Louis-VL/PCB-ADVANCED/Presentatie/Fotos Presentatie/Assemblage/IMG20240105115307.jpg

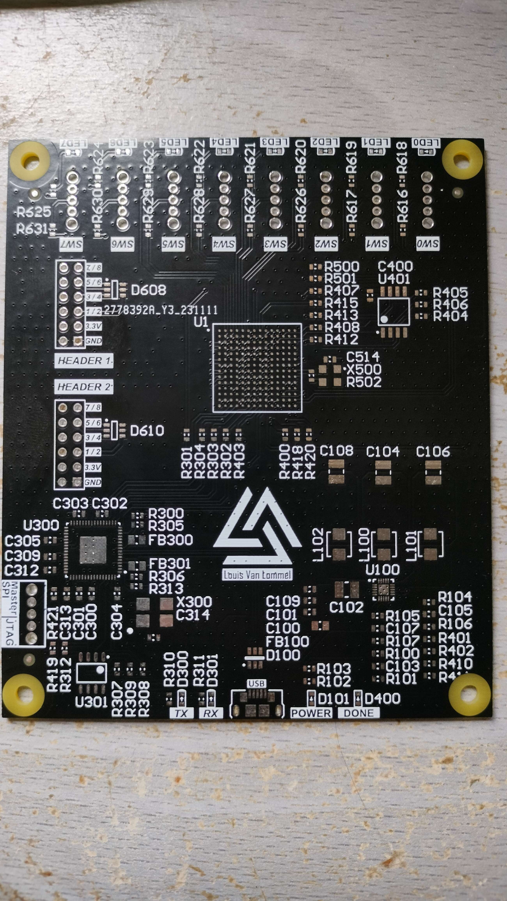
Presentatie/Fotos Presentatie/Assemblage/IMG20240105115307.jpg
