Louis-VL/PCB-ADVANCED/Presentatie/Fotos Presentatie/Assemblage/IMG20231213092017.jpg

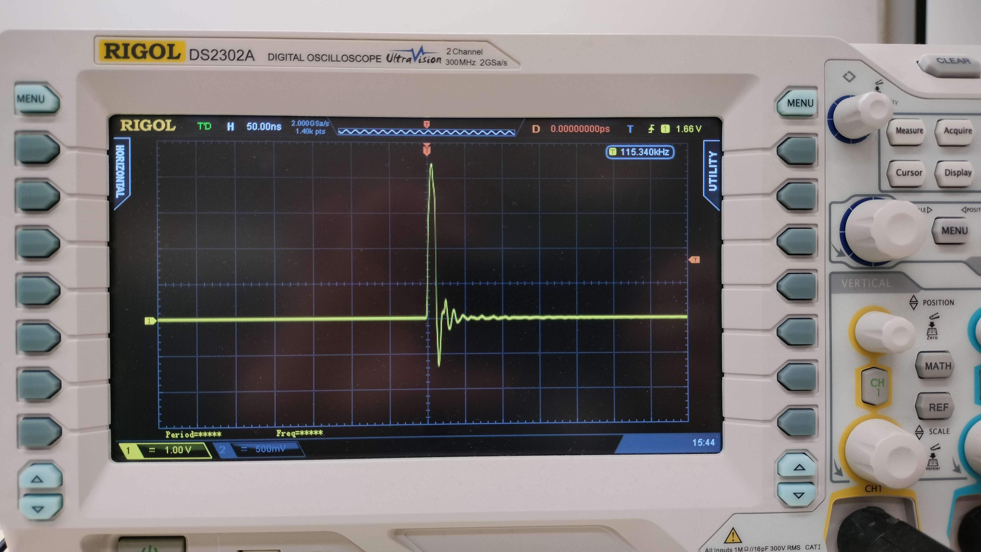
Presentatie/Fotos Presentatie/Assemblage/IMG20231213092017.jpg
