Louis-VL/PCB-ADVANCED/VIVADO/SpartanMicroBlaze/SpartanMicroBlaze.ip_user_files/README.txt

The files in this directory structure are automatically generated and managed by Vivado. Editing these files is not recommended.
