Louis-VL/PCB-ADVANCED/VIVADO/SpartanMicroBlaze/SpartanMicroBlaze.runs/impl_1/.init_design.begin.rst

<?xml version="1.0"?>
<ProcessHandle Version="1" Minor="0">
    <Process Command=".planAhead." Owner="louis" Host="LAPTOP-K67JHBA7" Pid="12540">
    </Process>
</ProcessHandle>
