Louis-VL/PCB-ADVANCED/VIVADO/SpartanTest/SpartanTest.runs/impl_1/.init_design.begin.rst

<?xml version="1.0"?>
<ProcessHandle Version="1" Minor="0">
    <Process Command=".planAhead." Owner="louis" Host="DESKTOP" Pid="4484">
    </Process>
</ProcessHandle>
