Louis-VL/PCB-ADVANCED/VIVADO/SpartanMicroBlaze/SpartanMicroBlaze.runs/MicroBlazeV2_axi_gpio_0_1_synth_1/.vivado.begin.rst

<?xml version="1.0"?>
<ProcessHandle Version="1" Minor="0">
    <Process Command="vivado.bat" Owner="louis" Host="LAPTOP-K67JHBA7" Pid="3984" HostCore="16" HostMemory="016556687360">
    </Process>
</ProcessHandle>
