Louis-VL/PCB-ADVANCED/VIVADO/SpartanMicroBlaze/SpartanMicroBlaze.runs/MicroBlazeV2_axi_gpio_1_0_synth_1/.vivado.begin.rst

<?xml version="1.0"?>
<ProcessHandle Version="1" Minor="0">
    <Process Command="vivado.bat" Owner="louis" Host="LAPTOP-K67JHBA7" Pid="7600" HostCore="16" HostMemory="016556687360">
    </Process>
</ProcessHandle>
