Louis-VL/PCB-ADVANCED/Presentatie/Presentatie1.pptx

## FPGA-development board

- Louis Van Lommel

PCB-Advanced 2023

## Slide 2

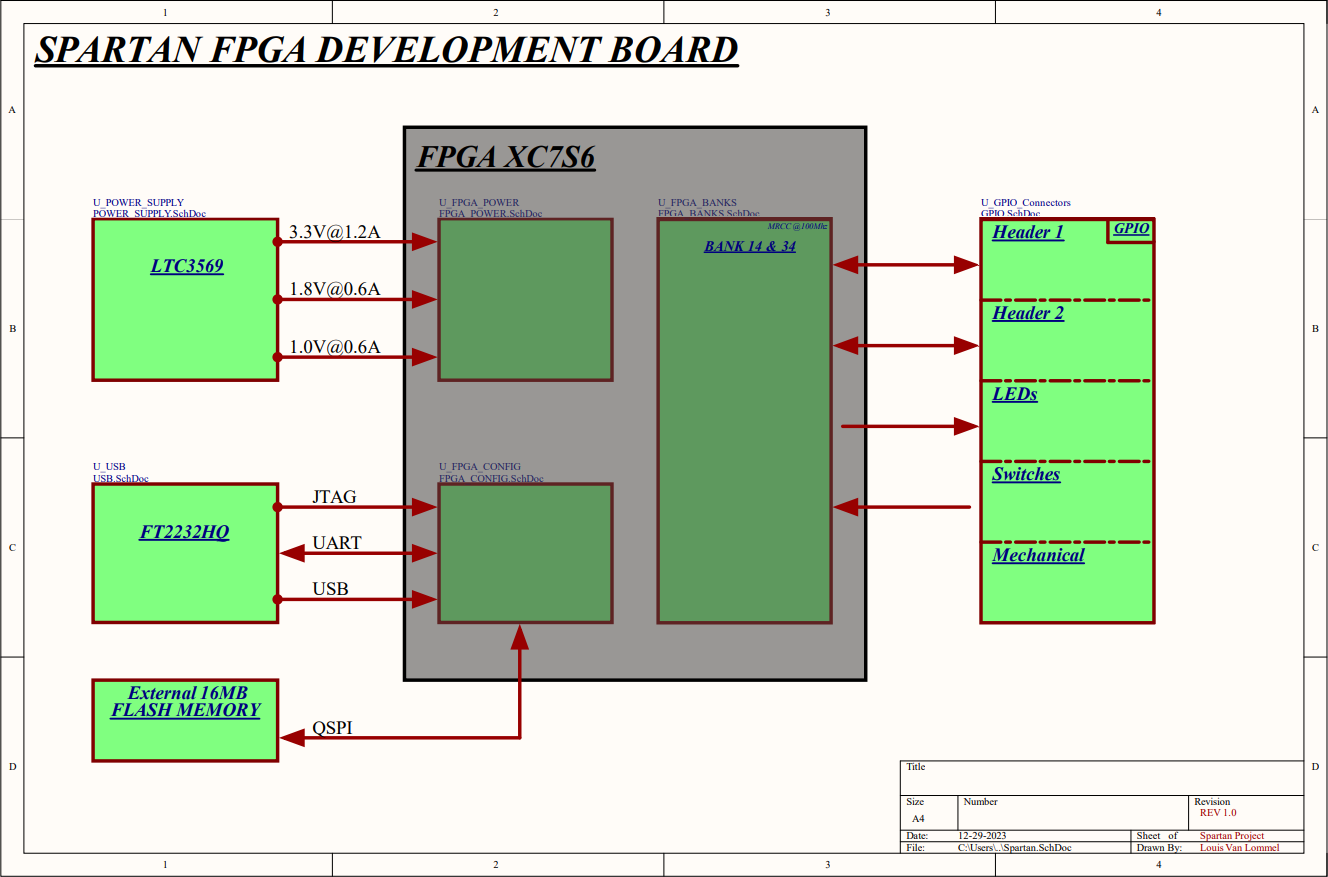
[picture p3: figure]

## Slide 3

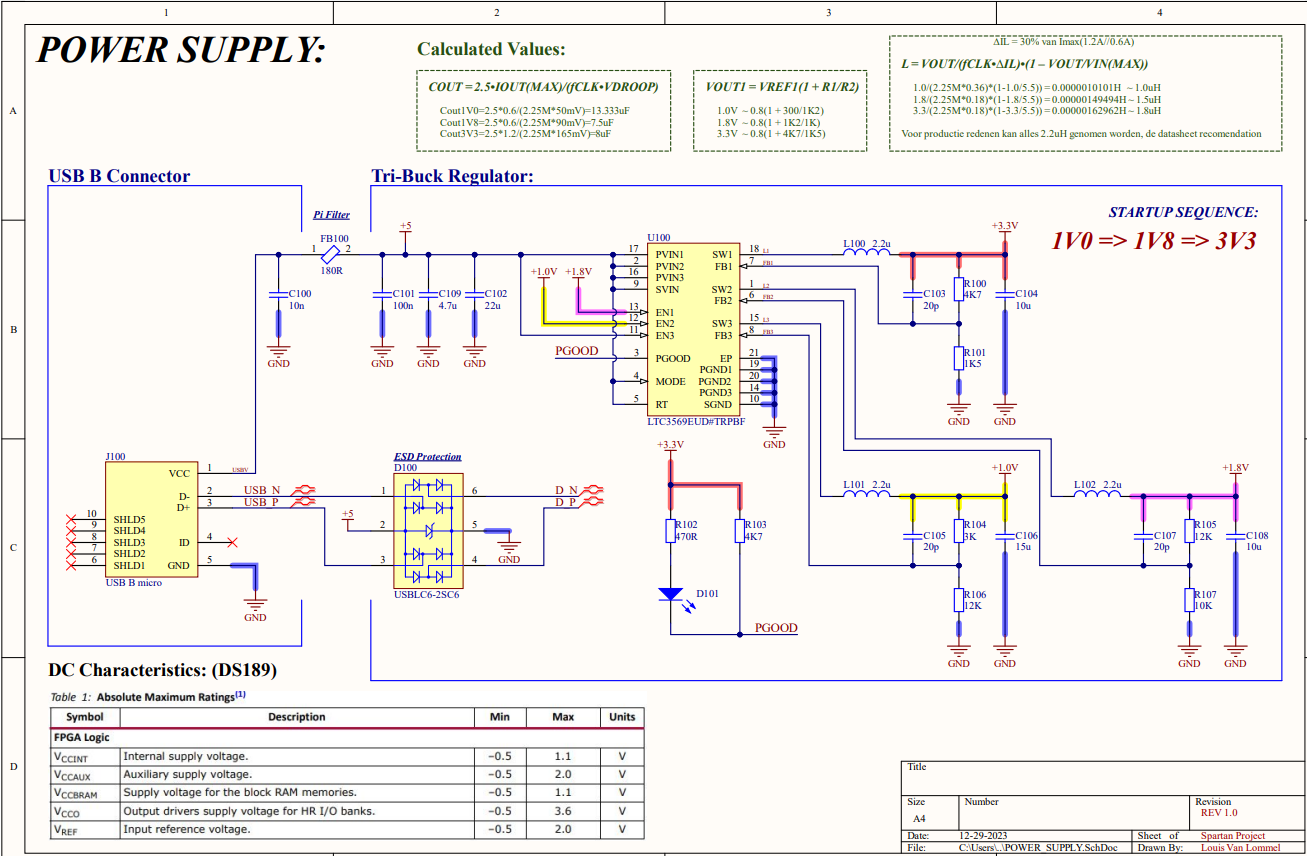
[picture p4: figure]

## Slide 4

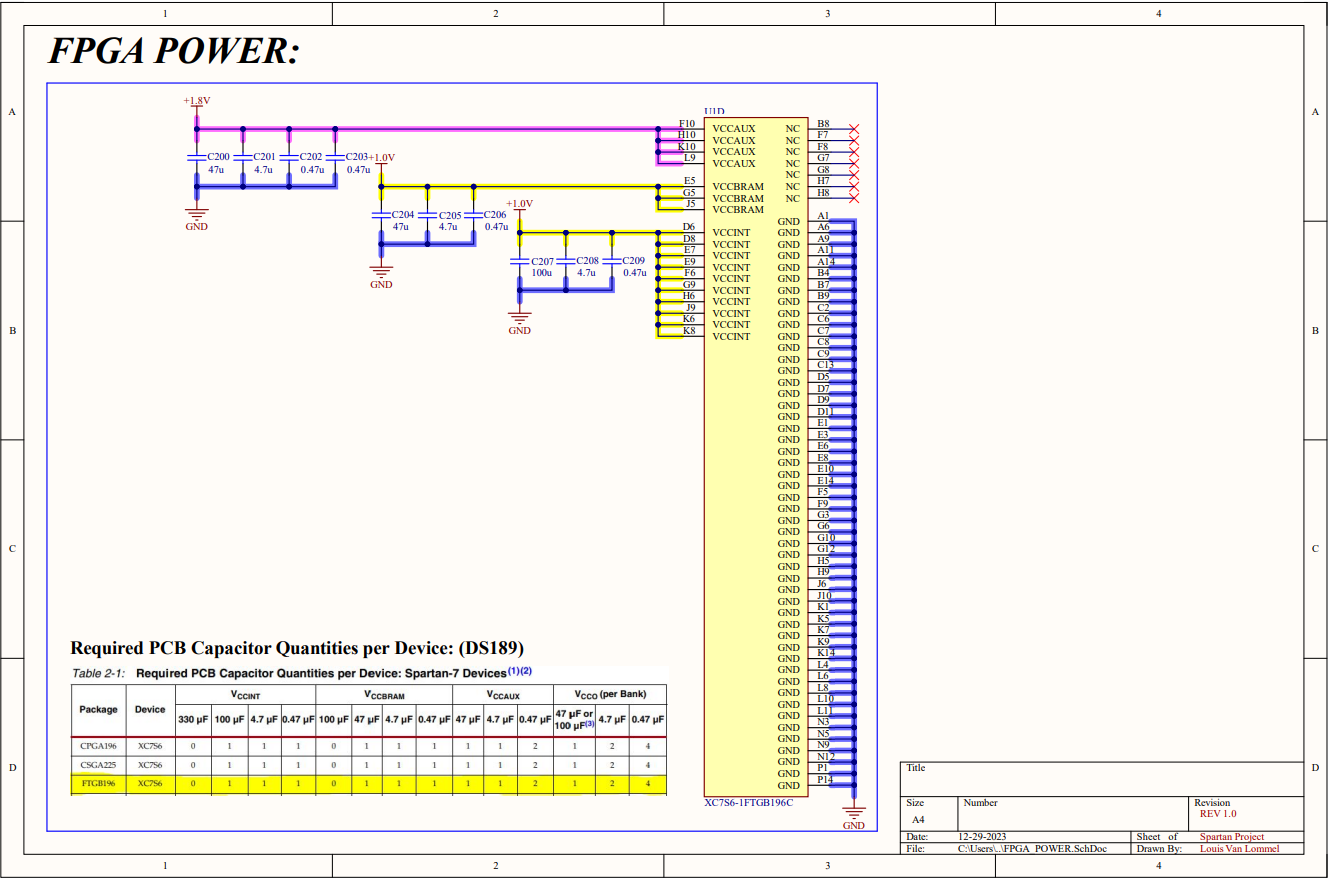
[picture p5: figure]

## Slide 5

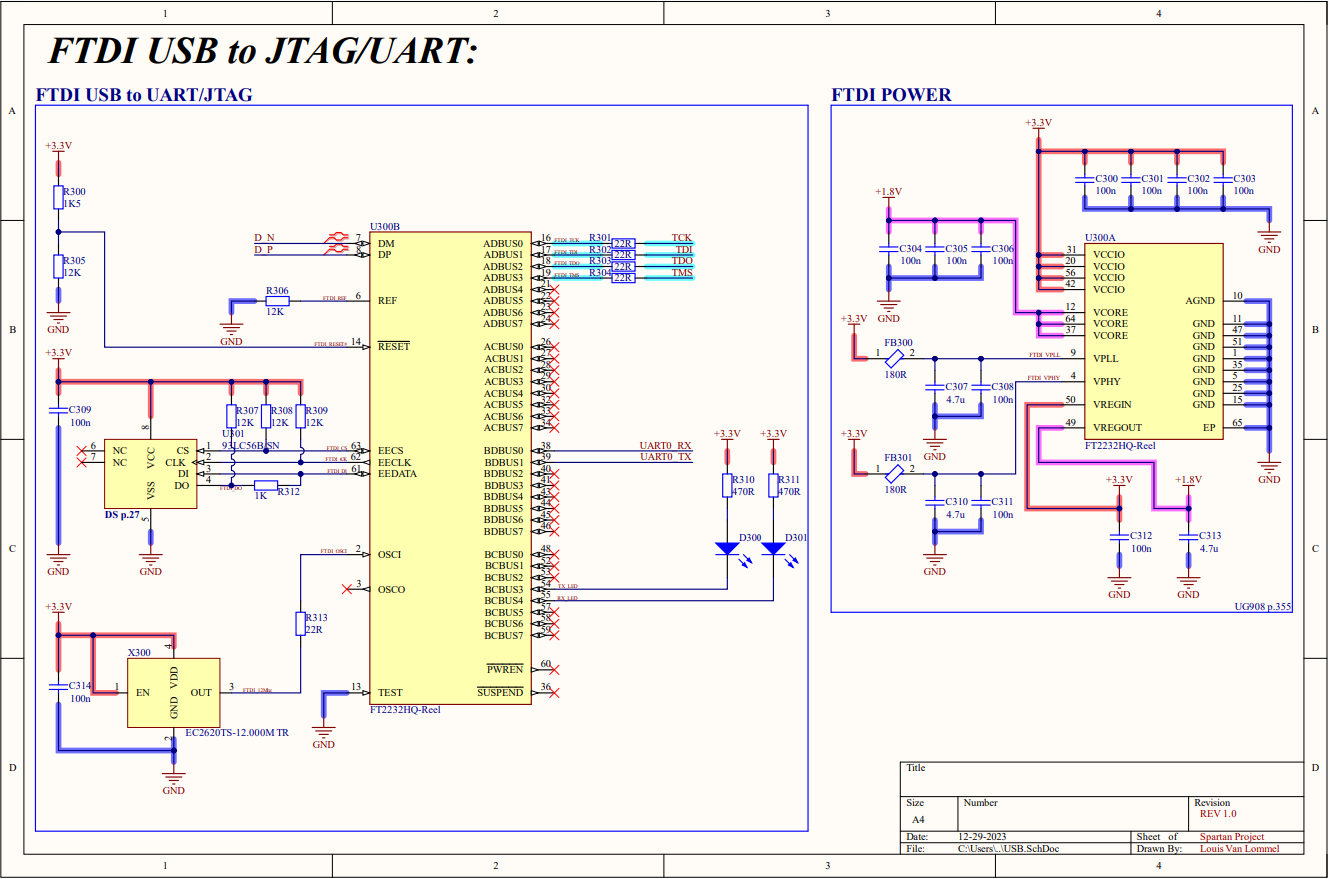
[picture p6: figure]

## Slide 6

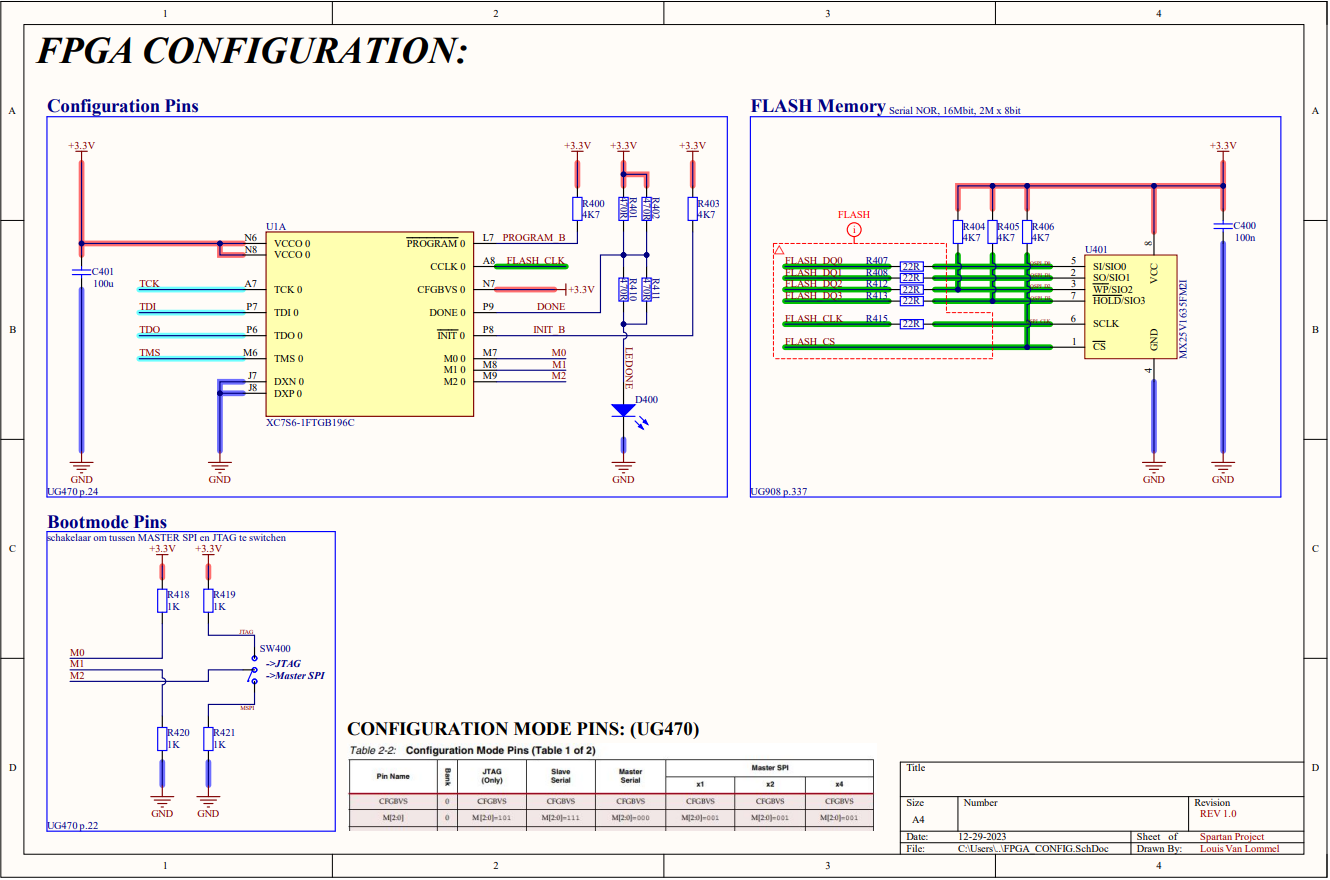
[picture p7: figure]

## Slide 7

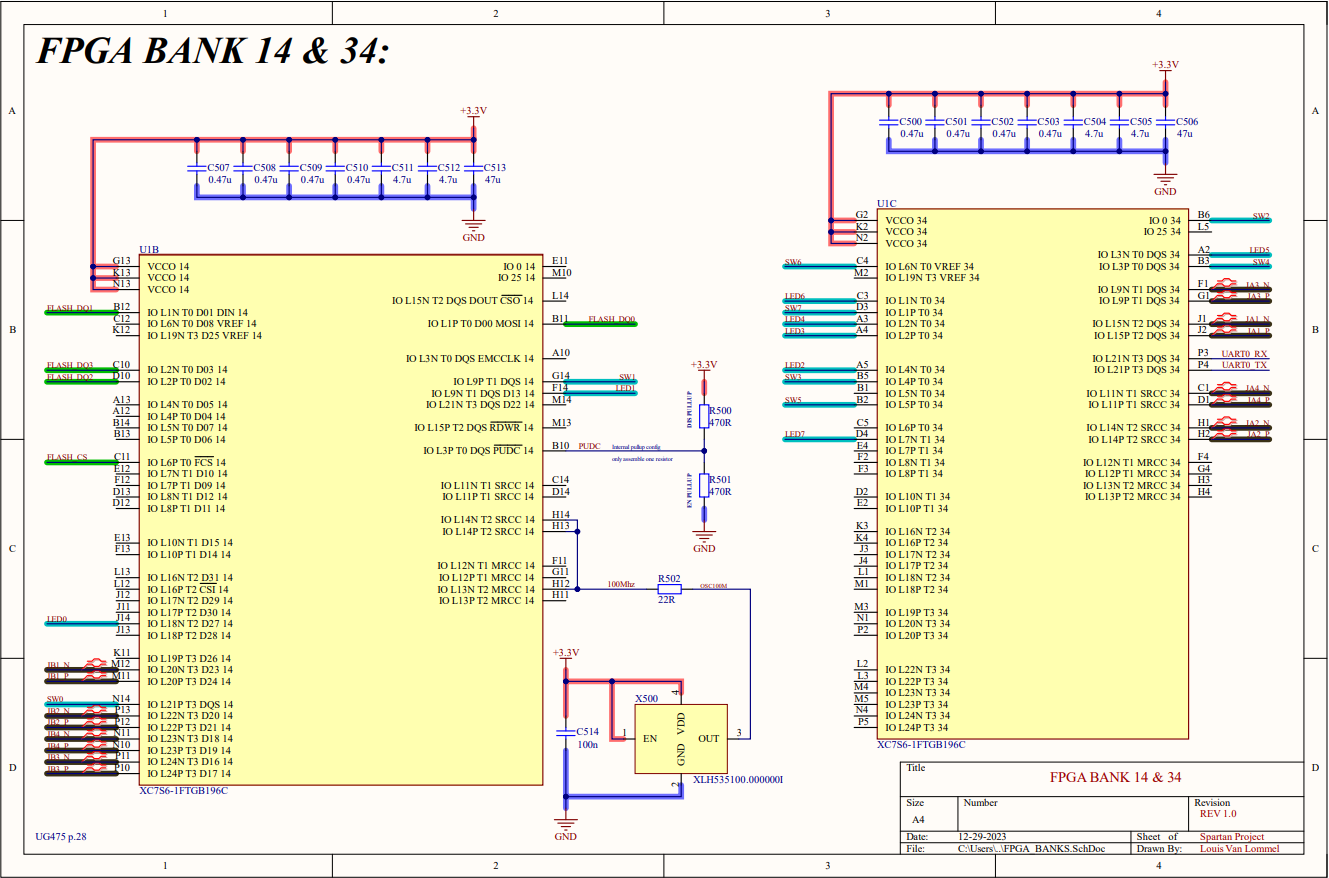
[picture p8: figure]

## Slide 8

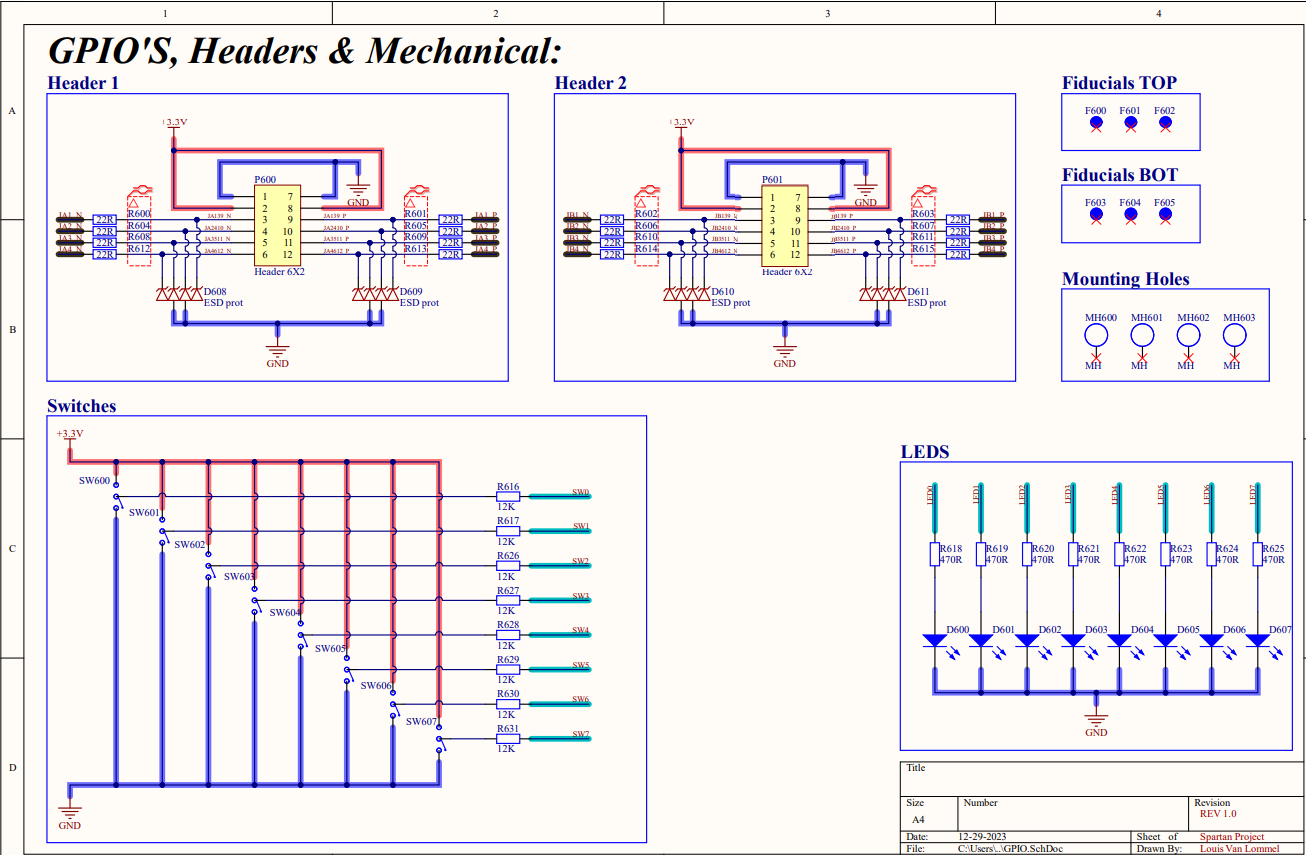
[picture p9: figure]

## PCB in Altium Designer

- 4 Layer PCB
  - L1 Signal + GND
  - L2 GND
  - L3 PWR
  - L4 Signal + GND
- BGA (1mm-pitch)
- Differential pairs
- Impedance routing
- Via Stitching

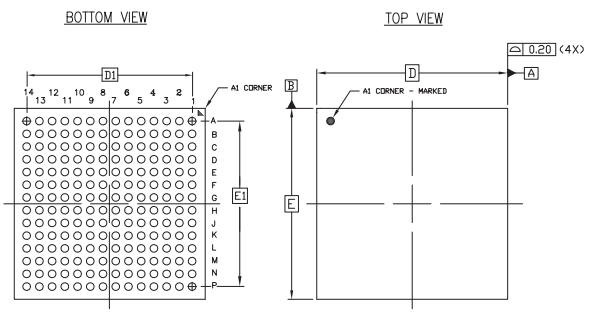
[picture p10: figure]

## Slide 10

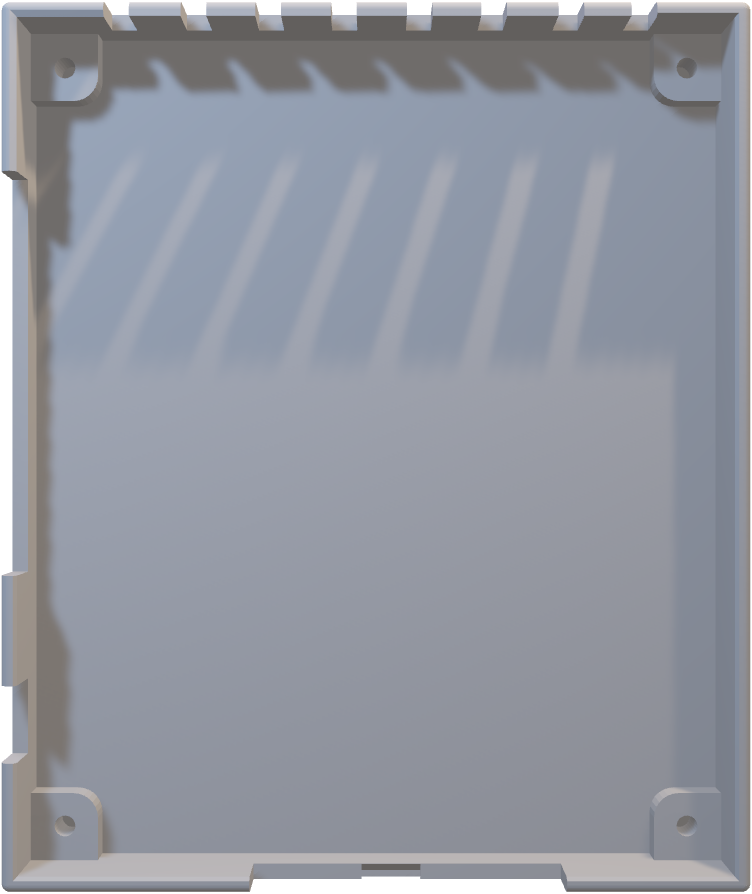
[picture p11: figure]
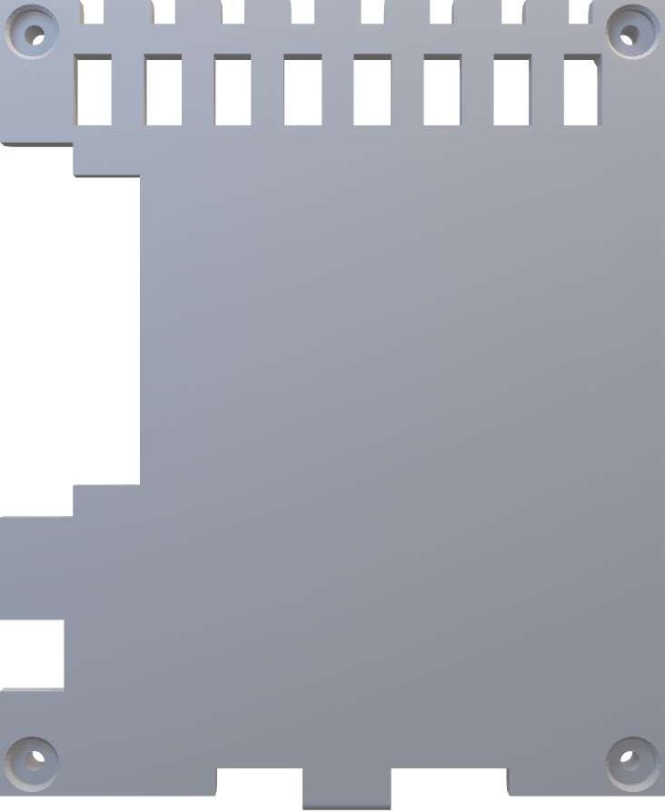
[picture p12: figure]

## Hardware fouten en oplossingen

- USB ESD-Protection:
- Probleem:
    - +5V en GND omgedraait.
- Huidige oplossing:
    - Component ondersteboven geplaatst.
- Permanente oplossing:
    - Schema en PCB verbeteren (V2.0).

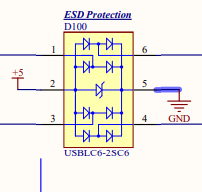
[picture p13: figure]

## Hardware fouten en oplossingen

- ESD-Protection:
- Probleem:
    - Pin 2 en 6 omgedraait
- Huidige oplossing:
    - Niet geplaatst
- Permanente oplossing:
    - Schema en PCB verbeteren (V2.0).

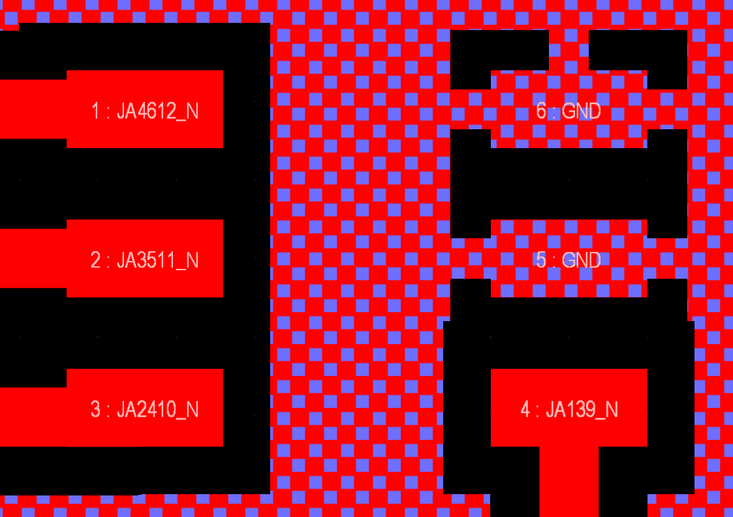
[picture p14: figure]

## Hardware fouten en oplossingen

- Enable 2 Tri-Buck:
- Probleem:
    - +1V te laag, minimaal +1,2V.
- Huidige oplossing:
    - EN2 aan +5V verbonden.
- Permanente oplossing:
    - Schema en PCB verbeteren (V2.0).

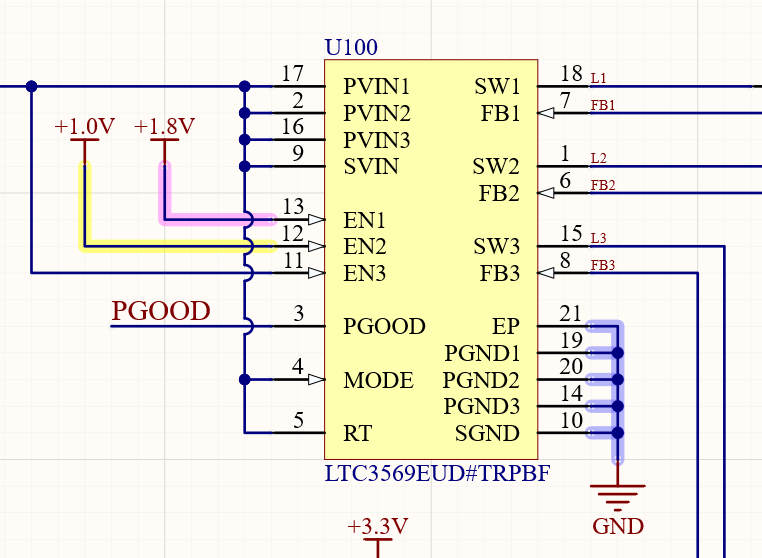
[picture p15: figure]
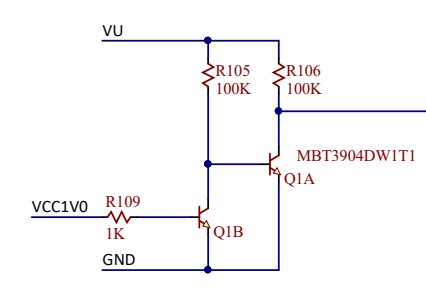
[picture p16: figure]

## Hardware fouten en oplossingen

- PGOOD Tri-Buck:
- Probleem:
    - Gaat enkel branden bij een fout.
- Huidige oplossing:
    - Niets, bij een fout gaat de led branden (nuttig).
- Permanente oplossing:
    - Schema en PCB verbeteren (V2.0).

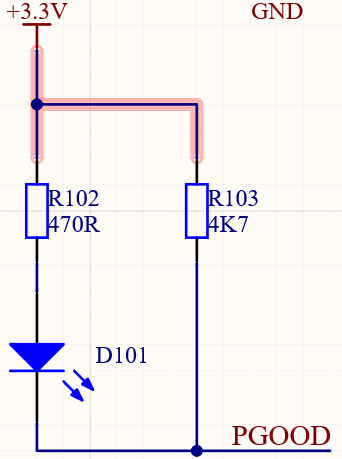
[picture p17: figure]
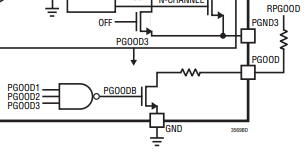
[picture p18: figure]
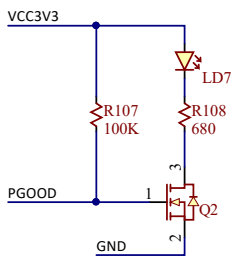
[picture p19: figure]

## Hardware fouten en oplossingen

- MRCC-Pin:
- Probleem:
    - L13_P niet verbonden.
- Huidige oplossing:
    - L14_P gebruikt (SRCC).
- Permanente oplossing:
    - Schema en PCB verbeteren (V2.0).

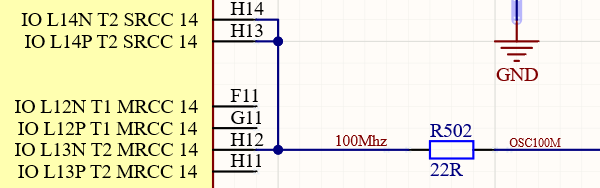
[picture p20: figure]
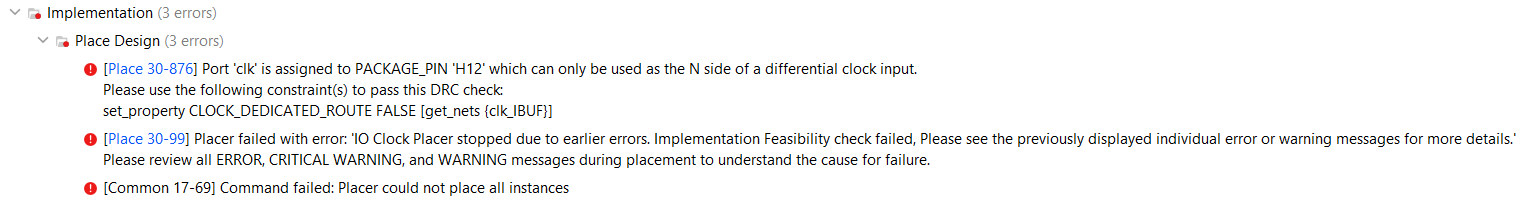
[picture p21: figure]

## Hardware fouten en oplossingen

- Switches:
- Probleem:
    - Switches sluiten kort tijdens het schakelen.
- Huidige oplossing:
    - Interne Pull-up, 3V3 aan de switches verwijdert.
- Permanente oplossing:
    - Betere switches.
    - Schema en PCB verbeteren (V2.0).

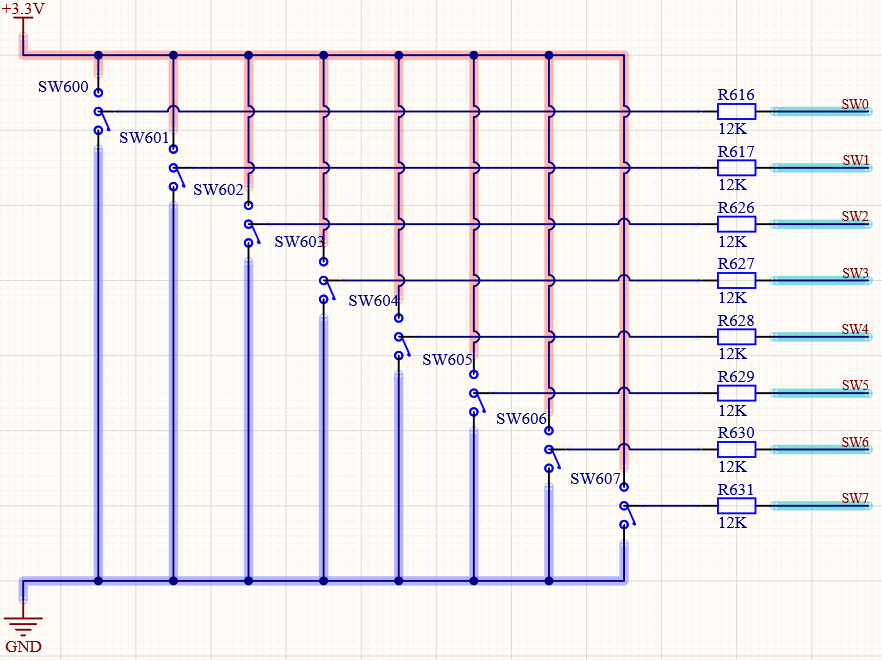
[picture p22: figure]
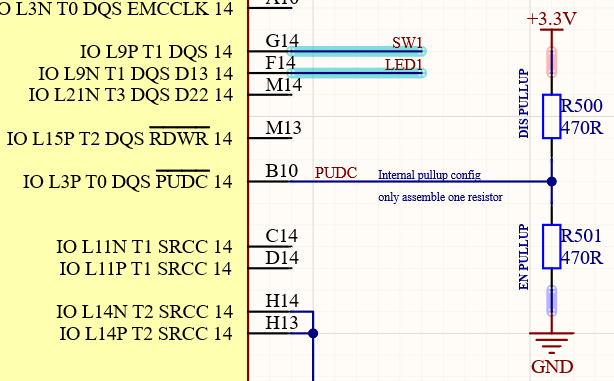
[picture p23: figure]

## Slide 17

## Slide 18

## Bedankt!

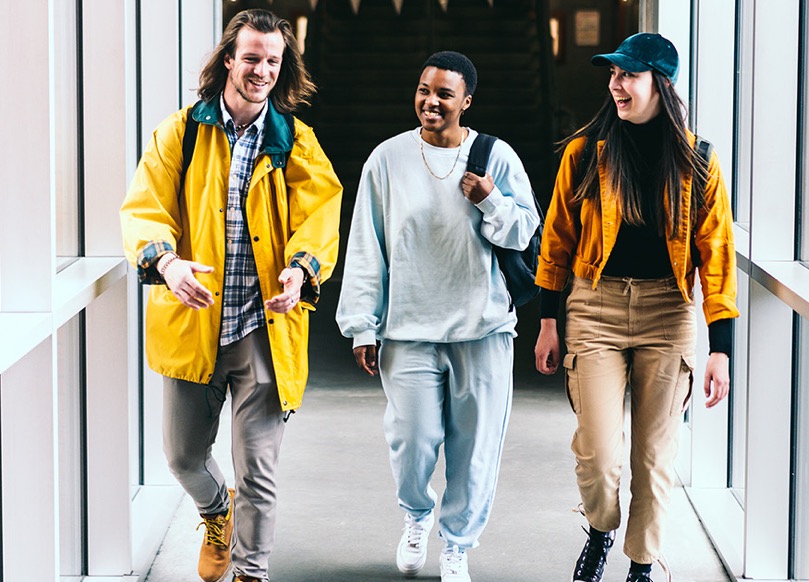
[picture p24: figure]

- Louis Van Lommel R0844517@student.thomasmore.be

Notes: Icoon wereldbol toevoegen
