Louis-VL/PCB-ADVANCED/KNIPS/BANK34_14.PNG

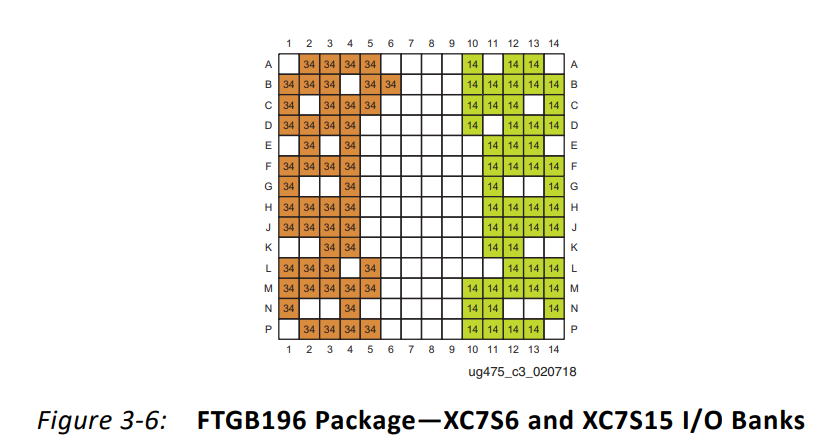
KNIPS/BANK34_14.PNG
