Louis-VL/PCB-ADVANCED/KNIPS/BOMcomponents.PNG

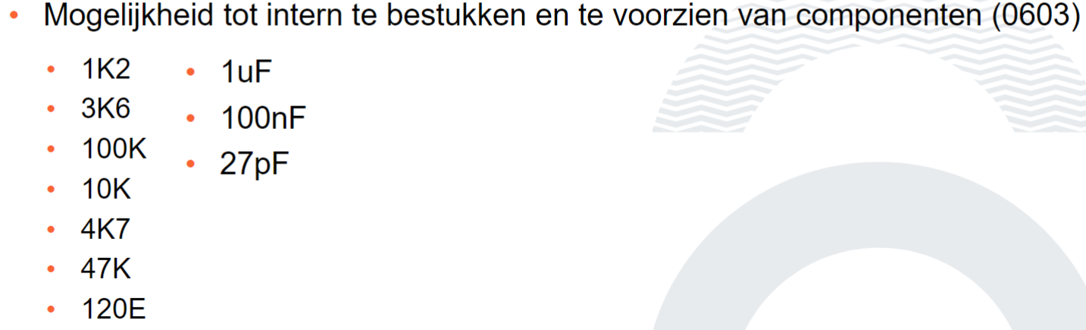
KNIPS/BOMcomponents.PNG
