Louis-VL/PCB-ADVANCED/KNIPS/Capture2.PNG

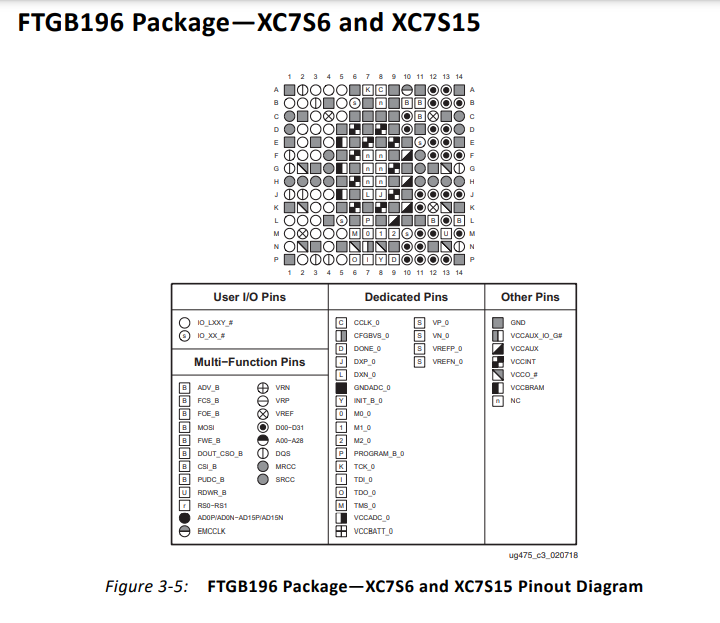
KNIPS/Capture2.PNG
