Louis-VL/PCB-ADVANCED/KNIPS/DC CHARS.PNG

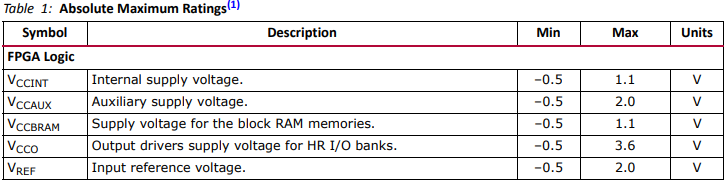
KNIPS/DC CHARS.PNG
