Louis-VL/PCB-ADVANCED/KNIPS/FLASH.PNG

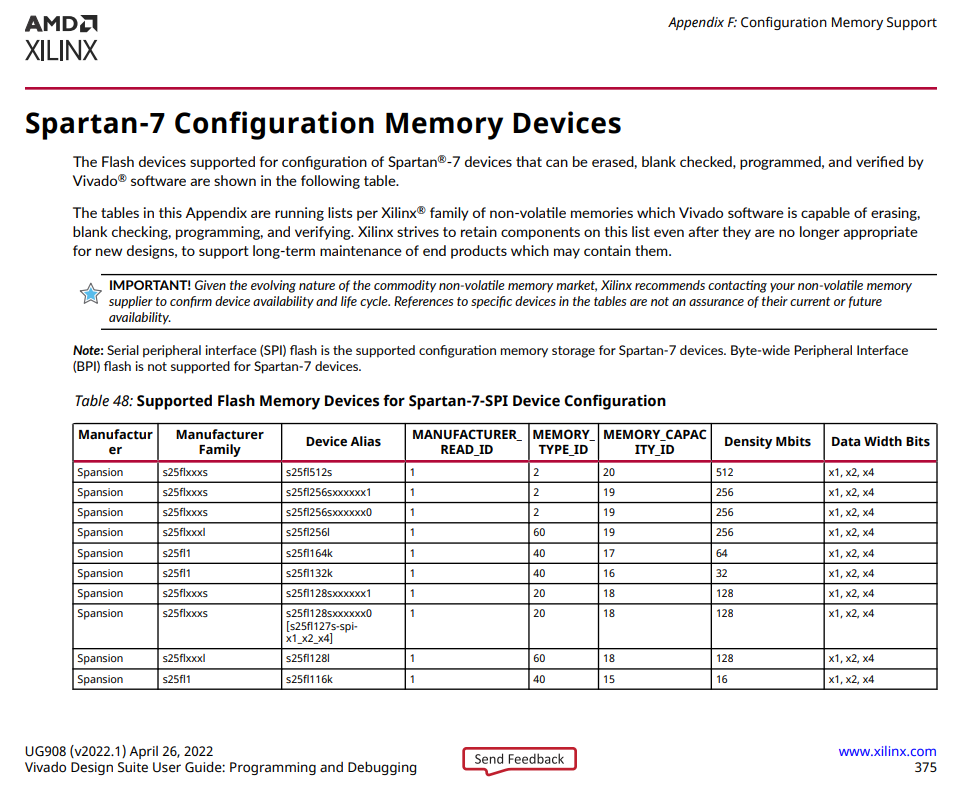
KNIPS/FLASH.PNG
