Louis-VL/PCB-ADVANCED/KNIPS/FOOTPRINT2.PNG

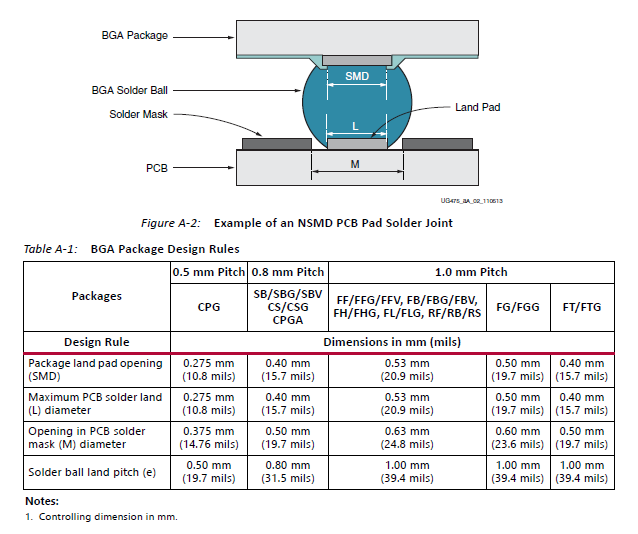
KNIPS/FOOTPRINT2.PNG
