Louis-VL/PCB-ADVANCED/KNIPS/Footprint.PNG

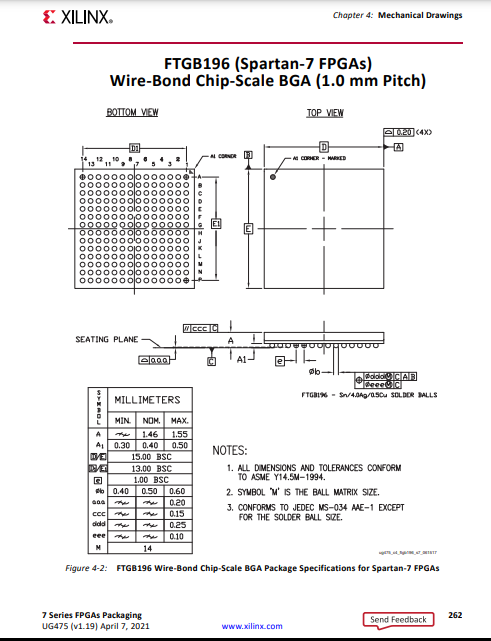
KNIPS/Footprint.PNG
