Louis-VL/PCB-ADVANCED/KNIPS/FT2232.PNG

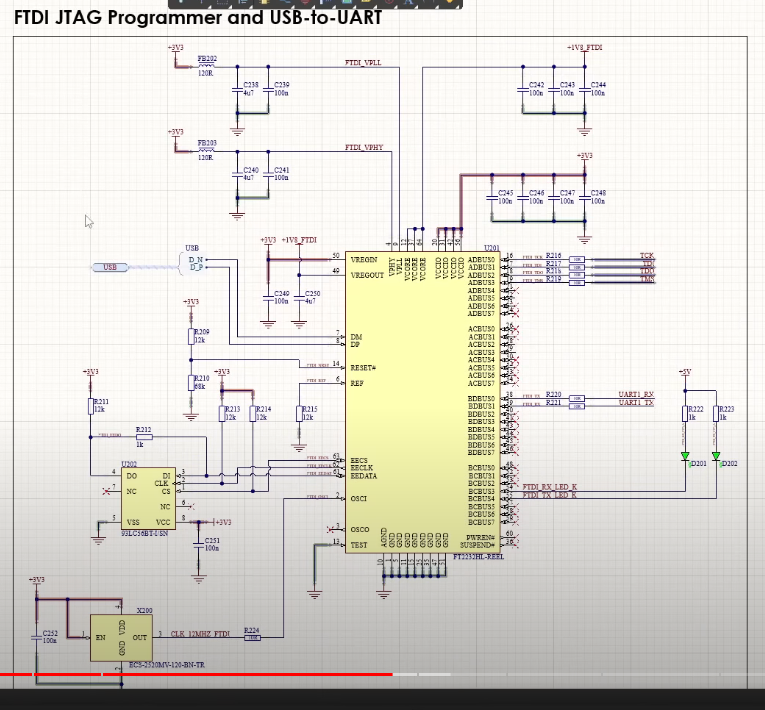
KNIPS/FT2232.PNG
