Louis-VL/PCB-ADVANCED/KNIPS/FTDIPROGRAMTERMINAL.png

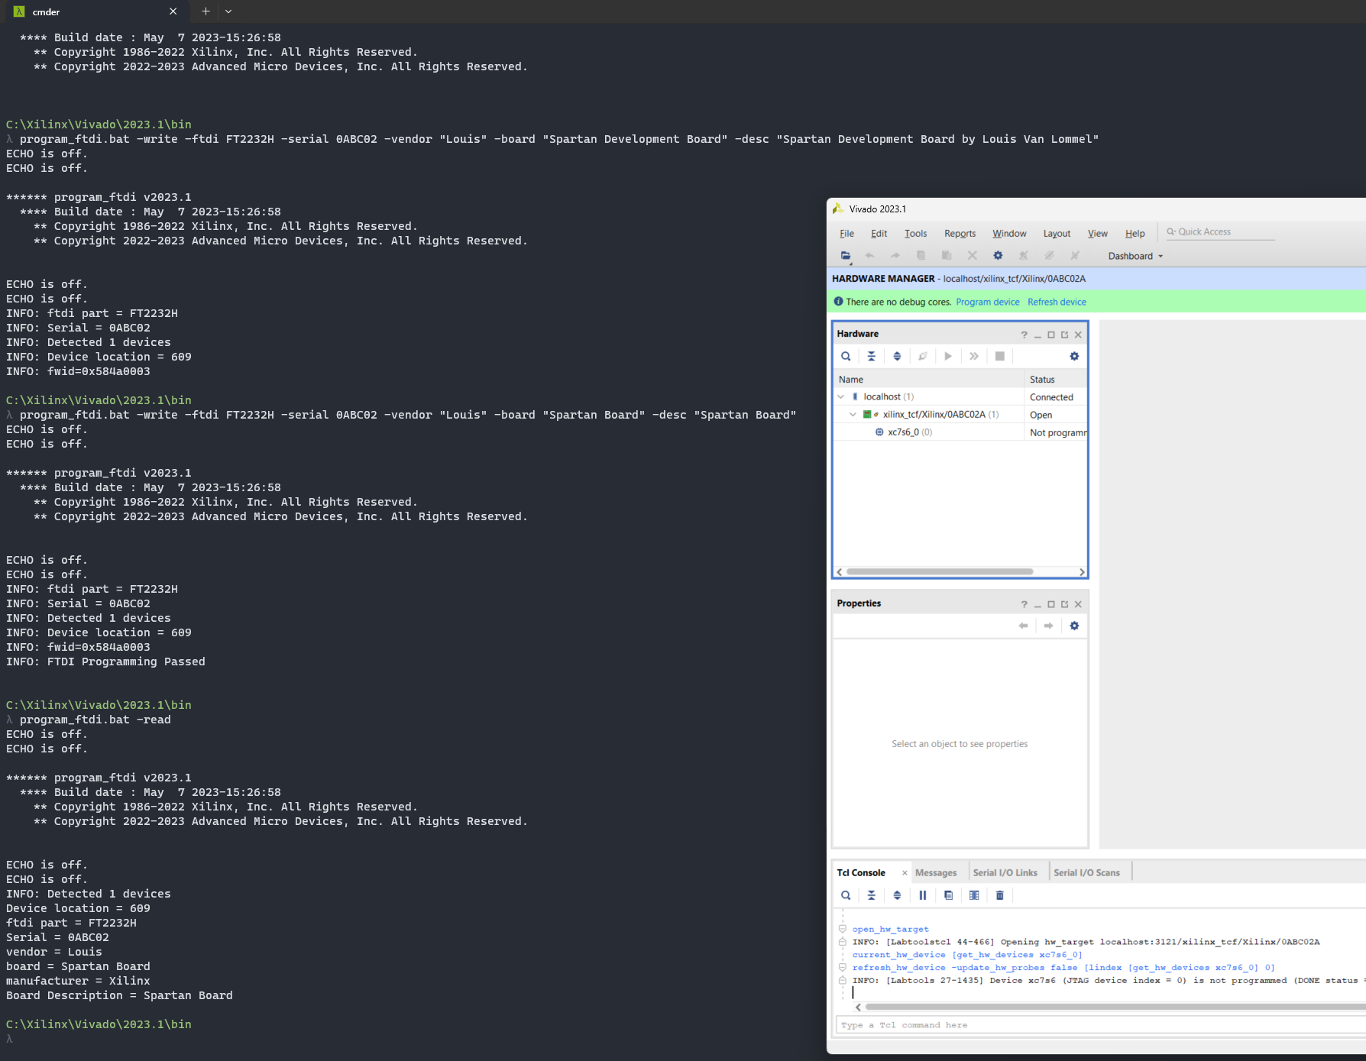
KNIPS/FTDIPROGRAMTERMINAL.png
