Louis-VL/PCB-ADVANCED/KNIPS/PINDESCR2.PNG

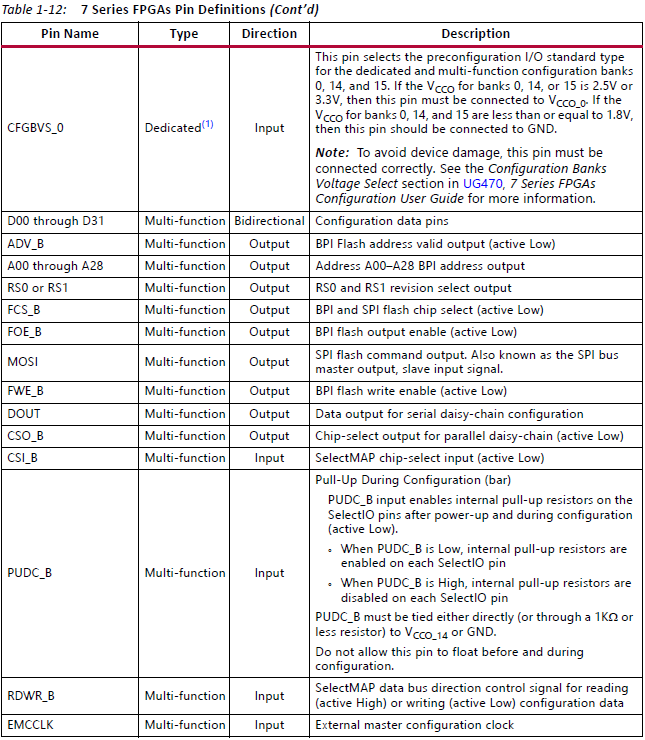
KNIPS/PINDESCR2.PNG
