Louis-VL/PCB-ADVANCED/KNIPS/PINDESCR3.PNG

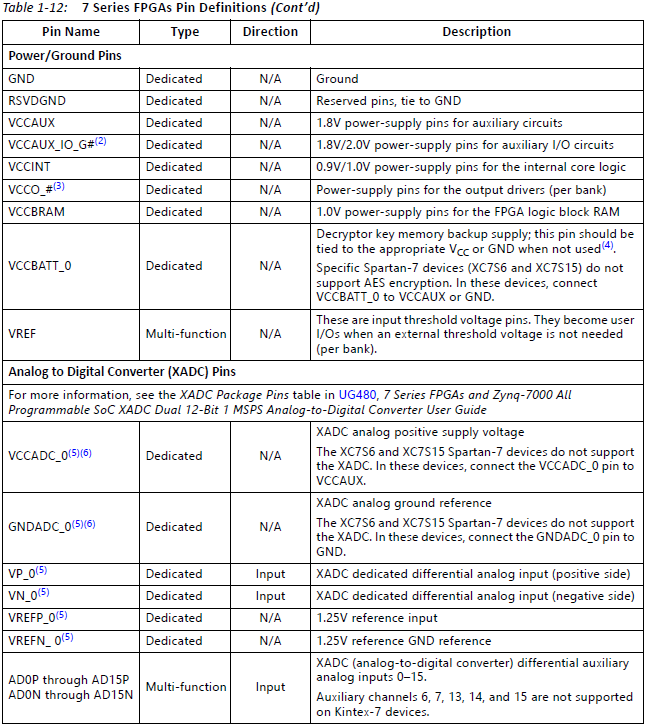
KNIPS/PINDESCR3.PNG
