Louis-VL/PCB-ADVANCED/KNIPS/PINDESCR.PNG

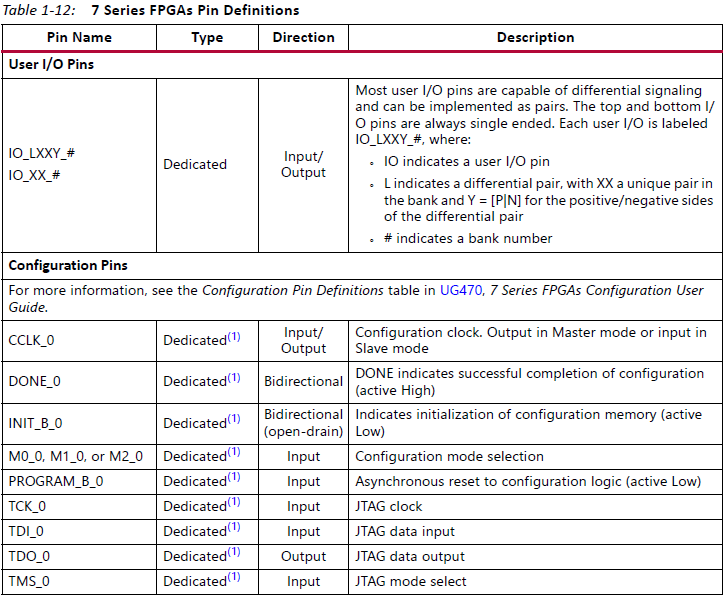
KNIPS/PINDESCR.PNG
