Louis-VL/PCB-ADVANCED/KNIPS/QSPIVIVADO.jpg

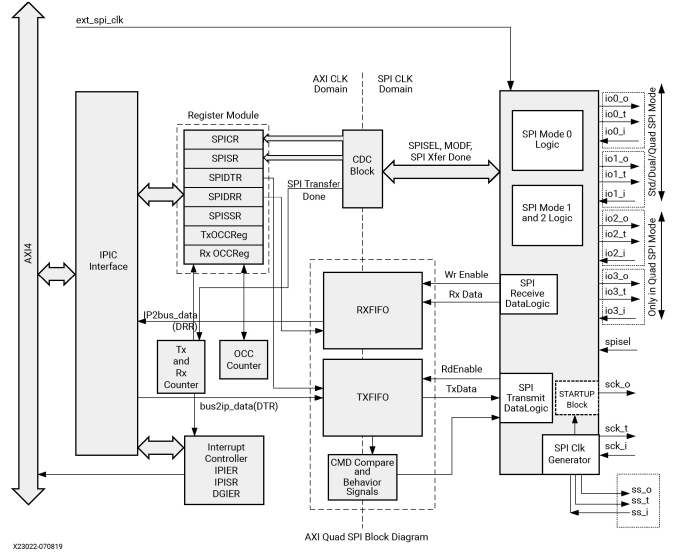
KNIPS/QSPIVIVADO.jpg
