Louis-VL/PCB-ADVANCED/KNIPS/VIVADO.png

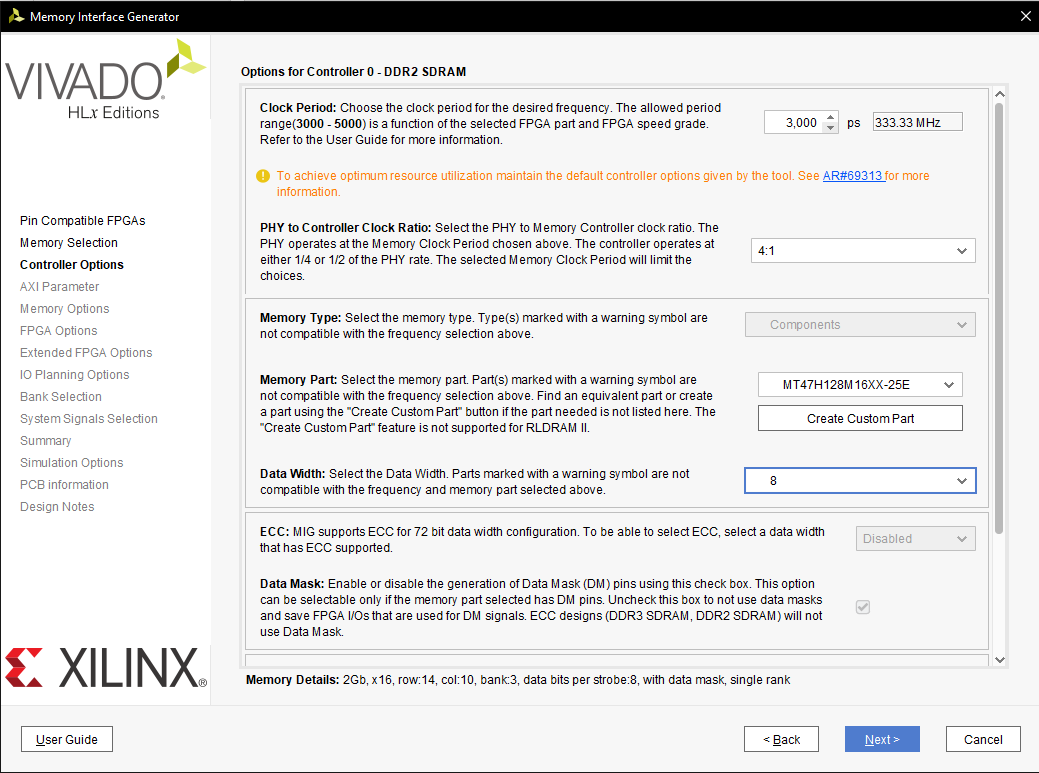
KNIPS/VIVADO.png
