Louis-VL/PCB-ADVANCED/Presentatie/Fotos Presentatie/Hardware fouten/IMG20231231153047.jpg

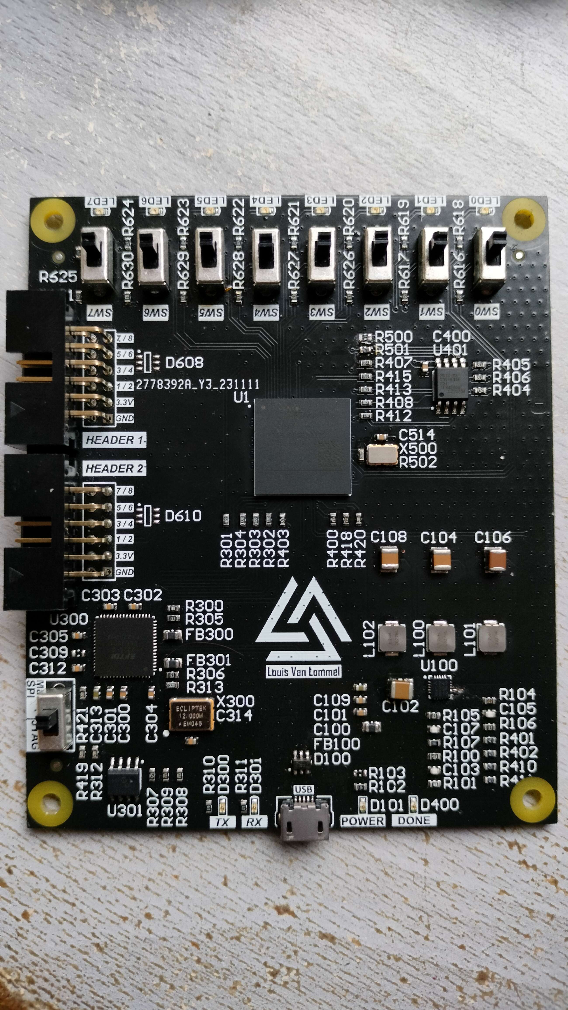
Presentatie/Fotos Presentatie/Hardware fouten/IMG20231231153047.jpg
