Louis-VL/PCB-ADVANCED/Presentatie/Fotos Presentatie/LayerStack.PNG

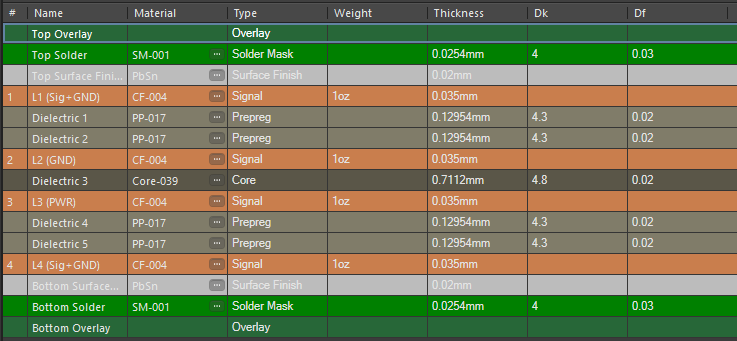
Presentatie/Fotos Presentatie/LayerStack.PNG
