Louis-VL/PCB-ADVANCED/Presentatie/Fotos Presentatie/PCB1.PNG

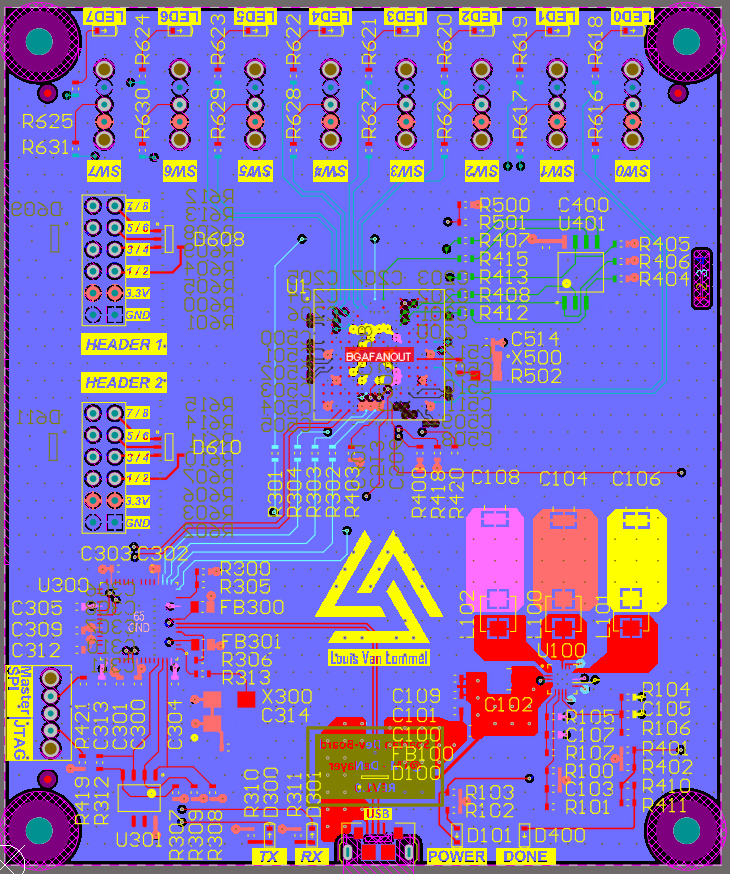
Presentatie/Fotos Presentatie/PCB1.PNG
