Louis-VL/PCB-ADVANCED/Presentatie/Fotos Presentatie/Software/FTDI.PNG

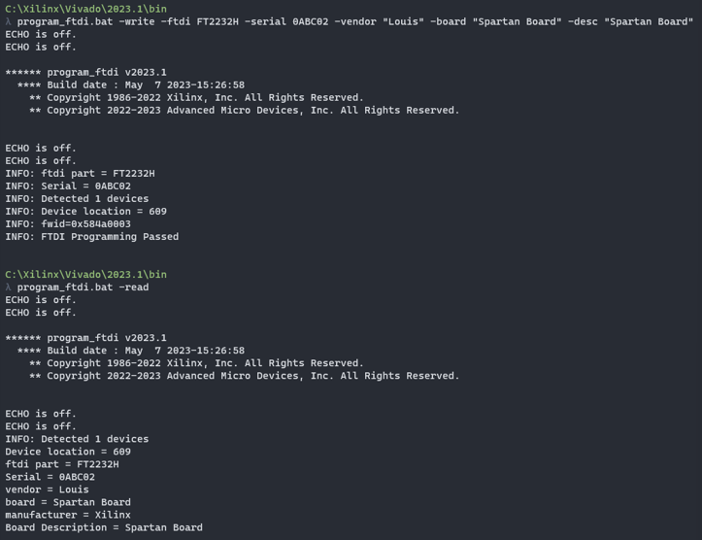
Presentatie/Fotos Presentatie/Software/FTDI.PNG
