Louis-VL/PCB-ADVANCED/Presentatie/Fotos Presentatie/Software/SOFTCORE.png

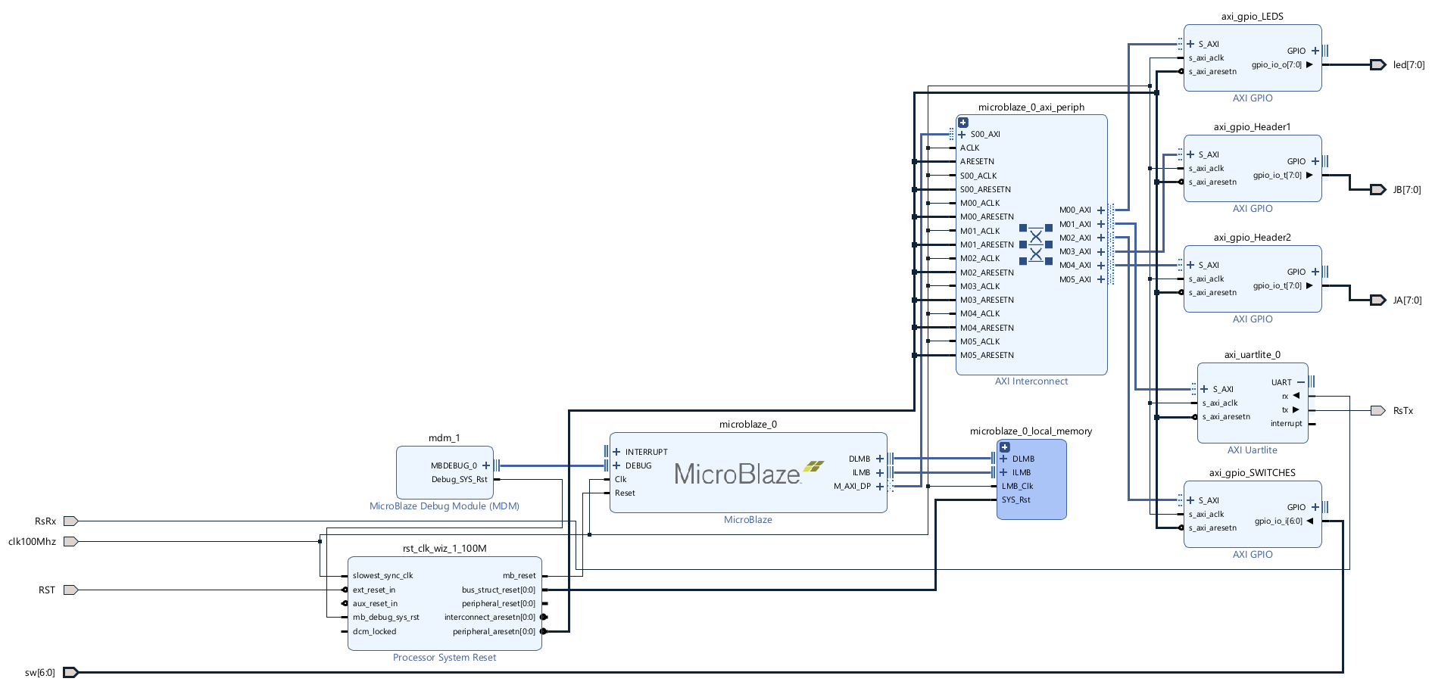
Presentatie/Fotos Presentatie/Software/SOFTCORE.png
