Louis-VL/PCB-ADVANCED/Presentatie/Fotos Presentatie/Software/Vitis.png

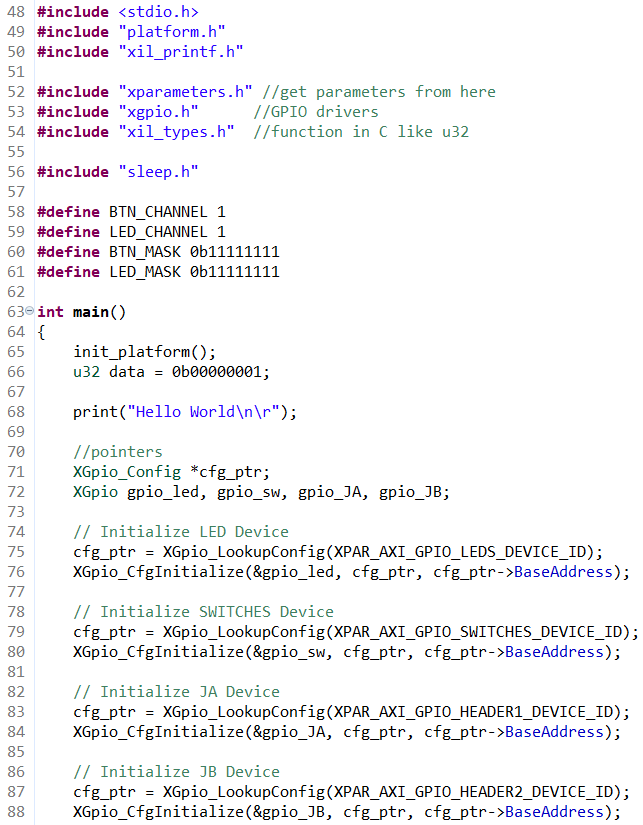
Presentatie/Fotos Presentatie/Software/Vitis.png
