Louis-VL/PCB-ADVANCED/3Dbody/TOP_CASE.stl

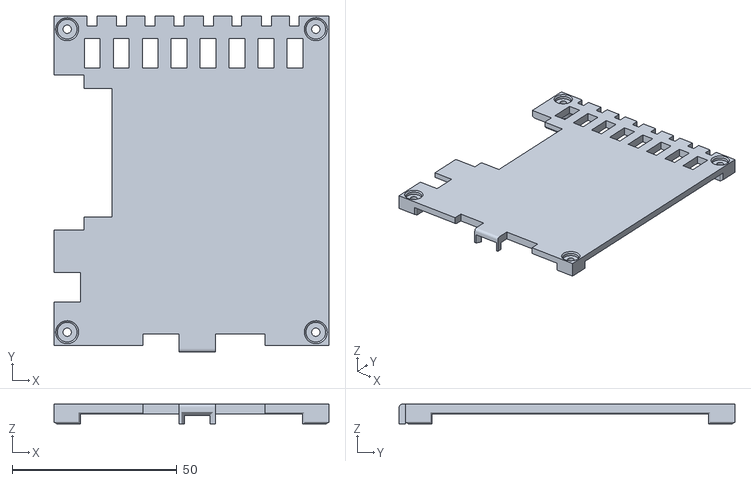
[picture p45: CAD file, 2023-12-08]
3Dbody/TOP_CASE.stl
83.5 x 102.0 x 6.00
