Louis-VL/PCB-ADVANCED/3Dbody/BOT_CASE.stl

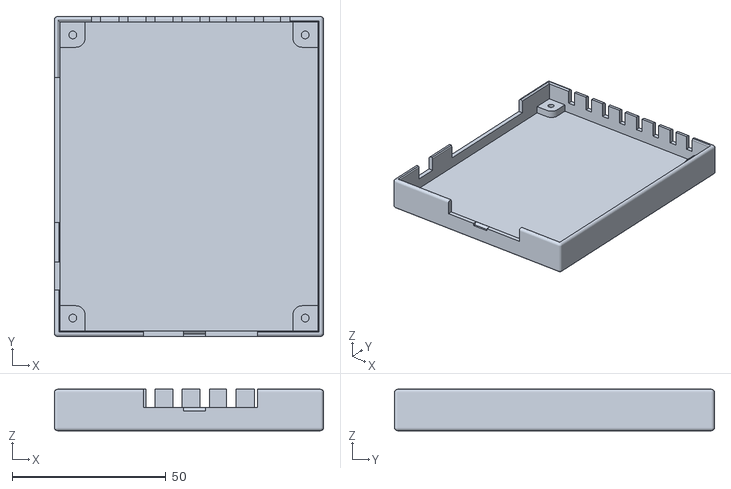
[picture p46: CAD file, 2023-12-08]
3Dbody/BOT_CASE.stl
87.5 x 104.0 x 13.5
