Louis-VL/PCB-ADVANCED/3Dbody/2x6 shrouded header v2.step

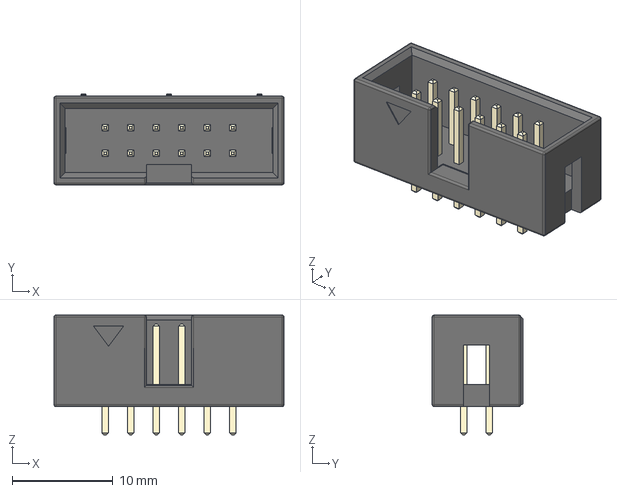
[picture p47: CAD file, 2023-10-19]
3Dbody/2x6 shrouded header v2.step
22.8 x 9.00 x 11.9 mm
Pins
