Louis-VL/PCB-ADVANCED/3Dbody/User Library-Oscillator_ECS-3225S.STEP

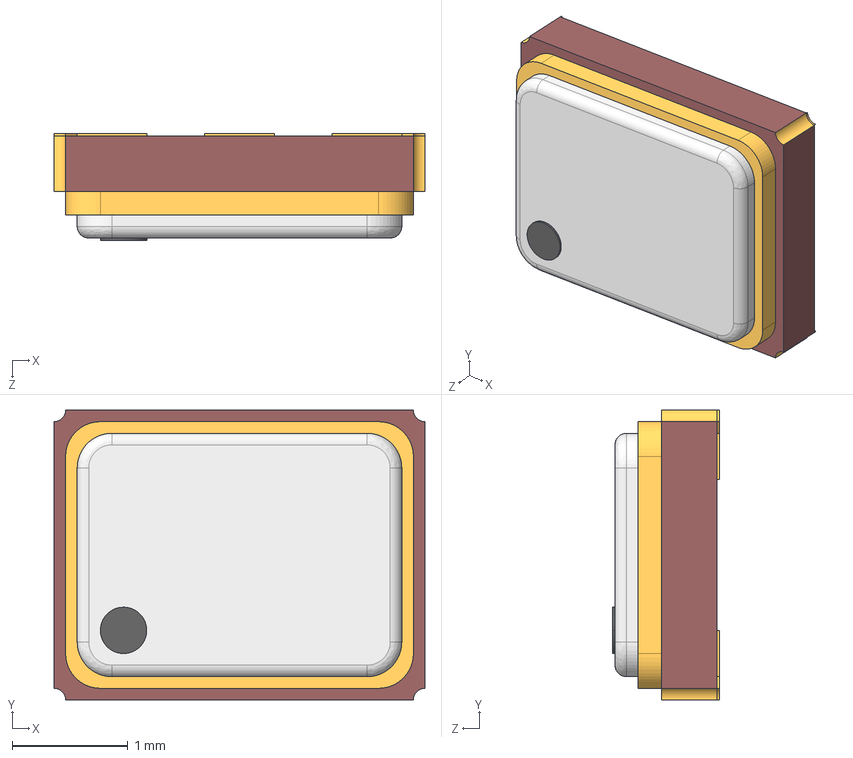
[picture p48: CAD file, 2023-10-19]
3Dbody/User Library-Oscillator_ECS-3225S.STEP
3.20 x 2.50 x 0.92 mm
MetalFrame
Pin1Marker
Pin5
Pin2
Pin1
Pin4
Lid
Pin6
Pin3
Ceramic
