Louis-VL/PCB-ADVANCED/3Dbody/User Library-ECS-3951.STEP

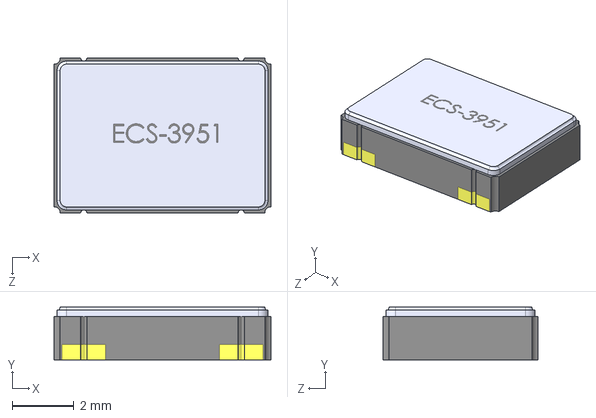
[picture p49: CAD file, 2023-10-11]
3Dbody/User Library-ECS-3951.STEP
7.00 x 1.70 x 5.00 mm
