Louis-VL/PCB-ADVANCED/3Dbody/2468746_1825159-1.stp

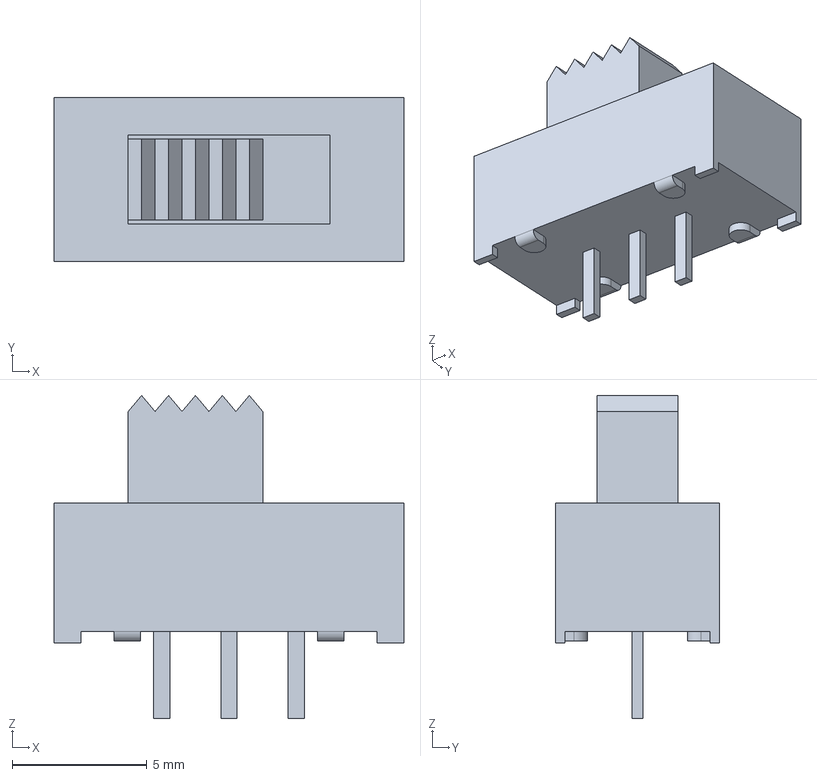
[picture p50: CAD file, 2023-10-19]
3Dbody/2468746_1825159-1.stp
13.0 x 6.10 x 12.0 mm
