Louis-VL/PCB-ADVANCED/(list of files, cad)

Other CAD files:
3Dbody/PCB1_CASE (2).f3d
3Dbody/PCB1_CASE.f3d
