Louis-VL/PCB-ADVANCED/Presentatie/Fotos Presentatie/Assemblage/IMG20231122095532.jpg

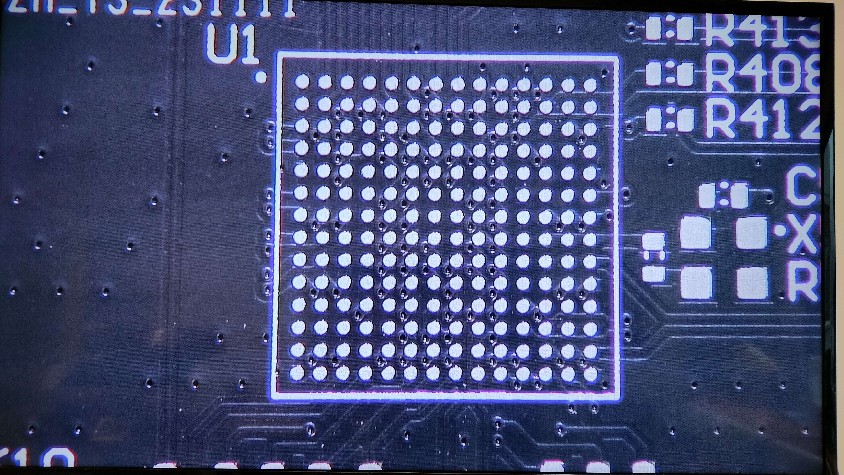
Presentatie/Fotos Presentatie/Assemblage/IMG20231122095532.jpg
