Louis-VL/PCB-ADVANCED/Presentatie/Fotos Presentatie/Assemblage/IMG20231206093928.jpg

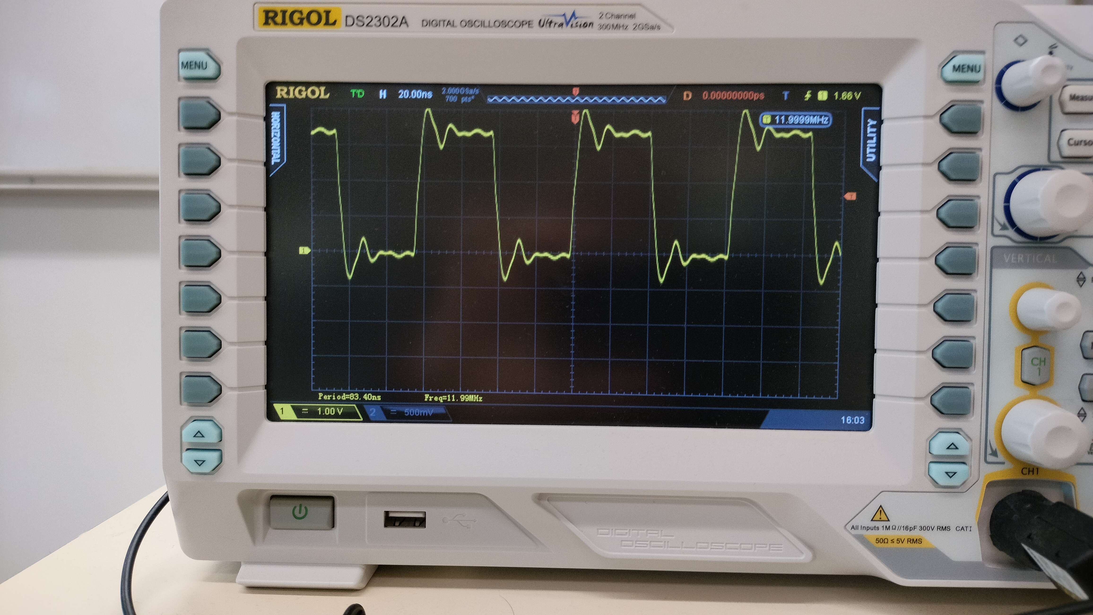
Presentatie/Fotos Presentatie/Assemblage/IMG20231206093928.jpg
