Louis-VL/PCB-ADVANCED/Presentatie/Fotos Presentatie/Assemblage/IMG20231206094057.jpg

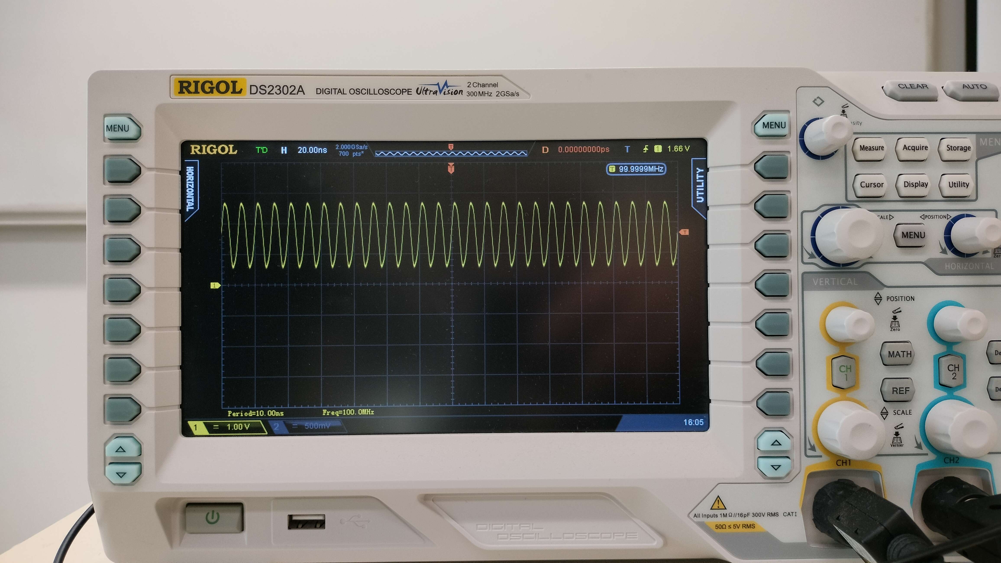
Presentatie/Fotos Presentatie/Assemblage/IMG20231206094057.jpg
