Louis-VL/PCB-ADVANCED/VIVADO/SpartanTest/SpartanTest.runs/impl_1/.vivado.begin.rst

<?xml version="1.0"?>
<ProcessHandle Version="1" Minor="0">
    <Process Command="vivado.bat" Owner="louis" Host="DESKTOP" Pid="15480" HostCore="4" HostMemory="017107566592">
    </Process>
</ProcessHandle>
