Louis-VL/PCB-ADVANCED/Presentatie/Fotos Presentatie/Software/TESTER.png

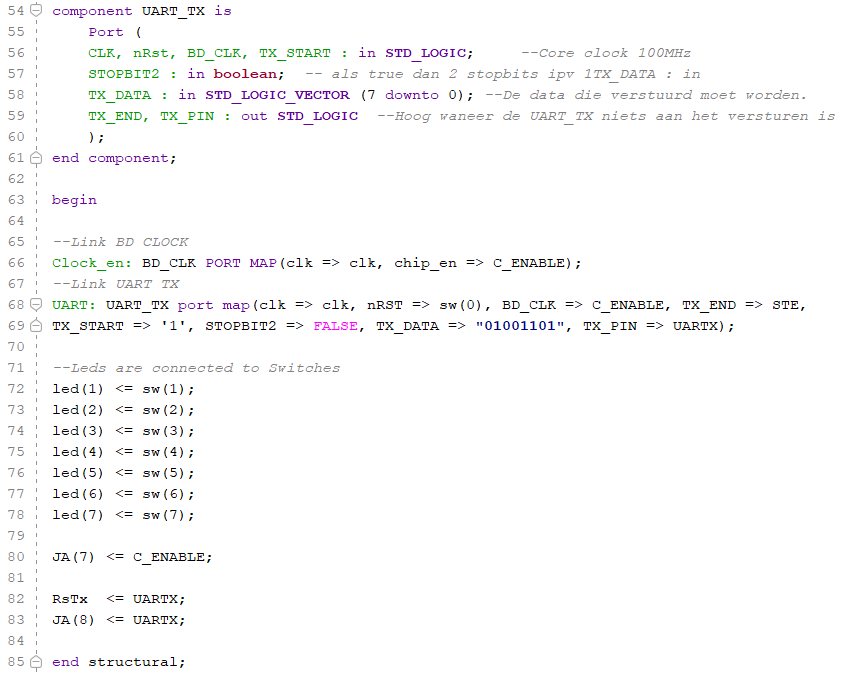
Presentatie/Fotos Presentatie/Software/TESTER.png
