Louis-VL/PCB-ADVANCED/Presentatie/Fotos Presentatie/PCB_ADVANCED.pdf

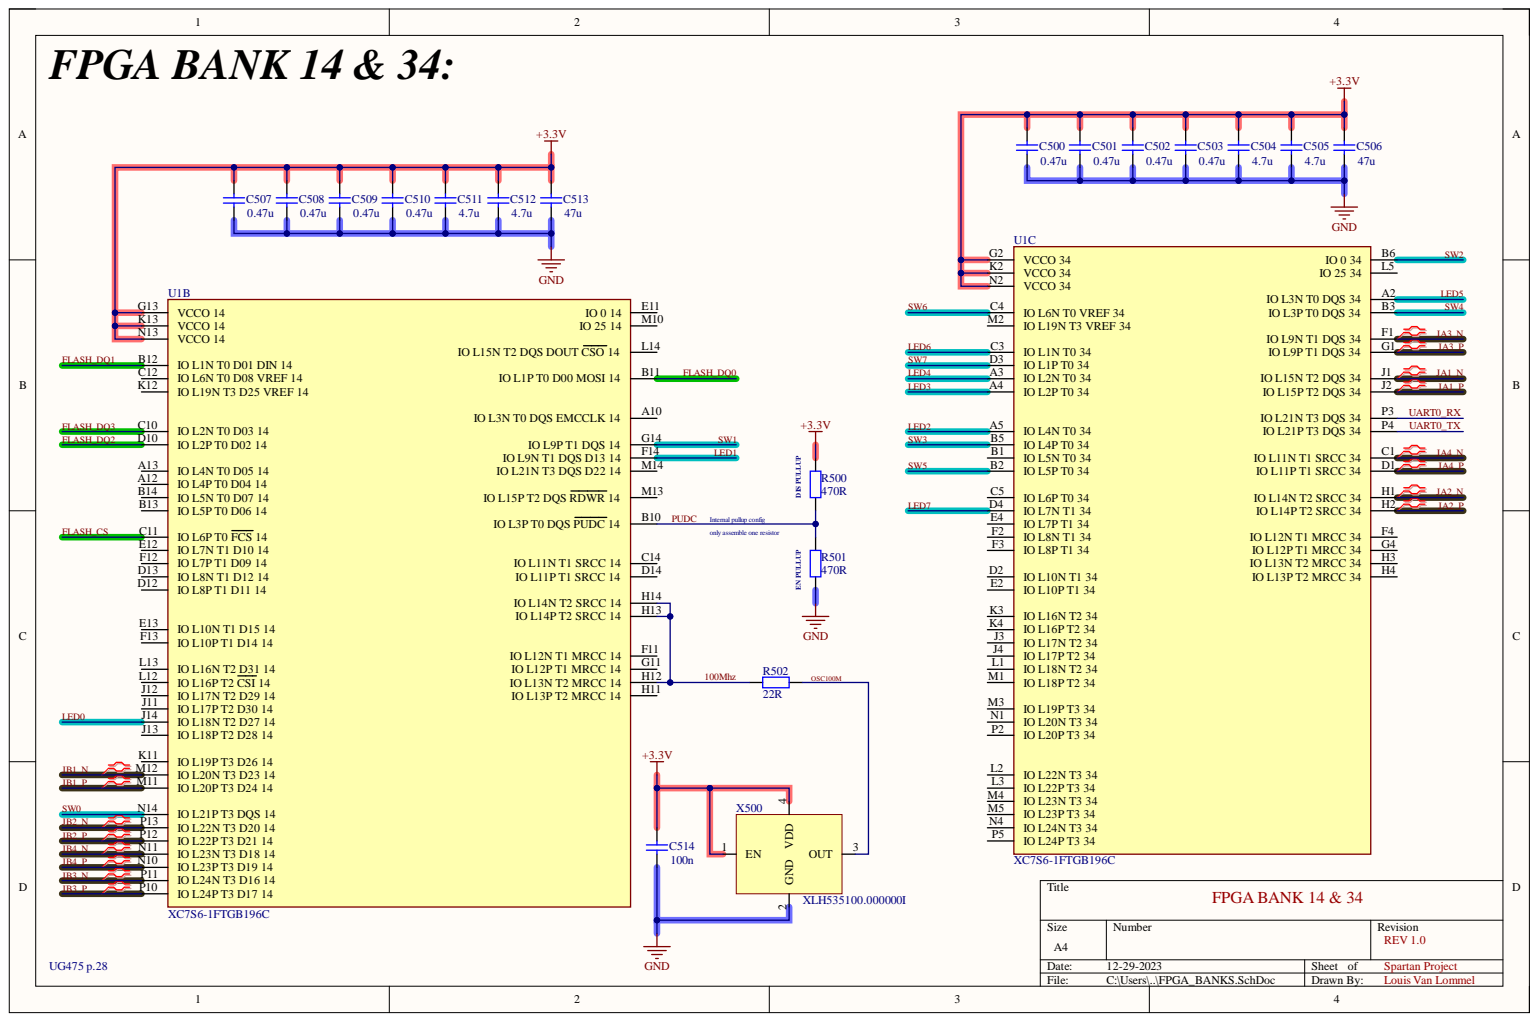
[picture p55: page 1]

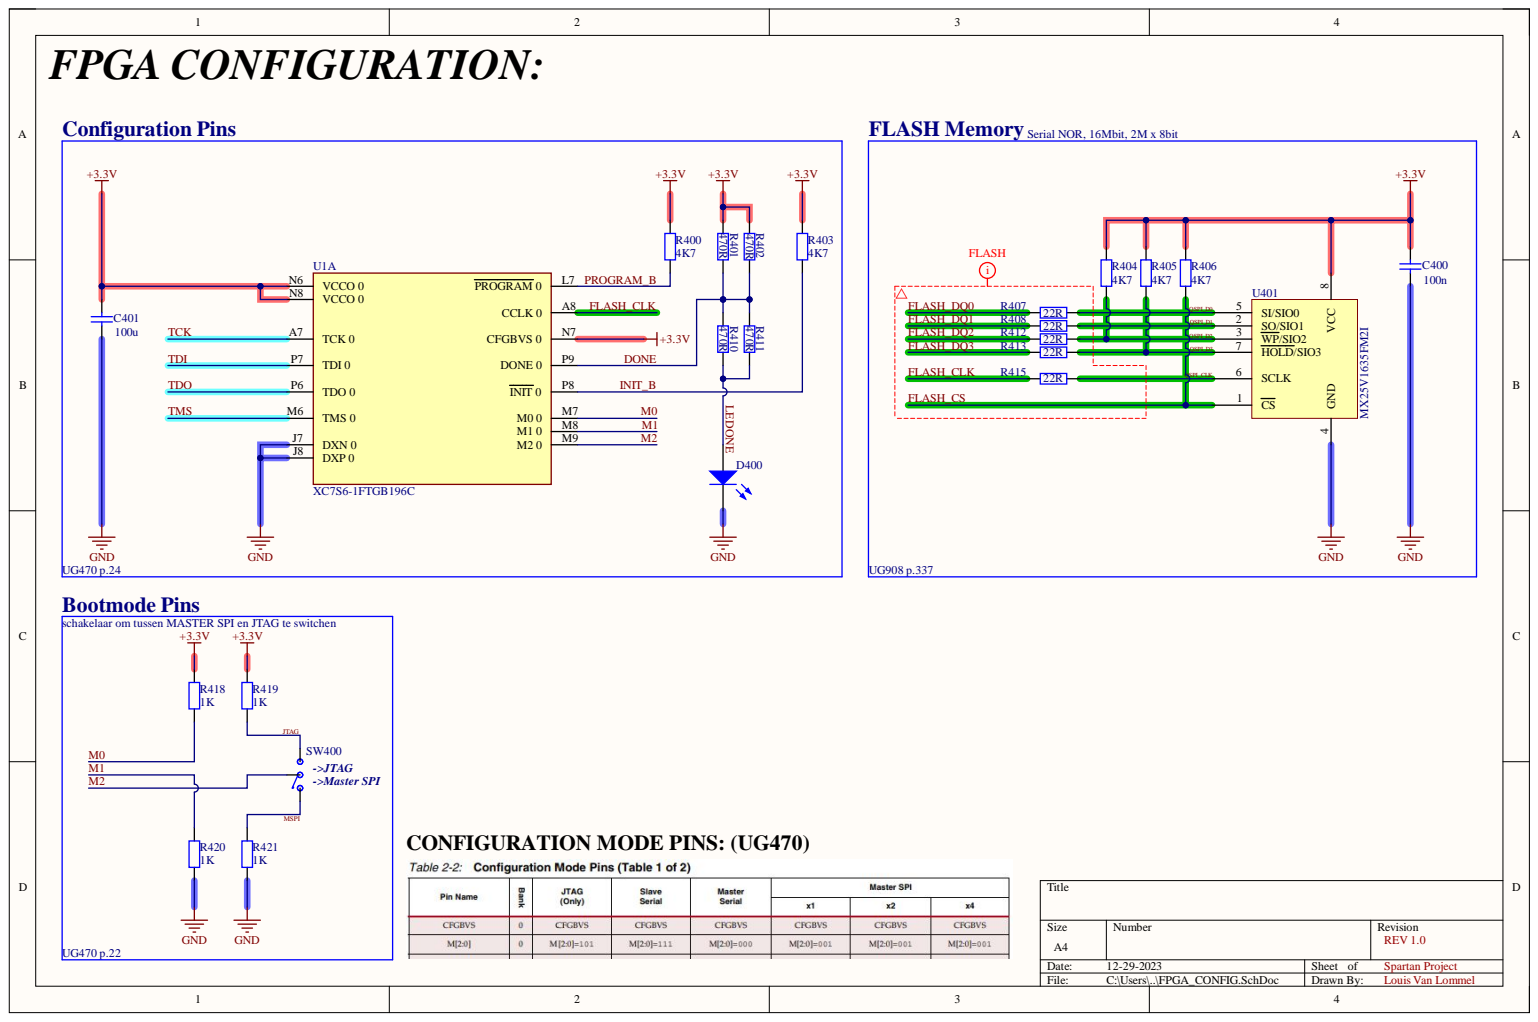
[picture p56: page 2]

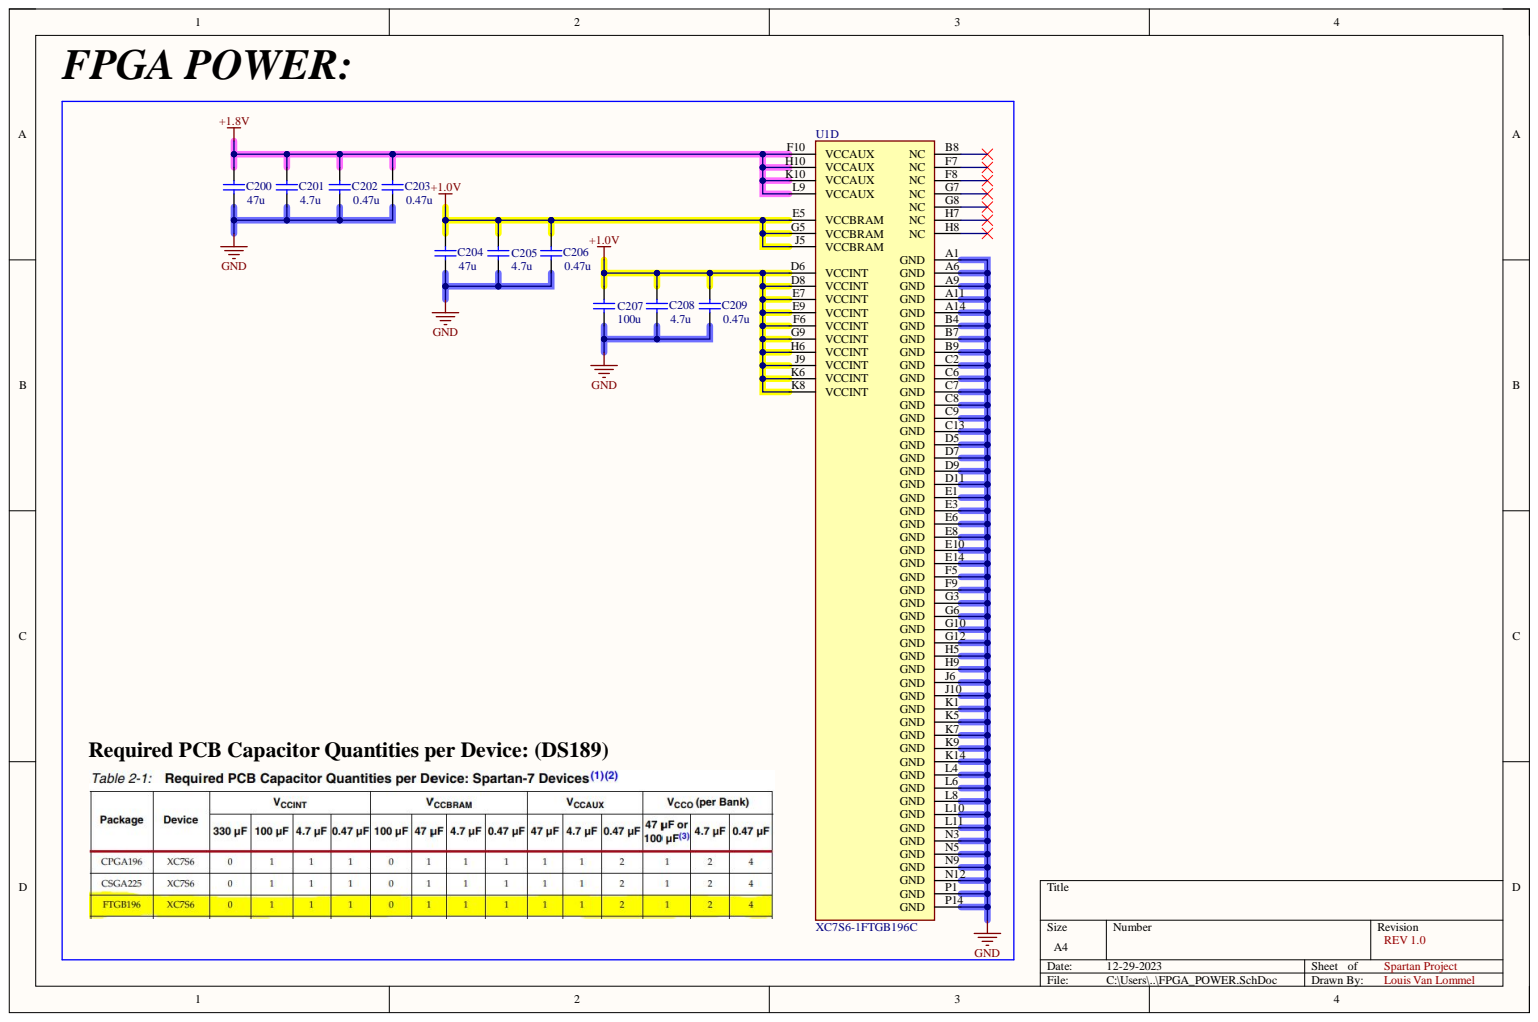
[picture p57: page 3]

Required PCB Capacitor Quantities per Device: (DS189)

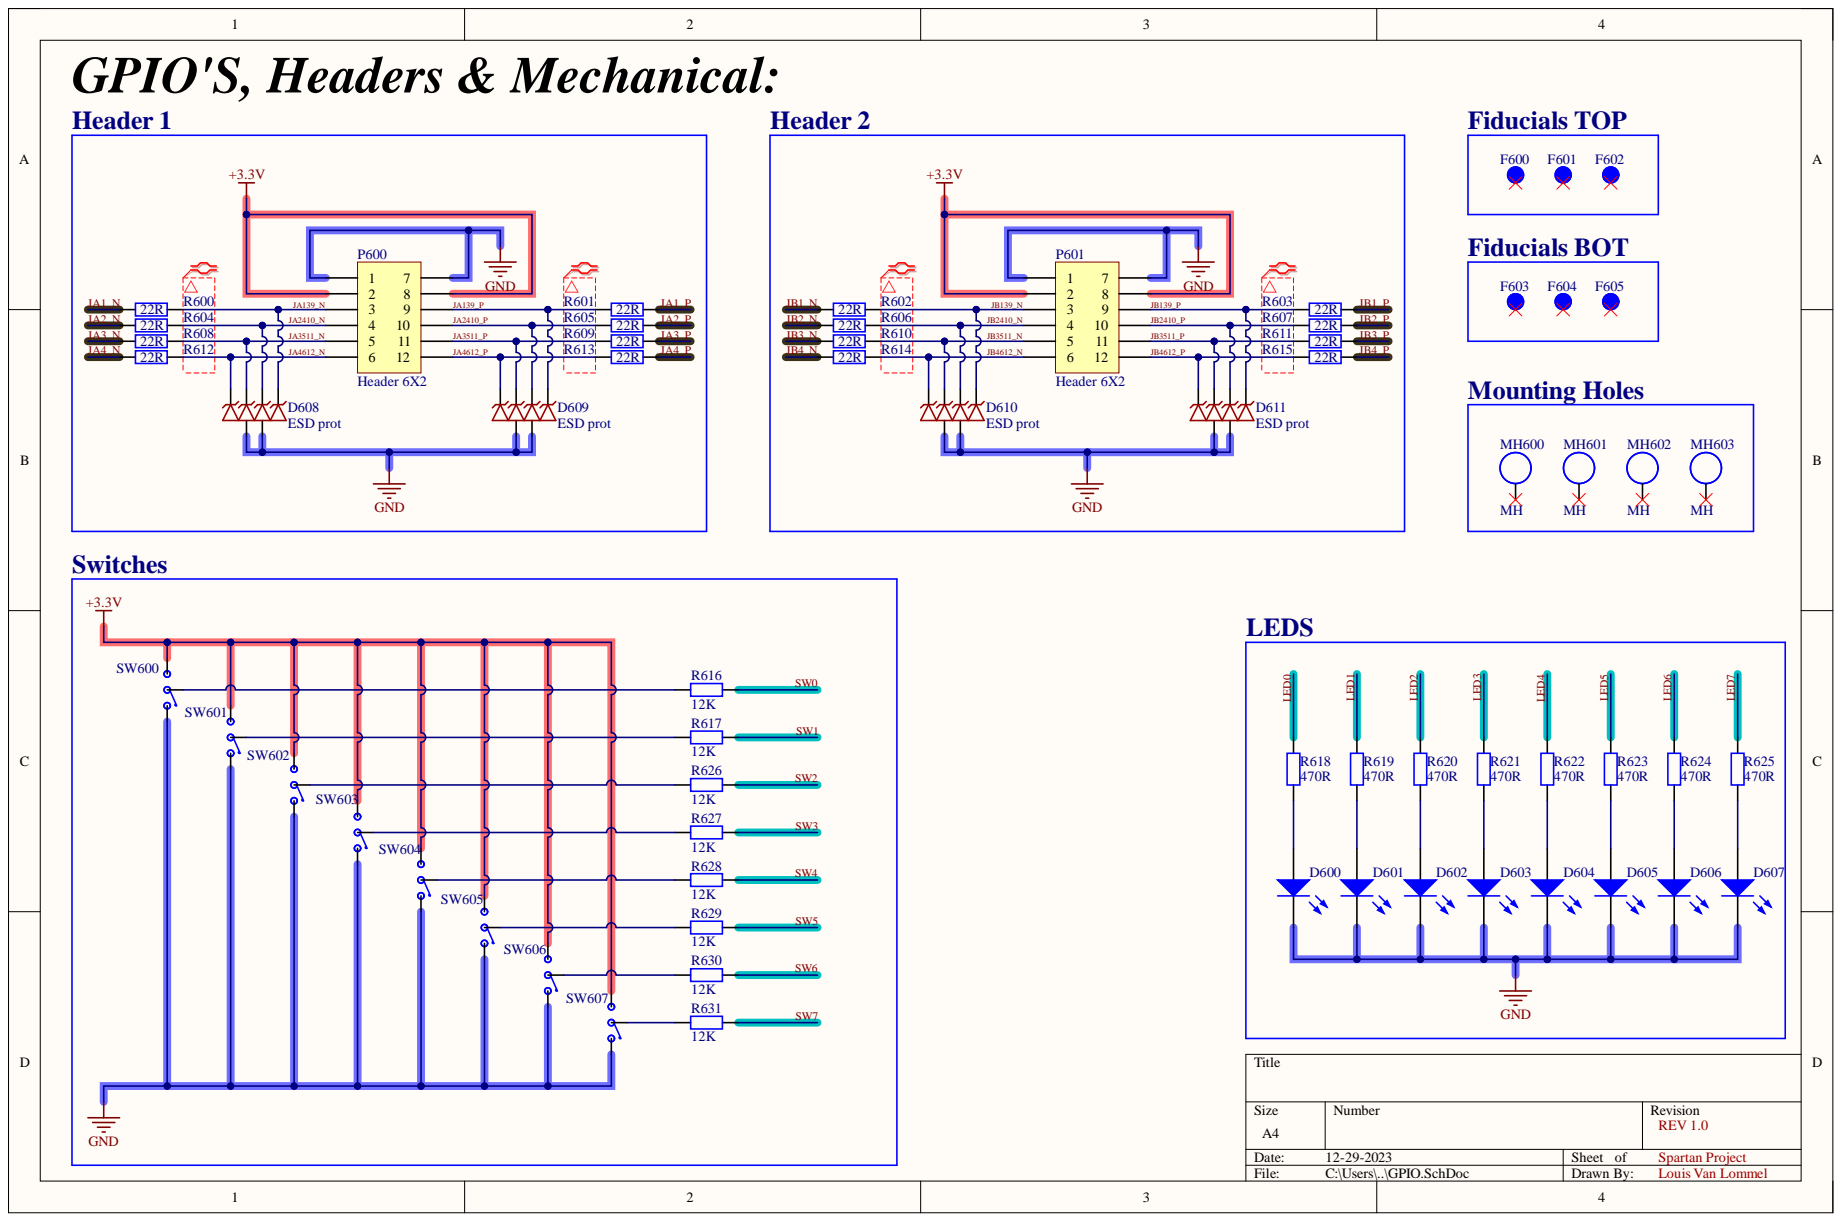
[picture p58: page 4]

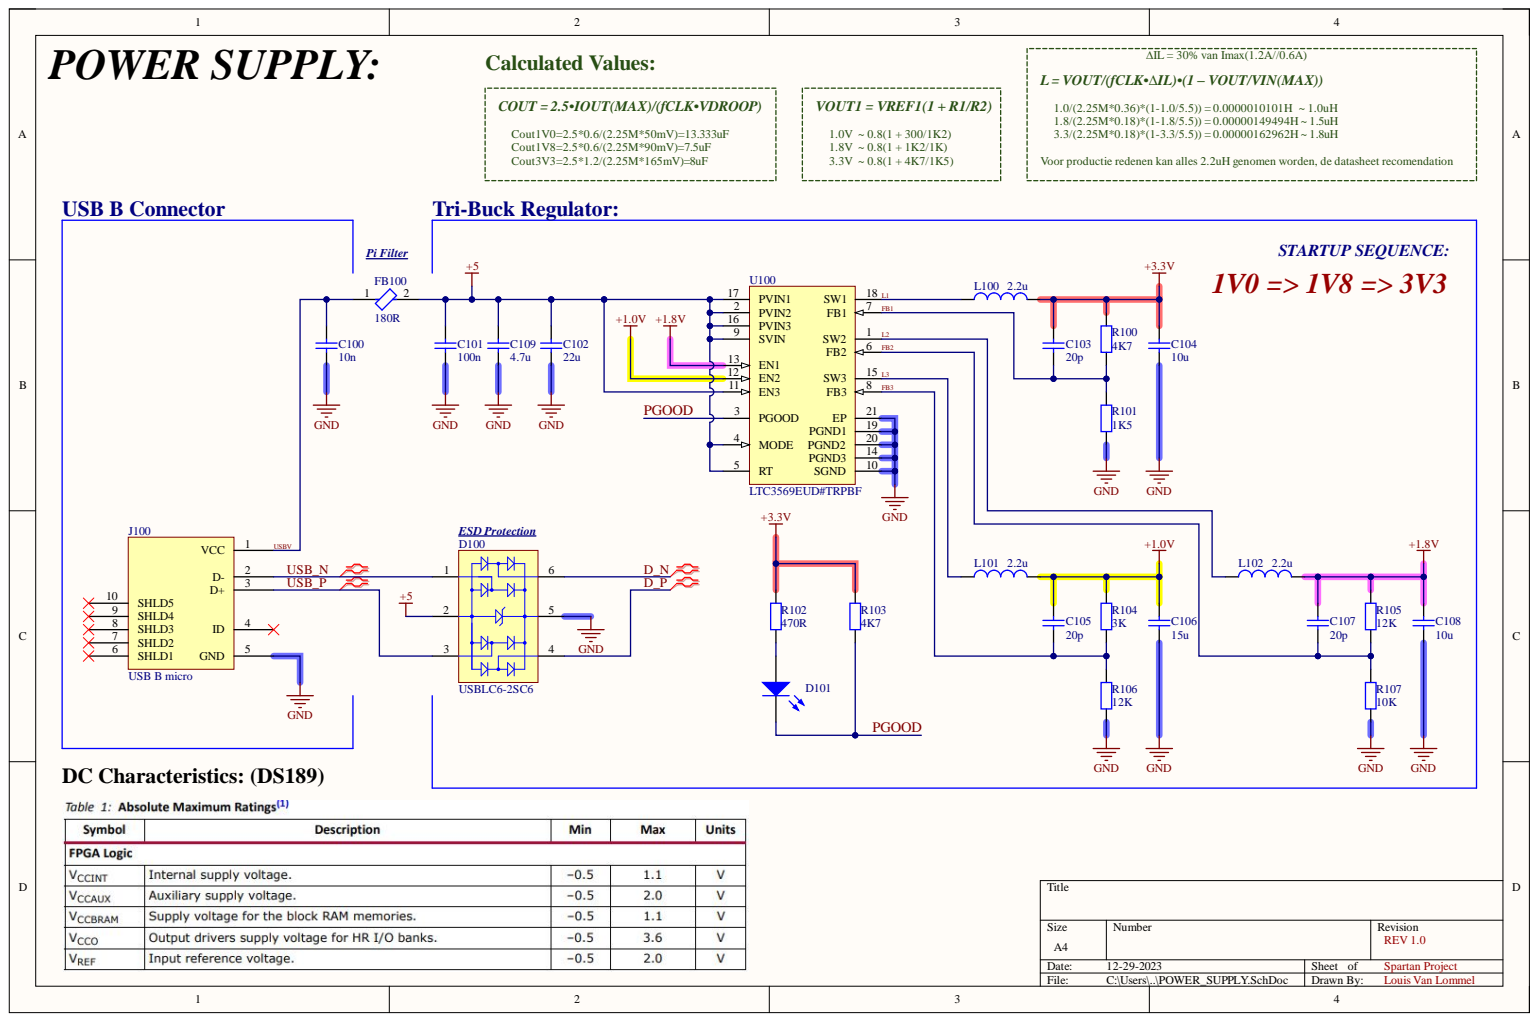
[picture p59: page 5]

1 6 | 1
1 3 | 6 FB 2

2 1 | D
1 9
2 0

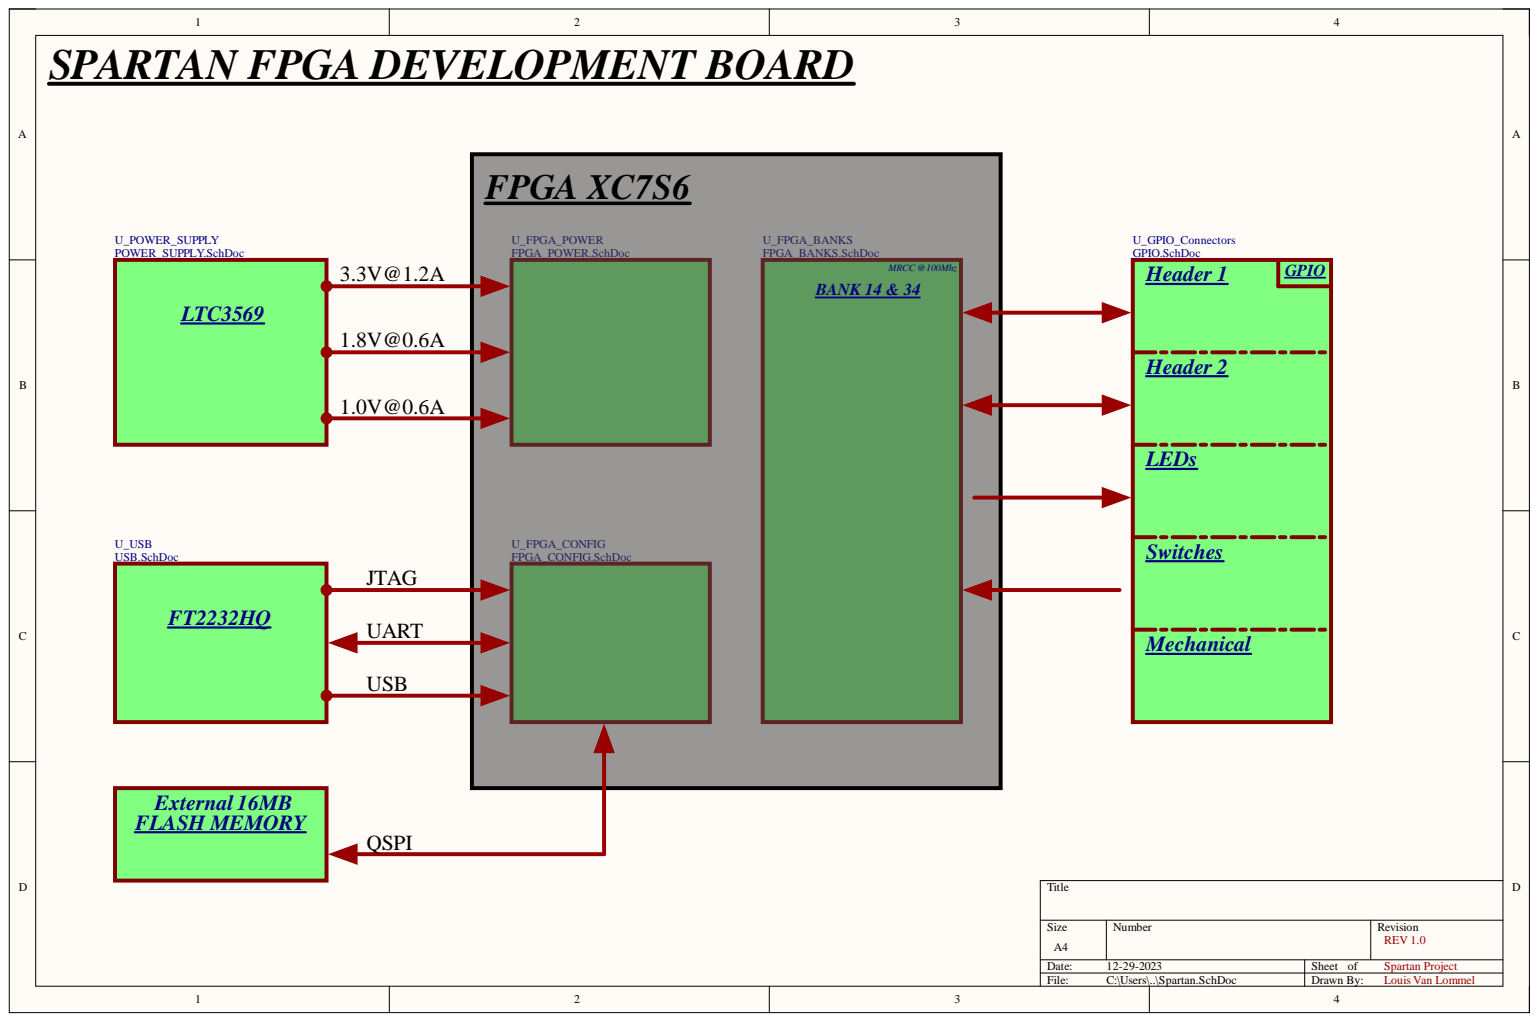
[picture p60: page 6]

SPARTAN FPGA DEVELOPMENT BOARD

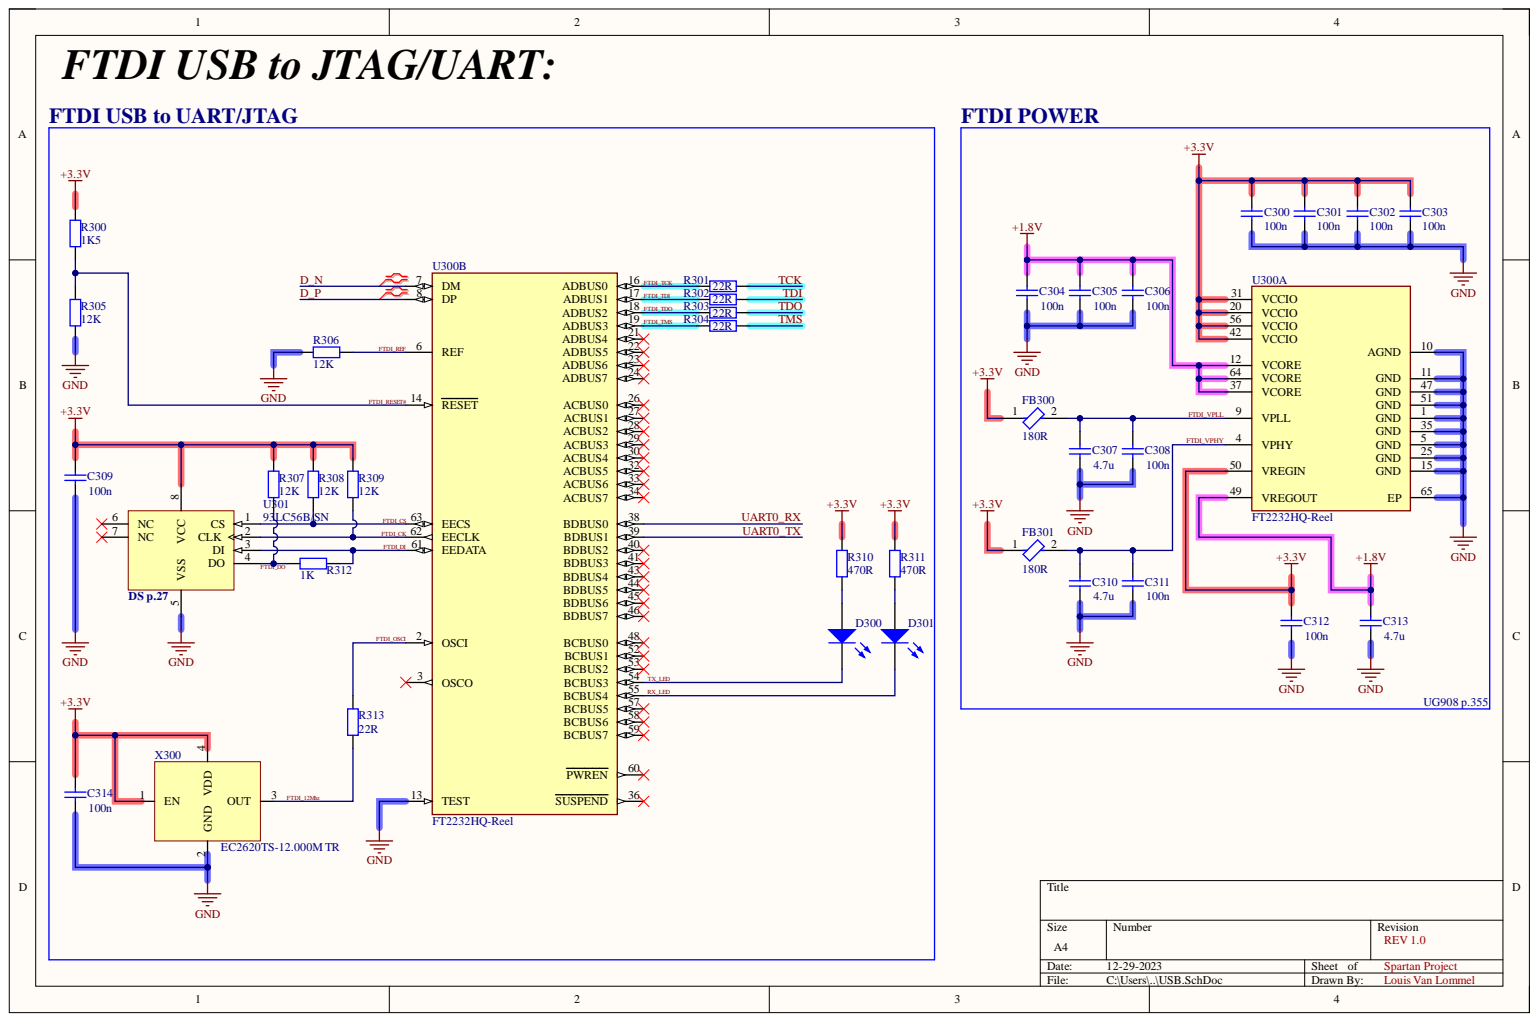
[picture p61: page 7]

FTDI USB to JTAG/UART:

FTDI USB to UART/J

TCK TDI TDO TMS

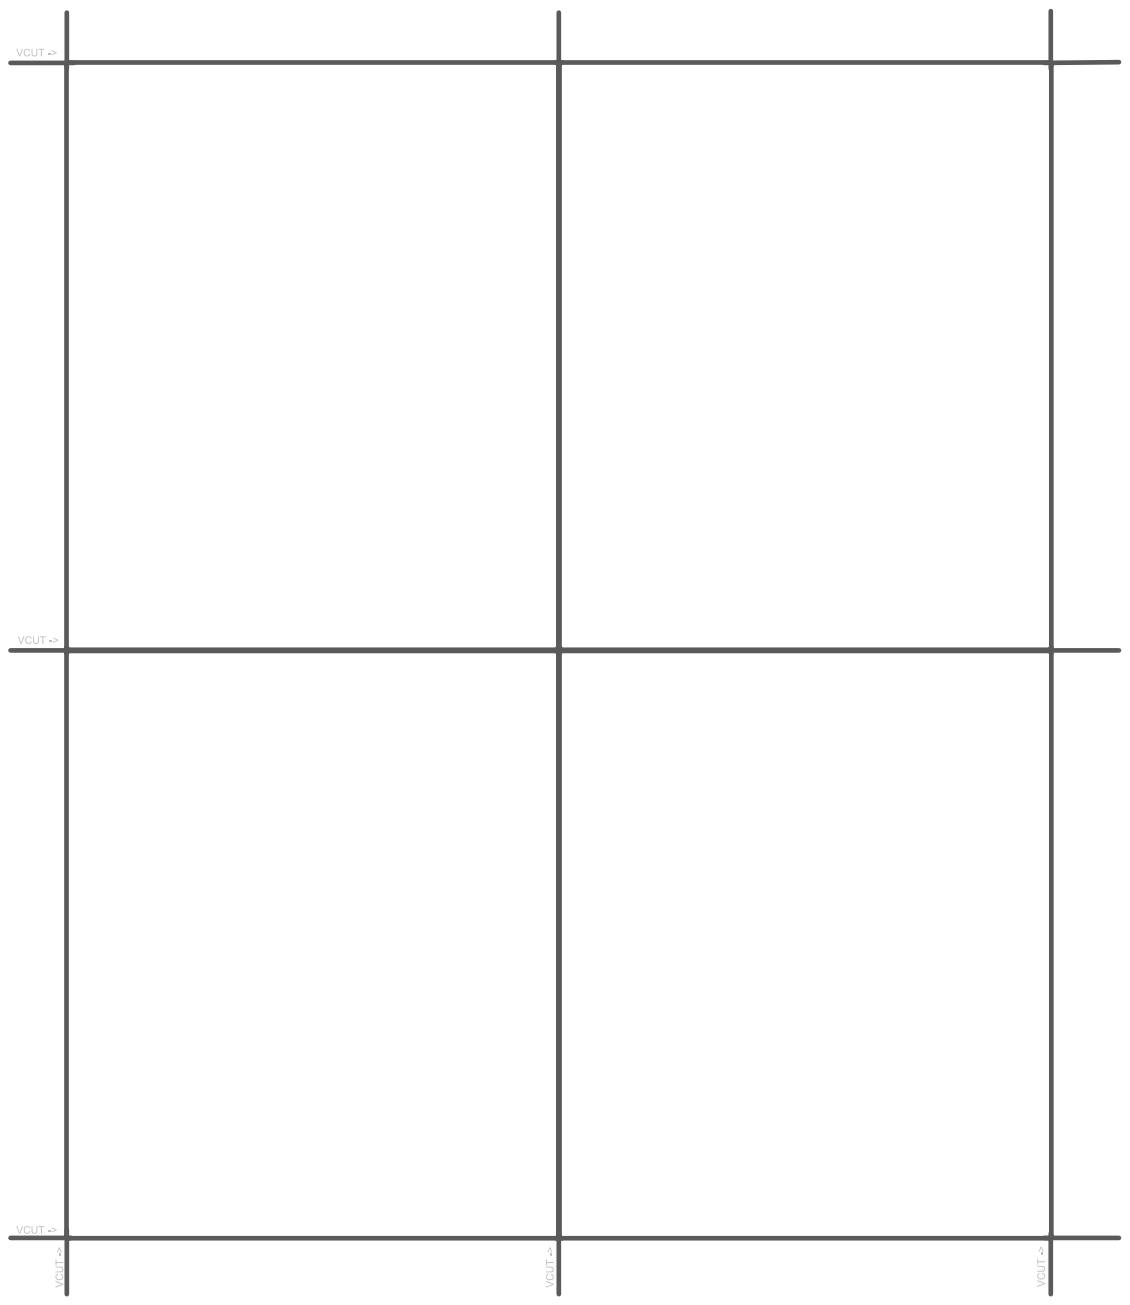
[picture p62: page 8]

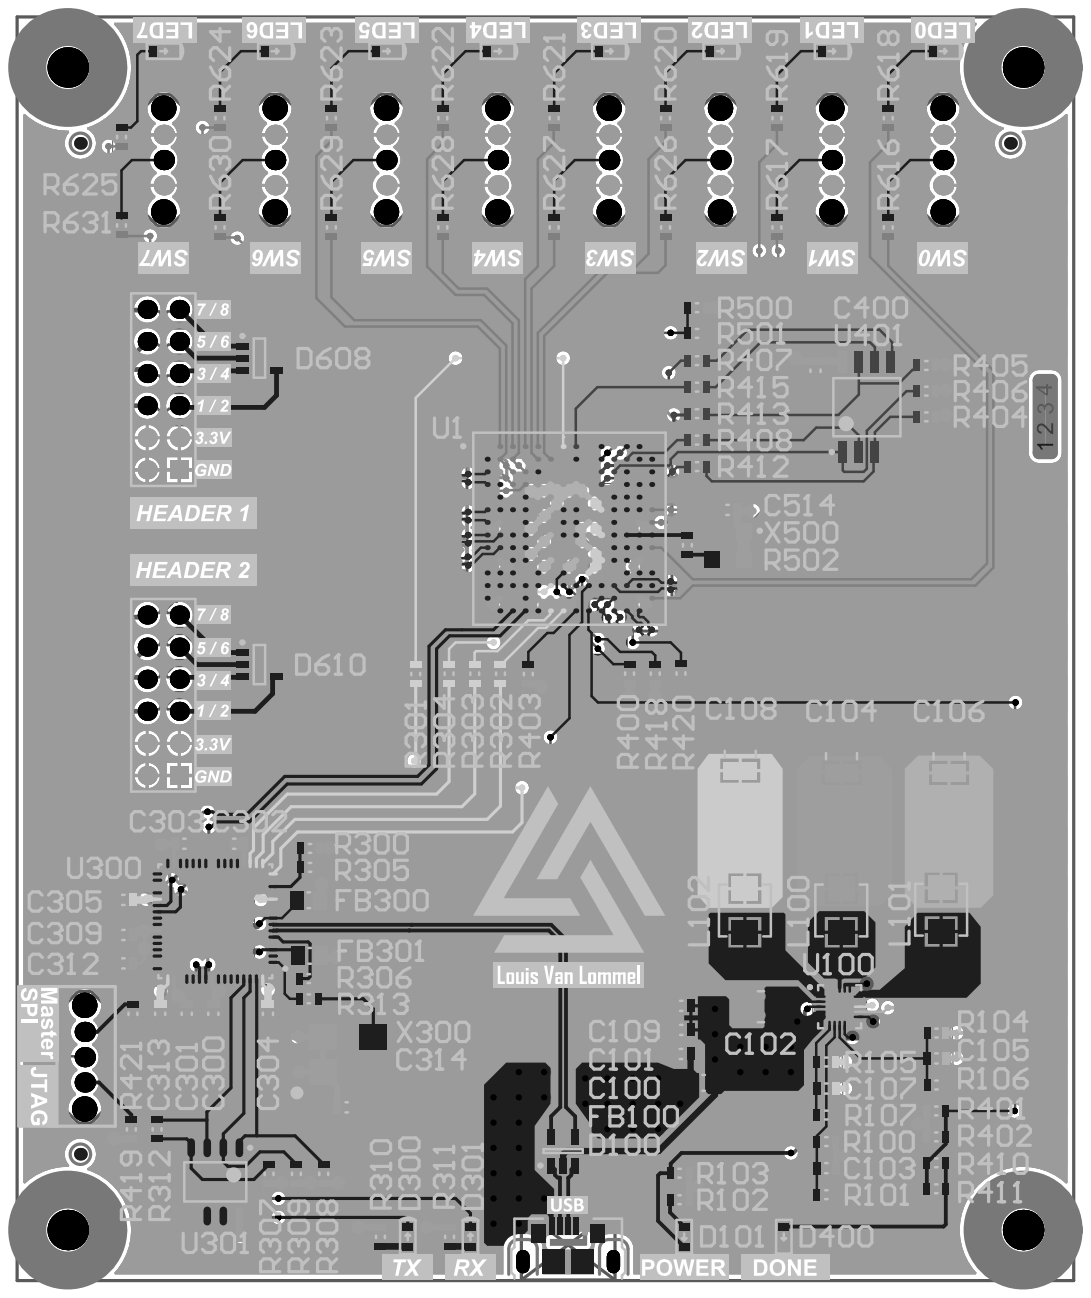
[picture p63: page 9]

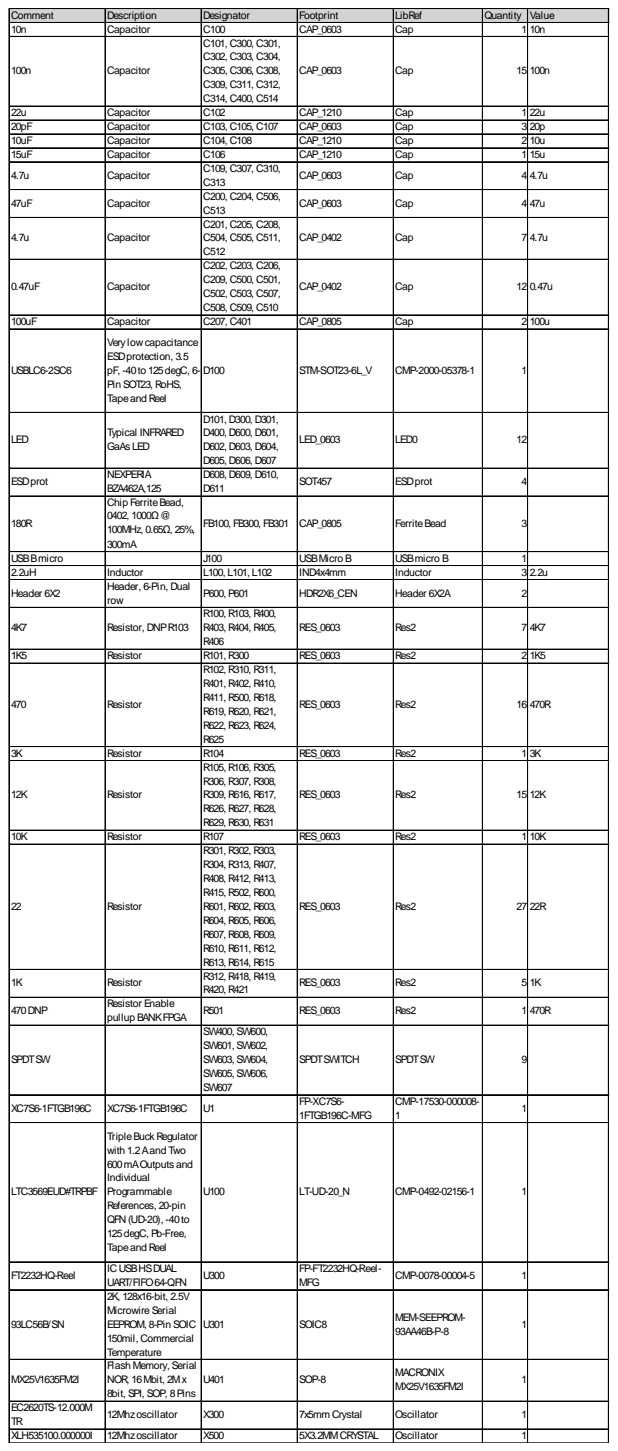
[picture p64: page 10]

Comment | Description | Designator | Footprint | LibRef | Quantity | Value
10n | Capacitor | C100 | CAP_0603 | Cap | 1 10n
100n | Capacitor | C101, C300, C301, C302, C303, C304, C305, C306, C308, C309, C311, C312, C314, C400, C514 | CAP_0603 | Cap | 15 100n

22u | Capacitor | C102 | CAP_1210 | Cap | 1 22u
20pF | Capacitor | C103, C105, C107 | CAP_0603 | Cap | 3 20p
10uF | Capacitor | C104, C108 | CAP_1210 | Cap | 2 10u
15uF | Capacitor | C106 | CAP_1210 | Cap | 1 15u
4.7u | Capacitor | C109, C307, C310, C313 | CAP_0603 | Cap | 4 4.7u

47uF | Capacitor | C200, C204, C506, C513 | CAP_0603 | Cap | 4 47u

4.7u | Capacitor | C201, C205, C208, C504, C505, C511, C512 | CAP_0402 | Cap | 7 4.7u

0.47uF | Capacitor | C202, C203, C206, C209, C500, C501, C502, C503, C507, C508, C509, C510 | CAP_0402 | Cap | 12 0.47u

100uF | Capacitor | C207, C401 | CAP_0805 | Cap | 2 100u

USBLC6-2SC6 | Very low capacitance ESDprotection, 3.5 pF, -40to 125degC, 6-Pin SOT23, RoHS, Tapeand Reel | D100 | STM-SOT23-6L_V | CMP-2000-05378-1 | 1

LED | Typical INFRARED GaAs LED | D101, D300, D301, D400, D600, D601, D602, D603, D604, D605, D606, D607 | LED_0603 | LED0 | 12

ESDprot | NEXPERIA BZA462A,125 | D608, D609, D610, D611 | SOT457 | ESDprot | 4

180R | Chip FerriteBead, 0402, 1000Ω@ 100MHz, 0.65Ω, 25%, 300mA | FB100, FB300, FB301 | CAP_0805 | FerriteBead | 3

USBBmicro | | J100 | USBMicro B | USBmicro B | 1
2.2uH | Inductor | L100, L101, L102 | IND4x4mm | Inductor | 3 2.2u
Header 6X2 | Header, 6-Pin, Dual row | P600, P601 | HDR2X6_CEN | Header 6X2A | 2

4K7 | Resistor, DNPR103 | R100, R103, R400, R403, R404, R405, R406 | RES_0603 | Res2 | 7 4K7

1K5 | Resistor | R101, R300 | RES_0603 | Res2 | 2 1K5
470 | Resistor | R102, R310, R311, R401, R402, R410, R411, R500, R618, R619, R620, R621, R622, R623, R624, R625 | RES_0603 | Res2 | 16 470R

3K | Resistor | R104 | RES_0603 | Res2 | 1 3K
12K | Resistor | R105, R106, R305, R306, R307, R308, R309, R616, R617, R626, R627, R628, R629, R630, R631 | RES_0603 | Res2 | 15 12K

10K | Resistor | R107 | RES_0603 | Res2 | 1 10K
22 | Resistor | R301, R302, R303, R304, R313, R407, R408, R412, R413, R415, R502, R600, R601, R602, R603, R604, R605, R606, R607, R608, R609, R610, R611, R612, R613, R614, R615 | RES_0603 | Res2 | 27 22R

1K | Resistor | R312, R418, R419, R420, R421 | RES_0603 | Res2 | 5 1K

470DNP | Resistor Enable pullup BANKFPGA | R501 | RES_0603 | Res2 | 1 470R

SPDTSW | | SW400, SW600, SW601, SW602, SW603, SW604, SW605, SW606, SW607 | SPDTSWITCH | SPDTSW | 9

XC7S6-1FTGB196C | XC7S6-1FTGB196C | U1 | FP-XC7S6-1FTGB196C-MFG | CMP-17530-000008-1 | 1

LTC3569EUD#TRPBF | TripleBuck Regulator with 1.2Aand Two 600mAOutputs and Individual Programmable References, 20-pin QFN (UD-20), -40to 125degC, Pb-Free, Tapeand Reel | U100 | LT-UD-20_N | CMP-0492-02156-1 | 1

FT2232HQ-Reel | IC USBHSDUAL UART/FIFO64-QFN | U300 | FP-FT2232HQ-Reel-MFG | CMP-0078-00004-5 | 1

93LC56B/SN | 2K, 128x16-bit, 2.5V MicrowireSerial EEPROM, 8-Pin SOIC 150mil, Commercial Temperature | U301 | SOIC8 | MEM-SEEPROM-93AA46B-P-8 | 1

MX25V1635FM2I | Flash Memory, Serial NOR, 16Mbit, 2Mx 8bit, SPI, SOP, 8Pins | U401 | SOP-8 | MACRONIX MX25V1635FM2I | 1

EC2620TS-12.000M TR | 12Mhzoscillator | X300 | 7x5mm Crystal | Oscillator | 1

XLH535100.000000I | 12Mhzoscillator | X500 | 5X3.2MMCRYSTAL | Oscillator | 1
