Louis-VL/PCB-ADVANCED/(list of files, drawings)

Other design files:
PCB_ADVANCED/Active.PcbLib
PCB_ADVANCED/FPGA_BANKS.SchDoc
PCB_ADVANCED/FPGA_CONFIG.SchDoc
PCB_ADVANCED/FPGA_POWER.SchDoc
PCB_ADVANCED/GPIO.SchDoc
PCB_ADVANCED/Passive.PcbLib
PCB_ADVANCED/PCB1.PcbDoc
PCB_ADVANCED/PCB_ADVANCED.PrjPcb
PCB_ADVANCED/PCB_PANEL.PcbDoc
PCB_ADVANCED/POWER_SUPPLY.SchDoc
PCB_ADVANCED/Schematic_Symbols.SchLib
PCB_ADVANCED/SDRAM.SchDoc
PCB_ADVANCED/Spartan.SchDoc
PCB_ADVANCED/USB.SchDoc
