Louis-VL/PCB-ADVANCED/VIVADO/SpartanMicroBlaze/SpartanMicroBlaze.runs/synth_1/.Xil/MicroBlazeV2_wrapper_propImpl.xdc

set_property SRC_FILE_INFO {cfile:C:/Users/louis/Documents/Github/PCB-ADVANCED/PCB-ADVANCED/VIVADO/SpartanMicroBlaze/SpartanMicroBlaze.srcs/constrs_1/new/Spartan7S6MicroBlaze.xdc rfile:../../../SpartanMicroBlaze.srcs/constrs_1/new/Spartan7S6MicroBlaze.xdc id:1} [current_design]
set_property src_info {type:XDC file:1 line:8 export:INPUT save:INPUT read:READ} [current_design]
set_property PACKAGE_PIN H13 [get_ports clk100Mhz]
set_property src_info {type:XDC file:1 line:16 export:INPUT save:INPUT read:READ} [current_design]
set_property PACKAGE_PIN P3 [get_ports RsRx]
set_property src_info {type:XDC file:1 line:18 export:INPUT save:INPUT read:READ} [current_design]
set_property PACKAGE_PIN P4 [get_ports RsTx]
set_property src_info {type:XDC file:1 line:26 export:INPUT save:INPUT read:READ} [current_design]
set_property PACKAGE_PIN N14 [get_ports sw[0]]
set_property src_info {type:XDC file:1 line:28 export:INPUT save:INPUT read:READ} [current_design]
set_property PACKAGE_PIN G14 [get_ports {sw[1]}]
set_property src_info {type:XDC file:1 line:30 export:INPUT save:INPUT read:READ} [current_design]
set_property PACKAGE_PIN B6 [get_ports {sw[2]}]
set_property src_info {type:XDC file:1 line:32 export:INPUT save:INPUT read:READ} [current_design]
set_property PACKAGE_PIN B5 [get_ports {sw[3]}]
set_property src_info {type:XDC file:1 line:34 export:INPUT save:INPUT read:READ} [current_design]
set_property PACKAGE_PIN B3 [get_ports {sw[4]}]
set_property src_info {type:XDC file:1 line:36 export:INPUT save:INPUT read:READ} [current_design]
set_property PACKAGE_PIN B2 [get_ports {sw[5]}]
set_property src_info {type:XDC file:1 line:38 export:INPUT save:INPUT read:READ} [current_design]
set_property PACKAGE_PIN C4 [get_ports {sw[6]}]
set_property src_info {type:XDC file:1 line:40 export:INPUT save:INPUT read:READ} [current_design]
set_property PACKAGE_PIN D3 [get_ports {RST}]
set_property src_info {type:XDC file:1 line:45 export:INPUT save:INPUT read:READ} [current_design]
set_property PACKAGE_PIN J14 [get_ports {led[0]}]
set_property src_info {type:XDC file:1 line:47 export:INPUT save:INPUT read:READ} [current_design]
set_property PACKAGE_PIN F14 [get_ports {led[1]}]
set_property src_info {type:XDC file:1 line:49 export:INPUT save:INPUT read:READ} [current_design]
set_property PACKAGE_PIN A5 [get_ports {led[2]}]
set_property src_info {type:XDC file:1 line:51 export:INPUT save:INPUT read:READ} [current_design]
set_property PACKAGE_PIN A4 [get_ports {led[3]}]
set_property src_info {type:XDC file:1 line:53 export:INPUT save:INPUT read:READ} [current_design]
set_property PACKAGE_PIN A3 [get_ports {led[4]}]
set_property src_info {type:XDC file:1 line:55 export:INPUT save:INPUT read:READ} [current_design]
set_property PACKAGE_PIN A2 [get_ports {led[5]}]
set_property src_info {type:XDC file:1 line:57 export:INPUT save:INPUT read:READ} [current_design]
set_property PACKAGE_PIN C3 [get_ports {led[6]}]
set_property src_info {type:XDC file:1 line:59 export:INPUT save:INPUT read:READ} [current_design]
set_property PACKAGE_PIN D4 [get_ports {led[7]}]
set_property src_info {type:XDC file:1 line:64 export:INPUT save:INPUT read:READ} [current_design]
set_property PACKAGE_PIN J2 [get_ports {JA[0]}]
set_property src_info {type:XDC file:1 line:66 export:INPUT save:INPUT read:READ} [current_design]
set_property PACKAGE_PIN J1 [get_ports {JA[1]}]
set_property src_info {type:XDC file:1 line:68 export:INPUT save:INPUT read:READ} [current_design]
set_property PACKAGE_PIN H2 [get_ports {JA[2]}]
set_property src_info {type:XDC file:1 line:70 export:INPUT save:INPUT read:READ} [current_design]
set_property PACKAGE_PIN H1 [get_ports {JA[3]}]
set_property src_info {type:XDC file:1 line:72 export:INPUT save:INPUT read:READ} [current_design]
set_property PACKAGE_PIN G1 [get_ports {JA[4]}]
set_property src_info {type:XDC file:1 line:74 export:INPUT save:INPUT read:READ} [current_design]
set_property PACKAGE_PIN F1 [get_ports {JA[5]}]
set_property src_info {type:XDC file:1 line:76 export:INPUT save:INPUT read:READ} [current_design]
set_property PACKAGE_PIN D1 [get_ports {JA[6]}]
set_property src_info {type:XDC file:1 line:78 export:INPUT save:INPUT read:READ} [current_design]
set_property PACKAGE_PIN C1 [get_ports {JA[7]}]
set_property src_info {type:XDC file:1 line:83 export:INPUT save:INPUT read:READ} [current_design]
set_property PACKAGE_PIN M11 [get_ports {JB[0]}]
set_property src_info {type:XDC file:1 line:85 export:INPUT save:INPUT read:READ} [current_design]
set_property PACKAGE_PIN M12 [get_ports {JB[1]}]
set_property src_info {type:XDC file:1 line:87 export:INPUT save:INPUT read:READ} [current_design]
set_property PACKAGE_PIN P12 [get_ports {JB[2]}]
set_property src_info {type:XDC file:1 line:89 export:INPUT save:INPUT read:READ} [current_design]
set_property PACKAGE_PIN P13 [get_ports {JB[3]}]
set_property src_info {type:XDC file:1 line:91 export:INPUT save:INPUT read:READ} [current_design]
set_property PACKAGE_PIN P10 [get_ports {JB[4]}]
set_property src_info {type:XDC file:1 line:93 export:INPUT save:INPUT read:READ} [current_design]
set_property PACKAGE_PIN P11 [get_ports {JB[5]}]
set_property src_info {type:XDC file:1 line:95 export:INPUT save:INPUT read:READ} [current_design]
set_property PACKAGE_PIN N10 [get_ports {JB[6]}]
set_property src_info {type:XDC file:1 line:97 export:INPUT save:INPUT read:READ} [current_design]
set_property PACKAGE_PIN N11 [get_ports {JB[7]}]
