Louis-VL/PCB-ADVANCED/VIVADO/SpartanMicroBlaze/SpartanMicroBlaze.gen/sources_1/bd/MicroBlazeV2/synth/MicroBlazeV2.v

//Copyright 1986-2022 Xilinx, Inc. All Rights Reserved.
//Copyright 2022-2023 Advanced Micro Devices, Inc. All Rights Reserved.
//--------------------------------------------------------------------------------
//Tool Version: Vivado v.2023.1 (win64) Build 3865809 Sun May  7 15:05:29 MDT 2023
//Date        : Wed Dec 20 10:46:43 2023
//Host        : LAPTOP-K67JHBA7 running 64-bit major release  (build 9200)
//Command     : generate_target MicroBlazeV2.bd
//Design      : MicroBlazeV2
//Purpose     : IP block netlist
//--------------------------------------------------------------------------------
`timescale 1 ps / 1 ps

(* CORE_GENERATION_INFO = "MicroBlazeV2,IP_Integrator,{x_ipVendor=xilinx.com,x_ipLibrary=BlockDiagram,x_ipName=MicroBlazeV2,x_ipVersion=1.00.a,x_ipLanguage=VERILOG,numBlks=23,numReposBlks=14,numNonXlnxBlks=0,numHierBlks=9,maxHierDepth=1,numSysgenBlks=0,numHlsBlks=0,numHdlrefBlks=0,numPkgbdBlks=0,bdsource=USER,da_axi4_cnt=7,da_board_cnt=7,da_clkrst_cnt=1,da_mb_cnt=1,synth_mode=OOC_per_IP}" *) (* HW_HANDOFF = "MicroBlazeV2.hwdef" *) 
module MicroBlazeV2
   (JA,
    JB,
    RST,
    RsRx,
    RsTx,
    clk100Mhz,
    led,
    sw);
  output [7:0]JA;
  output [7:0]JB;
  (* X_INTERFACE_INFO = "xilinx.com:signal:reset:1.0 RST.RST RST" *) (* X_INTERFACE_PARAMETER = "XIL_INTERFACENAME RST.RST, INSERT_VIP 0, POLARITY ACTIVE_LOW" *) input RST;
  input RsRx;
  output RsTx;
  (* X_INTERFACE_INFO = "xilinx.com:signal:clock:1.0 CLK.CLK100MHZ CLK" *) (* X_INTERFACE_PARAMETER = "XIL_INTERFACENAME CLK.CLK100MHZ, CLK_DOMAIN MicroBlazeV2_clk_in1_n_0, FREQ_HZ 100000000, FREQ_TOLERANCE_HZ 0, INSERT_VIP 0, PHASE 0.0" *) input clk100Mhz;
  output [7:0]led;
  input [6:0]sw;

  wire [7:0]axi_gpio_0_gpio_io_o;
  wire [7:0]axi_gpio_0_gpio_io_t;
  wire [7:0]axi_gpio_Header1_gpio_io_t;
  wire axi_uartlite_0_tx;
  wire [6:0]gpio_io_i_0_1;
  wire mdm_1_debug_sys_rst;
  wire microblaze_0_Clk;
  wire [31:0]microblaze_0_M_AXI_DP_ARADDR;
  wire [2:0]microblaze_0_M_AXI_DP_ARPROT;
  wire [0:0]microblaze_0_M_AXI_DP_ARREADY;
  wire microblaze_0_M_AXI_DP_ARVALID;
  wire [31:0]microblaze_0_M_AXI_DP_AWADDR;
  wire [2:0]microblaze_0_M_AXI_DP_AWPROT;
  wire [0:0]microblaze_0_M_AXI_DP_AWREADY;
  wire microblaze_0_M_AXI_DP_AWVALID;
  wire microblaze_0_M_AXI_DP_BREADY;
  wire [1:0]microblaze_0_M_AXI_DP_BRESP;
  wire [0:0]microblaze_0_M_AXI_DP_BVALID;
  wire [31:0]microblaze_0_M_AXI_DP_RDATA;
  wire microblaze_0_M_AXI_DP_RREADY;
  wire [1:0]microblaze_0_M_AXI_DP_RRESP;
  wire [0:0]microblaze_0_M_AXI_DP_RVALID;
  wire [31:0]microblaze_0_M_AXI_DP_WDATA;
  wire [0:0]microblaze_0_M_AXI_DP_WREADY;
  wire [3:0]microblaze_0_M_AXI_DP_WSTRB;
  wire microblaze_0_M_AXI_DP_WVALID;
  wire [31:0]microblaze_0_axi_periph_M00_AXI_ARADDR;
  wire microblaze_0_axi_periph_M00_AXI_ARREADY;
  wire [0:0]microblaze_0_axi_periph_M00_AXI_ARVALID;
  wire [31:0]microblaze_0_axi_periph_M00_AXI_AWADDR;
  wire microblaze_0_axi_periph_M00_AXI_AWREADY;
  wire [0:0]microblaze_0_axi_periph_M00_AXI_AWVALID;
  wire [0:0]microblaze_0_axi_periph_M00_AXI_BREADY;
  wire [1:0]microblaze_0_axi_periph_M00_AXI_BRESP;
  wire microblaze_0_axi_periph_M00_AXI_BVALID;
  wire [31:0]microblaze_0_axi_periph_M00_AXI_RDATA;
  wire [0:0]microblaze_0_axi_periph_M00_AXI_RREADY;
  wire [1:0]microblaze_0_axi_periph_M00_AXI_RRESP;
  wire microblaze_0_axi_periph_M00_AXI_RVALID;
  wire [31:0]microblaze_0_axi_periph_M00_AXI_WDATA;
  wire microblaze_0_axi_periph_M00_AXI_WREADY;
  wire [3:0]microblaze_0_axi_periph_M00_AXI_WSTRB;
  wire [0:0]microblaze_0_axi_periph_M00_AXI_WVALID;
  wire [31:0]microblaze_0_axi_periph_M01_AXI_ARADDR;
  wire microblaze_0_axi_periph_M01_AXI_ARREADY;
  wire microblaze_0_axi_periph_M01_AXI_ARVALID;
  wire [31:0]microblaze_0_axi_periph_M01_AXI_AWADDR;
  wire microblaze_0_axi_periph_M01_AXI_AWREADY;
  wire microblaze_0_axi_periph_M01_AXI_AWVALID;
  wire microblaze_0_axi_periph_M01_AXI_BREADY;
  wire [1:0]microblaze_0_axi_periph_M01_AXI_BRESP;
  wire microblaze_0_axi_periph_M01_AXI_BVALID;
  wire [31:0]microblaze_0_axi_periph_M01_AXI_RDATA;
  wire microblaze_0_axi_periph_M01_AXI_RREADY;
  wire [1:0]microblaze_0_axi_periph_M01_AXI_RRESP;
  wire microblaze_0_axi_periph_M01_AXI_RVALID;
  wire [31:0]microblaze_0_axi_periph_M01_AXI_WDATA;
  wire microblaze_0_axi_periph_M01_AXI_WREADY;
  wire [3:0]microblaze_0_axi_periph_M01_AXI_WSTRB;
  wire microblaze_0_axi_periph_M01_AXI_WVALID;
  wire [31:0]microblaze_0_axi_periph_M02_AXI_ARADDR;
  wire microblaze_0_axi_periph_M02_AXI_ARREADY;
  wire microblaze_0_axi_periph_M02_AXI_ARVALID;
  wire [31:0]microblaze_0_axi_periph_M02_AXI_AWADDR;
  wire microblaze_0_axi_periph_M02_AXI_AWREADY;
  wire microblaze_0_axi_periph_M02_AXI_AWVALID;
  wire microblaze_0_axi_periph_M02_AXI_BREADY;
  wire [1:0]microblaze_0_axi_periph_M02_AXI_BRESP;
  wire microblaze_0_axi_periph_M02_AXI_BVALID;
  wire [31:0]microblaze_0_axi_periph_M02_AXI_RDATA;
  wire microblaze_0_axi_periph_M02_AXI_RREADY;
  wire [1:0]microblaze_0_axi_periph_M02_AXI_RRESP;
  wire microblaze_0_axi_periph_M02_AXI_RVALID;
  wire [31:0]microblaze_0_axi_periph_M02_AXI_WDATA;
  wire microblaze_0_axi_periph_M02_AXI_WREADY;
  wire [3:0]microblaze_0_axi_periph_M02_AXI_WSTRB;
  wire microblaze_0_axi_periph_M02_AXI_WVALID;
  wire [31:0]microblaze_0_axi_periph_M03_AXI_ARADDR;
  wire microblaze_0_axi_periph_M03_AXI_ARREADY;
  wire microblaze_0_axi_periph_M03_AXI_ARVALID;
  wire [31:0]microblaze_0_axi_periph_M03_AXI_AWADDR;
  wire microblaze_0_axi_periph_M03_AXI_AWREADY;
  wire microblaze_0_axi_periph_M03_AXI_AWVALID;
  wire microblaze_0_axi_periph_M03_AXI_BREADY;
  wire [1:0]microblaze_0_axi_periph_M03_AXI_BRESP;
  wire microblaze_0_axi_periph_M03_AXI_BVALID;
  wire [31:0]microblaze_0_axi_periph_M03_AXI_RDATA;
  wire microblaze_0_axi_periph_M03_AXI_RREADY;
  wire [1:0]microblaze_0_axi_periph_M03_AXI_RRESP;
  wire microblaze_0_axi_periph_M03_AXI_RVALID;
  wire [31:0]microblaze_0_axi_periph_M03_AXI_WDATA;
  wire microblaze_0_axi_periph_M03_AXI_WREADY;
  wire [3:0]microblaze_0_axi_periph_M03_AXI_WSTRB;
  wire microblaze_0_axi_periph_M03_AXI_WVALID;
  wire [31:0]microblaze_0_axi_periph_M04_AXI_ARADDR;
  wire microblaze_0_axi_periph_M04_AXI_ARREADY;
  wire microblaze_0_axi_periph_M04_AXI_ARVALID;
  wire [31:0]microblaze_0_axi_periph_M04_AXI_AWADDR;
  wire microblaze_0_axi_periph_M04_AXI_AWREADY;
  wire microblaze_0_axi_periph_M04_AXI_AWVALID;
  wire microblaze_0_axi_periph_M04_AXI_BREADY;
  wire [1:0]microblaze_0_axi_periph_M04_AXI_BRESP;
  wire microblaze_0_axi_periph_M04_AXI_BVALID;
  wire [31:0]microblaze_0_axi_periph_M04_AXI_RDATA;
  wire microblaze_0_axi_periph_M04_AXI_RREADY;
  wire [1:0]microblaze_0_axi_periph_M04_AXI_RRESP;
  wire microblaze_0_axi_periph_M04_AXI_RVALID;
  wire [31:0]microblaze_0_axi_periph_M04_AXI_WDATA;
  wire microblaze_0_axi_periph_M04_AXI_WREADY;
  wire [3:0]microblaze_0_axi_periph_M04_AXI_WSTRB;
  wire microblaze_0_axi_periph_M04_AXI_WVALID;
  wire microblaze_0_debug_CAPTURE;
  wire microblaze_0_debug_CLK;
  wire microblaze_0_debug_DISABLE;
  wire [0:7]microblaze_0_debug_REG_EN;
  wire microblaze_0_debug_RST;
  wire microblaze_0_debug_SHIFT;
  wire microblaze_0_debug_TDI;
  wire microblaze_0_debug_TDO;
  wire microblaze_0_debug_UPDATE;
  wire [0:31]microblaze_0_dlmb_1_ABUS;
  wire microblaze_0_dlmb_1_ADDRSTROBE;
  wire [0:3]microblaze_0_dlmb_1_BE;
  wire microblaze_0_dlmb_1_CE;
  wire [0:31]microblaze_0_dlmb_1_READDBUS;
  wire microblaze_0_dlmb_1_READSTROBE;
  wire microblaze_0_dlmb_1_READY;
  wire microblaze_0_dlmb_1_UE;
  wire microblaze_0_dlmb_1_WAIT;
  wire [0:31]microblaze_0_dlmb_1_WRITEDBUS;
  wire microblaze_0_dlmb_1_WRITESTROBE;
  wire [0:31]microblaze_0_ilmb_1_ABUS;
  wire microblaze_0_ilmb_1_ADDRSTROBE;
  wire microblaze_0_ilmb_1_CE;
  wire [0:31]microblaze_0_ilmb_1_READDBUS;
  wire microblaze_0_ilmb_1_READSTROBE;
  wire microblaze_0_ilmb_1_READY;
  wire microblaze_0_ilmb_1_UE;
  wire microblaze_0_ilmb_1_WAIT;
  wire reset_rtl_0_1;
  wire [0:0]rst_clk_wiz_1_100M_bus_struct_reset;
  wire rst_clk_wiz_1_100M_mb_reset;
  wire [0:0]rst_clk_wiz_1_100M_peripheral_aresetn;
  wire rx_0_1;

  assign JA[7:0] = axi_gpio_0_gpio_io_t;
  assign JB[7:0] = axi_gpio_Header1_gpio_io_t;
  assign RsTx = axi_uartlite_0_tx;
  assign gpio_io_i_0_1 = sw[6:0];
  assign led[7:0] = axi_gpio_0_gpio_io_o;
  assign microblaze_0_Clk = clk100Mhz;
  assign reset_rtl_0_1 = RST;
  assign rx_0_1 = RsRx;
  MicroBlazeV2_axi_gpio_1_1 axi_gpio_Header1
       (.gpio_io_i({1'b0,1'b0,1'b0,1'b0,1'b0,1'b0,1'b0,1'b0}),
        .gpio_io_t(axi_gpio_Header1_gpio_io_t),
        .s_axi_aclk(microblaze_0_Clk),
        .s_axi_araddr(microblaze_0_axi_periph_M03_AXI_ARADDR[8:0]),
        .s_axi_aresetn(rst_clk_wiz_1_100M_peripheral_aresetn),
        .s_axi_arready(microblaze_0_axi_periph_M03_AXI_ARREADY),
        .s_axi_arvalid(microblaze_0_axi_periph_M03_AXI_ARVALID),
        .s_axi_awaddr(microblaze_0_axi_periph_M03_AXI_AWADDR[8:0]),
        .s_axi_awready(microblaze_0_axi_periph_M03_AXI_AWREADY),
        .s_axi_awvalid(microblaze_0_axi_periph_M03_AXI_AWVALID),
        .s_axi_bready(microblaze_0_axi_periph_M03_AXI_BREADY),
        .s_axi_bresp(microblaze_0_axi_periph_M03_AXI_BRESP),
        .s_axi_bvalid(microblaze_0_axi_periph_M03_AXI_BVALID),
        .s_axi_rdata(microblaze_0_axi_periph_M03_AXI_RDATA),
        .s_axi_rready(microblaze_0_axi_periph_M03_AXI_RREADY),
        .s_axi_rresp(microblaze_0_axi_periph_M03_AXI_RRESP),
        .s_axi_rvalid(microblaze_0_axi_periph_M03_AXI_RVALID),
        .s_axi_wdata(microblaze_0_axi_periph_M03_AXI_WDATA),
        .s_axi_wready(microblaze_0_axi_periph_M03_AXI_WREADY),
        .s_axi_wstrb(microblaze_0_axi_periph_M03_AXI_WSTRB),
        .s_axi_wvalid(microblaze_0_axi_periph_M03_AXI_WVALID));
  MicroBlazeV2_axi_gpio_0_1 axi_gpio_Header2
       (.gpio_io_i({1'b0,1'b0,1'b0,1'b0,1'b0,1'b0,1'b0,1'b0}),
        .gpio_io_t(axi_gpio_0_gpio_io_t),
        .s_axi_aclk(microblaze_0_Clk),
        .s_axi_araddr(microblaze_0_axi_periph_M04_AXI_ARADDR[8:0]),
        .s_axi_aresetn(rst_clk_wiz_1_100M_peripheral_aresetn),
        .s_axi_arready(microblaze_0_axi_periph_M04_AXI_ARREADY),
        .s_axi_arvalid(microblaze_0_axi_periph_M04_AXI_ARVALID),
        .s_axi_awaddr(microblaze_0_axi_periph_M04_AXI_AWADDR[8:0]),
        .s_axi_awready(microblaze_0_axi_periph_M04_AXI_AWREADY),
        .s_axi_awvalid(microblaze_0_axi_periph_M04_AXI_AWVALID),
        .s_axi_bready(microblaze_0_axi_periph_M04_AXI_BREADY),
        .s_axi_bresp(microblaze_0_axi_periph_M04_AXI_BRESP),
        .s_axi_bvalid(microblaze_0_axi_periph_M04_AXI_BVALID),
        .s_axi_rdata(microblaze_0_axi_periph_M04_AXI_RDATA),
        .s_axi_rready(microblaze_0_axi_periph_M04_AXI_RREADY),
        .s_axi_rresp(microblaze_0_axi_periph_M04_AXI_RRESP),
        .s_axi_rvalid(microblaze_0_axi_periph_M04_AXI_RVALID),
        .s_axi_wdata(microblaze_0_axi_periph_M04_AXI_WDATA),
        .s_axi_wready(microblaze_0_axi_periph_M04_AXI_WREADY),
        .s_axi_wstrb(microblaze_0_axi_periph_M04_AXI_WSTRB),
        .s_axi_wvalid(microblaze_0_axi_periph_M04_AXI_WVALID));
  MicroBlazeV2_axi_gpio_0_0 axi_gpio_LEDS
       (.gpio_io_i({1'b0,1'b0,1'b0,1'b0,1'b0,1'b0,1'b0,1'b0}),
        .gpio_io_o(axi_gpio_0_gpio_io_o),
        .s_axi_aclk(microblaze_0_Clk),
        .s_axi_araddr(microblaze_0_axi_periph_M00_AXI_ARADDR[8:0]),
        .s_axi_aresetn(rst_clk_wiz_1_100M_peripheral_aresetn),
        .s_axi_arready(microblaze_0_axi_periph_M00_AXI_ARREADY),
        .s_axi_arvalid(microblaze_0_axi_periph_M00_AXI_ARVALID),
        .s_axi_awaddr(microblaze_0_axi_periph_M00_AXI_AWADDR[8:0]),
        .s_axi_awready(microblaze_0_axi_periph_M00_AXI_AWREADY),
        .s_axi_awvalid(microblaze_0_axi_periph_M00_AXI_AWVALID),
        .s_axi_bready(microblaze_0_axi_periph_M00_AXI_BREADY),
        .s_axi_bresp(microblaze_0_axi_periph_M00_AXI_BRESP),
        .s_axi_bvalid(microblaze_0_axi_periph_M00_AXI_BVALID),
        .s_axi_rdata(microblaze_0_axi_periph_M00_AXI_RDATA),
        .s_axi_rready(microblaze_0_axi_periph_M00_AXI_RREADY),
        .s_axi_rresp(microblaze_0_axi_periph_M00_AXI_RRESP),
        .s_axi_rvalid(microblaze_0_axi_periph_M00_AXI_RVALID),
        .s_axi_wdata(microblaze_0_axi_periph_M00_AXI_WDATA),
        .s_axi_wready(microblaze_0_axi_periph_M00_AXI_WREADY),
        .s_axi_wstrb(microblaze_0_axi_periph_M00_AXI_WSTRB),
        .s_axi_wvalid(microblaze_0_axi_periph_M00_AXI_WVALID));
  MicroBlazeV2_axi_gpio_1_0 axi_gpio_SWITCHES
       (.gpio_io_i(gpio_io_i_0_1),
        .s_axi_aclk(microblaze_0_Clk),
        .s_axi_araddr(microblaze_0_axi_periph_M02_AXI_ARADDR[8:0]),
        .s_axi_aresetn(rst_clk_wiz_1_100M_peripheral_aresetn),
        .s_axi_arready(microblaze_0_axi_periph_M02_AXI_ARREADY),
        .s_axi_arvalid(microblaze_0_axi_periph_M02_AXI_ARVALID),
        .s_axi_awaddr(microblaze_0_axi_periph_M02_AXI_AWADDR[8:0]),
        .s_axi_awready(microblaze_0_axi_periph_M02_AXI_AWREADY),
        .s_axi_awvalid(microblaze_0_axi_periph_M02_AXI_AWVALID),
        .s_axi_bready(microblaze_0_axi_periph_M02_AXI_BREADY),
        .s_axi_bresp(microblaze_0_axi_periph_M02_AXI_BRESP),
        .s_axi_bvalid(microblaze_0_axi_periph_M02_AXI_BVALID),
        .s_axi_rdata(microblaze_0_axi_periph_M02_AXI_RDATA),
        .s_axi_rready(microblaze_0_axi_periph_M02_AXI_RREADY),
        .s_axi_rresp(microblaze_0_axi_periph_M02_AXI_RRESP),
        .s_axi_rvalid(microblaze_0_axi_periph_M02_AXI_RVALID),
        .s_axi_wdata(microblaze_0_axi_periph_M02_AXI_WDATA),
        .s_axi_wready(microblaze_0_axi_periph_M02_AXI_WREADY),
        .s_axi_wstrb(microblaze_0_axi_periph_M02_AXI_WSTRB),
        .s_axi_wvalid(microblaze_0_axi_periph_M02_AXI_WVALID));
  MicroBlazeV2_axi_uartlite_0_0 axi_uartlite_0
       (.rx(rx_0_1),
        .s_axi_aclk(microblaze_0_Clk),
        .s_axi_araddr(microblaze_0_axi_periph_M01_AXI_ARADDR[3:0]),
        .s_axi_aresetn(rst_clk_wiz_1_100M_peripheral_aresetn),
        .s_axi_arready(microblaze_0_axi_periph_M01_AXI_ARREADY),
        .s_axi_arvalid(microblaze_0_axi_periph_M01_AXI_ARVALID),
        .s_axi_awaddr(microblaze_0_axi_periph_M01_AXI_AWADDR[3:0]),
        .s_axi_awready(microblaze_0_axi_periph_M01_AXI_AWREADY),
        .s_axi_awvalid(microblaze_0_axi_periph_M01_AXI_AWVALID),
        .s_axi_bready(microblaze_0_axi_periph_M01_AXI_BREADY),
        .s_axi_bresp(microblaze_0_axi_periph_M01_AXI_BRESP),
        .s_axi_bvalid(microblaze_0_axi_periph_M01_AXI_BVALID),
        .s_axi_rdata(microblaze_0_axi_periph_M01_AXI_RDATA),
        .s_axi_rready(microblaze_0_axi_periph_M01_AXI_RREADY),
        .s_axi_rresp(microblaze_0_axi_periph_M01_AXI_RRESP),
        .s_axi_rvalid(microblaze_0_axi_periph_M01_AXI_RVALID),
        .s_axi_wdata(microblaze_0_axi_periph_M01_AXI_WDATA),
        .s_axi_wready(microblaze_0_axi_periph_M01_AXI_WREADY),
        .s_axi_wstrb(microblaze_0_axi_periph_M01_AXI_WSTRB),
        .s_axi_wvalid(microblaze_0_axi_periph_M01_AXI_WVALID),
        .tx(axi_uartlite_0_tx));
  MicroBlazeV2_mdm_1_0 mdm_1
       (.Dbg_Capture_0(microblaze_0_debug_CAPTURE),
        .Dbg_Clk_0(microblaze_0_debug_CLK),
        .Dbg_Disable_0(microblaze_0_debug_DISABLE),
        .Dbg_Reg_En_0(microblaze_0_debug_REG_EN),
        .Dbg_Rst_0(microblaze_0_debug_RST),
        .Dbg_Shift_0(microblaze_0_debug_SHIFT),
        .Dbg_TDI_0(microblaze_0_debug_TDI),
        .Dbg_TDO_0(microblaze_0_debug_TDO),
        .Dbg_Update_0(microblaze_0_debug_UPDATE),
        .Debug_SYS_Rst(mdm_1_debug_sys_rst));
  (* BMM_INFO_PROCESSOR = "microblaze-le > MicroBlazeV2 microblaze_0_local_memory/dlmb_bram_if_cntlr" *) 
  (* KEEP_HIERARCHY = "yes" *) 
  MicroBlazeV2_microblaze_0_0 microblaze_0
       (.Byte_Enable(microblaze_0_dlmb_1_BE),
        .Clk(microblaze_0_Clk),
        .DCE(microblaze_0_dlmb_1_CE),
        .DReady(microblaze_0_dlmb_1_READY),
        .DUE(microblaze_0_dlmb_1_UE),
        .DWait(microblaze_0_dlmb_1_WAIT),
        .D_AS(microblaze_0_dlmb_1_ADDRSTROBE),
        .Data_Addr(microblaze_0_dlmb_1_ABUS),
        .Data_Read(microblaze_0_dlmb_1_READDBUS),
        .Data_Write(microblaze_0_dlmb_1_WRITEDBUS),
        .Dbg_Capture(microblaze_0_debug_CAPTURE),
        .Dbg_Clk(microblaze_0_debug_CLK),
        .Dbg_Disable(microblaze_0_debug_DISABLE),
        .Dbg_Reg_En(microblaze_0_debug_REG_EN),
        .Dbg_Shift(microblaze_0_debug_SHIFT),
        .Dbg_TDI(microblaze_0_debug_TDI),
        .Dbg_TDO(microblaze_0_debug_TDO),
        .Dbg_Update(microblaze_0_debug_UPDATE),
        .Debug_Rst(microblaze_0_debug_RST),
        .ICE(microblaze_0_ilmb_1_CE),
        .IFetch(microblaze_0_ilmb_1_READSTROBE),
        .IReady(microblaze_0_ilmb_1_READY),
        .IUE(microblaze_0_ilmb_1_UE),
        .IWAIT(microblaze_0_ilmb_1_WAIT),
        .I_AS(microblaze_0_ilmb_1_ADDRSTROBE),
        .Instr(microblaze_0_ilmb_1_READDBUS),
        .Instr_Addr(microblaze_0_ilmb_1_ABUS),
        .Interrupt(1'b0),
        .Interrupt_Address({1'b0,1'b0,1'b0,1'b0,1'b0,1'b0,1'b0,1'b0,1'b0,1'b0,1'b0,1'b0,1'b0,1'b0,1'b0,1'b0,1'b0,1'b0,1'b0,1'b0,1'b0,1'b0,1'b0,1'b0,1'b0,1'b0,1'b0,1'b0,1'b0,1'b0,1'b0,1'b0}),
        .M_AXI_DP_ARADDR(microblaze_0_M_AXI_DP_ARADDR),
        .M_AXI_DP_ARPROT(microblaze_0_M_AXI_DP_ARPROT),
        .M_AXI_DP_ARREADY(microblaze_0_M_AXI_DP_ARREADY),
        .M_AXI_DP_ARVALID(microblaze_0_M_AXI_DP_ARVALID),
        .M_AXI_DP_AWADDR(microblaze_0_M_AXI_DP_AWADDR),
        .M_AXI_DP_AWPROT(microblaze_0_M_AXI_DP_AWPROT),
        .M_AXI_DP_AWREADY(microblaze_0_M_AXI_DP_AWREADY),
        .M_AXI_DP_AWVALID(microblaze_0_M_AXI_DP_AWVALID),
        .M_AXI_DP_BREADY(microblaze_0_M_AXI_DP_BREADY),
        .M_AXI_DP_BRESP(microblaze_0_M_AXI_DP_BRESP),
        .M_AXI_DP_BVALID(microblaze_0_M_AXI_DP_BVALID),
        .M_AXI_DP_RDATA(microblaze_0_M_AXI_DP_RDATA),
        .M_AXI_DP_RREADY(microblaze_0_M_AXI_DP_RREADY),
        .M_AXI_DP_RRESP(microblaze_0_M_AXI_DP_RRESP),
        .M_AXI_DP_RVALID(microblaze_0_M_AXI_DP_RVALID),
        .M_AXI_DP_WDATA(microblaze_0_M_AXI_DP_WDATA),
        .M_AXI_DP_WREADY(microblaze_0_M_AXI_DP_WREADY),
        .M_AXI_DP_WSTRB(microblaze_0_M_AXI_DP_WSTRB),
        .M_AXI_DP_WVALID(microblaze_0_M_AXI_DP_WVALID),
        .Read_Strobe(microblaze_0_dlmb_1_READSTROBE),
        .Reset(rst_clk_wiz_1_100M_mb_reset),
        .Write_Strobe(microblaze_0_dlmb_1_WRITESTROBE));
  MicroBlazeV2_microblaze_0_axi_periph_0 microblaze_0_axi_periph
       (.ACLK(microblaze_0_Clk),
        .ARESETN(rst_clk_wiz_1_100M_peripheral_aresetn),
        .M00_ACLK(microblaze_0_Clk),
        .M00_ARESETN(rst_clk_wiz_1_100M_peripheral_aresetn),
        .M00_AXI_araddr(microblaze_0_axi_periph_M00_AXI_ARADDR),
        .M00_AXI_arready(microblaze_0_axi_periph_M00_AXI_ARREADY),
        .M00_AXI_arvalid(microblaze_0_axi_periph_M00_AXI_ARVALID),
        .M00_AXI_awaddr(microblaze_0_axi_periph_M00_AXI_AWADDR),
        .M00_AXI_awready(microblaze_0_axi_periph_M00_AXI_AWREADY),
        .M00_AXI_awvalid(microblaze_0_axi_periph_M00_AXI_AWVALID),
        .M00_AXI_bready(microblaze_0_axi_periph_M00_AXI_BREADY),
        .M00_AXI_bresp(microblaze_0_axi_periph_M00_AXI_BRESP),
        .M00_AXI_bvalid(microblaze_0_axi_periph_M00_AXI_BVALID),
        .M00_AXI_rdata(microblaze_0_axi_periph_M00_AXI_RDATA),
        .M00_AXI_rready(microblaze_0_axi_periph_M00_AXI_RREADY),
        .M00_AXI_rresp(microblaze_0_axi_periph_M00_AXI_RRESP),
        .M00_AXI_rvalid(microblaze_0_axi_periph_M00_AXI_RVALID),
        .M00_AXI_wdata(microblaze_0_axi_periph_M00_AXI_WDATA),
        .M00_AXI_wready(microblaze_0_axi_periph_M00_AXI_WREADY),
        .M00_AXI_wstrb(microblaze_0_axi_periph_M00_AXI_WSTRB),
        .M00_AXI_wvalid(microblaze_0_axi_periph_M00_AXI_WVALID),
        .M01_ACLK(microblaze_0_Clk),
        .M01_ARESETN(rst_clk_wiz_1_100M_peripheral_aresetn),
        .M01_AXI_araddr(microblaze_0_axi_periph_M01_AXI_ARADDR),
        .M01_AXI_arready(microblaze_0_axi_periph_M01_AXI_ARREADY),
        .M01_AXI_arvalid(microblaze_0_axi_periph_M01_AXI_ARVALID),
        .M01_AXI_awaddr(microblaze_0_axi_periph_M01_AXI_AWADDR),
        .M01_AXI_awready(microblaze_0_axi_periph_M01_AXI_AWREADY),
        .M01_AXI_awvalid(microblaze_0_axi_periph_M01_AXI_AWVALID),
        .M01_AXI_bready(microblaze_0_axi_periph_M01_AXI_BREADY),
        .M01_AXI_bresp(microblaze_0_axi_periph_M01_AXI_BRESP),
        .M01_AXI_bvalid(microblaze_0_axi_periph_M01_AXI_BVALID),
        .M01_AXI_rdata(microblaze_0_axi_periph_M01_AXI_RDATA),
        .M01_AXI_rready(microblaze_0_axi_periph_M01_AXI_RREADY),
        .M01_AXI_rresp(microblaze_0_axi_periph_M01_AXI_RRESP),
        .M01_AXI_rvalid(microblaze_0_axi_periph_M01_AXI_RVALID),
        .M01_AXI_wdata(microblaze_0_axi_periph_M01_AXI_WDATA),
        .M01_AXI_wready(microblaze_0_axi_periph_M01_AXI_WREADY),
        .M01_AXI_wstrb(microblaze_0_axi_periph_M01_AXI_WSTRB),
        .M01_AXI_wvalid(microblaze_0_axi_periph_M01_AXI_WVALID),
        .M02_ACLK(microblaze_0_Clk),
        .M02_ARESETN(rst_clk_wiz_1_100M_peripheral_aresetn),
        .M02_AXI_araddr(microblaze_0_axi_periph_M02_AXI_ARADDR),
        .M02_AXI_arready(microblaze_0_axi_periph_M02_AXI_ARREADY),
        .M02_AXI_arvalid(microblaze_0_axi_periph_M02_AXI_ARVALID),
        .M02_AXI_awaddr(microblaze_0_axi_periph_M02_AXI_AWADDR),
        .M02_AXI_awready(microblaze_0_axi_periph_M02_AXI_AWREADY),
        .M02_AXI_awvalid(microblaze_0_axi_periph_M02_AXI_AWVALID),
        .M02_AXI_bready(microblaze_0_axi_periph_M02_AXI_BREADY),
        .M02_AXI_bresp(microblaze_0_axi_periph_M02_AXI_BRESP),
        .M02_AXI_bvalid(microblaze_0_axi_periph_M02_AXI_BVALID),
        .M02_AXI_rdata(microblaze_0_axi_periph_M02_AXI_RDATA),
        .M02_AXI_rready(microblaze_0_axi_periph_M02_AXI_RREADY),
        .M02_AXI_rresp(microblaze_0_axi_periph_M02_AXI_RRESP),
        .M02_AXI_rvalid(microblaze_0_axi_periph_M02_AXI_RVALID),
        .M02_AXI_wdata(microblaze_0_axi_periph_M02_AXI_WDATA),
        .M02_AXI_wready(microblaze_0_axi_periph_M02_AXI_WREADY),
        .M02_AXI_wstrb(microblaze_0_axi_periph_M02_AXI_WSTRB),
        .M02_AXI_wvalid(microblaze_0_axi_periph_M02_AXI_WVALID),
        .M03_ACLK(microblaze_0_Clk),
        .M03_ARESETN(rst_clk_wiz_1_100M_peripheral_aresetn),
        .M03_AXI_araddr(microblaze_0_axi_periph_M03_AXI_ARADDR),
        .M03_AXI_arready(microblaze_0_axi_periph_M03_AXI_ARREADY),
        .M03_AXI_arvalid(microblaze_0_axi_periph_M03_AXI_ARVALID),
        .M03_AXI_awaddr(microblaze_0_axi_periph_M03_AXI_AWADDR),
        .M03_AXI_awready(microblaze_0_axi_periph_M03_AXI_AWREADY),
        .M03_AXI_awvalid(microblaze_0_axi_periph_M03_AXI_AWVALID),
        .M03_AXI_bready(microblaze_0_axi_periph_M03_AXI_BREADY),
        .M03_AXI_bresp(microblaze_0_axi_periph_M03_AXI_BRESP),
        .M03_AXI_bvalid(microblaze_0_axi_periph_M03_AXI_BVALID),
        .M03_AXI_rdata(microblaze_0_axi_periph_M03_AXI_RDATA),
        .M03_AXI_rready(microblaze_0_axi_periph_M03_AXI_RREADY),
        .M03_AXI_rresp(microblaze_0_axi_periph_M03_AXI_RRESP),
        .M03_AXI_rvalid(microblaze_0_axi_periph_M03_AXI_RVALID),
        .M03_AXI_wdata(microblaze_0_axi_periph_M03_AXI_WDATA),
        .M03_AXI_wready(microblaze_0_axi_periph_M03_AXI_WREADY),
        .M03_AXI_wstrb(microblaze_0_axi_periph_M03_AXI_WSTRB),
        .M03_AXI_wvalid(microblaze_0_axi_periph_M03_AXI_WVALID),
        .M04_ACLK(microblaze_0_Clk),
        .M04_ARESETN(rst_clk_wiz_1_100M_peripheral_aresetn),
        .M04_AXI_araddr(microblaze_0_axi_periph_M04_AXI_ARADDR),
        .M04_AXI_arready(microblaze_0_axi_periph_M04_AXI_ARREADY),
        .M04_AXI_arvalid(microblaze_0_axi_periph_M04_AXI_ARVALID),
        .M04_AXI_awaddr(microblaze_0_axi_periph_M04_AXI_AWADDR),
        .M04_AXI_awready(microblaze_0_axi_periph_M04_AXI_AWREADY),
        .M04_AXI_awvalid(microblaze_0_axi_periph_M04_AXI_AWVALID),
        .M04_AXI_bready(microblaze_0_axi_periph_M04_AXI_BREADY),
        .M04_AXI_bresp(microblaze_0_axi_periph_M04_AXI_BRESP),
        .M04_AXI_bvalid(microblaze_0_axi_periph_M04_AXI_BVALID),
        .M04_AXI_rdata(microblaze_0_axi_periph_M04_AXI_RDATA),
        .M04_AXI_rready(microblaze_0_axi_periph_M04_AXI_RREADY),
        .M04_AXI_rresp(microblaze_0_axi_periph_M04_AXI_RRESP),
        .M04_AXI_rvalid(microblaze_0_axi_periph_M04_AXI_RVALID),
        .M04_AXI_wdata(microblaze_0_axi_periph_M04_AXI_WDATA),
        .M04_AXI_wready(microblaze_0_axi_periph_M04_AXI_WREADY),
        .M04_AXI_wstrb(microblaze_0_axi_periph_M04_AXI_WSTRB),
        .M04_AXI_wvalid(microblaze_0_axi_periph_M04_AXI_WVALID),
        .M05_ACLK(microblaze_0_Clk),
        .M05_ARESETN(rst_clk_wiz_1_100M_peripheral_aresetn),
        .M05_AXI_arready(1'b0),
        .M05_AXI_awready(1'b0),
        .M05_AXI_bresp(1'b0),
        .M05_AXI_bvalid(1'b0),
        .M05_AXI_rdata(1'b0),
        .M05_AXI_rresp(1'b0),
        .M05_AXI_rvalid(1'b0),
        .M05_AXI_wready(1'b0),
        .S00_ACLK(microblaze_0_Clk),
        .S00_ARESETN(rst_clk_wiz_1_100M_peripheral_aresetn),
        .S00_AXI_araddr(microblaze_0_M_AXI_DP_ARADDR),
        .S00_AXI_arprot(microblaze_0_M_AXI_DP_ARPROT),
        .S00_AXI_arready(microblaze_0_M_AXI_DP_ARREADY),
        .S00_AXI_arvalid(microblaze_0_M_AXI_DP_ARVALID),
        .S00_AXI_awaddr(microblaze_0_M_AXI_DP_AWADDR),
        .S00_AXI_awprot(microblaze_0_M_AXI_DP_AWPROT),
        .S00_AXI_awready(microblaze_0_M_AXI_DP_AWREADY),
        .S00_AXI_awvalid(microblaze_0_M_AXI_DP_AWVALID),
        .S00_AXI_bready(microblaze_0_M_AXI_DP_BREADY),
        .S00_AXI_bresp(microblaze_0_M_AXI_DP_BRESP),
        .S00_AXI_bvalid(microblaze_0_M_AXI_DP_BVALID),
        .S00_AXI_rdata(microblaze_0_M_AXI_DP_RDATA),
        .S00_AXI_rready(microblaze_0_M_AXI_DP_RREADY),
        .S00_AXI_rresp(microblaze_0_M_AXI_DP_RRESP),
        .S00_AXI_rvalid(microblaze_0_M_AXI_DP_RVALID),
        .S00_AXI_wdata(microblaze_0_M_AXI_DP_WDATA),
        .S00_AXI_wready(microblaze_0_M_AXI_DP_WREADY),
        .S00_AXI_wstrb(microblaze_0_M_AXI_DP_WSTRB),
        .S00_AXI_wvalid(microblaze_0_M_AXI_DP_WVALID));
  microblaze_0_local_memory_imp_9MKBRA microblaze_0_local_memory
       (.DLMB_abus(microblaze_0_dlmb_1_ABUS),
        .DLMB_addrstrobe(microblaze_0_dlmb_1_ADDRSTROBE),
        .DLMB_be(microblaze_0_dlmb_1_BE),
        .DLMB_ce(microblaze_0_dlmb_1_CE),
        .DLMB_readdbus(microblaze_0_dlmb_1_READDBUS),
        .DLMB_readstrobe(microblaze_0_dlmb_1_READSTROBE),
        .DLMB_ready(microblaze_0_dlmb_1_READY),
        .DLMB_ue(microblaze_0_dlmb_1_UE),
        .DLMB_wait(microblaze_0_dlmb_1_WAIT),
        .DLMB_writedbus(microblaze_0_dlmb_1_WRITEDBUS),
        .DLMB_writestrobe(microblaze_0_dlmb_1_WRITESTROBE),
        .ILMB_abus(microblaze_0_ilmb_1_ABUS),
        .ILMB_addrstrobe(microblaze_0_ilmb_1_ADDRSTROBE),
        .ILMB_ce(microblaze_0_ilmb_1_CE),
        .ILMB_readdbus(microblaze_0_ilmb_1_READDBUS),
        .ILMB_readstrobe(microblaze_0_ilmb_1_READSTROBE),
        .ILMB_ready(microblaze_0_ilmb_1_READY),
        .ILMB_ue(microblaze_0_ilmb_1_UE),
        .ILMB_wait(microblaze_0_ilmb_1_WAIT),
        .LMB_Clk(microblaze_0_Clk),
        .SYS_Rst(rst_clk_wiz_1_100M_bus_struct_reset));
  MicroBlazeV2_rst_clk_wiz_1_100M_0 rst_clk_wiz_1_100M
       (.aux_reset_in(1'b1),
        .bus_struct_reset(rst_clk_wiz_1_100M_bus_struct_reset),
        .dcm_locked(1'b1),
        .ext_reset_in(reset_rtl_0_1),
        .mb_debug_sys_rst(mdm_1_debug_sys_rst),
        .mb_reset(rst_clk_wiz_1_100M_mb_reset),
        .peripheral_aresetn(rst_clk_wiz_1_100M_peripheral_aresetn),
        .slowest_sync_clk(microblaze_0_Clk));
endmodule

module MicroBlazeV2_microblaze_0_axi_periph_0
   (ACLK,
    ARESETN,
    M00_ACLK,
    M00_ARESETN,
    M00_AXI_araddr,
    M00_AXI_arready,
    M00_AXI_arvalid,
    M00_AXI_awaddr,
    M00_AXI_awready,
    M00_AXI_awvalid,
    M00_AXI_bready,
    M00_AXI_bresp,
    M00_AXI_bvalid,
    M00_AXI_rdata,
    M00_AXI_rready,
    M00_AXI_rresp,
    M00_AXI_rvalid,
    M00_AXI_wdata,
    M00_AXI_wready,
    M00_AXI_wstrb,
    M00_AXI_wvalid,
    M01_ACLK,
    M01_ARESETN,
    M01_AXI_araddr,
    M01_AXI_arready,
    M01_AXI_arvalid,
    M01_AXI_awaddr,
    M01_AXI_awready,
    M01_AXI_awvalid,
    M01_AXI_bready,
    M01_AXI_bresp,
    M01_AXI_bvalid,
    M01_AXI_rdata,
    M01_AXI_rready,
    M01_AXI_rresp,
    M01_AXI_rvalid,
    M01_AXI_wdata,
    M01_AXI_wready,
    M01_AXI_wstrb,
    M01_AXI_wvalid,
    M02_ACLK,
    M02_ARESETN,
    M02_AXI_araddr,
    M02_AXI_arready,
    M02_AXI_arvalid,
    M02_AXI_awaddr,
    M02_AXI_awready,
    M02_AXI_awvalid,
    M02_AXI_bready,
    M02_AXI_bresp,
    M02_AXI_bvalid,
    M02_AXI_rdata,
    M02_AXI_rready,
    M02_AXI_rresp,
    M02_AXI_rvalid,
    M02_AXI_wdata,
    M02_AXI_wready,
    M02_AXI_wstrb,
    M02_AXI_wvalid,
    M03_ACLK,
    M03_ARESETN,
    M03_AXI_araddr,
    M03_AXI_arready,
    M03_AXI_arvalid,
    M03_AXI_awaddr,
    M03_AXI_awready,
    M03_AXI_awvalid,
    M03_AXI_bready,
    M03_AXI_bresp,
    M03_AXI_bvalid,
    M03_AXI_rdata,
    M03_AXI_rready,
    M03_AXI_rresp,
    M03_AXI_rvalid,
    M03_AXI_wdata,
    M03_AXI_wready,
    M03_AXI_wstrb,
    M03_AXI_wvalid,
    M04_ACLK,
    M04_ARESETN,
    M04_AXI_araddr,
    M04_AXI_arready,
    M04_AXI_arvalid,
    M04_AXI_awaddr,
    M04_AXI_awready,
    M04_AXI_awvalid,
    M04_AXI_bready,
    M04_AXI_bresp,
    M04_AXI_bvalid,
    M04_AXI_rdata,
    M04_AXI_rready,
    M04_AXI_rresp,
    M04_AXI_rvalid,
    M04_AXI_wdata,
    M04_AXI_wready,
    M04_AXI_wstrb,
    M04_AXI_wvalid,
    M05_ACLK,
    M05_ARESETN,
    M05_AXI_araddr,
    M05_AXI_arprot,
    M05_AXI_arready,
    M05_AXI_arvalid,
    M05_AXI_awaddr,
    M05_AXI_awprot,
    M05_AXI_awready,
    M05_AXI_awvalid,
    M05_AXI_bready,
    M05_AXI_bresp,
    M05_AXI_bvalid,
    M05_AXI_rdata,
    M05_AXI_rready,
    M05_AXI_rresp,
    M05_AXI_rvalid,
    M05_AXI_wdata,
    M05_AXI_wready,
    M05_AXI_wstrb,
    M05_AXI_wvalid,
    S00_ACLK,
    S00_ARESETN,
    S00_AXI_araddr,
    S00_AXI_arprot,
    S00_AXI_arready,
    S00_AXI_arvalid,
    S00_AXI_awaddr,
    S00_AXI_awprot,
    S00_AXI_awready,
    S00_AXI_awvalid,
    S00_AXI_bready,
    S00_AXI_bresp,
    S00_AXI_bvalid,
    S00_AXI_rdata,
    S00_AXI_rready,
    S00_AXI_rresp,
    S00_AXI_rvalid,
    S00_AXI_wdata,
    S00_AXI_wready,
    S00_AXI_wstrb,
    S00_AXI_wvalid);
  input ACLK;
  input ARESETN;
  input M00_ACLK;
  input M00_ARESETN;
  output [31:0]M00_AXI_araddr;
  input [0:0]M00_AXI_arready;
  output [0:0]M00_AXI_arvalid;
  output [31:0]M00_AXI_awaddr;
  input [0:0]M00_AXI_awready;
  output [0:0]M00_AXI_awvalid;
  output [0:0]M00_AXI_bready;
  input [1:0]M00_AXI_bresp;
  input [0:0]M00_AXI_bvalid;
  input [31:0]M00_AXI_rdata;
  output [0:0]M00_AXI_rready;
  input [1:0]M00_AXI_rresp;
  input [0:0]M00_AXI_rvalid;
  output [31:0]M00_AXI_wdata;
  input [0:0]M00_AXI_wready;
  output [3:0]M00_AXI_wstrb;
  output [0:0]M00_AXI_wvalid;
  input M01_ACLK;
  input M01_ARESETN;
  output [31:0]M01_AXI_araddr;
  input M01_AXI_arready;
  output M01_AXI_arvalid;
  output [31:0]M01_AXI_awaddr;
  input M01_AXI_awready;
  output M01_AXI_awvalid;
  output M01_AXI_bready;
  input [1:0]M01_AXI_bresp;
  input M01_AXI_bvalid;
  input [31:0]M01_AXI_rdata;
  output M01_AXI_rready;
  input [1:0]M01_AXI_rresp;
  input M01_AXI_rvalid;
  output [31:0]M01_AXI_wdata;
  input M01_AXI_wready;
  output [3:0]M01_AXI_wstrb;
  output M01_AXI_wvalid;
  input M02_ACLK;
  input M02_ARESETN;
  output [31:0]M02_AXI_araddr;
  input M02_AXI_arready;
  output M02_AXI_arvalid;
  output [31:0]M02_AXI_awaddr;
  input M02_AXI_awready;
  output M02_AXI_awvalid;
  output M02_AXI_bready;
  input [1:0]M02_AXI_bresp;
  input M02_AXI_bvalid;
  input [31:0]M02_AXI_rdata;
  output M02_AXI_rready;
  input [1:0]M02_AXI_rresp;
  input M02_AXI_rvalid;
  output [31:0]M02_AXI_wdata;
  input M02_AXI_wready;
  output [3:0]M02_AXI_wstrb;
  output M02_AXI_wvalid;
  input M03_ACLK;
  input M03_ARESETN;
  output [31:0]M03_AXI_araddr;
  input M03_AXI_arready;
  output M03_AXI_arvalid;
  output [31:0]M03_AXI_awaddr;
  input M03_AXI_awready;
  output M03_AXI_awvalid;
  output M03_AXI_bready;
  input [1:0]M03_AXI_bresp;
  input M03_AXI_bvalid;
  input [31:0]M03_AXI_rdata;
  output M03_AXI_rready;
  input [1:0]M03_AXI_rresp;
  input M03_AXI_rvalid;
  output [31:0]M03_AXI_wdata;
  input M03_AXI_wready;
  output [3:0]M03_AXI_wstrb;
  output M03_AXI_wvalid;
  input M04_ACLK;
  input M04_ARESETN;
  output [31:0]M04_AXI_araddr;
  input M04_AXI_arready;
  output M04_AXI_arvalid;
  output [31:0]M04_AXI_awaddr;
  input M04_AXI_awready;
  output M04_AXI_awvalid;
  output M04_AXI_bready;
  input [1:0]M04_AXI_bresp;
  input M04_AXI_bvalid;
  input [31:0]M04_AXI_rdata;
  output M04_AXI_rready;
  input [1:0]M04_AXI_rresp;
  input M04_AXI_rvalid;
  output [31:0]M04_AXI_wdata;
  input M04_AXI_wready;
  output [3:0]M04_AXI_wstrb;
  output M04_AXI_wvalid;
  input M05_ACLK;
  input M05_ARESETN;
  output M05_AXI_araddr;
  output M05_AXI_arprot;
  input M05_AXI_arready;
  output M05_AXI_arvalid;
  output M05_AXI_awaddr;
  output M05_AXI_awprot;
  input M05_AXI_awready;
  output M05_AXI_awvalid;
  output M05_AXI_bready;
  input M05_AXI_bresp;
  input M05_AXI_bvalid;
  input M05_AXI_rdata;
  output M05_AXI_rready;
  input M05_AXI_rresp;
  input M05_AXI_rvalid;
  output M05_AXI_wdata;
  input M05_AXI_wready;
  output M05_AXI_wstrb;
  output M05_AXI_wvalid;
  input S00_ACLK;
  input S00_ARESETN;
  input [31:0]S00_AXI_araddr;
  input [2:0]S00_AXI_arprot;
  output [0:0]S00_AXI_arready;
  input [0:0]S00_AXI_arvalid;
  input [31:0]S00_AXI_awaddr;
  input [2:0]S00_AXI_awprot;
  output [0:0]S00_AXI_awready;
  input [0:0]S00_AXI_awvalid;
  input [0:0]S00_AXI_bready;
  output [1:0]S00_AXI_bresp;
  output [0:0]S00_AXI_bvalid;
  output [31:0]S00_AXI_rdata;
  input [0:0]S00_AXI_rready;
  output [1:0]S00_AXI_rresp;
  output [0:0]S00_AXI_rvalid;
  input [31:0]S00_AXI_wdata;
  output [0:0]S00_AXI_wready;
  input [3:0]S00_AXI_wstrb;
  input [0:0]S00_AXI_wvalid;

  wire [31:0]m00_couplers_to_microblaze_0_axi_periph_ARADDR;
  wire [0:0]m00_couplers_to_microblaze_0_axi_periph_ARREADY;
  wire [0:0]m00_couplers_to_microblaze_0_axi_periph_ARVALID;
  wire [31:0]m00_couplers_to_microblaze_0_axi_periph_AWADDR;
  wire [0:0]m00_couplers_to_microblaze_0_axi_periph_AWREADY;
  wire [0:0]m00_couplers_to_microblaze_0_axi_periph_AWVALID;
  wire [0:0]m00_couplers_to_microblaze_0_axi_periph_BREADY;
  wire [1:0]m00_couplers_to_microblaze_0_axi_periph_BRESP;
  wire [0:0]m00_couplers_to_microblaze_0_axi_periph_BVALID;
  wire [31:0]m00_couplers_to_microblaze_0_axi_periph_RDATA;
  wire [0:0]m00_couplers_to_microblaze_0_axi_periph_RREADY;
  wire [1:0]m00_couplers_to_microblaze_0_axi_periph_RRESP;
  wire [0:0]m00_couplers_to_microblaze_0_axi_periph_RVALID;
  wire [31:0]m00_couplers_to_microblaze_0_axi_periph_WDATA;
  wire [0:0]m00_couplers_to_microblaze_0_axi_periph_WREADY;
  wire [3:0]m00_couplers_to_microblaze_0_axi_periph_WSTRB;
  wire [0:0]m00_couplers_to_microblaze_0_axi_periph_WVALID;
  wire [31:0]m01_couplers_to_microblaze_0_axi_periph_ARADDR;
  wire m01_couplers_to_microblaze_0_axi_periph_ARREADY;
  wire m01_couplers_to_microblaze_0_axi_periph_ARVALID;
  wire [31:0]m01_couplers_to_microblaze_0_axi_periph_AWADDR;
  wire m01_couplers_to_microblaze_0_axi_periph_AWREADY;
  wire m01_couplers_to_microblaze_0_axi_periph_AWVALID;
  wire m01_couplers_to_microblaze_0_axi_periph_BREADY;
  wire [1:0]m01_couplers_to_microblaze_0_axi_periph_BRESP;
  wire m01_couplers_to_microblaze_0_axi_periph_BVALID;
  wire [31:0]m01_couplers_to_microblaze_0_axi_periph_RDATA;
  wire m01_couplers_to_microblaze_0_axi_periph_RREADY;
  wire [1:0]m01_couplers_to_microblaze_0_axi_periph_RRESP;
  wire m01_couplers_to_microblaze_0_axi_periph_RVALID;
  wire [31:0]m01_couplers_to_microblaze_0_axi_periph_WDATA;
  wire m01_couplers_to_microblaze_0_axi_periph_WREADY;
  wire [3:0]m01_couplers_to_microblaze_0_axi_periph_WSTRB;
  wire m01_couplers_to_microblaze_0_axi_periph_WVALID;
  wire [31:0]m02_couplers_to_microblaze_0_axi_periph_ARADDR;
  wire m02_couplers_to_microblaze_0_axi_periph_ARREADY;
  wire m02_couplers_to_microblaze_0_axi_periph_ARVALID;
  wire [31:0]m02_couplers_to_microblaze_0_axi_periph_AWADDR;
  wire m02_couplers_to_microblaze_0_axi_periph_AWREADY;
  wire m02_couplers_to_microblaze_0_axi_periph_AWVALID;
  wire m02_couplers_to_microblaze_0_axi_periph_BREADY;
  wire [1:0]m02_couplers_to_microblaze_0_axi_periph_BRESP;
  wire m02_couplers_to_microblaze_0_axi_periph_BVALID;
  wire [31:0]m02_couplers_to_microblaze_0_axi_periph_RDATA;
  wire m02_couplers_to_microblaze_0_axi_periph_RREADY;
  wire [1:0]m02_couplers_to_microblaze_0_axi_periph_RRESP;
  wire m02_couplers_to_microblaze_0_axi_periph_RVALID;
  wire [31:0]m02_couplers_to_microblaze_0_axi_periph_WDATA;
  wire m02_couplers_to_microblaze_0_axi_periph_WREADY;
  wire [3:0]m02_couplers_to_microblaze_0_axi_periph_WSTRB;
  wire m02_couplers_to_microblaze_0_axi_periph_WVALID;
  wire [31:0]m03_couplers_to_microblaze_0_axi_periph_ARADDR;
  wire m03_couplers_to_microblaze_0_axi_periph_ARREADY;
  wire m03_couplers_to_microblaze_0_axi_periph_ARVALID;
  wire [31:0]m03_couplers_to_microblaze_0_axi_periph_AWADDR;
  wire m03_couplers_to_microblaze_0_axi_periph_AWREADY;
  wire m03_couplers_to_microblaze_0_axi_periph_AWVALID;
  wire m03_couplers_to_microblaze_0_axi_periph_BREADY;
  wire [1:0]m03_couplers_to_microblaze_0_axi_periph_BRESP;
  wire m03_couplers_to_microblaze_0_axi_periph_BVALID;
  wire [31:0]m03_couplers_to_microblaze_0_axi_periph_RDATA;
  wire m03_couplers_to_microblaze_0_axi_periph_RREADY;
  wire [1:0]m03_couplers_to_microblaze_0_axi_periph_RRESP;
  wire m03_couplers_to_microblaze_0_axi_periph_RVALID;
  wire [31:0]m03_couplers_to_microblaze_0_axi_periph_WDATA;
  wire m03_couplers_to_microblaze_0_axi_periph_WREADY;
  wire [3:0]m03_couplers_to_microblaze_0_axi_periph_WSTRB;
  wire m03_couplers_to_microblaze_0_axi_periph_WVALID;
  wire [31:0]m04_couplers_to_microblaze_0_axi_periph_ARADDR;
  wire m04_couplers_to_microblaze_0_axi_periph_ARREADY;
  wire m04_couplers_to_microblaze_0_axi_periph_ARVALID;
  wire [31:0]m04_couplers_to_microblaze_0_axi_periph_AWADDR;
  wire m04_couplers_to_microblaze_0_axi_periph_AWREADY;
  wire m04_couplers_to_microblaze_0_axi_periph_AWVALID;
  wire m04_couplers_to_microblaze_0_axi_periph_BREADY;
  wire [1:0]m04_couplers_to_microblaze_0_axi_periph_BRESP;
  wire m04_couplers_to_microblaze_0_axi_periph_BVALID;
  wire [31:0]m04_couplers_to_microblaze_0_axi_periph_RDATA;
  wire m04_couplers_to_microblaze_0_axi_periph_RREADY;
  wire [1:0]m04_couplers_to_microblaze_0_axi_periph_RRESP;
  wire m04_couplers_to_microblaze_0_axi_periph_RVALID;
  wire [31:0]m04_couplers_to_microblaze_0_axi_periph_WDATA;
  wire m04_couplers_to_microblaze_0_axi_periph_WREADY;
  wire [3:0]m04_couplers_to_microblaze_0_axi_periph_WSTRB;
  wire m04_couplers_to_microblaze_0_axi_periph_WVALID;
  wire m05_couplers_to_microblaze_0_axi_periph_ARADDR;
  wire m05_couplers_to_microblaze_0_axi_periph_ARPROT;
  wire m05_couplers_to_microblaze_0_axi_periph_ARREADY;
  wire m05_couplers_to_microblaze_0_axi_periph_ARVALID;
  wire m05_couplers_to_microblaze_0_axi_periph_AWADDR;
  wire m05_couplers_to_microblaze_0_axi_periph_AWPROT;
  wire m05_couplers_to_microblaze_0_axi_periph_AWREADY;
  wire m05_couplers_to_microblaze_0_axi_periph_AWVALID;
  wire m05_couplers_to_microblaze_0_axi_periph_BREADY;
  wire m05_couplers_to_microblaze_0_axi_periph_BRESP;
  wire m05_couplers_to_microblaze_0_axi_periph_BVALID;
  wire m05_couplers_to_microblaze_0_axi_periph_RDATA;
  wire m05_couplers_to_microblaze_0_axi_periph_RREADY;
  wire m05_couplers_to_microblaze_0_axi_periph_RRESP;
  wire m05_couplers_to_microblaze_0_axi_periph_RVALID;
  wire m05_couplers_to_microblaze_0_axi_periph_WDATA;
  wire m05_couplers_to_microblaze_0_axi_periph_WREADY;
  wire m05_couplers_to_microblaze_0_axi_periph_WSTRB;
  wire m05_couplers_to_microblaze_0_axi_periph_WVALID;
  wire microblaze_0_axi_periph_ACLK_net;
  wire microblaze_0_axi_periph_ARESETN_net;
  wire [31:0]microblaze_0_axi_periph_to_s00_couplers_ARADDR;
  wire [2:0]microblaze_0_axi_periph_to_s00_couplers_ARPROT;
  wire [0:0]microblaze_0_axi_periph_to_s00_couplers_ARREADY;
  wire [0:0]microblaze_0_axi_periph_to_s00_couplers_ARVALID;
  wire [31:0]microblaze_0_axi_periph_to_s00_couplers_AWADDR;
  wire [2:0]microblaze_0_axi_periph_to_s00_couplers_AWPROT;
  wire [0:0]microblaze_0_axi_periph_to_s00_couplers_AWREADY;
  wire [0:0]microblaze_0_axi_periph_to_s00_couplers_AWVALID;
  wire [0:0]microblaze_0_axi_periph_to_s00_couplers_BREADY;
  wire [1:0]microblaze_0_axi_periph_to_s00_couplers_BRESP;
  wire [0:0]microblaze_0_axi_periph_to_s00_couplers_BVALID;
  wire [31:0]microblaze_0_axi_periph_to_s00_couplers_RDATA;
  wire [0:0]microblaze_0_axi_periph_to_s00_couplers_RREADY;
  wire [1:0]microblaze_0_axi_periph_to_s00_couplers_RRESP;
  wire [0:0]microblaze_0_axi_periph_to_s00_couplers_RVALID;
  wire [31:0]microblaze_0_axi_periph_to_s00_couplers_WDATA;
  wire [0:0]microblaze_0_axi_periph_to_s00_couplers_WREADY;
  wire [3:0]microblaze_0_axi_periph_to_s00_couplers_WSTRB;
  wire [0:0]microblaze_0_axi_periph_to_s00_couplers_WVALID;
  wire [31:0]s00_couplers_to_xbar_ARADDR;
  wire [2:0]s00_couplers_to_xbar_ARPROT;
  wire [0:0]s00_couplers_to_xbar_ARREADY;
  wire [0:0]s00_couplers_to_xbar_ARVALID;
  wire [31:0]s00_couplers_to_xbar_AWADDR;
  wire [2:0]s00_couplers_to_xbar_AWPROT;
  wire [0:0]s00_couplers_to_xbar_AWREADY;
  wire [0:0]s00_couplers_to_xbar_AWVALID;
  wire [0:0]s00_couplers_to_xbar_BREADY;
  wire [1:0]s00_couplers_to_xbar_BRESP;
  wire [0:0]s00_couplers_to_xbar_BVALID;
  wire [31:0]s00_couplers_to_xbar_RDATA;
  wire [0:0]s00_couplers_to_xbar_RREADY;
  wire [1:0]s00_couplers_to_xbar_RRESP;
  wire [0:0]s00_couplers_to_xbar_RVALID;
  wire [31:0]s00_couplers_to_xbar_WDATA;
  wire [0:0]s00_couplers_to_xbar_WREADY;
  wire [3:0]s00_couplers_to_xbar_WSTRB;
  wire [0:0]s00_couplers_to_xbar_WVALID;
  wire [31:0]xbar_to_m00_couplers_ARADDR;
  wire [0:0]xbar_to_m00_couplers_ARREADY;
  wire [0:0]xbar_to_m00_couplers_ARVALID;
  wire [31:0]xbar_to_m00_couplers_AWADDR;
  wire [0:0]xbar_to_m00_couplers_AWREADY;
  wire [0:0]xbar_to_m00_couplers_AWVALID;
  wire [0:0]xbar_to_m00_couplers_BREADY;
  wire [1:0]xbar_to_m00_couplers_BRESP;
  wire [0:0]xbar_to_m00_couplers_BVALID;
  wire [31:0]xbar_to_m00_couplers_RDATA;
  wire [0:0]xbar_to_m00_couplers_RREADY;
  wire [1:0]xbar_to_m00_couplers_RRESP;
  wire [0:0]xbar_to_m00_couplers_RVALID;
  wire [31:0]xbar_to_m00_couplers_WDATA;
  wire [0:0]xbar_to_m00_couplers_WREADY;
  wire [3:0]xbar_to_m00_couplers_WSTRB;
  wire [0:0]xbar_to_m00_couplers_WVALID;
  wire [63:32]xbar_to_m01_couplers_ARADDR;
  wire xbar_to_m01_couplers_ARREADY;
  wire [1:1]xbar_to_m01_couplers_ARVALID;
  wire [63:32]xbar_to_m01_couplers_AWADDR;
  wire xbar_to_m01_couplers_AWREADY;
  wire [1:1]xbar_to_m01_couplers_AWVALID;
  wire [1:1]xbar_to_m01_couplers_BREADY;
  wire [1:0]xbar_to_m01_couplers_BRESP;
  wire xbar_to_m01_couplers_BVALID;
  wire [31:0]xbar_to_m01_couplers_RDATA;
  wire [1:1]xbar_to_m01_couplers_RREADY;
  wire [1:0]xbar_to_m01_couplers_RRESP;
  wire xbar_to_m01_couplers_RVALID;
  wire [63:32]xbar_to_m01_couplers_WDATA;
  wire xbar_to_m01_couplers_WREADY;
  wire [7:4]xbar_to_m01_couplers_WSTRB;
  wire [1:1]xbar_to_m01_couplers_WVALID;
  wire [95:64]xbar_to_m02_couplers_ARADDR;
  wire xbar_to_m02_couplers_ARREADY;
  wire [2:2]xbar_to_m02_couplers_ARVALID;
  wire [95:64]xbar_to_m02_couplers_AWADDR;
  wire xbar_to_m02_couplers_AWREADY;
  wire [2:2]xbar_to_m02_couplers_AWVALID;
  wire [2:2]xbar_to_m02_couplers_BREADY;
  wire [1:0]xbar_to_m02_couplers_BRESP;
  wire xbar_to_m02_couplers_BVALID;
  wire [31:0]xbar_to_m02_couplers_RDATA;
  wire [2:2]xbar_to_m02_couplers_RREADY;
  wire [1:0]xbar_to_m02_couplers_RRESP;
  wire xbar_to_m02_couplers_RVALID;
  wire [95:64]xbar_to_m02_couplers_WDATA;
  wire xbar_to_m02_couplers_WREADY;
  wire [11:8]xbar_to_m02_couplers_WSTRB;
  wire [2:2]xbar_to_m02_couplers_WVALID;
  wire [127:96]xbar_to_m03_couplers_ARADDR;
  wire xbar_to_m03_couplers_ARREADY;
  wire [3:3]xbar_to_m03_couplers_ARVALID;
  wire [127:96]xbar_to_m03_couplers_AWADDR;
  wire xbar_to_m03_couplers_AWREADY;
  wire [3:3]xbar_to_m03_couplers_AWVALID;
  wire [3:3]xbar_to_m03_couplers_BREADY;
  wire [1:0]xbar_to_m03_couplers_BRESP;
  wire xbar_to_m03_couplers_BVALID;
  wire [31:0]xbar_to_m03_couplers_RDATA;
  wire [3:3]xbar_to_m03_couplers_RREADY;
  wire [1:0]xbar_to_m03_couplers_RRESP;
  wire xbar_to_m03_couplers_RVALID;
  wire [127:96]xbar_to_m03_couplers_WDATA;
  wire xbar_to_m03_couplers_WREADY;
  wire [15:12]xbar_to_m03_couplers_WSTRB;
  wire [3:3]xbar_to_m03_couplers_WVALID;
  wire [159:128]xbar_to_m04_couplers_ARADDR;
  wire xbar_to_m04_couplers_ARREADY;
  wire [4:4]xbar_to_m04_couplers_ARVALID;
  wire [159:128]xbar_to_m04_couplers_AWADDR;
  wire xbar_to_m04_couplers_AWREADY;
  wire [4:4]xbar_to_m04_couplers_AWVALID;
  wire [4:4]xbar_to_m04_couplers_BREADY;
  wire [1:0]xbar_to_m04_couplers_BRESP;
  wire xbar_to_m04_couplers_BVALID;
  wire [31:0]xbar_to_m04_couplers_RDATA;
  wire [4:4]xbar_to_m04_couplers_RREADY;
  wire [1:0]xbar_to_m04_couplers_RRESP;
  wire xbar_to_m04_couplers_RVALID;
  wire [159:128]xbar_to_m04_couplers_WDATA;
  wire xbar_to_m04_couplers_WREADY;
  wire [19:16]xbar_to_m04_couplers_WSTRB;
  wire [4:4]xbar_to_m04_couplers_WVALID;
  wire [191:160]xbar_to_m05_couplers_ARADDR;
  wire [17:15]xbar_to_m05_couplers_ARPROT;
  wire xbar_to_m05_couplers_ARREADY;
  wire [5:5]xbar_to_m05_couplers_ARVALID;
  wire [191:160]xbar_to_m05_couplers_AWADDR;
  wire [17:15]xbar_to_m05_couplers_AWPROT;
  wire xbar_to_m05_couplers_AWREADY;
  wire [5:5]xbar_to_m05_couplers_AWVALID;
  wire [5:5]xbar_to_m05_couplers_BREADY;
  wire xbar_to_m05_couplers_BRESP;
  wire xbar_to_m05_couplers_BVALID;
  wire xbar_to_m05_couplers_RDATA;
  wire [5:5]xbar_to_m05_couplers_RREADY;
  wire xbar_to_m05_couplers_RRESP;
  wire xbar_to_m05_couplers_RVALID;
  wire [191:160]xbar_to_m05_couplers_WDATA;
  wire xbar_to_m05_couplers_WREADY;
  wire [23:20]xbar_to_m05_couplers_WSTRB;
  wire [5:5]xbar_to_m05_couplers_WVALID;
  wire [17:0]NLW_xbar_m_axi_arprot_UNCONNECTED;
  wire [17:0]NLW_xbar_m_axi_awprot_UNCONNECTED;

  assign M00_AXI_araddr[31:0] = m00_couplers_to_microblaze_0_axi_periph_ARADDR;
  assign M00_AXI_arvalid[0] = m00_couplers_to_microblaze_0_axi_periph_ARVALID;
  assign M00_AXI_awaddr[31:0] = m00_couplers_to_microblaze_0_axi_periph_AWADDR;
  assign M00_AXI_awvalid[0] = m00_couplers_to_microblaze_0_axi_periph_AWVALID;
  assign M00_AXI_bready[0] = m00_couplers_to_microblaze_0_axi_periph_BREADY;
  assign M00_AXI_rready[0] = m00_couplers_to_microblaze_0_axi_periph_RREADY;
  assign M00_AXI_wdata[31:0] = m00_couplers_to_microblaze_0_axi_periph_WDATA;
  assign M00_AXI_wstrb[3:0] = m00_couplers_to_microblaze_0_axi_periph_WSTRB;
  assign M00_AXI_wvalid[0] = m00_couplers_to_microblaze_0_axi_periph_WVALID;
  assign M01_AXI_araddr[31:0] = m01_couplers_to_microblaze_0_axi_periph_ARADDR;
  assign M01_AXI_arvalid = m01_couplers_to_microblaze_0_axi_periph_ARVALID;
  assign M01_AXI_awaddr[31:0] = m01_couplers_to_microblaze_0_axi_periph_AWADDR;
  assign M01_AXI_awvalid = m01_couplers_to_microblaze_0_axi_periph_AWVALID;
  assign M01_AXI_bready = m01_couplers_to_microblaze_0_axi_periph_BREADY;
  assign M01_AXI_rready = m01_couplers_to_microblaze_0_axi_periph_RREADY;
  assign M01_AXI_wdata[31:0] = m01_couplers_to_microblaze_0_axi_periph_WDATA;
  assign M01_AXI_wstrb[3:0] = m01_couplers_to_microblaze_0_axi_periph_WSTRB;
  assign M01_AXI_wvalid = m01_couplers_to_microblaze_0_axi_periph_WVALID;
  assign M02_AXI_araddr[31:0] = m02_couplers_to_microblaze_0_axi_periph_ARADDR;
  assign M02_AXI_arvalid = m02_couplers_to_microblaze_0_axi_periph_ARVALID;
  assign M02_AXI_awaddr[31:0] = m02_couplers_to_microblaze_0_axi_periph_AWADDR;
  assign M02_AXI_awvalid = m02_couplers_to_microblaze_0_axi_periph_AWVALID;
  assign M02_AXI_bready = m02_couplers_to_microblaze_0_axi_periph_BREADY;
  assign M02_AXI_rready = m02_couplers_to_microblaze_0_axi_periph_RREADY;
  assign M02_AXI_wdata[31:0] = m02_couplers_to_microblaze_0_axi_periph_WDATA;
  assign M02_AXI_wstrb[3:0] = m02_couplers_to_microblaze_0_axi_periph_WSTRB;
  assign M02_AXI_wvalid = m02_couplers_to_microblaze_0_axi_periph_WVALID;
  assign M03_AXI_araddr[31:0] = m03_couplers_to_microblaze_0_axi_periph_ARADDR;
  assign M03_AXI_arvalid = m03_couplers_to_microblaze_0_axi_periph_ARVALID;
  assign M03_AXI_awaddr[31:0] = m03_couplers_to_microblaze_0_axi_periph_AWADDR;
  assign M03_AXI_awvalid = m03_couplers_to_microblaze_0_axi_periph_AWVALID;
  assign M03_AXI_bready = m03_couplers_to_microblaze_0_axi_periph_BREADY;
  assign M03_AXI_rready = m03_couplers_to_microblaze_0_axi_periph_RREADY;
  assign M03_AXI_wdata[31:0] = m03_couplers_to_microblaze_0_axi_periph_WDATA;
  assign M03_AXI_wstrb[3:0] = m03_couplers_to_microblaze_0_axi_periph_WSTRB;
  assign M03_AXI_wvalid = m03_couplers_to_microblaze_0_axi_periph_WVALID;
  assign M04_AXI_araddr[31:0] = m04_couplers_to_microblaze_0_axi_periph_ARADDR;
  assign M04_AXI_arvalid = m04_couplers_to_microblaze_0_axi_periph_ARVALID;
  assign M04_AXI_awaddr[31:0] = m04_couplers_to_microblaze_0_axi_periph_AWADDR;
  assign M04_AXI_awvalid = m04_couplers_to_microblaze_0_axi_periph_AWVALID;
  assign M04_AXI_bready = m04_couplers_to_microblaze_0_axi_periph_BREADY;
  assign M04_AXI_rready = m04_couplers_to_microblaze_0_axi_periph_RREADY;
  assign M04_AXI_wdata[31:0] = m04_couplers_to_microblaze_0_axi_periph_WDATA;
  assign M04_AXI_wstrb[3:0] = m04_couplers_to_microblaze_0_axi_periph_WSTRB;
  assign M04_AXI_wvalid = m04_couplers_to_microblaze_0_axi_periph_WVALID;
  assign M05_AXI_araddr = m05_couplers_to_microblaze_0_axi_periph_ARADDR;
  assign M05_AXI_arprot = m05_couplers_to_microblaze_0_axi_periph_ARPROT;
  assign M05_AXI_arvalid = m05_couplers_to_microblaze_0_axi_periph_ARVALID;
  assign M05_AXI_awaddr = m05_couplers_to_microblaze_0_axi_periph_AWADDR;
  assign M05_AXI_awprot = m05_couplers_to_microblaze_0_axi_periph_AWPROT;
  assign M05_AXI_awvalid = m05_couplers_to_microblaze_0_axi_periph_AWVALID;
  assign M05_AXI_bready = m05_couplers_to_microblaze_0_axi_periph_BREADY;
  assign M05_AXI_rready = m05_couplers_to_microblaze_0_axi_periph_RREADY;
  assign M05_AXI_wdata = m05_couplers_to_microblaze_0_axi_periph_WDATA;
  assign M05_AXI_wstrb = m05_couplers_to_microblaze_0_axi_periph_WSTRB;
  assign M05_AXI_wvalid = m05_couplers_to_microblaze_0_axi_periph_WVALID;
  assign S00_AXI_arready[0] = microblaze_0_axi_periph_to_s00_couplers_ARREADY;
  assign S00_AXI_awready[0] = microblaze_0_axi_periph_to_s00_couplers_AWREADY;
  assign S00_AXI_bresp[1:0] = microblaze_0_axi_periph_to_s00_couplers_BRESP;
  assign S00_AXI_bvalid[0] = microblaze_0_axi_periph_to_s00_couplers_BVALID;
  assign S00_AXI_rdata[31:0] = microblaze_0_axi_periph_to_s00_couplers_RDATA;
  assign S00_AXI_rresp[1:0] = microblaze_0_axi_periph_to_s00_couplers_RRESP;
  assign S00_AXI_rvalid[0] = microblaze_0_axi_periph_to_s00_couplers_RVALID;
  assign S00_AXI_wready[0] = microblaze_0_axi_periph_to_s00_couplers_WREADY;
  assign m00_couplers_to_microblaze_0_axi_periph_ARREADY = M00_AXI_arready[0];
  assign m00_couplers_to_microblaze_0_axi_periph_AWREADY = M00_AXI_awready[0];
  assign m00_couplers_to_microblaze_0_axi_periph_BRESP = M00_AXI_bresp[1:0];
  assign m00_couplers_to_microblaze_0_axi_periph_BVALID = M00_AXI_bvalid[0];
  assign m00_couplers_to_microblaze_0_axi_periph_RDATA = M00_AXI_rdata[31:0];
  assign m00_couplers_to_microblaze_0_axi_periph_RRESP = M00_AXI_rresp[1:0];
  assign m00_couplers_to_microblaze_0_axi_periph_RVALID = M00_AXI_rvalid[0];
  assign m00_couplers_to_microblaze_0_axi_periph_WREADY = M00_AXI_wready[0];
  assign m01_couplers_to_microblaze_0_axi_periph_ARREADY = M01_AXI_arready;
  assign m01_couplers_to_microblaze_0_axi_periph_AWREADY = M01_AXI_awready;
  assign m01_couplers_to_microblaze_0_axi_periph_BRESP = M01_AXI_bresp[1:0];
  assign m01_couplers_to_microblaze_0_axi_periph_BVALID = M01_AXI_bvalid;
  assign m01_couplers_to_microblaze_0_axi_periph_RDATA = M01_AXI_rdata[31:0];
  assign m01_couplers_to_microblaze_0_axi_periph_RRESP = M01_AXI_rresp[1:0];
  assign m01_couplers_to_microblaze_0_axi_periph_RVALID = M01_AXI_rvalid;
  assign m01_couplers_to_microblaze_0_axi_periph_WREADY = M01_AXI_wready;
  assign m02_couplers_to_microblaze_0_axi_periph_ARREADY = M02_AXI_arready;
  assign m02_couplers_to_microblaze_0_axi_periph_AWREADY = M02_AXI_awready;
  assign m02_couplers_to_microblaze_0_axi_periph_BRESP = M02_AXI_bresp[1:0];
  assign m02_couplers_to_microblaze_0_axi_periph_BVALID = M02_AXI_bvalid;
  assign m02_couplers_to_microblaze_0_axi_periph_RDATA = M02_AXI_rdata[31:0];
  assign m02_couplers_to_microblaze_0_axi_periph_RRESP = M02_AXI_rresp[1:0];
  assign m02_couplers_to_microblaze_0_axi_periph_RVALID = M02_AXI_rvalid;
  assign m02_couplers_to_microblaze_0_axi_periph_WREADY = M02_AXI_wready;
  assign m03_couplers_to_microblaze_0_axi_periph_ARREADY = M03_AXI_arready;
  assign m03_couplers_to_microblaze_0_axi_periph_AWREADY = M03_AXI_awready;
  assign m03_couplers_to_microblaze_0_axi_periph_BRESP = M03_AXI_bresp[1:0];
  assign m03_couplers_to_microblaze_0_axi_periph_BVALID = M03_AXI_bvalid;
  assign m03_couplers_to_microblaze_0_axi_periph_RDATA = M03_AXI_rdata[31:0];
  assign m03_couplers_to_microblaze_0_axi_periph_RRESP = M03_AXI_rresp[1:0];
  assign m03_couplers_to_microblaze_0_axi_periph_RVALID = M03_AXI_rvalid;
  assign m03_couplers_to_microblaze_0_axi_periph_WREADY = M03_AXI_wready;
  assign m04_couplers_to_microblaze_0_axi_periph_ARREADY = M04_AXI_arready;
  assign m04_couplers_to_microblaze_0_axi_periph_AWREADY = M04_AXI_awready;
  assign m04_couplers_to_microblaze_0_axi_periph_BRESP = M04_AXI_bresp[1:0];
  assign m04_couplers_to_microblaze_0_axi_periph_BVALID = M04_AXI_bvalid;
  assign m04_couplers_to_microblaze_0_axi_periph_RDATA = M04_AXI_rdata[31:0];
  assign m04_couplers_to_microblaze_0_axi_periph_RRESP = M04_AXI_rresp[1:0];
  assign m04_couplers_to_microblaze_0_axi_periph_RVALID = M04_AXI_rvalid;
  assign m04_couplers_to_microblaze_0_axi_periph_WREADY = M04_AXI_wready;
  assign m05_couplers_to_microblaze_0_axi_periph_ARREADY = M05_AXI_arready;
  assign m05_couplers_to_microblaze_0_axi_periph_AWREADY = M05_AXI_awready;
  assign m05_couplers_to_microblaze_0_axi_periph_BRESP = M05_AXI_bresp;
  assign m05_couplers_to_microblaze_0_axi_periph_BVALID = M05_AXI_bvalid;
  assign m05_couplers_to_microblaze_0_axi_periph_RDATA = M05_AXI_rdata;
  assign m05_couplers_to_microblaze_0_axi_periph_RRESP = M05_AXI_rresp;
  assign m05_couplers_to_microblaze_0_axi_periph_RVALID = M05_AXI_rvalid;
  assign m05_couplers_to_microblaze_0_axi_periph_WREADY = M05_AXI_wready;
  assign microblaze_0_axi_periph_ACLK_net = ACLK;
  assign microblaze_0_axi_periph_ARESETN_net = ARESETN;
  assign microblaze_0_axi_periph_to_s00_couplers_ARADDR = S00_AXI_araddr[31:0];
  assign microblaze_0_axi_periph_to_s00_couplers_ARPROT = S00_AXI_arprot[2:0];
  assign microblaze_0_axi_periph_to_s00_couplers_ARVALID = S00_AXI_arvalid[0];
  assign microblaze_0_axi_periph_to_s00_couplers_AWADDR = S00_AXI_awaddr[31:0];
  assign microblaze_0_axi_periph_to_s00_couplers_AWPROT = S00_AXI_awprot[2:0];
  assign microblaze_0_axi_periph_to_s00_couplers_AWVALID = S00_AXI_awvalid[0];
  assign microblaze_0_axi_periph_to_s00_couplers_BREADY = S00_AXI_bready[0];
  assign microblaze_0_axi_periph_to_s00_couplers_RREADY = S00_AXI_rready[0];
  assign microblaze_0_axi_periph_to_s00_couplers_WDATA = S00_AXI_wdata[31:0];
  assign microblaze_0_axi_periph_to_s00_couplers_WSTRB = S00_AXI_wstrb[3:0];
  assign microblaze_0_axi_periph_to_s00_couplers_WVALID = S00_AXI_wvalid[0];
  m00_couplers_imp_1MOUN6X m00_couplers
       (.M_ACLK(microblaze_0_axi_periph_ACLK_net),
        .M_ARESETN(microblaze_0_axi_periph_ARESETN_net),
        .M_AXI_araddr(m00_couplers_to_microblaze_0_axi_periph_ARADDR),
        .M_AXI_arready(m00_couplers_to_microblaze_0_axi_periph_ARREADY),
        .M_AXI_arvalid(m00_couplers_to_microblaze_0_axi_periph_ARVALID),
        .M_AXI_awaddr(m00_couplers_to_microblaze_0_axi_periph_AWADDR),
        .M_AXI_awready(m00_couplers_to_microblaze_0_axi_periph_AWREADY),
        .M_AXI_awvalid(m00_couplers_to_microblaze_0_axi_periph_AWVALID),
        .M_AXI_bready(m00_couplers_to_microblaze_0_axi_periph_BREADY),
        .M_AXI_bresp(m00_couplers_to_microblaze_0_axi_periph_BRESP),
        .M_AXI_bvalid(m00_couplers_to_microblaze_0_axi_periph_BVALID),
        .M_AXI_rdata(m00_couplers_to_microblaze_0_axi_periph_RDATA),
        .M_AXI_rready(m00_couplers_to_microblaze_0_axi_periph_RREADY),
        .M_AXI_rresp(m00_couplers_to_microblaze_0_axi_periph_RRESP),
        .M_AXI_rvalid(m00_couplers_to_microblaze_0_axi_periph_RVALID),
        .M_AXI_wdata(m00_couplers_to_microblaze_0_axi_periph_WDATA),
        .M_AXI_wready(m00_couplers_to_microblaze_0_axi_periph_WREADY),
        .M_AXI_wstrb(m00_couplers_to_microblaze_0_axi_periph_WSTRB),
        .M_AXI_wvalid(m00_couplers_to_microblaze_0_axi_periph_WVALID),
        .S_ACLK(microblaze_0_axi_periph_ACLK_net),
        .S_ARESETN(microblaze_0_axi_periph_ARESETN_net),
        .S_AXI_araddr(xbar_to_m00_couplers_ARADDR),
        .S_AXI_arready(xbar_to_m00_couplers_ARREADY),
        .S_AXI_arvalid(xbar_to_m00_couplers_ARVALID),
        .S_AXI_awaddr(xbar_to_m00_couplers_AWADDR),
        .S_AXI_awready(xbar_to_m00_couplers_AWREADY),
        .S_AXI_awvalid(xbar_to_m00_couplers_AWVALID),
        .S_AXI_bready(xbar_to_m00_couplers_BREADY),
        .S_AXI_bresp(xbar_to_m00_couplers_BRESP),
        .S_AXI_bvalid(xbar_to_m00_couplers_BVALID),
        .S_AXI_rdata(xbar_to_m00_couplers_RDATA),
        .S_AXI_rready(xbar_to_m00_couplers_RREADY),
        .S_AXI_rresp(xbar_to_m00_couplers_RRESP),
        .S_AXI_rvalid(xbar_to_m00_couplers_RVALID),
        .S_AXI_wdata(xbar_to_m00_couplers_WDATA),
        .S_AXI_wready(xbar_to_m00_couplers_WREADY),
        .S_AXI_wstrb(xbar_to_m00_couplers_WSTRB),
        .S_AXI_wvalid(xbar_to_m00_couplers_WVALID));
  m01_couplers_imp_1IKLGRT m01_couplers
       (.M_ACLK(microblaze_0_axi_periph_ACLK_net),
        .M_ARESETN(microblaze_0_axi_periph_ARESETN_net),
        .M_AXI_araddr(m01_couplers_to_microblaze_0_axi_periph_ARADDR),
        .M_AXI_arready(m01_couplers_to_microblaze_0_axi_periph_ARREADY),
        .M_AXI_arvalid(m01_couplers_to_microblaze_0_axi_periph_ARVALID),
        .M_AXI_awaddr(m01_couplers_to_microblaze_0_axi_periph_AWADDR),
        .M_AXI_awready(m01_couplers_to_microblaze_0_axi_periph_AWREADY),
        .M_AXI_awvalid(m01_couplers_to_microblaze_0_axi_periph_AWVALID),
        .M_AXI_bready(m01_couplers_to_microblaze_0_axi_periph_BREADY),
        .M_AXI_bresp(m01_couplers_to_microblaze_0_axi_periph_BRESP),
        .M_AXI_bvalid(m01_couplers_to_microblaze_0_axi_periph_BVALID),
        .M_AXI_rdata(m01_couplers_to_microblaze_0_axi_periph_RDATA),
        .M_AXI_rready(m01_couplers_to_microblaze_0_axi_periph_RREADY),
        .M_AXI_rresp(m01_couplers_to_microblaze_0_axi_periph_RRESP),
        .M_AXI_rvalid(m01_couplers_to_microblaze_0_axi_periph_RVALID),
        .M_AXI_wdata(m01_couplers_to_microblaze_0_axi_periph_WDATA),
        .M_AXI_wready(m01_couplers_to_microblaze_0_axi_periph_WREADY),
        .M_AXI_wstrb(m01_couplers_to_microblaze_0_axi_periph_WSTRB),
        .M_AXI_wvalid(m01_couplers_to_microblaze_0_axi_periph_WVALID),
        .S_ACLK(microblaze_0_axi_periph_ACLK_net),
        .S_ARESETN(microblaze_0_axi_periph_ARESETN_net),
        .S_AXI_araddr(xbar_to_m01_couplers_ARADDR),
        .S_AXI_arready(xbar_to_m01_couplers_ARREADY),
        .S_AXI_arvalid(xbar_to_m01_couplers_ARVALID),
        .S_AXI_awaddr(xbar_to_m01_couplers_AWADDR),
        .S_AXI_awready(xbar_to_m01_couplers_AWREADY),
        .S_AXI_awvalid(xbar_to_m01_couplers_AWVALID),
        .S_AXI_bready(xbar_to_m01_couplers_BREADY),
        .S_AXI_bresp(xbar_to_m01_couplers_BRESP),
        .S_AXI_bvalid(xbar_to_m01_couplers_BVALID),
        .S_AXI_rdata(xbar_to_m01_couplers_RDATA),
        .S_AXI_rready(xbar_to_m01_couplers_RREADY),
        .S_AXI_rresp(xbar_to_m01_couplers_RRESP),
        .S_AXI_rvalid(xbar_to_m01_couplers_RVALID),
        .S_AXI_wdata(xbar_to_m01_couplers_WDATA),
        .S_AXI_wready(xbar_to_m01_couplers_WREADY),
        .S_AXI_wstrb(xbar_to_m01_couplers_WSTRB),
        .S_AXI_wvalid(xbar_to_m01_couplers_WVALID));
  m02_couplers_imp_1YFJ2AX m02_couplers
       (.M_ACLK(microblaze_0_axi_periph_ACLK_net),
        .M_ARESETN(microblaze_0_axi_periph_ARESETN_net),
        .M_AXI_araddr(m02_couplers_to_microblaze_0_axi_periph_ARADDR),
        .M_AXI_arready(m02_couplers_to_microblaze_0_axi_periph_ARREADY),
        .M_AXI_arvalid(m02_couplers_to_microblaze_0_axi_periph_ARVALID),
        .M_AXI_awaddr(m02_couplers_to_microblaze_0_axi_periph_AWADDR),
        .M_AXI_awready(m02_couplers_to_microblaze_0_axi_periph_AWREADY),
        .M_AXI_awvalid(m02_couplers_to_microblaze_0_axi_periph_AWVALID),
        .M_AXI_bready(m02_couplers_to_microblaze_0_axi_periph_BREADY),
        .M_AXI_bresp(m02_couplers_to_microblaze_0_axi_periph_BRESP),
        .M_AXI_bvalid(m02_couplers_to_microblaze_0_axi_periph_BVALID),
        .M_AXI_rdata(m02_couplers_to_microblaze_0_axi_periph_RDATA),
        .M_AXI_rready(m02_couplers_to_microblaze_0_axi_periph_RREADY),
        .M_AXI_rresp(m02_couplers_to_microblaze_0_axi_periph_RRESP),
        .M_AXI_rvalid(m02_couplers_to_microblaze_0_axi_periph_RVALID),
        .M_AXI_wdata(m02_couplers_to_microblaze_0_axi_periph_WDATA),
        .M_AXI_wready(m02_couplers_to_microblaze_0_axi_periph_WREADY),
        .M_AXI_wstrb(m02_couplers_to_microblaze_0_axi_periph_WSTRB),
        .M_AXI_wvalid(m02_couplers_to_microblaze_0_axi_periph_WVALID),
        .S_ACLK(microblaze_0_axi_periph_ACLK_net),
        .S_ARESETN(microblaze_0_axi_periph_ARESETN_net),
        .S_AXI_araddr(xbar_to_m02_couplers_ARADDR),
        .S_AXI_arready(xbar_to_m02_couplers_ARREADY),
        .S_AXI_arvalid(xbar_to_m02_couplers_ARVALID),
        .S_AXI_awaddr(xbar_to_m02_couplers_AWADDR),
        .S_AXI_awready(xbar_to_m02_couplers_AWREADY),
        .S_AXI_awvalid(xbar_to_m02_couplers_AWVALID),
        .S_AXI_bready(xbar_to_m02_couplers_BREADY),
        .S_AXI_bresp(xbar_to_m02_couplers_BRESP),
        .S_AXI_bvalid(xbar_to_m02_couplers_BVALID),
        .S_AXI_rdata(xbar_to_m02_couplers_RDATA),
        .S_AXI_rready(xbar_to_m02_couplers_RREADY),
        .S_AXI_rresp(xbar_to_m02_couplers_RRESP),
        .S_AXI_rvalid(xbar_to_m02_couplers_RVALID),
        .S_AXI_wdata(xbar_to_m02_couplers_WDATA),
        .S_AXI_wready(xbar_to_m02_couplers_WREADY),
        .S_AXI_wstrb(xbar_to_m02_couplers_WSTRB),
        .S_AXI_wvalid(xbar_to_m02_couplers_WVALID));
  m03_couplers_imp_1T7AT9L m03_couplers
       (.M_ACLK(microblaze_0_axi_periph_ACLK_net),
        .M_ARESETN(microblaze_0_axi_periph_ARESETN_net),
        .M_AXI_araddr(m03_couplers_to_microblaze_0_axi_periph_ARADDR),
        .M_AXI_arready(m03_couplers_to_microblaze_0_axi_periph_ARREADY),
        .M_AXI_arvalid(m03_couplers_to_microblaze_0_axi_periph_ARVALID),
        .M_AXI_awaddr(m03_couplers_to_microblaze_0_axi_periph_AWADDR),
        .M_AXI_awready(m03_couplers_to_microblaze_0_axi_periph_AWREADY),
        .M_AXI_awvalid(m03_couplers_to_microblaze_0_axi_periph_AWVALID),
        .M_AXI_bready(m03_couplers_to_microblaze_0_axi_periph_BREADY),
        .M_AXI_bresp(m03_couplers_to_microblaze_0_axi_periph_BRESP),
        .M_AXI_bvalid(m03_couplers_to_microblaze_0_axi_periph_BVALID),
        .M_AXI_rdata(m03_couplers_to_microblaze_0_axi_periph_RDATA),
        .M_AXI_rready(m03_couplers_to_microblaze_0_axi_periph_RREADY),
        .M_AXI_rresp(m03_couplers_to_microblaze_0_axi_periph_RRESP),
        .M_AXI_rvalid(m03_couplers_to_microblaze_0_axi_periph_RVALID),
        .M_AXI_wdata(m03_couplers_to_microblaze_0_axi_periph_WDATA),
        .M_AXI_wready(m03_couplers_to_microblaze_0_axi_periph_WREADY),
        .M_AXI_wstrb(m03_couplers_to_microblaze_0_axi_periph_WSTRB),
        .M_AXI_wvalid(m03_couplers_to_microblaze_0_axi_periph_WVALID),
        .S_ACLK(microblaze_0_axi_periph_ACLK_net),
        .S_ARESETN(microblaze_0_axi_periph_ARESETN_net),
        .S_AXI_araddr(xbar_to_m03_couplers_ARADDR),
        .S_AXI_arready(xbar_to_m03_couplers_ARREADY),
        .S_AXI_arvalid(xbar_to_m03_couplers_ARVALID),
        .S_AXI_awaddr(xbar_to_m03_couplers_AWADDR),
        .S_AXI_awready(xbar_to_m03_couplers_AWREADY),
        .S_AXI_awvalid(xbar_to_m03_couplers_AWVALID),
        .S_AXI_bready(xbar_to_m03_couplers_BREADY),
        .S_AXI_bresp(xbar_to_m03_couplers_BRESP),
        .S_AXI_bvalid(xbar_to_m03_couplers_BVALID),
        .S_AXI_rdata(xbar_to_m03_couplers_RDATA),
        .S_AXI_rready(xbar_to_m03_couplers_RREADY),
        .S_AXI_rresp(xbar_to_m03_couplers_RRESP),
        .S_AXI_rvalid(xbar_to_m03_couplers_RVALID),
        .S_AXI_wdata(xbar_to_m03_couplers_WDATA),
        .S_AXI_wready(xbar_to_m03_couplers_WREADY),
        .S_AXI_wstrb(xbar_to_m03_couplers_WSTRB),
        .S_AXI_wvalid(xbar_to_m03_couplers_WVALID));
  m04_couplers_imp_13PXFXL m04_couplers
       (.M_ACLK(microblaze_0_axi_periph_ACLK_net),
        .M_ARESETN(microblaze_0_axi_periph_ARESETN_net),
        .M_AXI_araddr(m04_couplers_to_microblaze_0_axi_periph_ARADDR),
        .M_AXI_arready(m04_couplers_to_microblaze_0_axi_periph_ARREADY),
        .M_AXI_arvalid(m04_couplers_to_microblaze_0_axi_periph_ARVALID),
        .M_AXI_awaddr(m04_couplers_to_microblaze_0_axi_periph_AWADDR),
        .M_AXI_awready(m04_couplers_to_microblaze_0_axi_periph_AWREADY),
        .M_AXI_awvalid(m04_couplers_to_microblaze_0_axi_periph_AWVALID),
        .M_AXI_bready(m04_couplers_to_microblaze_0_axi_periph_BREADY),
        .M_AXI_bresp(m04_couplers_to_microblaze_0_axi_periph_BRESP),
        .M_AXI_bvalid(m04_couplers_to_microblaze_0_axi_periph_BVALID),
        .M_AXI_rdata(m04_couplers_to_microblaze_0_axi_periph_RDATA),
        .M_AXI_rready(m04_couplers_to_microblaze_0_axi_periph_RREADY),
        .M_AXI_rresp(m04_couplers_to_microblaze_0_axi_periph_RRESP),
        .M_AXI_rvalid(m04_couplers_to_microblaze_0_axi_periph_RVALID),
        .M_AXI_wdata(m04_couplers_to_microblaze_0_axi_periph_WDATA),
        .M_AXI_wready(m04_couplers_to_microblaze_0_axi_periph_WREADY),
        .M_AXI_wstrb(m04_couplers_to_microblaze_0_axi_periph_WSTRB),
        .M_AXI_wvalid(m04_couplers_to_microblaze_0_axi_periph_WVALID),
        .S_ACLK(microblaze_0_axi_periph_ACLK_net),
        .S_ARESETN(microblaze_0_axi_periph_ARESETN_net),
        .S_AXI_araddr(xbar_to_m04_couplers_ARADDR),
        .S_AXI_arready(xbar_to_m04_couplers_ARREADY),
        .S_AXI_arvalid(xbar_to_m04_couplers_ARVALID),
        .S_AXI_awaddr(xbar_to_m04_couplers_AWADDR),
        .S_AXI_awready(xbar_to_m04_couplers_AWREADY),
        .S_AXI_awvalid(xbar_to_m04_couplers_AWVALID),
        .S_AXI_bready(xbar_to_m04_couplers_BREADY),
        .S_AXI_bresp(xbar_to_m04_couplers_BRESP),
        .S_AXI_bvalid(xbar_to_m04_couplers_BVALID),
        .S_AXI_rdata(xbar_to_m04_couplers_RDATA),
        .S_AXI_rready(xbar_to_m04_couplers_RREADY),
        .S_AXI_rresp(xbar_to_m04_couplers_RRESP),
        .S_AXI_rvalid(xbar_to_m04_couplers_RVALID),
        .S_AXI_wdata(xbar_to_m04_couplers_WDATA),
        .S_AXI_wready(xbar_to_m04_couplers_WREADY),
        .S_AXI_wstrb(xbar_to_m04_couplers_WSTRB),
        .S_AXI_wvalid(xbar_to_m04_couplers_WVALID));
  m05_couplers_imp_166WMCP m05_couplers
       (.M_ACLK(microblaze_0_axi_periph_ACLK_net),
        .M_ARESETN(microblaze_0_axi_periph_ARESETN_net),
        .M_AXI_araddr(m05_couplers_to_microblaze_0_axi_periph_ARADDR),
        .M_AXI_arprot(m05_couplers_to_microblaze_0_axi_periph_ARPROT),
        .M_AXI_arready(m05_couplers_to_microblaze_0_axi_periph_ARREADY),
        .M_AXI_arvalid(m05_couplers_to_microblaze_0_axi_periph_ARVALID),
        .M_AXI_awaddr(m05_couplers_to_microblaze_0_axi_periph_AWADDR),
        .M_AXI_awprot(m05_couplers_to_microblaze_0_axi_periph_AWPROT),
        .M_AXI_awready(m05_couplers_to_microblaze_0_axi_periph_AWREADY),
        .M_AXI_awvalid(m05_couplers_to_microblaze_0_axi_periph_AWVALID),
        .M_AXI_bready(m05_couplers_to_microblaze_0_axi_periph_BREADY),
        .M_AXI_bresp(m05_couplers_to_microblaze_0_axi_periph_BRESP),
        .M_AXI_bvalid(m05_couplers_to_microblaze_0_axi_periph_BVALID),
        .M_AXI_rdata(m05_couplers_to_microblaze_0_axi_periph_RDATA),
        .M_AXI_rready(m05_couplers_to_microblaze_0_axi_periph_RREADY),
        .M_AXI_rresp(m05_couplers_to_microblaze_0_axi_periph_RRESP),
        .M_AXI_rvalid(m05_couplers_to_microblaze_0_axi_periph_RVALID),
        .M_AXI_wdata(m05_couplers_to_microblaze_0_axi_periph_WDATA),
        .M_AXI_wready(m05_couplers_to_microblaze_0_axi_periph_WREADY),
        .M_AXI_wstrb(m05_couplers_to_microblaze_0_axi_periph_WSTRB),
        .M_AXI_wvalid(m05_couplers_to_microblaze_0_axi_periph_WVALID),
        .S_ACLK(microblaze_0_axi_periph_ACLK_net),
        .S_ARESETN(microblaze_0_axi_periph_ARESETN_net),
        .S_AXI_araddr(xbar_to_m05_couplers_ARADDR[160]),
        .S_AXI_arprot(xbar_to_m05_couplers_ARPROT[15]),
        .S_AXI_arready(xbar_to_m05_couplers_ARREADY),
        .S_AXI_arvalid(xbar_to_m05_couplers_ARVALID),
        .S_AXI_awaddr(xbar_to_m05_couplers_AWADDR[160]),
        .S_AXI_awprot(xbar_to_m05_couplers_AWPROT[15]),
        .S_AXI_awready(xbar_to_m05_couplers_AWREADY),
        .S_AXI_awvalid(xbar_to_m05_couplers_AWVALID),
        .S_AXI_bready(xbar_to_m05_couplers_BREADY),
        .S_AXI_bresp(xbar_to_m05_couplers_BRESP),
        .S_AXI_bvalid(xbar_to_m05_couplers_BVALID),
        .S_AXI_rdata(xbar_to_m05_couplers_RDATA),
        .S_AXI_rready(xbar_to_m05_couplers_RREADY),
        .S_AXI_rresp(xbar_to_m05_couplers_RRESP),
        .S_AXI_rvalid(xbar_to_m05_couplers_RVALID),
        .S_AXI_wdata(xbar_to_m05_couplers_WDATA[160]),
        .S_AXI_wready(xbar_to_m05_couplers_WREADY),
        .S_AXI_wstrb(xbar_to_m05_couplers_WSTRB[20]),
        .S_AXI_wvalid(xbar_to_m05_couplers_WVALID));
  s00_couplers_imp_1LEASL6 s00_couplers
       (.M_ACLK(microblaze_0_axi_periph_ACLK_net),
        .M_ARESETN(microblaze_0_axi_periph_ARESETN_net),
        .M_AXI_araddr(s00_couplers_to_xbar_ARADDR),
        .M_AXI_arprot(s00_couplers_to_xbar_ARPROT),
        .M_AXI_arready(s00_couplers_to_xbar_ARREADY),
        .M_AXI_arvalid(s00_couplers_to_xbar_ARVALID),
        .M_AXI_awaddr(s00_couplers_to_xbar_AWADDR),
        .M_AXI_awprot(s00_couplers_to_xbar_AWPROT),
        .M_AXI_awready(s00_couplers_to_xbar_AWREADY),
        .M_AXI_awvalid(s00_couplers_to_xbar_AWVALID),
        .M_AXI_bready(s00_couplers_to_xbar_BREADY),
        .M_AXI_bresp(s00_couplers_to_xbar_BRESP),
        .M_AXI_bvalid(s00_couplers_to_xbar_BVALID),
        .M_AXI_rdata(s00_couplers_to_xbar_RDATA),
        .M_AXI_rready(s00_couplers_to_xbar_RREADY),
        .M_AXI_rresp(s00_couplers_to_xbar_RRESP),
        .M_AXI_rvalid(s00_couplers_to_xbar_RVALID),
        .M_AXI_wdata(s00_couplers_to_xbar_WDATA),
        .M_AXI_wready(s00_couplers_to_xbar_WREADY),
        .M_AXI_wstrb(s00_couplers_to_xbar_WSTRB),
        .M_AXI_wvalid(s00_couplers_to_xbar_WVALID),
        .S_ACLK(microblaze_0_axi_periph_ACLK_net),
        .S_ARESETN(microblaze_0_axi_periph_ARESETN_net),
        .S_AXI_araddr(microblaze_0_axi_periph_to_s00_couplers_ARADDR),
        .S_AXI_arprot(microblaze_0_axi_periph_to_s00_couplers_ARPROT),
        .S_AXI_arready(microblaze_0_axi_periph_to_s00_couplers_ARREADY),
        .S_AXI_arvalid(microblaze_0_axi_periph_to_s00_couplers_ARVALID),
        .S_AXI_awaddr(microblaze_0_axi_periph_to_s00_couplers_AWADDR),
        .S_AXI_awprot(microblaze_0_axi_periph_to_s00_couplers_AWPROT),
        .S_AXI_awready(microblaze_0_axi_periph_to_s00_couplers_AWREADY),
        .S_AXI_awvalid(microblaze_0_axi_periph_to_s00_couplers_AWVALID),
        .S_AXI_bready(microblaze_0_axi_periph_to_s00_couplers_BREADY),
        .S_AXI_bresp(microblaze_0_axi_periph_to_s00_couplers_BRESP),
        .S_AXI_bvalid(microblaze_0_axi_periph_to_s00_couplers_BVALID),
        .S_AXI_rdata(microblaze_0_axi_periph_to_s00_couplers_RDATA),
        .S_AXI_rready(microblaze_0_axi_periph_to_s00_couplers_RREADY),
        .S_AXI_rresp(microblaze_0_axi_periph_to_s00_couplers_RRESP),
        .S_AXI_rvalid(microblaze_0_axi_periph_to_s00_couplers_RVALID),
        .S_AXI_wdata(microblaze_0_axi_periph_to_s00_couplers_WDATA),
        .S_AXI_wready(microblaze_0_axi_periph_to_s00_couplers_WREADY),
        .S_AXI_wstrb(microblaze_0_axi_periph_to_s00_couplers_WSTRB),
        .S_AXI_wvalid(microblaze_0_axi_periph_to_s00_couplers_WVALID));
  MicroBlazeV2_xbar_0 xbar
       (.aclk(microblaze_0_axi_periph_ACLK_net),
        .aresetn(microblaze_0_axi_periph_ARESETN_net),
        .m_axi_araddr({xbar_to_m05_couplers_ARADDR,xbar_to_m04_couplers_ARADDR,xbar_to_m03_couplers_ARADDR,xbar_to_m02_couplers_ARADDR,xbar_to_m01_couplers_ARADDR,xbar_to_m00_couplers_ARADDR}),
        .m_axi_arprot({xbar_to_m05_couplers_ARPROT,NLW_xbar_m_axi_arprot_UNCONNECTED[14:0]}),
        .m_axi_arready({xbar_to_m05_couplers_ARREADY,xbar_to_m04_couplers_ARREADY,xbar_to_m03_couplers_ARREADY,xbar_to_m02_couplers_ARREADY,xbar_to_m01_couplers_ARREADY,xbar_to_m00_couplers_ARREADY}),
        .m_axi_arvalid({xbar_to_m05_couplers_ARVALID,xbar_to_m04_couplers_ARVALID,xbar_to_m03_couplers_ARVALID,xbar_to_m02_couplers_ARVALID,xbar_to_m01_couplers_ARVALID,xbar_to_m00_couplers_ARVALID}),
        .m_axi_awaddr({xbar_to_m05_couplers_AWADDR,xbar_to_m04_couplers_AWADDR,xbar_to_m03_couplers_AWADDR,xbar_to_m02_couplers_AWADDR,xbar_to_m01_couplers_AWADDR,xbar_to_m00_couplers_AWADDR}),
        .m_axi_awprot({xbar_to_m05_couplers_AWPROT,NLW_xbar_m_axi_awprot_UNCONNECTED[14:0]}),
        .m_axi_awready({xbar_to_m05_couplers_AWREADY,xbar_to_m04_couplers_AWREADY,xbar_to_m03_couplers_AWREADY,xbar_to_m02_couplers_AWREADY,xbar_to_m01_couplers_AWREADY,xbar_to_m00_couplers_AWREADY}),
        .m_axi_awvalid({xbar_to_m05_couplers_AWVALID,xbar_to_m04_couplers_AWVALID,xbar_to_m03_couplers_AWVALID,xbar_to_m02_couplers_AWVALID,xbar_to_m01_couplers_AWVALID,xbar_to_m00_couplers_AWVALID}),
        .m_axi_bready({xbar_to_m05_couplers_BREADY,xbar_to_m04_couplers_BREADY,xbar_to_m03_couplers_BREADY,xbar_to_m02_couplers_BREADY,xbar_to_m01_couplers_BREADY,xbar_to_m00_couplers_BREADY}),
        .m_axi_bresp({xbar_to_m05_couplers_BRESP,xbar_to_m05_couplers_BRESP,xbar_to_m04_couplers_BRESP,xbar_to_m03_couplers_BRESP,xbar_to_m02_couplers_BRESP,xbar_to_m01_couplers_BRESP,xbar_to_m00_couplers_BRESP}),
        .m_axi_bvalid({xbar_to_m05_couplers_BVALID,xbar_to_m04_couplers_BVALID,xbar_to_m03_couplers_BVALID,xbar_to_m02_couplers_BVALID,xbar_to_m01_couplers_BVALID,xbar_to_m00_couplers_BVALID}),
        .m_axi_rdata({xbar_to_m05_couplers_RDATA,xbar_to_m05_couplers_RDATA,xbar_to_m05_couplers_RDATA,xbar_to_m05_couplers_RDATA,xbar_to_m05_couplers_RDATA,xbar_to_m05_couplers_RDATA,xbar_to_m05_couplers_RDATA,xbar_to_m05_couplers_RDATA,xbar_to_m05_couplers_RDATA,xbar_to_m05_couplers_RDATA,xbar_to_m05_couplers_RDATA,xbar_to_m05_couplers_RDATA,xbar_to_m05_couplers_RDATA,xbar_to_m05_couplers_RDATA,xbar_to_m05_couplers_RDATA,xbar_to_m05_couplers_RDATA,xbar_to_m05_couplers_RDATA,xbar_to_m05_couplers_RDATA,xbar_to_m05_couplers_RDATA,xbar_to_m05_couplers_RDATA,xbar_to_m05_couplers_RDATA,xbar_to_m05_couplers_RDATA,xbar_to_m05_couplers_RDATA,xbar_to_m05_couplers_RDATA,xbar_to_m05_couplers_RDATA,xbar_to_m05_couplers_RDATA,xbar_to_m05_couplers_RDATA,xbar_to_m05_couplers_RDATA,xbar_to_m05_couplers_RDATA,xbar_to_m05_couplers_RDATA,xbar_to_m05_couplers_RDATA,xbar_to_m05_couplers_RDATA,xbar_to_m04_couplers_RDATA,xbar_to_m03_couplers_RDATA,xbar_to_m02_couplers_RDATA,xbar_to_m01_couplers_RDATA,xbar_to_m00_couplers_RDATA}),
        .m_axi_rready({xbar_to_m05_couplers_RREADY,xbar_to_m04_couplers_RREADY,xbar_to_m03_couplers_RREADY,xbar_to_m02_couplers_RREADY,xbar_to_m01_couplers_RREADY,xbar_to_m00_couplers_RREADY}),
        .m_axi_rresp({xbar_to_m05_couplers_RRESP,xbar_to_m05_couplers_RRESP,xbar_to_m04_couplers_RRESP,xbar_to_m03_couplers_RRESP,xbar_to_m02_couplers_RRESP,xbar_to_m01_couplers_RRESP,xbar_to_m00_couplers_RRESP}),
        .m_axi_rvalid({xbar_to_m05_couplers_RVALID,xbar_to_m04_couplers_RVALID,xbar_to_m03_couplers_RVALID,xbar_to_m02_couplers_RVALID,xbar_to_m01_couplers_RVALID,xbar_to_m00_couplers_RVALID}),
        .m_axi_wdata({xbar_to_m05_couplers_WDATA,xbar_to_m04_couplers_WDATA,xbar_to_m03_couplers_WDATA,xbar_to_m02_couplers_WDATA,xbar_to_m01_couplers_WDATA,xbar_to_m00_couplers_WDATA}),
        .m_axi_wready({xbar_to_m05_couplers_WREADY,xbar_to_m04_couplers_WREADY,xbar_to_m03_couplers_WREADY,xbar_to_m02_couplers_WREADY,xbar_to_m01_couplers_WREADY,xbar_to_m00_couplers_WREADY}),
        .m_axi_wstrb({xbar_to_m05_couplers_WSTRB,xbar_to_m04_couplers_WSTRB,xbar_to_m03_couplers_WSTRB,xbar_to_m02_couplers_WSTRB,xbar_to_m01_couplers_WSTRB,xbar_to_m00_couplers_WSTRB}),
        .m_axi_wvalid({xbar_to_m05_couplers_WVALID,xbar_to_m04_couplers_WVALID,xbar_to_m03_couplers_WVALID,xbar_to_m02_couplers_WVALID,xbar_to_m01_couplers_WVALID,xbar_to_m00_couplers_WVALID}),
        .s_axi_araddr(s00_couplers_to_xbar_ARADDR),
        .s_axi_arprot(s00_couplers_to_xbar_ARPROT),
        .s_axi_arready(s00_couplers_to_xbar_ARREADY),
        .s_axi_arvalid(s00_couplers_to_xbar_ARVALID),
        .s_axi_awaddr(s00_couplers_to_xbar_AWADDR),
        .s_axi_awprot(s00_couplers_to_xbar_AWPROT),
        .s_axi_awready(s00_couplers_to_xbar_AWREADY),
        .s_axi_awvalid(s00_couplers_to_xbar_AWVALID),
        .s_axi_bready(s00_couplers_to_xbar_BREADY),
        .s_axi_bresp(s00_couplers_to_xbar_BRESP),
        .s_axi_bvalid(s00_couplers_to_xbar_BVALID),
        .s_axi_rdata(s00_couplers_to_xbar_RDATA),
        .s_axi_rready(s00_couplers_to_xbar_RREADY),
        .s_axi_rresp(s00_couplers_to_xbar_RRESP),
        .s_axi_rvalid(s00_couplers_to_xbar_RVALID),
        .s_axi_wdata(s00_couplers_to_xbar_WDATA),
        .s_axi_wready(s00_couplers_to_xbar_WREADY),
        .s_axi_wstrb(s00_couplers_to_xbar_WSTRB),
        .s_axi_wvalid(s00_couplers_to_xbar_WVALID));
endmodule

module m00_couplers_imp_1MOUN6X
   (M_ACLK,
    M_ARESETN,
    M_AXI_araddr,
    M_AXI_arready,
    M_AXI_arvalid,
    M_AXI_awaddr,
    M_AXI_awready,
    M_AXI_awvalid,
    M_AXI_bready,
    M_AXI_bresp,
    M_AXI_bvalid,
    M_AXI_rdata,
    M_AXI_rready,
    M_AXI_rresp,
    M_AXI_rvalid,
    M_AXI_wdata,
    M_AXI_wready,
    M_AXI_wstrb,
    M_AXI_wvalid,
    S_ACLK,
    S_ARESETN,
    S_AXI_araddr,
    S_AXI_arready,
    S_AXI_arvalid,
    S_AXI_awaddr,
    S_AXI_awready,
    S_AXI_awvalid,
    S_AXI_bready,
    S_AXI_bresp,
    S_AXI_bvalid,
    S_AXI_rdata,
    S_AXI_rready,
    S_AXI_rresp,
    S_AXI_rvalid,
    S_AXI_wdata,
    S_AXI_wready,
    S_AXI_wstrb,
    S_AXI_wvalid);
  input M_ACLK;
  input M_ARESETN;
  output [31:0]M_AXI_araddr;
  input [0:0]M_AXI_arready;
  output [0:0]M_AXI_arvalid;
  output [31:0]M_AXI_awaddr;
  input [0:0]M_AXI_awready;
  output [0:0]M_AXI_awvalid;
  output [0:0]M_AXI_bready;
  input [1:0]M_AXI_bresp;
  input [0:0]M_AXI_bvalid;
  input [31:0]M_AXI_rdata;
  output [0:0]M_AXI_rready;
  input [1:0]M_AXI_rresp;
  input [0:0]M_AXI_rvalid;
  output [31:0]M_AXI_wdata;
  input [0:0]M_AXI_wready;
  output [3:0]M_AXI_wstrb;
  output [0:0]M_AXI_wvalid;
  input S_ACLK;
  input S_ARESETN;
  input [31:0]S_AXI_araddr;
  output [0:0]S_AXI_arready;
  input [0:0]S_AXI_arvalid;
  input [31:0]S_AXI_awaddr;
  output [0:0]S_AXI_awready;
  input [0:0]S_AXI_awvalid;
  input [0:0]S_AXI_bready;
  output [1:0]S_AXI_bresp;
  output [0:0]S_AXI_bvalid;
  output [31:0]S_AXI_rdata;
  input [0:0]S_AXI_rready;
  output [1:0]S_AXI_rresp;
  output [0:0]S_AXI_rvalid;
  input [31:0]S_AXI_wdata;
  output [0:0]S_AXI_wready;
  input [3:0]S_AXI_wstrb;
  input [0:0]S_AXI_wvalid;

  wire [31:0]m00_couplers_to_m00_couplers_ARADDR;
  wire [0:0]m00_couplers_to_m00_couplers_ARREADY;
  wire [0:0]m00_couplers_to_m00_couplers_ARVALID;
  wire [31:0]m00_couplers_to_m00_couplers_AWADDR;
  wire [0:0]m00_couplers_to_m00_couplers_AWREADY;
  wire [0:0]m00_couplers_to_m00_couplers_AWVALID;
  wire [0:0]m00_couplers_to_m00_couplers_BREADY;
  wire [1:0]m00_couplers_to_m00_couplers_BRESP;
  wire [0:0]m00_couplers_to_m00_couplers_BVALID;
  wire [31:0]m00_couplers_to_m00_couplers_RDATA;
  wire [0:0]m00_couplers_to_m00_couplers_RREADY;
  wire [1:0]m00_couplers_to_m00_couplers_RRESP;
  wire [0:0]m00_couplers_to_m00_couplers_RVALID;
  wire [31:0]m00_couplers_to_m00_couplers_WDATA;
  wire [0:0]m00_couplers_to_m00_couplers_WREADY;
  wire [3:0]m00_couplers_to_m00_couplers_WSTRB;
  wire [0:0]m00_couplers_to_m00_couplers_WVALID;

  assign M_AXI_araddr[31:0] = m00_couplers_to_m00_couplers_ARADDR;
  assign M_AXI_arvalid[0] = m00_couplers_to_m00_couplers_ARVALID;
  assign M_AXI_awaddr[31:0] = m00_couplers_to_m00_couplers_AWADDR;
  assign M_AXI_awvalid[0] = m00_couplers_to_m00_couplers_AWVALID;
  assign M_AXI_bready[0] = m00_couplers_to_m00_couplers_BREADY;
  assign M_AXI_rready[0] = m00_couplers_to_m00_couplers_RREADY;
  assign M_AXI_wdata[31:0] = m00_couplers_to_m00_couplers_WDATA;
  assign M_AXI_wstrb[3:0] = m00_couplers_to_m00_couplers_WSTRB;
  assign M_AXI_wvalid[0] = m00_couplers_to_m00_couplers_WVALID;
  assign S_AXI_arready[0] = m00_couplers_to_m00_couplers_ARREADY;
  assign S_AXI_awready[0] = m00_couplers_to_m00_couplers_AWREADY;
  assign S_AXI_bresp[1:0] = m00_couplers_to_m00_couplers_BRESP;
  assign S_AXI_bvalid[0] = m00_couplers_to_m00_couplers_BVALID;
  assign S_AXI_rdata[31:0] = m00_couplers_to_m00_couplers_RDATA;
  assign S_AXI_rresp[1:0] = m00_couplers_to_m00_couplers_RRESP;
  assign S_AXI_rvalid[0] = m00_couplers_to_m00_couplers_RVALID;
  assign S_AXI_wready[0] = m00_couplers_to_m00_couplers_WREADY;
  assign m00_couplers_to_m00_couplers_ARADDR = S_AXI_araddr[31:0];
  assign m00_couplers_to_m00_couplers_ARREADY = M_AXI_arready[0];
  assign m00_couplers_to_m00_couplers_ARVALID = S_AXI_arvalid[0];
  assign m00_couplers_to_m00_couplers_AWADDR = S_AXI_awaddr[31:0];
  assign m00_couplers_to_m00_couplers_AWREADY = M_AXI_awready[0];
  assign m00_couplers_to_m00_couplers_AWVALID = S_AXI_awvalid[0];
  assign m00_couplers_to_m00_couplers_BREADY = S_AXI_bready[0];
  assign m00_couplers_to_m00_couplers_BRESP = M_AXI_bresp[1:0];
  assign m00_couplers_to_m00_couplers_BVALID = M_AXI_bvalid[0];
  assign m00_couplers_to_m00_couplers_RDATA = M_AXI_rdata[31:0];
  assign m00_couplers_to_m00_couplers_RREADY = S_AXI_rready[0];
  assign m00_couplers_to_m00_couplers_RRESP = M_AXI_rresp[1:0];
  assign m00_couplers_to_m00_couplers_RVALID = M_AXI_rvalid[0];
  assign m00_couplers_to_m00_couplers_WDATA = S_AXI_wdata[31:0];
  assign m00_couplers_to_m00_couplers_WREADY = M_AXI_wready[0];
  assign m00_couplers_to_m00_couplers_WSTRB = S_AXI_wstrb[3:0];
  assign m00_couplers_to_m00_couplers_WVALID = S_AXI_wvalid[0];
endmodule

module m01_couplers_imp_1IKLGRT
   (M_ACLK,
    M_ARESETN,
    M_AXI_araddr,
    M_AXI_arready,
    M_AXI_arvalid,
    M_AXI_awaddr,
    M_AXI_awready,
    M_AXI_awvalid,
    M_AXI_bready,
    M_AXI_bresp,
    M_AXI_bvalid,
    M_AXI_rdata,
    M_AXI_rready,
    M_AXI_rresp,
    M_AXI_rvalid,
    M_AXI_wdata,
    M_AXI_wready,
    M_AXI_wstrb,
    M_AXI_wvalid,
    S_ACLK,
    S_ARESETN,
    S_AXI_araddr,
    S_AXI_arready,
    S_AXI_arvalid,
    S_AXI_awaddr,
    S_AXI_awready,
    S_AXI_awvalid,
    S_AXI_bready,
    S_AXI_bresp,
    S_AXI_bvalid,
    S_AXI_rdata,
    S_AXI_rready,
    S_AXI_rresp,
    S_AXI_rvalid,
    S_AXI_wdata,
    S_AXI_wready,
    S_AXI_wstrb,
    S_AXI_wvalid);
  input M_ACLK;
  input M_ARESETN;
  output [31:0]M_AXI_araddr;
  input M_AXI_arready;
  output M_AXI_arvalid;
  output [31:0]M_AXI_awaddr;
  input M_AXI_awready;
  output M_AXI_awvalid;
  output M_AXI_bready;
  input [1:0]M_AXI_bresp;
  input M_AXI_bvalid;
  input [31:0]M_AXI_rdata;
  output M_AXI_rready;
  input [1:0]M_AXI_rresp;
  input M_AXI_rvalid;
  output [31:0]M_AXI_wdata;
  input M_AXI_wready;
  output [3:0]M_AXI_wstrb;
  output M_AXI_wvalid;
  input S_ACLK;
  input S_ARESETN;
  input [31:0]S_AXI_araddr;
  output S_AXI_arready;
  input S_AXI_arvalid;
  input [31:0]S_AXI_awaddr;
  output S_AXI_awready;
  input S_AXI_awvalid;
  input S_AXI_bready;
  output [1:0]S_AXI_bresp;
  output S_AXI_bvalid;
  output [31:0]S_AXI_rdata;
  input S_AXI_rready;
  output [1:0]S_AXI_rresp;
  output S_AXI_rvalid;
  input [31:0]S_AXI_wdata;
  output S_AXI_wready;
  input [3:0]S_AXI_wstrb;
  input S_AXI_wvalid;

  wire [31:0]m01_couplers_to_m01_couplers_ARADDR;
  wire m01_couplers_to_m01_couplers_ARREADY;
  wire m01_couplers_to_m01_couplers_ARVALID;
  wire [31:0]m01_couplers_to_m01_couplers_AWADDR;
  wire m01_couplers_to_m01_couplers_AWREADY;
  wire m01_couplers_to_m01_couplers_AWVALID;
  wire m01_couplers_to_m01_couplers_BREADY;
  wire [1:0]m01_couplers_to_m01_couplers_BRESP;
  wire m01_couplers_to_m01_couplers_BVALID;
  wire [31:0]m01_couplers_to_m01_couplers_RDATA;
  wire m01_couplers_to_m01_couplers_RREADY;
  wire [1:0]m01_couplers_to_m01_couplers_RRESP;
  wire m01_couplers_to_m01_couplers_RVALID;
  wire [31:0]m01_couplers_to_m01_couplers_WDATA;
  wire m01_couplers_to_m01_couplers_WREADY;
  wire [3:0]m01_couplers_to_m01_couplers_WSTRB;
  wire m01_couplers_to_m01_couplers_WVALID;

  assign M_AXI_araddr[31:0] = m01_couplers_to_m01_couplers_ARADDR;
  assign M_AXI_arvalid = m01_couplers_to_m01_couplers_ARVALID;
  assign M_AXI_awaddr[31:0] = m01_couplers_to_m01_couplers_AWADDR;
  assign M_AXI_awvalid = m01_couplers_to_m01_couplers_AWVALID;
  assign M_AXI_bready = m01_couplers_to_m01_couplers_BREADY;
  assign M_AXI_rready = m01_couplers_to_m01_couplers_RREADY;
  assign M_AXI_wdata[31:0] = m01_couplers_to_m01_couplers_WDATA;
  assign M_AXI_wstrb[3:0] = m01_couplers_to_m01_couplers_WSTRB;
  assign M_AXI_wvalid = m01_couplers_to_m01_couplers_WVALID;
  assign S_AXI_arready = m01_couplers_to_m01_couplers_ARREADY;
  assign S_AXI_awready = m01_couplers_to_m01_couplers_AWREADY;
  assign S_AXI_bresp[1:0] = m01_couplers_to_m01_couplers_BRESP;
  assign S_AXI_bvalid = m01_couplers_to_m01_couplers_BVALID;
  assign S_AXI_rdata[31:0] = m01_couplers_to_m01_couplers_RDATA;
  assign S_AXI_rresp[1:0] = m01_couplers_to_m01_couplers_RRESP;
  assign S_AXI_rvalid = m01_couplers_to_m01_couplers_RVALID;
  assign S_AXI_wready = m01_couplers_to_m01_couplers_WREADY;
  assign m01_couplers_to_m01_couplers_ARADDR = S_AXI_araddr[31:0];
  assign m01_couplers_to_m01_couplers_ARREADY = M_AXI_arready;
  assign m01_couplers_to_m01_couplers_ARVALID = S_AXI_arvalid;
  assign m01_couplers_to_m01_couplers_AWADDR = S_AXI_awaddr[31:0];
  assign m01_couplers_to_m01_couplers_AWREADY = M_AXI_awready;
  assign m01_couplers_to_m01_couplers_AWVALID = S_AXI_awvalid;
  assign m01_couplers_to_m01_couplers_BREADY = S_AXI_bready;
  assign m01_couplers_to_m01_couplers_BRESP = M_AXI_bresp[1:0];
  assign m01_couplers_to_m01_couplers_BVALID = M_AXI_bvalid;
  assign m01_couplers_to_m01_couplers_RDATA = M_AXI_rdata[31:0];
  assign m01_couplers_to_m01_couplers_RREADY = S_AXI_rready;
  assign m01_couplers_to_m01_couplers_RRESP = M_AXI_rresp[1:0];
  assign m01_couplers_to_m01_couplers_RVALID = M_AXI_rvalid;
  assign m01_couplers_to_m01_couplers_WDATA = S_AXI_wdata[31:0];
  assign m01_couplers_to_m01_couplers_WREADY = M_AXI_wready;
  assign m01_couplers_to_m01_couplers_WSTRB = S_AXI_wstrb[3:0];
  assign m01_couplers_to_m01_couplers_WVALID = S_AXI_wvalid;
endmodule

module m02_couplers_imp_1YFJ2AX
   (M_ACLK,
    M_ARESETN,
    M_AXI_araddr,
    M_AXI_arready,
    M_AXI_arvalid,
    M_AXI_awaddr,
    M_AXI_awready,
    M_AXI_awvalid,
    M_AXI_bready,
    M_AXI_bresp,
    M_AXI_bvalid,
    M_AXI_rdata,
    M_AXI_rready,
    M_AXI_rresp,
    M_AXI_rvalid,
    M_AXI_wdata,
    M_AXI_wready,
    M_AXI_wstrb,
    M_AXI_wvalid,
    S_ACLK,
    S_ARESETN,
    S_AXI_araddr,
    S_AXI_arready,
    S_AXI_arvalid,
    S_AXI_awaddr,
    S_AXI_awready,
    S_AXI_awvalid,
    S_AXI_bready,
    S_AXI_bresp,
    S_AXI_bvalid,
    S_AXI_rdata,
    S_AXI_rready,
    S_AXI_rresp,
    S_AXI_rvalid,
    S_AXI_wdata,
    S_AXI_wready,
    S_AXI_wstrb,
    S_AXI_wvalid);
  input M_ACLK;
  input M_ARESETN;
  output [31:0]M_AXI_araddr;
  input M_AXI_arready;
  output M_AXI_arvalid;
  output [31:0]M_AXI_awaddr;
  input M_AXI_awready;
  output M_AXI_awvalid;
  output M_AXI_bready;
  input [1:0]M_AXI_bresp;
  input M_AXI_bvalid;
  input [31:0]M_AXI_rdata;
  output M_AXI_rready;
  input [1:0]M_AXI_rresp;
  input M_AXI_rvalid;
  output [31:0]M_AXI_wdata;
  input M_AXI_wready;
  output [3:0]M_AXI_wstrb;
  output M_AXI_wvalid;
  input S_ACLK;
  input S_ARESETN;
  input [31:0]S_AXI_araddr;
  output S_AXI_arready;
  input S_AXI_arvalid;
  input [31:0]S_AXI_awaddr;
  output S_AXI_awready;
  input S_AXI_awvalid;
  input S_AXI_bready;
  output [1:0]S_AXI_bresp;
  output S_AXI_bvalid;
  output [31:0]S_AXI_rdata;
  input S_AXI_rready;
  output [1:0]S_AXI_rresp;
  output S_AXI_rvalid;
  input [31:0]S_AXI_wdata;
  output S_AXI_wready;
  input [3:0]S_AXI_wstrb;
  input S_AXI_wvalid;

  wire [31:0]m02_couplers_to_m02_couplers_ARADDR;
  wire m02_couplers_to_m02_couplers_ARREADY;
  wire m02_couplers_to_m02_couplers_ARVALID;
  wire [31:0]m02_couplers_to_m02_couplers_AWADDR;
  wire m02_couplers_to_m02_couplers_AWREADY;
  wire m02_couplers_to_m02_couplers_AWVALID;
  wire m02_couplers_to_m02_couplers_BREADY;
  wire [1:0]m02_couplers_to_m02_couplers_BRESP;
  wire m02_couplers_to_m02_couplers_BVALID;
  wire [31:0]m02_couplers_to_m02_couplers_RDATA;
  wire m02_couplers_to_m02_couplers_RREADY;
  wire [1:0]m02_couplers_to_m02_couplers_RRESP;
  wire m02_couplers_to_m02_couplers_RVALID;
  wire [31:0]m02_couplers_to_m02_couplers_WDATA;
  wire m02_couplers_to_m02_couplers_WREADY;
  wire [3:0]m02_couplers_to_m02_couplers_WSTRB;
  wire m02_couplers_to_m02_couplers_WVALID;

  assign M_AXI_araddr[31:0] = m02_couplers_to_m02_couplers_ARADDR;
  assign M_AXI_arvalid = m02_couplers_to_m02_couplers_ARVALID;
  assign M_AXI_awaddr[31:0] = m02_couplers_to_m02_couplers_AWADDR;
  assign M_AXI_awvalid = m02_couplers_to_m02_couplers_AWVALID;
  assign M_AXI_bready = m02_couplers_to_m02_couplers_BREADY;
  assign M_AXI_rready = m02_couplers_to_m02_couplers_RREADY;
  assign M_AXI_wdata[31:0] = m02_couplers_to_m02_couplers_WDATA;
  assign M_AXI_wstrb[3:0] = m02_couplers_to_m02_couplers_WSTRB;
  assign M_AXI_wvalid = m02_couplers_to_m02_couplers_WVALID;
  assign S_AXI_arready = m02_couplers_to_m02_couplers_ARREADY;
  assign S_AXI_awready = m02_couplers_to_m02_couplers_AWREADY;
  assign S_AXI_bresp[1:0] = m02_couplers_to_m02_couplers_BRESP;
  assign S_AXI_bvalid = m02_couplers_to_m02_couplers_BVALID;
  assign S_AXI_rdata[31:0] = m02_couplers_to_m02_couplers_RDATA;
  assign S_AXI_rresp[1:0] = m02_couplers_to_m02_couplers_RRESP;
  assign S_AXI_rvalid = m02_couplers_to_m02_couplers_RVALID;
  assign S_AXI_wready = m02_couplers_to_m02_couplers_WREADY;
  assign m02_couplers_to_m02_couplers_ARADDR = S_AXI_araddr[31:0];
  assign m02_couplers_to_m02_couplers_ARREADY = M_AXI_arready;
  assign m02_couplers_to_m02_couplers_ARVALID = S_AXI_arvalid;
  assign m02_couplers_to_m02_couplers_AWADDR = S_AXI_awaddr[31:0];
  assign m02_couplers_to_m02_couplers_AWREADY = M_AXI_awready;
  assign m02_couplers_to_m02_couplers_AWVALID = S_AXI_awvalid;
  assign m02_couplers_to_m02_couplers_BREADY = S_AXI_bready;
  assign m02_couplers_to_m02_couplers_BRESP = M_AXI_bresp[1:0];
  assign m02_couplers_to_m02_couplers_BVALID = M_AXI_bvalid;
  assign m02_couplers_to_m02_couplers_RDATA = M_AXI_rdata[31:0];
  assign m02_couplers_to_m02_couplers_RREADY = S_AXI_rready;
  assign m02_couplers_to_m02_couplers_RRESP = M_AXI_rresp[1:0];
  assign m02_couplers_to_m02_couplers_RVALID = M_AXI_rvalid;
  assign m02_couplers_to_m02_couplers_WDATA = S_AXI_wdata[31:0];
  assign m02_couplers_to_m02_couplers_WREADY = M_AXI_wready;
  assign m02_couplers_to_m02_couplers_WSTRB = S_AXI_wstrb[3:0];
  assign m02_couplers_to_m02_couplers_WVALID = S_AXI_wvalid;
endmodule

module m03_couplers_imp_1T7AT9L
   (M_ACLK,
    M_ARESETN,
    M_AXI_araddr,
    M_AXI_arready,
    M_AXI_arvalid,
    M_AXI_awaddr,
    M_AXI_awready,
    M_AXI_awvalid,
    M_AXI_bready,
    M_AXI_bresp,
    M_AXI_bvalid,
    M_AXI_rdata,
    M_AXI_rready,
    M_AXI_rresp,
    M_AXI_rvalid,
    M_AXI_wdata,
    M_AXI_wready,
    M_AXI_wstrb,
    M_AXI_wvalid,
    S_ACLK,
    S_ARESETN,
    S_AXI_araddr,
    S_AXI_arready,
    S_AXI_arvalid,
    S_AXI_awaddr,
    S_AXI_awready,
    S_AXI_awvalid,
    S_AXI_bready,
    S_AXI_bresp,
    S_AXI_bvalid,
    S_AXI_rdata,
    S_AXI_rready,
    S_AXI_rresp,
    S_AXI_rvalid,
    S_AXI_wdata,
    S_AXI_wready,
    S_AXI_wstrb,
    S_AXI_wvalid);
  input M_ACLK;
  input M_ARESETN;
  output [31:0]M_AXI_araddr;
  input M_AXI_arready;
  output M_AXI_arvalid;
  output [31:0]M_AXI_awaddr;
  input M_AXI_awready;
  output M_AXI_awvalid;
  output M_AXI_bready;
  input [1:0]M_AXI_bresp;
  input M_AXI_bvalid;
  input [31:0]M_AXI_rdata;
  output M_AXI_rready;
  input [1:0]M_AXI_rresp;
  input M_AXI_rvalid;
  output [31:0]M_AXI_wdata;
  input M_AXI_wready;
  output [3:0]M_AXI_wstrb;
  output M_AXI_wvalid;
  input S_ACLK;
  input S_ARESETN;
  input [31:0]S_AXI_araddr;
  output S_AXI_arready;
  input S_AXI_arvalid;
  input [31:0]S_AXI_awaddr;
  output S_AXI_awready;
  input S_AXI_awvalid;
  input S_AXI_bready;
  output [1:0]S_AXI_bresp;
  output S_AXI_bvalid;
  output [31:0]S_AXI_rdata;
  input S_AXI_rready;
  output [1:0]S_AXI_rresp;
  output S_AXI_rvalid;
  input [31:0]S_AXI_wdata;
  output S_AXI_wready;
  input [3:0]S_AXI_wstrb;
  input S_AXI_wvalid;

  wire [31:0]m03_couplers_to_m03_couplers_ARADDR;
  wire m03_couplers_to_m03_couplers_ARREADY;
  wire m03_couplers_to_m03_couplers_ARVALID;
  wire [31:0]m03_couplers_to_m03_couplers_AWADDR;
  wire m03_couplers_to_m03_couplers_AWREADY;
  wire m03_couplers_to_m03_couplers_AWVALID;
  wire m03_couplers_to_m03_couplers_BREADY;
  wire [1:0]m03_couplers_to_m03_couplers_BRESP;
  wire m03_couplers_to_m03_couplers_BVALID;
  wire [31:0]m03_couplers_to_m03_couplers_RDATA;
  wire m03_couplers_to_m03_couplers_RREADY;
  wire [1:0]m03_couplers_to_m03_couplers_RRESP;
  wire m03_couplers_to_m03_couplers_RVALID;
  wire [31:0]m03_couplers_to_m03_couplers_WDATA;
  wire m03_couplers_to_m03_couplers_WREADY;
  wire [3:0]m03_couplers_to_m03_couplers_WSTRB;
  wire m03_couplers_to_m03_couplers_WVALID;

  assign M_AXI_araddr[31:0] = m03_couplers_to_m03_couplers_ARADDR;
  assign M_AXI_arvalid = m03_couplers_to_m03_couplers_ARVALID;
  assign M_AXI_awaddr[31:0] = m03_couplers_to_m03_couplers_AWADDR;
  assign M_AXI_awvalid = m03_couplers_to_m03_couplers_AWVALID;
  assign M_AXI_bready = m03_couplers_to_m03_couplers_BREADY;
  assign M_AXI_rready = m03_couplers_to_m03_couplers_RREADY;
  assign M_AXI_wdata[31:0] = m03_couplers_to_m03_couplers_WDATA;
  assign M_AXI_wstrb[3:0] = m03_couplers_to_m03_couplers_WSTRB;
  assign M_AXI_wvalid = m03_couplers_to_m03_couplers_WVALID;
  assign S_AXI_arready = m03_couplers_to_m03_couplers_ARREADY;
  assign S_AXI_awready = m03_couplers_to_m03_couplers_AWREADY;
  assign S_AXI_bresp[1:0] = m03_couplers_to_m03_couplers_BRESP;
  assign S_AXI_bvalid = m03_couplers_to_m03_couplers_BVALID;
  assign S_AXI_rdata[31:0] = m03_couplers_to_m03_couplers_RDATA;
  assign S_AXI_rresp[1:0] = m03_couplers_to_m03_couplers_RRESP;
  assign S_AXI_rvalid = m03_couplers_to_m03_couplers_RVALID;
  assign S_AXI_wready = m03_couplers_to_m03_couplers_WREADY;
  assign m03_couplers_to_m03_couplers_ARADDR = S_AXI_araddr[31:0];
  assign m03_couplers_to_m03_couplers_ARREADY = M_AXI_arready;
  assign m03_couplers_to_m03_couplers_ARVALID = S_AXI_arvalid;
  assign m03_couplers_to_m03_couplers_AWADDR = S_AXI_awaddr[31:0];
  assign m03_couplers_to_m03_couplers_AWREADY = M_AXI_awready;
  assign m03_couplers_to_m03_couplers_AWVALID = S_AXI_awvalid;
  assign m03_couplers_to_m03_couplers_BREADY = S_AXI_bready;
  assign m03_couplers_to_m03_couplers_BRESP = M_AXI_bresp[1:0];
  assign m03_couplers_to_m03_couplers_BVALID = M_AXI_bvalid;
  assign m03_couplers_to_m03_couplers_RDATA = M_AXI_rdata[31:0];
  assign m03_couplers_to_m03_couplers_RREADY = S_AXI_rready;
  assign m03_couplers_to_m03_couplers_RRESP = M_AXI_rresp[1:0];
  assign m03_couplers_to_m03_couplers_RVALID = M_AXI_rvalid;
  assign m03_couplers_to_m03_couplers_WDATA = S_AXI_wdata[31:0];
  assign m03_couplers_to_m03_couplers_WREADY = M_AXI_wready;
  assign m03_couplers_to_m03_couplers_WSTRB = S_AXI_wstrb[3:0];
  assign m03_couplers_to_m03_couplers_WVALID = S_AXI_wvalid;
endmodule

module m04_couplers_imp_13PXFXL
   (M_ACLK,
    M_ARESETN,
    M_AXI_araddr,
    M_AXI_arready,
    M_AXI_arvalid,
    M_AXI_awaddr,
    M_AXI_awready,
    M_AXI_awvalid,
    M_AXI_bready,
    M_AXI_bresp,
    M_AXI_bvalid,
    M_AXI_rdata,
    M_AXI_rready,
    M_AXI_rresp,
    M_AXI_rvalid,
    M_AXI_wdata,
    M_AXI_wready,
    M_AXI_wstrb,
    M_AXI_wvalid,
    S_ACLK,
    S_ARESETN,
    S_AXI_araddr,
    S_AXI_arready,
    S_AXI_arvalid,
    S_AXI_awaddr,
    S_AXI_awready,
    S_AXI_awvalid,
    S_AXI_bready,
    S_AXI_bresp,
    S_AXI_bvalid,
    S_AXI_rdata,
    S_AXI_rready,
    S_AXI_rresp,
    S_AXI_rvalid,
    S_AXI_wdata,
    S_AXI_wready,
    S_AXI_wstrb,
    S_AXI_wvalid);
  input M_ACLK;
  input M_ARESETN;
  output [31:0]M_AXI_araddr;
  input M_AXI_arready;
  output M_AXI_arvalid;
  output [31:0]M_AXI_awaddr;
  input M_AXI_awready;
  output M_AXI_awvalid;
  output M_AXI_bready;
  input [1:0]M_AXI_bresp;
  input M_AXI_bvalid;
  input [31:0]M_AXI_rdata;
  output M_AXI_rready;
  input [1:0]M_AXI_rresp;
  input M_AXI_rvalid;
  output [31:0]M_AXI_wdata;
  input M_AXI_wready;
  output [3:0]M_AXI_wstrb;
  output M_AXI_wvalid;
  input S_ACLK;
  input S_ARESETN;
  input [31:0]S_AXI_araddr;
  output S_AXI_arready;
  input S_AXI_arvalid;
  input [31:0]S_AXI_awaddr;
  output S_AXI_awready;
  input S_AXI_awvalid;
  input S_AXI_bready;
  output [1:0]S_AXI_bresp;
  output S_AXI_bvalid;
  output [31:0]S_AXI_rdata;
  input S_AXI_rready;
  output [1:0]S_AXI_rresp;
  output S_AXI_rvalid;
  input [31:0]S_AXI_wdata;
  output S_AXI_wready;
  input [3:0]S_AXI_wstrb;
  input S_AXI_wvalid;

  wire [31:0]m04_couplers_to_m04_couplers_ARADDR;
  wire m04_couplers_to_m04_couplers_ARREADY;
  wire m04_couplers_to_m04_couplers_ARVALID;
  wire [31:0]m04_couplers_to_m04_couplers_AWADDR;
  wire m04_couplers_to_m04_couplers_AWREADY;
  wire m04_couplers_to_m04_couplers_AWVALID;
  wire m04_couplers_to_m04_couplers_BREADY;
  wire [1:0]m04_couplers_to_m04_couplers_BRESP;
  wire m04_couplers_to_m04_couplers_BVALID;
  wire [31:0]m04_couplers_to_m04_couplers_RDATA;
  wire m04_couplers_to_m04_couplers_RREADY;
  wire [1:0]m04_couplers_to_m04_couplers_RRESP;
  wire m04_couplers_to_m04_couplers_RVALID;
  wire [31:0]m04_couplers_to_m04_couplers_WDATA;
  wire m04_couplers_to_m04_couplers_WREADY;
  wire [3:0]m04_couplers_to_m04_couplers_WSTRB;
  wire m04_couplers_to_m04_couplers_WVALID;

  assign M_AXI_araddr[31:0] = m04_couplers_to_m04_couplers_ARADDR;
  assign M_AXI_arvalid = m04_couplers_to_m04_couplers_ARVALID;
  assign M_AXI_awaddr[31:0] = m04_couplers_to_m04_couplers_AWADDR;
  assign M_AXI_awvalid = m04_couplers_to_m04_couplers_AWVALID;
  assign M_AXI_bready = m04_couplers_to_m04_couplers_BREADY;
  assign M_AXI_rready = m04_couplers_to_m04_couplers_RREADY;
  assign M_AXI_wdata[31:0] = m04_couplers_to_m04_couplers_WDATA;
  assign M_AXI_wstrb[3:0] = m04_couplers_to_m04_couplers_WSTRB;
  assign M_AXI_wvalid = m04_couplers_to_m04_couplers_WVALID;
  assign S_AXI_arready = m04_couplers_to_m04_couplers_ARREADY;
  assign S_AXI_awready = m04_couplers_to_m04_couplers_AWREADY;
  assign S_AXI_bresp[1:0] = m04_couplers_to_m04_couplers_BRESP;
  assign S_AXI_bvalid = m04_couplers_to_m04_couplers_BVALID;
  assign S_AXI_rdata[31:0] = m04_couplers_to_m04_couplers_RDATA;
  assign S_AXI_rresp[1:0] = m04_couplers_to_m04_couplers_RRESP;
  assign S_AXI_rvalid = m04_couplers_to_m04_couplers_RVALID;
  assign S_AXI_wready = m04_couplers_to_m04_couplers_WREADY;
  assign m04_couplers_to_m04_couplers_ARADDR = S_AXI_araddr[31:0];
  assign m04_couplers_to_m04_couplers_ARREADY = M_AXI_arready;
  assign m04_couplers_to_m04_couplers_ARVALID = S_AXI_arvalid;
  assign m04_couplers_to_m04_couplers_AWADDR = S_AXI_awaddr[31:0];
  assign m04_couplers_to_m04_couplers_AWREADY = M_AXI_awready;
  assign m04_couplers_to_m04_couplers_AWVALID = S_AXI_awvalid;
  assign m04_couplers_to_m04_couplers_BREADY = S_AXI_bready;
  assign m04_couplers_to_m04_couplers_BRESP = M_AXI_bresp[1:0];
  assign m04_couplers_to_m04_couplers_BVALID = M_AXI_bvalid;
  assign m04_couplers_to_m04_couplers_RDATA = M_AXI_rdata[31:0];
  assign m04_couplers_to_m04_couplers_RREADY = S_AXI_rready;
  assign m04_couplers_to_m04_couplers_RRESP = M_AXI_rresp[1:0];
  assign m04_couplers_to_m04_couplers_RVALID = M_AXI_rvalid;
  assign m04_couplers_to_m04_couplers_WDATA = S_AXI_wdata[31:0];
  assign m04_couplers_to_m04_couplers_WREADY = M_AXI_wready;
  assign m04_couplers_to_m04_couplers_WSTRB = S_AXI_wstrb[3:0];
  assign m04_couplers_to_m04_couplers_WVALID = S_AXI_wvalid;
endmodule

module m05_couplers_imp_166WMCP
   (M_ACLK,
    M_ARESETN,
    M_AXI_araddr,
    M_AXI_arprot,
    M_AXI_arready,
    M_AXI_arvalid,
    M_AXI_awaddr,
    M_AXI_awprot,
    M_AXI_awready,
    M_AXI_awvalid,
    M_AXI_bready,
    M_AXI_bresp,
    M_AXI_bvalid,
    M_AXI_rdata,
    M_AXI_rready,
    M_AXI_rresp,
    M_AXI_rvalid,
    M_AXI_wdata,
    M_AXI_wready,
    M_AXI_wstrb,
    M_AXI_wvalid,
    S_ACLK,
    S_ARESETN,
    S_AXI_araddr,
    S_AXI_arprot,
    S_AXI_arready,
    S_AXI_arvalid,
    S_AXI_awaddr,
    S_AXI_awprot,
    S_AXI_awready,
    S_AXI_awvalid,
    S_AXI_bready,
    S_AXI_bresp,
    S_AXI_bvalid,
    S_AXI_rdata,
    S_AXI_rready,
    S_AXI_rresp,
    S_AXI_rvalid,
    S_AXI_wdata,
    S_AXI_wready,
    S_AXI_wstrb,
    S_AXI_wvalid);
  input M_ACLK;
  input M_ARESETN;
  output M_AXI_araddr;
  output M_AXI_arprot;
  input M_AXI_arready;
  output M_AXI_arvalid;
  output M_AXI_awaddr;
  output M_AXI_awprot;
  input M_AXI_awready;
  output M_AXI_awvalid;
  output M_AXI_bready;
  input M_AXI_bresp;
  input M_AXI_bvalid;
  input M_AXI_rdata;
  output M_AXI_rready;
  input M_AXI_rresp;
  input M_AXI_rvalid;
  output M_AXI_wdata;
  input M_AXI_wready;
  output M_AXI_wstrb;
  output M_AXI_wvalid;
  input S_ACLK;
  input S_ARESETN;
  input S_AXI_araddr;
  input S_AXI_arprot;
  output S_AXI_arready;
  input S_AXI_arvalid;
  input S_AXI_awaddr;
  input S_AXI_awprot;
  output S_AXI_awready;
  input S_AXI_awvalid;
  input S_AXI_bready;
  output S_AXI_bresp;
  output S_AXI_bvalid;
  output S_AXI_rdata;
  input S_AXI_rready;
  output S_AXI_rresp;
  output S_AXI_rvalid;
  input S_AXI_wdata;
  output S_AXI_wready;
  input S_AXI_wstrb;
  input S_AXI_wvalid;

  wire m05_couplers_to_m05_couplers_ARADDR;
  wire m05_couplers_to_m05_couplers_ARPROT;
  wire m05_couplers_to_m05_couplers_ARREADY;
  wire m05_couplers_to_m05_couplers_ARVALID;
  wire m05_couplers_to_m05_couplers_AWADDR;
  wire m05_couplers_to_m05_couplers_AWPROT;
  wire m05_couplers_to_m05_couplers_AWREADY;
  wire m05_couplers_to_m05_couplers_AWVALID;
  wire m05_couplers_to_m05_couplers_BREADY;
  wire m05_couplers_to_m05_couplers_BRESP;
  wire m05_couplers_to_m05_couplers_BVALID;
  wire m05_couplers_to_m05_couplers_RDATA;
  wire m05_couplers_to_m05_couplers_RREADY;
  wire m05_couplers_to_m05_couplers_RRESP;
  wire m05_couplers_to_m05_couplers_RVALID;
  wire m05_couplers_to_m05_couplers_WDATA;
  wire m05_couplers_to_m05_couplers_WREADY;
  wire m05_couplers_to_m05_couplers_WSTRB;
  wire m05_couplers_to_m05_couplers_WVALID;

  assign M_AXI_araddr = m05_couplers_to_m05_couplers_ARADDR;
  assign M_AXI_arprot = m05_couplers_to_m05_couplers_ARPROT;
  assign M_AXI_arvalid = m05_couplers_to_m05_couplers_ARVALID;
  assign M_AXI_awaddr = m05_couplers_to_m05_couplers_AWADDR;
  assign M_AXI_awprot = m05_couplers_to_m05_couplers_AWPROT;
  assign M_AXI_awvalid = m05_couplers_to_m05_couplers_AWVALID;
  assign M_AXI_bready = m05_couplers_to_m05_couplers_BREADY;
  assign M_AXI_rready = m05_couplers_to_m05_couplers_RREADY;
  assign M_AXI_wdata = m05_couplers_to_m05_couplers_WDATA;
  assign M_AXI_wstrb = m05_couplers_to_m05_couplers_WSTRB;
  assign M_AXI_wvalid = m05_couplers_to_m05_couplers_WVALID;
  assign S_AXI_arready = m05_couplers_to_m05_couplers_ARREADY;
  assign S_AXI_awready = m05_couplers_to_m05_couplers_AWREADY;
  assign S_AXI_bresp = m05_couplers_to_m05_couplers_BRESP;
  assign S_AXI_bvalid = m05_couplers_to_m05_couplers_BVALID;
  assign S_AXI_rdata = m05_couplers_to_m05_couplers_RDATA;
  assign S_AXI_rresp = m05_couplers_to_m05_couplers_RRESP;
  assign S_AXI_rvalid = m05_couplers_to_m05_couplers_RVALID;
  assign S_AXI_wready = m05_couplers_to_m05_couplers_WREADY;
  assign m05_couplers_to_m05_couplers_ARADDR = S_AXI_araddr;
  assign m05_couplers_to_m05_couplers_ARPROT = S_AXI_arprot;
  assign m05_couplers_to_m05_couplers_ARREADY = M_AXI_arready;
  assign m05_couplers_to_m05_couplers_ARVALID = S_AXI_arvalid;
  assign m05_couplers_to_m05_couplers_AWADDR = S_AXI_awaddr;
  assign m05_couplers_to_m05_couplers_AWPROT = S_AXI_awprot;
  assign m05_couplers_to_m05_couplers_AWREADY = M_AXI_awready;
  assign m05_couplers_to_m05_couplers_AWVALID = S_AXI_awvalid;
  assign m05_couplers_to_m05_couplers_BREADY = S_AXI_bready;
  assign m05_couplers_to_m05_couplers_BRESP = M_AXI_bresp;
  assign m05_couplers_to_m05_couplers_BVALID = M_AXI_bvalid;
  assign m05_couplers_to_m05_couplers_RDATA = M_AXI_rdata;
  assign m05_couplers_to_m05_couplers_RREADY = S_AXI_rready;
  assign m05_couplers_to_m05_couplers_RRESP = M_AXI_rresp;
  assign m05_couplers_to_m05_couplers_RVALID = M_AXI_rvalid;
  assign m05_couplers_to_m05_couplers_WDATA = S_AXI_wdata;
  assign m05_couplers_to_m05_couplers_WREADY = M_AXI_wready;
  assign m05_couplers_to_m05_couplers_WSTRB = S_AXI_wstrb;
  assign m05_couplers_to_m05_couplers_WVALID = S_AXI_wvalid;
endmodule
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
