Louis-VL/PCB-ADVANCED/VIVADO/SpartanMicroBlaze/SpartanMicroBlaze.gen/sources_1/bd/MicroBlazeV2/ip/MicroBlazeV2_mdm_1_0/synth/MicroBlazeV2_mdm_1_0.vhd

-- (c) Copyright 1986-2022 Xilinx, Inc. All Rights Reserved.
-- (c) Copyright 2022-2023 Advanced Micro Devices, Inc. All rights reserved.
-- 
-- This file contains confidential and proprietary information
-- of AMD and is protected under U.S. and international copyright
-- and other intellectual property laws.
-- 
-- DISCLAIMER
-- This disclaimer is not a license and does not grant any
-- rights to the materials distributed herewith. Except as
-- otherwise provided in a valid license issued to you by
-- AMD, and to the maximum extent permitted by applicable
-- law: (1) THESE MATERIALS ARE MADE AVAILABLE "AS IS" AND
-- WITH ALL FAULTS, AND XILINX HEREBY DISCLAIMS ALL WARRANTIES
-- AND CONDITIONS, EXPRESS, IMPLIED, OR STATUTORY, INCLUDING
-- BUT NOT LIMITED TO WARRANTIES OF MERCHANTABILITY, NON-
-- INFRINGEMENT, OR FITNESS FOR ANY PARTICULAR PURPOSE; and
-- (2) AMD shall not be liable (whether in contract or tort,
-- including negligence, or under any other theory of
-- liability) for any loss or damage of any kind or nature
-- related to, arising under or in connection with these
-- materials, including for any direct, or any indirect,
-- special, incidental, or consequential loss or damage
-- (including loss of data, profits, goodwill, or any type of
-- loss or damage suffered as a result of any action brought
-- by a third party) even if such damage or loss was
-- reasonably foreseeable or AMD had been advised of the
-- possibility of the same.
-- 
-- CRITICAL APPLICATIONS
-- AMD products are not designed or intended to be fail-
-- safe, or for use in any application requiring fail-safe
-- performance, such as life-support or safety devices or
-- systems, Class III medical devices, nuclear facilities,
-- applications related to the deployment of airbags, or any
-- other applications that could lead to death, personal
-- injury, or severe property or environmental damage
-- (individually and collectively, "Critical
-- Applications"). Customer assumes the sole risk and
-- liability of any use of AMD products in Critical
-- Applications, subject only to applicable laws and
-- regulations governing limitations on product liability.
-- 
-- THIS COPYRIGHT NOTICE AND DISCLAIMER MUST BE RETAINED AS
-- PART OF THIS FILE AT ALL TIMES.
-- 
-- DO NOT MODIFY THIS FILE.

-- IP VLNV: xilinx.com:ip:mdm:3.2
-- IP Revision: 24

LIBRARY ieee;
USE ieee.std_logic_1164.ALL;
USE ieee.numeric_std.ALL;

LIBRARY mdm_v3_2_24;
USE mdm_v3_2_24.MDM;

ENTITY MicroBlazeV2_mdm_1_0 IS
  PORT (
    Debug_SYS_Rst : OUT STD_LOGIC;
    Dbg_Clk_0 : OUT STD_LOGIC;
    Dbg_TDI_0 : OUT STD_LOGIC;
    Dbg_TDO_0 : IN STD_LOGIC;
    Dbg_Reg_En_0 : OUT STD_LOGIC_VECTOR(0 TO 7);
    Dbg_Capture_0 : OUT STD_LOGIC;
    Dbg_Shift_0 : OUT STD_LOGIC;
    Dbg_Update_0 : OUT STD_LOGIC;
    Dbg_Rst_0 : OUT STD_LOGIC;
    Dbg_Disable_0 : OUT STD_LOGIC
  );
END MicroBlazeV2_mdm_1_0;

ARCHITECTURE MicroBlazeV2_mdm_1_0_arch OF MicroBlazeV2_mdm_1_0 IS
  ATTRIBUTE DowngradeIPIdentifiedWarnings : STRING;
  ATTRIBUTE DowngradeIPIdentifiedWarnings OF MicroBlazeV2_mdm_1_0_arch: ARCHITECTURE IS "yes";
  COMPONENT MDM IS
    GENERIC (
      C_FAMILY : STRING;
      C_DEVICE : STRING;
      C_REVISION : STRING;
      C_JTAG_CHAIN : INTEGER;
      C_USE_BSCAN : INTEGER;
      C_BSCANID : INTEGER;
      C_DEBUG_INTERFACE : INTEGER;
      C_USE_CONFIG_RESET : INTEGER;
      C_AVOID_PRIMITIVES : INTEGER;
      C_INTERCONNECT : INTEGER;
      C_MB_DBG_PORTS : INTEGER;
      C_USE_UART : INTEGER;
      C_DBG_REG_ACCESS : INTEGER;
      C_DBG_MEM_ACCESS : INTEGER;
      C_USE_CROSS_TRIGGER : INTEGER;
      C_EXT_TRIG_RESET_VALUE : STD_LOGIC_VECTOR;
      C_TRACE_OUTPUT : INTEGER;
      C_TRACE_DATA_WIDTH : INTEGER;
      C_TRACE_CLK_FREQ_HZ : INTEGER;
      C_TRACE_CLK_OUT_PHASE : INTEGER;
      C_TRACE_ASYNC_RESET : INTEGER;
      C_TRACE_PROTOCOL : INTEGER;
      C_TRACE_ID : INTEGER;
      C_S_AXI_ADDR_WIDTH : INTEGER;
      C_S_AXI_DATA_WIDTH : INTEGER;
      C_S_AXI_ACLK_FREQ_HZ : INTEGER;
      C_M_AXI_ADDR_WIDTH : INTEGER;
      C_M_AXI_DATA_WIDTH : INTEGER;
      C_M_AXI_THREAD_ID_WIDTH : INTEGER;
      C_ADDR_SIZE : INTEGER;
      C_DATA_SIZE : INTEGER;
      C_LMB_PROTOCOL : INTEGER;
      C_M_AXIS_DATA_WIDTH : INTEGER;
      C_M_AXIS_ID_WIDTH : INTEGER
    );
    PORT (
      Config_Reset : IN STD_LOGIC;
      Scan_Reset : IN STD_LOGIC;
      Scan_Reset_Sel : IN STD_LOGIC;
      Scan_En : IN STD_LOGIC;
      S_AXI_ACLK : IN STD_LOGIC;
      S_AXI_ARESETN : IN STD_LOGIC;
      M_AXI_ACLK : IN STD_LOGIC;
      M_AXI_ARESETN : IN STD_LOGIC;
      M_AXIS_ACLK : IN STD_LOGIC;
      M_AXIS_ARESETN : IN STD_LOGIC;
      Interrupt : OUT STD_LOGIC;
      Ext_BRK : OUT STD_LOGIC;
      Ext_NM_BRK : OUT STD_LOGIC;
      Debug_SYS_Rst : OUT STD_LOGIC;
      Trig_In_0 : IN STD_LOGIC;
      Trig_Ack_In_0 : OUT STD_LOGIC;
      Trig_Out_0 : OUT STD_LOGIC;
      Trig_Ack_Out_0 : IN STD_LOGIC;
      Trig_In_1 : IN STD_LOGIC;
      Trig_Ack_In_1 : OUT STD_LOGIC;
      Trig_Out_1 : OUT STD_LOGIC;
      Trig_Ack_Out_1 : IN STD_LOGIC;
      Trig_In_2 : IN STD_LOGIC;
      Trig_Ack_In_2 : OUT STD_LOGIC;
      Trig_Out_2 : OUT STD_LOGIC;
      Trig_Ack_Out_2 : IN STD_LOGIC;
      Trig_In_3 : IN STD_LOGIC;
      Trig_Ack_In_3 : OUT STD_LOGIC;
      Trig_Out_3 : OUT STD_LOGIC;
      Trig_Ack_Out_3 : IN STD_LOGIC;
      S_AXI_AWADDR : IN STD_LOGIC_VECTOR(3 DOWNTO 0);
      S_AXI_AWVALID : IN STD_LOGIC;
      S_AXI_AWREADY : OUT STD_LOGIC;
      S_AXI_WDATA : IN STD_LOGIC_VECTOR(31 DOWNTO 0);
      S_AXI_WSTRB : IN STD_LOGIC_VECTOR(3 DOWNTO 0);
      S_AXI_WVALID : IN STD_LOGIC;
      S_AXI_WREADY : OUT STD_LOGIC;
      S_AXI_BRESP : OUT STD_LOGIC_VECTOR(1 DOWNTO 0);
      S_AXI_BVALID : OUT STD_LOGIC;
      S_AXI_BREADY : IN STD_LOGIC;
      S_AXI_ARADDR : IN STD_LOGIC_VECTOR(3 DOWNTO 0);
      S_AXI_ARVALID : IN STD_LOGIC;
      S_AXI_ARREADY : OUT STD_LOGIC;
      S_AXI_RDATA : OUT STD_LOGIC_VECTOR(31 DOWNTO 0);
      S_AXI_RRESP : OUT STD_LOGIC_VECTOR(1 DOWNTO 0);
      S_AXI_RVALID : OUT STD_LOGIC;
      S_AXI_RREADY : IN STD_LOGIC;
      M_AXI_AWID : OUT STD_LOGIC_VECTOR(0 DOWNTO 0);
      M_AXI_AWADDR : OUT STD_LOGIC_VECTOR(31 DOWNTO 0);
      M_AXI_AWLEN : OUT STD_LOGIC_VECTOR(7 DOWNTO 0);
      M_AXI_AWSIZE : OUT STD_LOGIC_VECTOR(2 DOWNTO 0);
      M_AXI_AWBURST : OUT STD_LOGIC_VECTOR(1 DOWNTO 0);
      M_AXI_AWLOCK : OUT STD_LOGIC;
      M_AXI_AWCACHE : OUT STD_LOGIC_VECTOR(3 DOWNTO 0);
      M_AXI_AWPROT : OUT STD_LOGIC_VECTOR(2 DOWNTO 0);
      M_AXI_AWQOS : OUT STD_LOGIC_VECTOR(3 DOWNTO 0);
      M_AXI_AWVALID : OUT STD_LOGIC;
      M_AXI_AWREADY : IN STD_LOGIC;
      M_AXI_WDATA : OUT STD_LOGIC_VECTOR(31 DOWNTO 0);
      M_AXI_WSTRB : OUT STD_LOGIC_VECTOR(3 DOWNTO 0);
      M_AXI_WLAST : OUT STD_LOGIC;
      M_AXI_WVALID : OUT STD_LOGIC;
      M_AXI_WREADY : IN STD_LOGIC;
      M_AXI_BRESP : IN STD_LOGIC_VECTOR(1 DOWNTO 0);
      M_AXI_BID : IN STD_LOGIC_VECTOR(0 DOWNTO 0);
      M_AXI_BVALID : IN STD_LOGIC;
      M_AXI_BREADY : OUT STD_LOGIC;
      M_AXI_ARID : OUT STD_LOGIC_VECTOR(0 DOWNTO 0);
      M_AXI_ARADDR : OUT STD_LOGIC_VECTOR(31 DOWNTO 0);
      M_AXI_ARLEN : OUT STD_LOGIC_VECTOR(7 DOWNTO 0);
      M_AXI_ARSIZE : OUT STD_LOGIC_VECTOR(2 DOWNTO 0);
      M_AXI_ARBURST : OUT STD_LOGIC_VECTOR(1 DOWNTO 0);
      M_AXI_ARLOCK : OUT STD_LOGIC;
      M_AXI_ARCACHE : OUT STD_LOGIC_VECTOR(3 DOWNTO 0);
      M_AXI_ARPROT : OUT STD_LOGIC_VECTOR(2 DOWNTO 0);
      M_AXI_ARQOS : OUT STD_LOGIC_VECTOR(3 DOWNTO 0);
      M_AXI_ARVALID : OUT STD_LOGIC;
      M_AXI_ARREADY : IN STD_LOGIC;
      M_AXI_RID : IN STD_LOGIC_VECTOR(0 DOWNTO 0);
      M_AXI_RDATA : IN STD_LOGIC_VECTOR(31 DOWNTO 0);
      M_AXI_RRESP : IN STD_LOGIC_VECTOR(1 DOWNTO 0);
      M_AXI_RLAST : IN STD_LOGIC;
      M_AXI_RVALID : IN STD_LOGIC;
      M_AXI_RREADY : OUT STD_LOGIC;
      LMB_Data_Addr_0 : OUT STD_LOGIC_VECTOR(0 TO 31);
      LMB_Addr_Strobe_0 : OUT STD_LOGIC;
      LMB_Ready_0 : IN STD_LOGIC;
      LMB_Byte_Enable_0 : OUT STD_LOGIC_VECTOR(0 TO 3);
      LMB_Data_Read_0 : IN STD_LOGIC_VECTOR(0 TO 31);
      LMB_Data_Write_0 : OUT STD_LOGIC_VECTOR(0 TO 31);
      LMB_Read_Strobe_0 : OUT STD_LOGIC;
      LMB_Write_Strobe_0 : OUT STD_LOGIC;
      LMB_CE_0 : IN STD_LOGIC;
      LMB_UE_0 : IN STD_LOGIC;
      LMB_Wait_0 : IN STD_LOGIC;
      LMB_Data_Addr_1 : OUT STD_LOGIC_VECTOR(0 TO 31);
      LMB_Addr_Strobe_1 : OUT STD_LOGIC;
      LMB_Ready_1 : IN STD_LOGIC;
      LMB_Byte_Enable_1 : OUT STD_LOGIC_VECTOR(0 TO 3);
      LMB_Data_Read_1 : IN STD_LOGIC_VECTOR(0 TO 31);
      LMB_Data_Write_1 : OUT STD_LOGIC_VECTOR(0 TO 31);
      LMB_Read_Strobe_1 : OUT STD_LOGIC;
      LMB_Write_Strobe_1 : OUT STD_LOGIC;
      LMB_CE_1 : IN STD_LOGIC;
      LMB_UE_1 : IN STD_LOGIC;
      LMB_Wait_1 : IN STD_LOGIC;
      LMB_Data_Addr_2 : OUT STD_LOGIC_VECTOR(0 TO 31);
      LMB_Addr_Strobe_2 : OUT STD_LOGIC;
      LMB_Ready_2 : IN STD_LOGIC;
      LMB_Byte_Enable_2 : OUT STD_LOGIC_VECTOR(0 TO 3);
      LMB_Data_Read_2 : IN STD_LOGIC_VECTOR(0 TO 31);
      LMB_Data_Write_2 : OUT STD_LOGIC_VECTOR(0 TO 31);
      LMB_Read_Strobe_2 : OUT STD_LOGIC;
      LMB_Write_Strobe_2 : OUT STD_LOGIC;
      LMB_CE_2 : IN STD_LOGIC;
      LMB_UE_2 : IN STD_LOGIC;
      LMB_Wait_2 : IN STD_LOGIC;
      LMB_Data_Addr_3 : OUT STD_LOGIC_VECTOR(0 TO 31);
      LMB_Addr_Strobe_3 : OUT STD_LOGIC;
      LMB_Ready_3 : IN STD_LOGIC;
      LMB_Byte_Enable_3 : OUT STD_LOGIC_VECTOR(0 TO 3);
      LMB_Data_Read_3 : IN STD_LOGIC_VECTOR(0 TO 31);
      LMB_Data_Write_3 : OUT STD_LOGIC_VECTOR(0 TO 31);
      LMB_Read_Strobe_3 : OUT STD_LOGIC;
      LMB_Write_Strobe_3 : OUT STD_LOGIC;
      LMB_CE_3 : IN STD_LOGIC;
      LMB_UE_3 : IN STD_LOGIC;
      LMB_Wait_3 : IN STD_LOGIC;
      LMB_Data_Addr_4 : OUT STD_LOGIC_VECTOR(0 TO 31);
      LMB_Addr_Strobe_4 : OUT STD_LOGIC;
      LMB_Ready_4 : IN STD_LOGIC;
      LMB_Byte_Enable_4 : OUT STD_LOGIC_VECTOR(0 TO 3);
      LMB_Data_Read_4 : IN STD_LOGIC_VECTOR(0 TO 31);
      LMB_Data_Write_4 : OUT STD_LOGIC_VECTOR(0 TO 31);
      LMB_Read_Strobe_4 : OUT STD_LOGIC;
      LMB_Write_Strobe_4 : OUT STD_LOGIC;
      LMB_CE_4 : IN STD_LOGIC;
      LMB_UE_4 : IN STD_LOGIC;
      LMB_Wait_4 : IN STD_LOGIC;
      LMB_Data_Addr_5 : OUT STD_LOGIC_VECTOR(0 TO 31);
      LMB_Addr_Strobe_5 : OUT STD_LOGIC;
      LMB_Ready_5 : IN STD_LOGIC;
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
      LMB_Ready_26 : IN STD_LOGIC;
      LMB_Byte_Enable_26 : OUT STD_LOGIC_VECTOR(0 TO 3);
      LMB_Data_Read_26 : IN STD_LOGIC_VECTOR(0 TO 31);
      LMB_Data_Write_26 : OUT STD_LOGIC_VECTOR(0 TO 31);
      LMB_Read_Strobe_26 : OUT STD_LOGIC;
      LMB_Write_Strobe_26 : OUT STD_LOGIC;
      LMB_CE_26 : IN STD_LOGIC;
      LMB_UE_26 : IN STD_LOGIC;
      LMB_Wait_26 : IN STD_LOGIC;
      LMB_Data_Addr_27 : OUT STD_LOGIC_VECTOR(0 TO 31);
      LMB_Addr_Strobe_27 : OUT STD_LOGIC;
      LMB_Ready_27 : IN STD_LOGIC;
      LMB_Byte_Enable_27 : OUT STD_LOGIC_VECTOR(0 TO 3);
      LMB_Data_Read_27 : IN STD_LOGIC_VECTOR(0 TO 31);
      LMB_Data_Write_27 : OUT STD_LOGIC_VECTOR(0 TO 31);
      LMB_Read_Strobe_27 : OUT STD_LOGIC;
      LMB_Write_Strobe_27 : OUT STD_LOGIC;
      LMB_CE_27 : IN STD_LOGIC;
      LMB_UE_27 : IN STD_LOGIC;
      LMB_Wait_27 : IN STD_LOGIC;
      LMB_Data_Addr_28 : OUT STD_LOGIC_VECTOR(0 TO 31);
      LMB_Addr_Strobe_28 : OUT STD_LOGIC;
      LMB_Ready_28 : IN STD_LOGIC;
      LMB_Byte_Enable_28 : OUT STD_LOGIC_VECTOR(0 TO 3);
      LMB_Data_Read_28 : IN STD_LOGIC_VECTOR(0 TO 31);
      LMB_Data_Write_28 : OUT STD_LOGIC_VECTOR(0 TO 31);
      LMB_Read_Strobe_28 : OUT STD_LOGIC;
      LMB_Write_Strobe_28 : OUT STD_LOGIC;
      LMB_CE_28 : IN STD_LOGIC;
      LMB_UE_28 : IN STD_LOGIC;
      LMB_Wait_28 : IN STD_LOGIC;
      LMB_Data_Addr_29 : OUT STD_LOGIC_VECTOR(0 TO 31);
      LMB_Addr_Strobe_29 : OUT STD_LOGIC;
      LMB_Ready_29 : IN STD_LOGIC;
      LMB_Byte_Enable_29 : OUT STD_LOGIC_VECTOR(0 TO 3);
      LMB_Data_Read_29 : IN STD_LOGIC_VECTOR(0 TO 31);
      LMB_Data_Write_29 : OUT STD_LOGIC_VECTOR(0 TO 31);
      LMB_Read_Strobe_29 : OUT STD_LOGIC;
      LMB_Write_Strobe_29 : OUT STD_LOGIC;
      LMB_CE_29 : IN STD_LOGIC;
      LMB_UE_29 : IN STD_LOGIC;
      LMB_Wait_29 : IN STD_LOGIC;
      LMB_Data_Addr_30 : OUT STD_LOGIC_VECTOR(0 TO 31);
      LMB_Addr_Strobe_30 : OUT STD_LOGIC;
      LMB_Ready_30 : IN STD_LOGIC;
      LMB_Byte_Enable_30 : OUT STD_LOGIC_VECTOR(0 TO 3);
      LMB_Data_Read_30 : IN STD_LOGIC_VECTOR(0 TO 31);
      LMB_Data_Write_30 : OUT STD_LOGIC_VECTOR(0 TO 31);
      LMB_Read_Strobe_30 : OUT STD_LOGIC;
      LMB_Write_Strobe_30 : OUT STD_LOGIC;
      LMB_CE_30 : IN STD_LOGIC;
      LMB_UE_30 : IN STD_LOGIC;
      LMB_Wait_30 : IN STD_LOGIC;
      LMB_Data_Addr_31 : OUT STD_LOGIC_VECTOR(0 TO 31);
      LMB_Addr_Strobe_31 : OUT STD_LOGIC;
      LMB_Ready_31 : IN STD_LOGIC;
      LMB_Byte_Enable_31 : OUT STD_LOGIC_VECTOR(0 TO 3);
      LMB_Data_Read_31 : IN STD_LOGIC_VECTOR(0 TO 31);
      LMB_Data_Write_31 : OUT STD_LOGIC_VECTOR(0 TO 31);
      LMB_Read_Strobe_31 : OUT STD_LOGIC;
      LMB_Write_Strobe_31 : OUT STD_LOGIC;
      LMB_CE_31 : IN STD_LOGIC;
      LMB_UE_31 : IN STD_LOGIC;
      LMB_Wait_31 : IN STD_LOGIC;
      M_AXIS_TDATA : OUT STD_LOGIC_VECTOR(31 DOWNTO 0);
      M_AXIS_TID : OUT STD_LOGIC_VECTOR(6 DOWNTO 0);
      M_AXIS_TREADY : IN STD_LOGIC;
      M_AXIS_TVALID : OUT STD_LOGIC;
      TRACE_CLK_OUT : OUT STD_LOGIC;
      TRACE_CLK : IN STD_LOGIC;
      TRACE_CTL : OUT STD_LOGIC;
      TRACE_DATA : OUT STD_LOGIC_VECTOR(31 DOWNTO 0);
      Dbg_Clk_0 : OUT STD_LOGIC;
      Dbg_TDI_0 : OUT STD_LOGIC;
      Dbg_TDO_0 : IN STD_LOGIC;
      Dbg_Reg_En_0 : OUT STD_LOGIC_VECTOR(0 TO 7);
      Dbg_Capture_0 : OUT STD_LOGIC;
      Dbg_Shift_0 : OUT STD_LOGIC;
      Dbg_Update_0 : OUT STD_LOGIC;
      Dbg_Rst_0 : OUT STD_LOGIC;
      Dbg_Trig_In_0 : IN STD_LOGIC_VECTOR(0 TO 7);
      Dbg_Trig_Ack_In_0 : OUT STD_LOGIC_VECTOR(0 TO 7);
      Dbg_Trig_Out_0 : OUT STD_LOGIC_VECTOR(0 TO 7);
      Dbg_Trig_Ack_Out_0 : IN STD_LOGIC_VECTOR(0 TO 7);
      Dbg_TrClk_0 : OUT STD_LOGIC;
      Dbg_TrData_0 : IN STD_LOGIC_VECTOR(0 TO 35);
      Dbg_TrReady_0 : OUT STD_LOGIC;
      Dbg_TrValid_0 : IN STD_LOGIC;
      Dbg_Disable_0 : OUT STD_LOGIC;
      Dbg_AWADDR_0 : OUT STD_LOGIC_VECTOR(14 DOWNTO 2);
      Dbg_AWVALID_0 : OUT STD_LOGIC;
      Dbg_AWREADY_0 : IN STD_LOGIC;
      Dbg_WDATA_0 : OUT STD_LOGIC_VECTOR(31 DOWNTO 0);
      Dbg_WVALID_0 : OUT STD_LOGIC;
      Dbg_WREADY_0 : IN STD_LOGIC;
      Dbg_BRESP_0 : IN STD_LOGIC_VECTOR(1 DOWNTO 0);
      Dbg_BVALID_0 : IN STD_LOGIC;
      Dbg_BREADY_0 : OUT STD_LOGIC;
      Dbg_ARADDR_0 : OUT STD_LOGIC_VECTOR(14 DOWNTO 2);
      Dbg_ARVALID_0 : OUT STD_LOGIC;
      Dbg_ARREADY_0 : IN STD_LOGIC;
      Dbg_RDATA_0 : IN STD_LOGIC_VECTOR(31 DOWNTO 0);
      Dbg_RRESP_0 : IN STD_LOGIC_VECTOR(1 DOWNTO 0);
      Dbg_RVALID_0 : IN STD_LOGIC;
      Dbg_RREADY_0 : OUT STD_LOGIC;
      Dbg_Clk_1 : OUT STD_LOGIC;
      Dbg_TDI_1 : OUT STD_LOGIC;
      Dbg_TDO_1 : IN STD_LOGIC;
      Dbg_Reg_En_1 : OUT STD_LOGIC_VECTOR(0 TO 7);
      Dbg_Capture_1 : OUT STD_LOGIC;
      Dbg_Shift_1 : OUT STD_LOGIC;
      Dbg_Update_1 : OUT STD_LOGIC;
      Dbg_Rst_1 : OUT STD_LOGIC;
      Dbg_Trig_In_1 : IN STD_LOGIC_VECTOR(0 TO 7);
      Dbg_Trig_Ack_In_1 : OUT STD_LOGIC_VECTOR(0 TO 7);
      Dbg_Trig_Out_1 : OUT STD_LOGIC_VECTOR(0 TO 7);
      Dbg_Trig_Ack_Out_1 : IN STD_LOGIC_VECTOR(0 TO 7);
      Dbg_TrClk_1 : OUT STD_LOGIC;
      Dbg_TrData_1 : IN STD_LOGIC_VECTOR(0 TO 35);
      Dbg_TrReady_1 : OUT STD_LOGIC;
      Dbg_TrValid_1 : IN STD_LOGIC;
      Dbg_Disable_1 : OUT STD_LOGIC;
      Dbg_AWADDR_1 : OUT STD_LOGIC_VECTOR(14 DOWNTO 2);
      Dbg_AWVALID_1 : OUT STD_LOGIC;
      Dbg_AWREADY_1 : IN STD_LOGIC;
      Dbg_WDATA_1 : OUT STD_LOGIC_VECTOR(31 DOWNTO 0);
      Dbg_WVALID_1 : OUT STD_LOGIC;
      Dbg_WREADY_1 : IN STD_LOGIC;
      Dbg_BRESP_1 : IN STD_LOGIC_VECTOR(1 DOWNTO 0);
      Dbg_BVALID_1 : IN STD_LOGIC;
      Dbg_BREADY_1 : OUT STD_LOGIC;
      Dbg_ARADDR_1 : OUT STD_LOGIC_VECTOR(14 DOWNTO 2);
      Dbg_ARVALID_1 : OUT STD_LOGIC;
      Dbg_ARREADY_1 : IN STD_LOGIC;
      Dbg_RDATA_1 : IN STD_LOGIC_VECTOR(31 DOWNTO 0);
      Dbg_RRESP_1 : IN STD_LOGIC_VECTOR(1 DOWNTO 0);
      Dbg_RVALID_1 : IN STD_LOGIC;
      Dbg_RREADY_1 : OUT STD_LOGIC;
      Dbg_Clk_2 : OUT STD_LOGIC;
      Dbg_TDI_2 : OUT STD_LOGIC;
      Dbg_TDO_2 : IN STD_LOGIC;
      Dbg_Reg_En_2 : OUT STD_LOGIC_VECTOR(0 TO 7);
      Dbg_Capture_2 : OUT STD_LOGIC;
      Dbg_Shift_2 : OUT STD_LOGIC;
      Dbg_Update_2 : OUT STD_LOGIC;
      Dbg_Rst_2 : OUT STD_LOGIC;
      Dbg_Trig_In_2 : IN STD_LOGIC_VECTOR(0 TO 7);
      Dbg_Trig_Ack_In_2 : OUT STD_LOGIC_VECTOR(0 TO 7);
      Dbg_Trig_Out_2 : OUT STD_LOGIC_VECTOR(0 TO 7);
      Dbg_Trig_Ack_Out_2 : IN STD_LOGIC_VECTOR(0 TO 7);
      Dbg_TrClk_2 : OUT STD_LOGIC;
      Dbg_TrData_2 : IN STD_LOGIC_VECTOR(0 TO 35);
      Dbg_TrReady_2 : OUT STD_LOGIC;
      Dbg_TrValid_2 : IN STD_LOGIC;
      Dbg_Disable_2 : OUT STD_LOGIC;
      Dbg_AWADDR_2 : OUT STD_LOGIC_VECTOR(14 DOWNTO 2);
      Dbg_AWVALID_2 : OUT STD_LOGIC;
      Dbg_AWREADY_2 : IN STD_LOGIC;
      Dbg_WDATA_2 : OUT STD_LOGIC_VECTOR(31 DOWNTO 0);
      Dbg_WVALID_2 : OUT STD_LOGIC;
      Dbg_WREADY_2 : IN STD_LOGIC;
      Dbg_BRESP_2 : IN STD_LOGIC_VECTOR(1 DOWNTO 0);
      Dbg_BVALID_2 : IN STD_LOGIC;
      Dbg_BREADY_2 : OUT STD_LOGIC;
      Dbg_ARADDR_2 : OUT STD_LOGIC_VECTOR(14 DOWNTO 2);
      Dbg_ARVALID_2 : OUT STD_LOGIC;
      Dbg_ARREADY_2 : IN STD_LOGIC;
      Dbg_RDATA_2 : IN STD_LOGIC_VECTOR(31 DOWNTO 0);
      Dbg_RRESP_2 : IN STD_LOGIC_VECTOR(1 DOWNTO 0);
      Dbg_RVALID_2 : IN STD_LOGIC;
      Dbg_RREADY_2 : OUT STD_LOGIC;
      Dbg_Clk_3 : OUT STD_LOGIC;
      Dbg_TDI_3 : OUT STD_LOGIC;
      Dbg_TDO_3 : IN STD_LOGIC;
      Dbg_Reg_En_3 : OUT STD_LOGIC_VECTOR(0 TO 7);
      Dbg_Capture_3 : OUT STD_LOGIC;
      Dbg_Shift_3 : OUT STD_LOGIC;
      Dbg_Update_3 : OUT STD_LOGIC;
      Dbg_Rst_3 : OUT STD_LOGIC;
      Dbg_Trig_In_3 : IN STD_LOGIC_VECTOR(0 TO 7);
      Dbg_Trig_Ack_In_3 : OUT STD_LOGIC_VECTOR(0 TO 7);
      Dbg_Trig_Out_3 : OUT STD_LOGIC_VECTOR(0 TO 7);
      Dbg_Trig_Ack_Out_3 : IN STD_LOGIC_VECTOR(0 TO 7);
      Dbg_TrClk_3 : OUT STD_LOGIC;
      Dbg_TrData_3 : IN STD_LOGIC_VECTOR(0 TO 35);
      Dbg_TrReady_3 : OUT STD_LOGIC;
      Dbg_TrValid_3 : IN STD_LOGIC;
      Dbg_Disable_3 : OUT STD_LOGIC;
      Dbg_AWADDR_3 : OUT STD_LOGIC_VECTOR(14 DOWNTO 2);
      Dbg_AWVALID_3 : OUT STD_LOGIC;
      Dbg_AWREADY_3 : IN STD_LOGIC;
      Dbg_WDATA_3 : OUT STD_LOGIC_VECTOR(31 DOWNTO 0);
      Dbg_WVALID_3 : OUT STD_LOGIC;
      Dbg_WREADY_3 : IN STD_LOGIC;
      Dbg_BRESP_3 : IN STD_LOGIC_VECTOR(1 DOWNTO 0);
      Dbg_BVALID_3 : IN STD_LOGIC;
      Dbg_BREADY_3 : OUT STD_LOGIC;
      Dbg_ARADDR_3 : OUT STD_LOGIC_VECTOR(14 DOWNTO 2);
      Dbg_ARVALID_3 : OUT STD_LOGIC;
      Dbg_ARREADY_3 : IN STD_LOGIC;
      Dbg_RDATA_3 : IN STD_LOGIC_VECTOR(31 DOWNTO 0);
      Dbg_RRESP_3 : IN STD_LOGIC_VECTOR(1 DOWNTO 0);
      Dbg_RVALID_3 : IN STD_LOGIC;
      Dbg_RREADY_3 : OUT STD_LOGIC;
      Dbg_Clk_4 : OUT STD_LOGIC;
      Dbg_TDI_4 : OUT STD_LOGIC;
      Dbg_TDO_4 : IN STD_LOGIC;
      Dbg_Reg_En_4 : OUT STD_LOGIC_VECTOR(0 TO 7);
      Dbg_Capture_4 : OUT STD_LOGIC;
      Dbg_Shift_4 : OUT STD_LOGIC;
      Dbg_Update_4 : OUT STD_LOGIC;
      Dbg_Rst_4 : OUT STD_LOGIC;
      Dbg_Trig_In_4 : IN STD_LOGIC_VECTOR(0 TO 7);
      Dbg_Trig_Ack_In_4 : OUT STD_LOGIC_VECTOR(0 TO 7);
      Dbg_Trig_Out_4 : OUT STD_LOGIC_VECTOR(0 TO 7);
      Dbg_Trig_Ack_Out_4 : IN STD_LOGIC_VECTOR(0 TO 7);
      Dbg_TrClk_4 : OUT STD_LOGIC;
      Dbg_TrData_4 : IN STD_LOGIC_VECTOR(0 TO 35);
      Dbg_TrReady_4 : OUT STD_LOGIC;
      Dbg_TrValid_4 : IN STD_LOGIC;
      Dbg_Disable_4 : OUT STD_LOGIC;
      Dbg_AWADDR_4 : OUT STD_LOGIC_VECTOR(14 DOWNTO 2);
      Dbg_AWVALID_4 : OUT STD_LOGIC;
      Dbg_AWREADY_4 : IN STD_LOGIC;
      Dbg_WDATA_4 : OUT STD_LOGIC_VECTOR(31 DOWNTO 0);
      Dbg_WVALID_4 : OUT STD_LOGIC;
      Dbg_WREADY_4 : IN STD_LOGIC;
      Dbg_BRESP_4 : IN STD_LOGIC_VECTOR(1 DOWNTO 0);
      Dbg_BVALID_4 : IN STD_LOGIC;
      Dbg_BREADY_4 : OUT STD_LOGIC;
      Dbg_ARADDR_4 : OUT STD_LOGIC_VECTOR(14 DOWNTO 2);
      Dbg_ARVALID_4 : OUT STD_LOGIC;
      Dbg_ARREADY_4 : IN STD_LOGIC;
      Dbg_RDATA_4 : IN STD_LOGIC_VECTOR(31 DOWNTO 0);
      Dbg_RRESP_4 : IN STD_LOGIC_VECTOR(1 DOWNTO 0);
      Dbg_RVALID_4 : IN STD_LOGIC;
      Dbg_RREADY_4 : OUT STD_LOGIC;
      Dbg_Clk_5 : OUT STD_LOGIC;
      Dbg_TDI_5 : OUT STD_LOGIC;
      Dbg_TDO_5 : IN STD_LOGIC;
      Dbg_Reg_En_5 : OUT STD_LOGIC_VECTOR(0 TO 7);
      Dbg_Capture_5 : OUT STD_LOGIC;
      Dbg_Shift_5 : OUT STD_LOGIC;
      Dbg_Update_5 : OUT STD_LOGIC;
      Dbg_Rst_5 : OUT STD_LOGIC;
      Dbg_Trig_In_5 : IN STD_LOGIC_VECTOR(0 TO 7);
      Dbg_Trig_Ack_In_5 : OUT STD_LOGIC_VECTOR(0 TO 7);
      Dbg_Trig_Out_5 : OUT STD_LOGIC_VECTOR(0 TO 7);
      Dbg_Trig_Ack_Out_5 : IN STD_LOGIC_VECTOR(0 TO 7);
      Dbg_TrClk_5 : OUT STD_LOGIC;
      Dbg_TrData_5 : IN STD_LOGIC_VECTOR(0 TO 35);
      Dbg_TrReady_5 : OUT STD_LOGIC;
      Dbg_TrValid_5 : IN STD_LOGIC;
      Dbg_Disable_5 : OUT STD_LOGIC;
      Dbg_AWADDR_5 : OUT STD_LOGIC_VECTOR(14 DOWNTO 2);
      Dbg_AWVALID_5 : OUT STD_LOGIC;
      Dbg_AWREADY_5 : IN STD_LOGIC;
      Dbg_WDATA_5 : OUT STD_LOGIC_VECTOR(31 DOWNTO 0);
      Dbg_WVALID_5 : OUT STD_LOGIC;
      Dbg_WREADY_5 : IN STD_LOGIC;
      Dbg_BRESP_5 : IN STD_LOGIC_VECTOR(1 DOWNTO 0);
      Dbg_BVALID_5 : IN STD_LOGIC;
      Dbg_BREADY_5 : OUT STD_LOGIC;
      Dbg_ARADDR_5 : OUT STD_LOGIC_VECTOR(14 DOWNTO 2);
      Dbg_ARVALID_5 : OUT STD_LOGIC;
      Dbg_ARREADY_5 : IN STD_LOGIC;
      Dbg_RDATA_5 : IN STD_LOGIC_VECTOR(31 DOWNTO 0);
      Dbg_RRESP_5 : IN STD_LOGIC_VECTOR(1 DOWNTO 0);
      Dbg_RVALID_5 : IN STD_LOGIC;
      Dbg_RREADY_5 : OUT STD_LOGIC;
      Dbg_Clk_6 : OUT STD_LOGIC;
      Dbg_TDI_6 : OUT STD_LOGIC;
      Dbg_TDO_6 : IN STD_LOGIC;
      Dbg_Reg_En_6 : OUT STD_LOGIC_VECTOR(0 TO 7);
      Dbg_Capture_6 : OUT STD_LOGIC;
      Dbg_Shift_6 : OUT STD_LOGIC;
      Dbg_Update_6 : OUT STD_LOGIC;
      Dbg_Rst_6 : OUT STD_LOGIC;
      Dbg_Trig_In_6 : IN STD_LOGIC_VECTOR(0 TO 7);
      Dbg_Trig_Ack_In_6 : OUT STD_LOGIC_VECTOR(0 TO 7);
      Dbg_Trig_Out_6 : OUT STD_LOGIC_VECTOR(0 TO 7);
      Dbg_Trig_Ack_Out_6 : IN STD_LOGIC_VECTOR(0 TO 7);
      Dbg_TrClk_6 : OUT STD_LOGIC;
      Dbg_TrData_6 : IN STD_LOGIC_VECTOR(0 TO 35);
      Dbg_TrReady_6 : OUT STD_LOGIC;
      Dbg_TrValid_6 : IN STD_LOGIC;
      Dbg_Disable_6 : OUT STD_LOGIC;
      Dbg_AWADDR_6 : OUT STD_LOGIC_VECTOR(14 DOWNTO 2);
      Dbg_AWVALID_6 : OUT STD_LOGIC;
      Dbg_AWREADY_6 : IN STD_LOGIC;
      Dbg_WDATA_6 : OUT STD_LOGIC_VECTOR(31 DOWNTO 0);
      Dbg_WVALID_6 : OUT STD_LOGIC;
      Dbg_WREADY_6 : IN STD_LOGIC;
      Dbg_BRESP_6 : IN STD_LOGIC_VECTOR(1 DOWNTO 0);
      Dbg_BVALID_6 : IN STD_LOGIC;
      Dbg_BREADY_6 : OUT STD_LOGIC;
      Dbg_ARADDR_6 : OUT STD_LOGIC_VECTOR(14 DOWNTO 2);
      Dbg_ARVALID_6 : OUT STD_LOGIC;
      Dbg_ARREADY_6 : IN STD_LOGIC;
      Dbg_RDATA_6 : IN STD_LOGIC_VECTOR(31 DOWNTO 0);
      Dbg_RRESP_6 : IN STD_LOGIC_VECTOR(1 DOWNTO 0);
      Dbg_RVALID_6 : IN STD_LOGIC;
      Dbg_RREADY_6 : OUT STD_LOGIC;
      Dbg_Clk_7 : OUT STD_LOGIC;
      Dbg_TDI_7 : OUT STD_LOGIC;
      Dbg_TDO_7 : IN STD_LOGIC;
      Dbg_Reg_En_7 : OUT STD_LOGIC_VECTOR(0 TO 7);
      Dbg_Capture_7 : OUT STD_LOGIC;
      Dbg_Shift_7 : OUT STD_LOGIC;
      Dbg_Update_7 : OUT STD_LOGIC;
      Dbg_Rst_7 : OUT STD_LOGIC;
      Dbg_Trig_In_7 : IN STD_LOGIC_VECTOR(0 TO 7);
      Dbg_Trig_Ack_In_7 : OUT STD_LOGIC_VECTOR(0 TO 7);
      Dbg_Trig_Out_7 : OUT STD_LOGIC_VECTOR(0 TO 7);
      Dbg_Trig_Ack_Out_7 : IN STD_LOGIC_VECTOR(0 TO 7);
      Dbg_TrClk_7 : OUT STD_LOGIC;
      Dbg_TrData_7 : IN STD_LOGIC_VECTOR(0 TO 35);
      Dbg_TrReady_7 : OUT STD_LOGIC;
      Dbg_TrValid_7 : IN STD_LOGIC;
      Dbg_Disable_7 : OUT STD_LOGIC;
      Dbg_AWADDR_7 : OUT STD_LOGIC_VECTOR(14 DOWNTO 2);
      Dbg_AWVALID_7 : OUT STD_LOGIC;
      Dbg_AWREADY_7 : IN STD_LOGIC;
      Dbg_WDATA_7 : OUT STD_LOGIC_VECTOR(31 DOWNTO 0);
      Dbg_WVALID_7 : OUT STD_LOGIC;
      Dbg_WREADY_7 : IN STD_LOGIC;
      Dbg_BRESP_7 : IN STD_LOGIC_VECTOR(1 DOWNTO 0);
      Dbg_BVALID_7 : IN STD_LOGIC;
      Dbg_BREADY_7 : OUT STD_LOGIC;
      Dbg_ARADDR_7 : OUT STD_LOGIC_VECTOR(14 DOWNTO 2);
      Dbg_ARVALID_7 : OUT STD_LOGIC;
      Dbg_ARREADY_7 : IN STD_LOGIC;
      Dbg_RDATA_7 : IN STD_LOGIC_VECTOR(31 DOWNTO 0);
      Dbg_RRESP_7 : IN STD_LOGIC_VECTOR(1 DOWNTO 0);
      Dbg_RVALID_7 : IN STD_LOGIC;
      Dbg_RREADY_7 : OUT STD_LOGIC;
      Dbg_Clk_8 : OUT STD_LOGIC;
      Dbg_TDI_8 : OUT STD_LOGIC;
      Dbg_TDO_8 : IN STD_LOGIC;
      Dbg_Reg_En_8 : OUT STD_LOGIC_VECTOR(0 TO 7);
      Dbg_Capture_8 : OUT STD_LOGIC;
      Dbg_Shift_8 : OUT STD_LOGIC;
      Dbg_Update_8 : OUT STD_LOGIC;
      Dbg_Rst_8 : OUT STD_LOGIC;
      Dbg_Trig_In_8 : IN STD_LOGIC_VECTOR(0 TO 7);
      Dbg_Trig_Ack_In_8 : OUT STD_LOGIC_VECTOR(0 TO 7);
      Dbg_Trig_Out_8 : OUT STD_LOGIC_VECTOR(0 TO 7);
      Dbg_Trig_Ack_Out_8 : IN STD_LOGIC_VECTOR(0 TO 7);
      Dbg_TrClk_8 : OUT STD_LOGIC;
      Dbg_TrData_8 : IN STD_LOGIC_VECTOR(0 TO 35);
      Dbg_TrReady_8 : OUT STD_LOGIC;
      Dbg_TrValid_8 : IN STD_LOGIC;
      Dbg_Disable_8 : OUT STD_LOGIC;
      Dbg_AWADDR_8 : OUT STD_LOGIC_VECTOR(14 DOWNTO 2);
      Dbg_AWVALID_8 : OUT STD_LOGIC;
      Dbg_AWREADY_8 : IN STD_LOGIC;
      Dbg_WDATA_8 : OUT STD_LOGIC_VECTOR(31 DOWNTO 0);
      Dbg_WVALID_8 : OUT STD_LOGIC;
      Dbg_WREADY_8 : IN STD_LOGIC;
      Dbg_BRESP_8 : IN STD_LOGIC_VECTOR(1 DOWNTO 0);
      Dbg_BVALID_8 : IN STD_LOGIC;
      Dbg_BREADY_8 : OUT STD_LOGIC;
      Dbg_ARADDR_8 : OUT STD_LOGIC_VECTOR(14 DOWNTO 2);
      Dbg_ARVALID_8 : OUT STD_LOGIC;
      Dbg_ARREADY_8 : IN STD_LOGIC;
      Dbg_RDATA_8 : IN STD_LOGIC_VECTOR(31 DOWNTO 0);
      Dbg_RRESP_8 : IN STD_LOGIC_VECTOR(1 DOWNTO 0);
      Dbg_RVALID_8 : IN STD_LOGIC;
      Dbg_RREADY_8 : OUT STD_LOGIC;
      Dbg_Clk_9 : OUT STD_LOGIC;
      Dbg_TDI_9 : OUT STD_LOGIC;
      Dbg_TDO_9 : IN STD_LOGIC;
      Dbg_Reg_En_9 : OUT STD_LOGIC_VECTOR(0 TO 7);
      Dbg_Capture_9 : OUT STD_LOGIC;
      Dbg_Shift_9 : OUT STD_LOGIC;
      Dbg_Update_9 : OUT STD_LOGIC;
      Dbg_Rst_9 : OUT STD_LOGIC;
      Dbg_Trig_In_9 : IN STD_LOGIC_VECTOR(0 TO 7);
      Dbg_Trig_Ack_In_9 : OUT STD_LOGIC_VECTOR(0 TO 7);
      Dbg_Trig_Out_9 : OUT STD_LOGIC_VECTOR(0 TO 7);
      Dbg_Trig_Ack_Out_9 : IN STD_LOGIC_VECTOR(0 TO 7);
      Dbg_TrClk_9 : OUT STD_LOGIC;
      Dbg_TrData_9 : IN STD_LOGIC_VECTOR(0 TO 35);
      Dbg_TrReady_9 : OUT STD_LOGIC;
      Dbg_TrValid_9 : IN STD_LOGIC;
      Dbg_Disable_9 : OUT STD_LOGIC;
      Dbg_AWADDR_9 : OUT STD_LOGIC_VECTOR(14 DOWNTO 2);
      Dbg_AWVALID_9 : OUT STD_LOGIC;
      Dbg_AWREADY_9 : IN STD_LOGIC;
      Dbg_WDATA_9 : OUT STD_LOGIC_VECTOR(31 DOWNTO 0);
      Dbg_WVALID_9 : OUT STD_LOGIC;
      Dbg_WREADY_9 : IN STD_LOGIC;
      Dbg_BRESP_9 : IN STD_LOGIC_VECTOR(1 DOWNTO 0);
      Dbg_BVALID_9 : IN STD_LOGIC;
      Dbg_BREADY_9 : OUT STD_LOGIC;
      Dbg_ARADDR_9 : OUT STD_LOGIC_VECTOR(14 DOWNTO 2);
      Dbg_ARVALID_9 : OUT STD_LOGIC;
      Dbg_ARREADY_9 : IN STD_LOGIC;
      Dbg_RDATA_9 : IN STD_LOGIC_VECTOR(31 DOWNTO 0);
      Dbg_RRESP_9 : IN STD_LOGIC_VECTOR(1 DOWNTO 0);
      Dbg_RVALID_9 : IN STD_LOGIC;
      Dbg_RREADY_9 : OUT STD_LOGIC;
      Dbg_Clk_10 : OUT STD_LOGIC;
      Dbg_TDI_10 : OUT STD_LOGIC;
      Dbg_TDO_10 : IN STD_LOGIC;
      Dbg_Reg_En_10 : OUT STD_LOGIC_VECTOR(0 TO 7);
      Dbg_Capture_10 : OUT STD_LOGIC;
      Dbg_Shift_10 : OUT STD_LOGIC;
      Dbg_Update_10 : OUT STD_LOGIC;
      Dbg_Rst_10 : OUT STD_LOGIC;
      Dbg_Trig_In_10 : IN STD_LOGIC_VECTOR(0 TO 7);
      Dbg_Trig_Ack_In_10 : OUT STD_LOGIC_VECTOR(0 TO 7);
      Dbg_Trig_Out_10 : OUT STD_LOGIC_VECTOR(0 TO 7);
      Dbg_Trig_Ack_Out_10 : IN STD_LOGIC_VECTOR(0 TO 7);
      Dbg_TrClk_10 : OUT STD_LOGIC;
      Dbg_TrData_10 : IN STD_LOGIC_VECTOR(0 TO 35);
      Dbg_TrReady_10 : OUT STD_LOGIC;
      Dbg_TrValid_10 : IN STD_LOGIC;
      Dbg_Disable_10 : OUT STD_LOGIC;
      Dbg_AWADDR_10 : OUT STD_LOGIC_VECTOR(14 DOWNTO 2);
      Dbg_AWVALID_10 : OUT STD_LOGIC;
      Dbg_AWREADY_10 : IN STD_LOGIC;
      Dbg_WDATA_10 : OUT STD_LOGIC_VECTOR(31 DOWNTO 0);
      Dbg_WVALID_10 : OUT STD_LOGIC;
      Dbg_WREADY_10 : IN STD_LOGIC;
      Dbg_BRESP_10 : IN STD_LOGIC_VECTOR(1 DOWNTO 0);
      Dbg_BVALID_10 : IN STD_LOGIC;
      Dbg_BREADY_10 : OUT STD_LOGIC;
      Dbg_ARADDR_10 : OUT STD_LOGIC_VECTOR(14 DOWNTO 2);
      Dbg_ARVALID_10 : OUT STD_LOGIC;
      Dbg_ARREADY_10 : IN STD_LOGIC;
      Dbg_RDATA_10 : IN STD_LOGIC_VECTOR(31 DOWNTO 0);
      Dbg_RRESP_10 : IN STD_LOGIC_VECTOR(1 DOWNTO 0);
      Dbg_RVALID_10 : IN STD_LOGIC;
      Dbg_RREADY_10 : OUT STD_LOGIC;
      Dbg_Clk_11 : OUT STD_LOGIC;
      Dbg_TDI_11 : OUT STD_LOGIC;
      Dbg_TDO_11 : IN STD_LOGIC;
      Dbg_Reg_En_11 : OUT STD_LOGIC_VECTOR(0 TO 7);
      Dbg_Capture_11 : OUT STD_LOGIC;
      Dbg_Shift_11 : OUT STD_LOGIC;
      Dbg_Update_11 : OUT STD_LOGIC;
      Dbg_Rst_11 : OUT STD_LOGIC;
      Dbg_Trig_In_11 : IN STD_LOGIC_VECTOR(0 TO 7);
      Dbg_Trig_Ack_In_11 : OUT STD_LOGIC_VECTOR(0 TO 7);
      Dbg_Trig_Out_11 : OUT STD_LOGIC_VECTOR(0 TO 7);
      Dbg_Trig_Ack_Out_11 : IN STD_LOGIC_VECTOR(0 TO 7);
      Dbg_TrClk_11 : OUT STD_LOGIC;
      Dbg_TrData_11 : IN STD_LOGIC_VECTOR(0 TO 35);
      Dbg_TrReady_11 : OUT STD_LOGIC;
      Dbg_TrValid_11 : IN STD_LOGIC;
      Dbg_Disable_11 : OUT STD_LOGIC;
      Dbg_AWADDR_11 : OUT STD_LOGIC_VECTOR(14 DOWNTO 2);
      Dbg_AWVALID_11 : OUT STD_LOGIC;
      Dbg_AWREADY_11 : IN STD_LOGIC;
      Dbg_WDATA_11 : OUT STD_LOGIC_VECTOR(31 DOWNTO 0);
      Dbg_WVALID_11 : OUT STD_LOGIC;
      Dbg_WREADY_11 : IN STD_LOGIC;
      Dbg_BRESP_11 : IN STD_LOGIC_VECTOR(1 DOWNTO 0);
      Dbg_BVALID_11 : IN STD_LOGIC;
      Dbg_BREADY_11 : OUT STD_LOGIC;
      Dbg_ARADDR_11 : OUT STD_LOGIC_VECTOR(14 DOWNTO 2);
      Dbg_ARVALID_11 : OUT STD_LOGIC;
      Dbg_ARREADY_11 : IN STD_LOGIC;
      Dbg_RDATA_11 : IN STD_LOGIC_VECTOR(31 DOWNTO 0);
      Dbg_RRESP_11 : IN STD_LOGIC_VECTOR(1 DOWNTO 0);
      Dbg_RVALID_11 : IN STD_LOGIC;
      Dbg_RREADY_11 : OUT STD_LOGIC;
      Dbg_Clk_12 : OUT STD_LOGIC;
      Dbg_TDI_12 : OUT STD_LOGIC;
      Dbg_TDO_12 : IN STD_LOGIC;
      Dbg_Reg_En_12 : OUT STD_LOGIC_VECTOR(0 TO 7);
      Dbg_Capture_12 : OUT STD_LOGIC;
      Dbg_Shift_12 : OUT STD_LOGIC;
      Dbg_Update_12 : OUT STD_LOGIC;
      Dbg_Rst_12 : OUT STD_LOGIC;
      Dbg_Trig_In_12 : IN STD_LOGIC_VECTOR(0 TO 7);
      Dbg_Trig_Ack_In_12 : OUT STD_LOGIC_VECTOR(0 TO 7);
      Dbg_Trig_Out_12 : OUT STD_LOGIC_VECTOR(0 TO 7);
      Dbg_Trig_Ack_Out_12 : IN STD_LOGIC_VECTOR(0 TO 7);
      Dbg_TrClk_12 : OUT STD_LOGIC;
      Dbg_TrData_12 : IN STD_LOGIC_VECTOR(0 TO 35);
      Dbg_TrReady_12 : OUT STD_LOGIC;
      Dbg_TrValid_12 : IN STD_LOGIC;
      Dbg_Disable_12 : OUT STD_LOGIC;
      Dbg_AWADDR_12 : OUT STD_LOGIC_VECTOR(14 DOWNTO 2);
      Dbg_AWVALID_12 : OUT STD_LOGIC;
      Dbg_AWREADY_12 : IN STD_LOGIC;
      Dbg_WDATA_12 : OUT STD_LOGIC_VECTOR(31 DOWNTO 0);
      Dbg_WVALID_12 : OUT STD_LOGIC;
      Dbg_WREADY_12 : IN STD_LOGIC;
      Dbg_BRESP_12 : IN STD_LOGIC_VECTOR(1 DOWNTO 0);
      Dbg_BVALID_12 : IN STD_LOGIC;
      Dbg_BREADY_12 : OUT STD_LOGIC;
      Dbg_ARADDR_12 : OUT STD_LOGIC_VECTOR(14 DOWNTO 2);
      Dbg_ARVALID_12 : OUT STD_LOGIC;
      Dbg_ARREADY_12 : IN STD_LOGIC;
      Dbg_RDATA_12 : IN STD_LOGIC_VECTOR(31 DOWNTO 0);
      Dbg_RRESP_12 : IN STD_LOGIC_VECTOR(1 DOWNTO 0);
      Dbg_RVALID_12 : IN STD_LOGIC;
      Dbg_RREADY_12 : OUT STD_LOGIC;
      Dbg_Clk_13 : OUT STD_LOGIC;
      Dbg_TDI_13 : OUT STD_LOGIC;
      Dbg_TDO_13 : IN STD_LOGIC;
      Dbg_Reg_En_13 : OUT STD_LOGIC_VECTOR(0 TO 7);
      Dbg_Capture_13 : OUT STD_LOGIC;
      Dbg_Shift_13 : OUT STD_LOGIC;
      Dbg_Update_13 : OUT STD_LOGIC;
      Dbg_Rst_13 : OUT STD_LOGIC;
      Dbg_Trig_In_13 : IN STD_LOGIC_VECTOR(0 TO 7);
      Dbg_Trig_Ack_In_13 : OUT STD_LOGIC_VECTOR(0 TO 7);
      Dbg_Trig_Out_13 : OUT STD_LOGIC_VECTOR(0 TO 7);
      Dbg_Trig_Ack_Out_13 : IN STD_LOGIC_VECTOR(0 TO 7);
      Dbg_TrClk_13 : OUT STD_LOGIC;
      Dbg_TrData_13 : IN STD_LOGIC_VECTOR(0 TO 35);
      Dbg_TrReady_13 : OUT STD_LOGIC;
      Dbg_TrValid_13 : IN STD_LOGIC;
      Dbg_Disable_13 : OUT STD_LOGIC;
      Dbg_AWADDR_13 : OUT STD_LOGIC_VECTOR(14 DOWNTO 2);
      Dbg_AWVALID_13 : OUT STD_LOGIC;
      Dbg_AWREADY_13 : IN STD_LOGIC;
      Dbg_WDATA_13 : OUT STD_LOGIC_VECTOR(31 DOWNTO 0);
      Dbg_WVALID_13 : OUT STD_LOGIC;
      Dbg_WREADY_13 : IN STD_LOGIC;
      Dbg_BRESP_13 : IN STD_LOGIC_VECTOR(1 DOWNTO 0);
      Dbg_BVALID_13 : IN STD_LOGIC;
      Dbg_BREADY_13 : OUT STD_LOGIC;
      Dbg_ARADDR_13 : OUT STD_LOGIC_VECTOR(14 DOWNTO 2);
      Dbg_ARVALID_13 : OUT STD_LOGIC;
      Dbg_ARREADY_13 : IN STD_LOGIC;
      Dbg_RDATA_13 : IN STD_LOGIC_VECTOR(31 DOWNTO 0);
      Dbg_RRESP_13 : IN STD_LOGIC_VECTOR(1 DOWNTO 0);
      Dbg_RVALID_13 : IN STD_LOGIC;
      Dbg_RREADY_13 : OUT STD_LOGIC;
      Dbg_Clk_14 : OUT STD_LOGIC;
      Dbg_TDI_14 : OUT STD_LOGIC;
      Dbg_TDO_14 : IN STD_LOGIC;
      Dbg_Reg_En_14 : OUT STD_LOGIC_VECTOR(0 TO 7);
      Dbg_Capture_14 : OUT STD_LOGIC;
      Dbg_Shift_14 : OUT STD_LOGIC;
      Dbg_Update_14 : OUT STD_LOGIC;
      Dbg_Rst_14 : OUT STD_LOGIC;
      Dbg_Trig_In_14 : IN STD_LOGIC_VECTOR(0 TO 7);
      Dbg_Trig_Ack_In_14 : OUT STD_LOGIC_VECTOR(0 TO 7);
      Dbg_Trig_Out_14 : OUT STD_LOGIC_VECTOR(0 TO 7);
      Dbg_Trig_Ack_Out_14 : IN STD_LOGIC_VECTOR(0 TO 7);
      Dbg_TrClk_14 : OUT STD_LOGIC;
      Dbg_TrData_14 : IN STD_LOGIC_VECTOR(0 TO 35);
      Dbg_TrReady_14 : OUT STD_LOGIC;
      Dbg_TrValid_14 : IN STD_LOGIC;
      Dbg_Disable_14 : OUT STD_LOGIC;
      Dbg_AWADDR_14 : OUT STD_LOGIC_VECTOR(14 DOWNTO 2);
      Dbg_AWVALID_14 : OUT STD_LOGIC;
      Dbg_AWREADY_14 : IN STD_LOGIC;
      Dbg_WDATA_14 : OUT STD_LOGIC_VECTOR(31 DOWNTO 0);
      Dbg_WVALID_14 : OUT STD_LOGIC;
      Dbg_WREADY_14 : IN STD_LOGIC;
      Dbg_BRESP_14 : IN STD_LOGIC_VECTOR(1 DOWNTO 0);
      Dbg_BVALID_14 : IN STD_LOGIC;
      Dbg_BREADY_14 : OUT STD_LOGIC;
      Dbg_ARADDR_14 : OUT STD_LOGIC_VECTOR(14 DOWNTO 2);
      Dbg_ARVALID_14 : OUT STD_LOGIC;
      Dbg_ARREADY_14 : IN STD_LOGIC;
      Dbg_RDATA_14 : IN STD_LOGIC_VECTOR(31 DOWNTO 0);
      Dbg_RRESP_14 : IN STD_LOGIC_VECTOR(1 DOWNTO 0);
      Dbg_RVALID_14 : IN STD_LOGIC;
      Dbg_RREADY_14 : OUT STD_LOGIC;
      Dbg_Clk_15 : OUT STD_LOGIC;
      Dbg_TDI_15 : OUT STD_LOGIC;
      Dbg_TDO_15 : IN STD_LOGIC;
      Dbg_Reg_En_15 : OUT STD_LOGIC_VECTOR(0 TO 7);
      Dbg_Capture_15 : OUT STD_LOGIC;
      Dbg_Shift_15 : OUT STD_LOGIC;
      Dbg_Update_15 : OUT STD_LOGIC;
      Dbg_Rst_15 : OUT STD_LOGIC;
      Dbg_Trig_In_15 : IN STD_LOGIC_VECTOR(0 TO 7);
      Dbg_Trig_Ack_In_15 : OUT STD_LOGIC_VECTOR(0 TO 7);
      Dbg_Trig_Out_15 : OUT STD_LOGIC_VECTOR(0 TO 7);
      Dbg_Trig_Ack_Out_15 : IN STD_LOGIC_VECTOR(0 TO 7);
      Dbg_TrClk_15 : OUT STD_LOGIC;
      Dbg_TrData_15 : IN STD_LOGIC_VECTOR(0 TO 35);
      Dbg_TrReady_15 : OUT STD_LOGIC;
      Dbg_TrValid_15 : IN STD_LOGIC;
      Dbg_Disable_15 : OUT STD_LOGIC;
      Dbg_AWADDR_15 : OUT STD_LOGIC_VECTOR(14 DOWNTO 2);
      Dbg_AWVALID_15 : OUT STD_LOGIC;
      Dbg_AWREADY_15 : IN STD_LOGIC;
      Dbg_WDATA_15 : OUT STD_LOGIC_VECTOR(31 DOWNTO 0);
      Dbg_WVALID_15 : OUT STD_LOGIC;
      Dbg_WREADY_15 : IN STD_LOGIC;
      Dbg_BRESP_15 : IN STD_LOGIC_VECTOR(1 DOWNTO 0);
      Dbg_BVALID_15 : IN STD_LOGIC;
      Dbg_BREADY_15 : OUT STD_LOGIC;
      Dbg_ARADDR_15 : OUT STD_LOGIC_VECTOR(14 DOWNTO 2);
      Dbg_ARVALID_15 : OUT STD_LOGIC;
      Dbg_ARREADY_15 : IN STD_LOGIC;
      Dbg_RDATA_15 : IN STD_LOGIC_VECTOR(31 DOWNTO 0);
      Dbg_RRESP_15 : IN STD_LOGIC_VECTOR(1 DOWNTO 0);
      Dbg_RVALID_15 : IN STD_LOGIC;
      Dbg_RREADY_15 : OUT STD_LOGIC;
      Dbg_Clk_16 : OUT STD_LOGIC;
      Dbg_TDI_16 : OUT STD_LOGIC;
      Dbg_TDO_16 : IN STD_LOGIC;
      Dbg_Reg_En_16 : OUT STD_LOGIC_VECTOR(0 TO 7);
      Dbg_Capture_16 : OUT STD_LOGIC;
      Dbg_Shift_16 : OUT STD_LOGIC;
      Dbg_Update_16 : OUT STD_LOGIC;
      Dbg_Rst_16 : OUT STD_LOGIC;
      Dbg_Trig_In_16 : IN STD_LOGIC_VECTOR(0 TO 7);
      Dbg_Trig_Ack_In_16 : OUT STD_LOGIC_VECTOR(0 TO 7);
      Dbg_Trig_Out_16 : OUT STD_LOGIC_VECTOR(0 TO 7);
      Dbg_Trig_Ack_Out_16 : IN STD_LOGIC_VECTOR(0 TO 7);
      Dbg_TrClk_16 : OUT STD_LOGIC;
      Dbg_TrData_16 : IN STD_LOGIC_VECTOR(0 TO 35);
      Dbg_TrReady_16 : OUT STD_LOGIC;
      Dbg_TrValid_16 : IN STD_LOGIC;
      Dbg_Disable_16 : OUT STD_LOGIC;
      Dbg_AWADDR_16 : OUT STD_LOGIC_VECTOR(14 DOWNTO 2);
      Dbg_AWVALID_16 : OUT STD_LOGIC;
      Dbg_AWREADY_16 : IN STD_LOGIC;
      Dbg_WDATA_16 : OUT STD_LOGIC_VECTOR(31 DOWNTO 0);
      Dbg_WVALID_16 : OUT STD_LOGIC;
      Dbg_WREADY_16 : IN STD_LOGIC;
      Dbg_BRESP_16 : IN STD_LOGIC_VECTOR(1 DOWNTO 0);
      Dbg_BVALID_16 : IN STD_LOGIC;
      Dbg_BREADY_16 : OUT STD_LOGIC;
      Dbg_ARADDR_16 : OUT STD_LOGIC_VECTOR(14 DOWNTO 2);
      Dbg_ARVALID_16 : OUT STD_LOGIC;
      Dbg_ARREADY_16 : IN STD_LOGIC;
      Dbg_RDATA_16 : IN STD_LOGIC_VECTOR(31 DOWNTO 0);
      Dbg_RRESP_16 : IN STD_LOGIC_VECTOR(1 DOWNTO 0);
      Dbg_RVALID_16 : IN STD_LOGIC;
      Dbg_RREADY_16 : OUT STD_LOGIC;
      Dbg_Clk_17 : OUT STD_LOGIC;
      Dbg_TDI_17 : OUT STD_LOGIC;
      Dbg_TDO_17 : IN STD_LOGIC;
      Dbg_Reg_En_17 : OUT STD_LOGIC_VECTOR(0 TO 7);
      Dbg_Capture_17 : OUT STD_LOGIC;
      Dbg_Shift_17 : OUT STD_LOGIC;
      Dbg_Update_17 : OUT STD_LOGIC;
      Dbg_Rst_17 : OUT STD_LOGIC;
      Dbg_Trig_In_17 : IN STD_LOGIC_VECTOR(0 TO 7);
      Dbg_Trig_Ack_In_17 : OUT STD_LOGIC_VECTOR(0 TO 7);
      Dbg_Trig_Out_17 : OUT STD_LOGIC_VECTOR(0 TO 7);
      Dbg_Trig_Ack_Out_17 : IN STD_LOGIC_VECTOR(0 TO 7);
      Dbg_TrClk_17 : OUT STD_LOGIC;
      Dbg_TrData_17 : IN STD_LOGIC_VECTOR(0 TO 35);
      Dbg_TrReady_17 : OUT STD_LOGIC;
      Dbg_TrValid_17 : IN STD_LOGIC;
      Dbg_Disable_17 : OUT STD_LOGIC;
      Dbg_AWADDR_17 : OUT STD_LOGIC_VECTOR(14 DOWNTO 2);
      Dbg_AWVALID_17 : OUT STD_LOGIC;
      Dbg_AWREADY_17 : IN STD_LOGIC;
      Dbg_WDATA_17 : OUT STD_LOGIC_VECTOR(31 DOWNTO 0);
      Dbg_WVALID_17 : OUT STD_LOGIC;
      Dbg_WREADY_17 : IN STD_LOGIC;
      Dbg_BRESP_17 : IN STD_LOGIC_VECTOR(1 DOWNTO 0);
      Dbg_BVALID_17 : IN STD_LOGIC;
      Dbg_BREADY_17 : OUT STD_LOGIC;
      Dbg_ARADDR_17 : OUT STD_LOGIC_VECTOR(14 DOWNTO 2);
      Dbg_ARVALID_17 : OUT STD_LOGIC;
      Dbg_ARREADY_17 : IN STD_LOGIC;
      Dbg_RDATA_17 : IN STD_LOGIC_VECTOR(31 DOWNTO 0);
      Dbg_RRESP_17 : IN STD_LOGIC_VECTOR(1 DOWNTO 0);
      Dbg_RVALID_17 : IN STD_LOGIC;
      Dbg_RREADY_17 : OUT STD_LOGIC;
      Dbg_Clk_18 : OUT STD_LOGIC;
      Dbg_TDI_18 : OUT STD_LOGIC;
      Dbg_TDO_18 : IN STD_LOGIC;
      Dbg_Reg_En_18 : OUT STD_LOGIC_VECTOR(0 TO 7);
      Dbg_Capture_18 : OUT STD_LOGIC;
      Dbg_Shift_18 : OUT STD_LOGIC;
      Dbg_Update_18 : OUT STD_LOGIC;
      Dbg_Rst_18 : OUT STD_LOGIC;
      Dbg_Trig_In_18 : IN STD_LOGIC_VECTOR(0 TO 7);
      Dbg_Trig_Ack_In_18 : OUT STD_LOGIC_VECTOR(0 TO 7);
      Dbg_Trig_Out_18 : OUT STD_LOGIC_VECTOR(0 TO 7);
      Dbg_Trig_Ack_Out_18 : IN STD_LOGIC_VECTOR(0 TO 7);
      Dbg_TrClk_18 : OUT STD_LOGIC;
      Dbg_TrData_18 : IN STD_LOGIC_VECTOR(0 TO 35);
      Dbg_TrReady_18 : OUT STD_LOGIC;
      Dbg_TrValid_18 : IN STD_LOGIC;
      Dbg_Disable_18 : OUT STD_LOGIC;
      Dbg_AWADDR_18 : OUT STD_LOGIC_VECTOR(14 DOWNTO 2);
      Dbg_AWVALID_18 : OUT STD_LOGIC;
      Dbg_AWREADY_18 : IN STD_LOGIC;
      Dbg_WDATA_18 : OUT STD_LOGIC_VECTOR(31 DOWNTO 0);
      Dbg_WVALID_18 : OUT STD_LOGIC;
      Dbg_WREADY_18 : IN STD_LOGIC;
      Dbg_BRESP_18 : IN STD_LOGIC_VECTOR(1 DOWNTO 0);
      Dbg_BVALID_18 : IN STD_LOGIC;
      Dbg_BREADY_18 : OUT STD_LOGIC;
      Dbg_ARADDR_18 : OUT STD_LOGIC_VECTOR(14 DOWNTO 2);
      Dbg_ARVALID_18 : OUT STD_LOGIC;
      Dbg_ARREADY_18 : IN STD_LOGIC;
      Dbg_RDATA_18 : IN STD_LOGIC_VECTOR(31 DOWNTO 0);
      Dbg_RRESP_18 : IN STD_LOGIC_VECTOR(1 DOWNTO 0);
      Dbg_RVALID_18 : IN STD_LOGIC;
      Dbg_RREADY_18 : OUT STD_LOGIC;
      Dbg_Clk_19 : OUT STD_LOGIC;
      Dbg_TDI_19 : OUT STD_LOGIC;
      Dbg_TDO_19 : IN STD_LOGIC;
      Dbg_Reg_En_19 : OUT STD_LOGIC_VECTOR(0 TO 7);
      Dbg_Capture_19 : OUT STD_LOGIC;
      Dbg_Shift_19 : OUT STD_LOGIC;
      Dbg_Update_19 : OUT STD_LOGIC;
      Dbg_Rst_19 : OUT STD_LOGIC;
      Dbg_Trig_In_19 : IN STD_LOGIC_VECTOR(0 TO 7);
      Dbg_Trig_Ack_In_19 : OUT STD_LOGIC_VECTOR(0 TO 7);
      Dbg_Trig_Out_19 : OUT STD_LOGIC_VECTOR(0 TO 7);
      Dbg_Trig_Ack_Out_19 : IN STD_LOGIC_VECTOR(0 TO 7);
      Dbg_TrClk_19 : OUT STD_LOGIC;
      Dbg_TrData_19 : IN STD_LOGIC_VECTOR(0 TO 35);
      Dbg_TrReady_19 : OUT STD_LOGIC;
      Dbg_TrValid_19 : IN STD_LOGIC;
      Dbg_Disable_19 : OUT STD_LOGIC;
      Dbg_AWADDR_19 : OUT STD_LOGIC_VECTOR(14 DOWNTO 2);
      Dbg_AWVALID_19 : OUT STD_LOGIC;
      Dbg_AWREADY_19 : IN STD_LOGIC;
      Dbg_WDATA_19 : OUT STD_LOGIC_VECTOR(31 DOWNTO 0);
      Dbg_WVALID_19 : OUT STD_LOGIC;
      Dbg_WREADY_19 : IN STD_LOGIC;
      Dbg_BRESP_19 : IN STD_LOGIC_VECTOR(1 DOWNTO 0);
      Dbg_BVALID_19 : IN STD_LOGIC;
      Dbg_BREADY_19 : OUT STD_LOGIC;
      Dbg_ARADDR_19 : OUT STD_LOGIC_VECTOR(14 DOWNTO 2);
      Dbg_ARVALID_19 : OUT STD_LOGIC;
      Dbg_ARREADY_19 : IN STD_LOGIC;
      Dbg_RDATA_19 : IN STD_LOGIC_VECTOR(31 DOWNTO 0);
      Dbg_RRESP_19 : IN STD_LOGIC_VECTOR(1 DOWNTO 0);
      Dbg_RVALID_19 : IN STD_LOGIC;
      Dbg_RREADY_19 : OUT STD_LOGIC;
      Dbg_Clk_20 : OUT STD_LOGIC;
      Dbg_TDI_20 : OUT STD_LOGIC;
      Dbg_TDO_20 : IN STD_LOGIC;
      Dbg_Reg_En_20 : OUT STD_LOGIC_VECTOR(0 TO 7);
      Dbg_Capture_20 : OUT STD_LOGIC;
      Dbg_Shift_20 : OUT STD_LOGIC;
      Dbg_Update_20 : OUT STD_LOGIC;
      Dbg_Rst_20 : OUT STD_LOGIC;
      Dbg_Trig_In_20 : IN STD_LOGIC_VECTOR(0 TO 7);
      Dbg_Trig_Ack_In_20 : OUT STD_LOGIC_VECTOR(0 TO 7);
      Dbg_Trig_Out_20 : OUT STD_LOGIC_VECTOR(0 TO 7);
      Dbg_Trig_Ack_Out_20 : IN STD_LOGIC_VECTOR(0 TO 7);
      Dbg_TrClk_20 : OUT STD_LOGIC;
      Dbg_TrData_20 : IN STD_LOGIC_VECTOR(0 TO 35);
      Dbg_TrReady_20 : OUT STD_LOGIC;
      Dbg_TrValid_20 : IN STD_LOGIC;
      Dbg_Disable_20 : OUT STD_LOGIC;
      Dbg_AWADDR_20 : OUT STD_LOGIC_VECTOR(14 DOWNTO 2);
      Dbg_AWVALID_20 : OUT STD_LOGIC;
      Dbg_AWREADY_20 : IN STD_LOGIC;
      Dbg_WDATA_20 : OUT STD_LOGIC_VECTOR(31 DOWNTO 0);
      Dbg_WVALID_20 : OUT STD_LOGIC;
      Dbg_WREADY_20 : IN STD_LOGIC;
      Dbg_BRESP_20 : IN STD_LOGIC_VECTOR(1 DOWNTO 0);
      Dbg_BVALID_20 : IN STD_LOGIC;
      Dbg_BREADY_20 : OUT STD_LOGIC;
      Dbg_ARADDR_20 : OUT STD_LOGIC_VECTOR(14 DOWNTO 2);
      Dbg_ARVALID_20 : OUT STD_LOGIC;
      Dbg_ARREADY_20 : IN STD_LOGIC;
      Dbg_RDATA_20 : IN STD_LOGIC_VECTOR(31 DOWNTO 0);
      Dbg_RRESP_20 : IN STD_LOGIC_VECTOR(1 DOWNTO 0);
      Dbg_RVALID_20 : IN STD_LOGIC;
      Dbg_RREADY_20 : OUT STD_LOGIC;
      Dbg_Clk_21 : OUT STD_LOGIC;
      Dbg_TDI_21 : OUT STD_LOGIC;
      Dbg_TDO_21 : IN STD_LOGIC;
      Dbg_Reg_En_21 : OUT STD_LOGIC_VECTOR(0 TO 7);
      Dbg_Capture_21 : OUT STD_LOGIC;
      Dbg_Shift_21 : OUT STD_LOGIC;
      Dbg_Update_21 : OUT STD_LOGIC;
      Dbg_Rst_21 : OUT STD_LOGIC;
      Dbg_Trig_In_21 : IN STD_LOGIC_VECTOR(0 TO 7);
      Dbg_Trig_Ack_In_21 : OUT STD_LOGIC_VECTOR(0 TO 7);
      Dbg_Trig_Out_21 : OUT STD_LOGIC_VECTOR(0 TO 7);
      Dbg_Trig_Ack_Out_21 : IN STD_LOGIC_VECTOR(0 TO 7);
      Dbg_TrClk_21 : OUT STD_LOGIC;
      Dbg_TrData_21 : IN STD_LOGIC_VECTOR(0 TO 35);
      Dbg_TrReady_21 : OUT STD_LOGIC;
      Dbg_TrValid_21 : IN STD_LOGIC;
      Dbg_Disable_21 : OUT STD_LOGIC;
      Dbg_AWADDR_21 : OUT STD_LOGIC_VECTOR(14 DOWNTO 2);
      Dbg_AWVALID_21 : OUT STD_LOGIC;
      Dbg_AWREADY_21 : IN STD_LOGIC;
      Dbg_WDATA_21 : OUT STD_LOGIC_VECTOR(31 DOWNTO 0);
      Dbg_WVALID_21 : OUT STD_LOGIC;
      Dbg_WREADY_21 : IN STD_LOGIC;
      Dbg_BRESP_21 : IN STD_LOGIC_VECTOR(1 DOWNTO 0);
      Dbg_BVALID_21 : IN STD_LOGIC;
      Dbg_BREADY_21 : OUT STD_LOGIC;
      Dbg_ARADDR_21 : OUT STD_LOGIC_VECTOR(14 DOWNTO 2);
      Dbg_ARVALID_21 : OUT STD_LOGIC;
      Dbg_ARREADY_21 : IN STD_LOGIC;
      Dbg_RDATA_21 : IN STD_LOGIC_VECTOR(31 DOWNTO 0);
      Dbg_RRESP_21 : IN STD_LOGIC_VECTOR(1 DOWNTO 0);
      Dbg_RVALID_21 : IN STD_LOGIC;
      Dbg_RREADY_21 : OUT STD_LOGIC;
      Dbg_Clk_22 : OUT STD_LOGIC;
      Dbg_TDI_22 : OUT STD_LOGIC;
      Dbg_TDO_22 : IN STD_LOGIC;
      Dbg_Reg_En_22 : OUT STD_LOGIC_VECTOR(0 TO 7);
      Dbg_Capture_22 : OUT STD_LOGIC;
      Dbg_Shift_22 : OUT STD_LOGIC;
      Dbg_Update_22 : OUT STD_LOGIC;
      Dbg_Rst_22 : OUT STD_LOGIC;
      Dbg_Trig_In_22 : IN STD_LOGIC_VECTOR(0 TO 7);
      Dbg_Trig_Ack_In_22 : OUT STD_LOGIC_VECTOR(0 TO 7);
      Dbg_Trig_Out_22 : OUT STD_LOGIC_VECTOR(0 TO 7);
      Dbg_Trig_Ack_Out_22 : IN STD_LOGIC_VECTOR(0 TO 7);
      Dbg_TrClk_22 : OUT STD_LOGIC;
      Dbg_TrData_22 : IN STD_LOGIC_VECTOR(0 TO 35);
      Dbg_TrReady_22 : OUT STD_LOGIC;
      Dbg_TrValid_22 : IN STD_LOGIC;
      Dbg_Disable_22 : OUT STD_LOGIC;
      Dbg_AWADDR_22 : OUT STD_LOGIC_VECTOR(14 DOWNTO 2);
      Dbg_AWVALID_22 : OUT STD_LOGIC;
      Dbg_AWREADY_22 : IN STD_LOGIC;
      Dbg_WDATA_22 : OUT STD_LOGIC_VECTOR(31 DOWNTO 0);
      Dbg_WVALID_22 : OUT STD_LOGIC;
      Dbg_WREADY_22 : IN STD_LOGIC;
      Dbg_BRESP_22 : IN STD_LOGIC_VECTOR(1 DOWNTO 0);
      Dbg_BVALID_22 : IN STD_LOGIC;
      Dbg_BREADY_22 : OUT STD_LOGIC;
      Dbg_ARADDR_22 : OUT STD_LOGIC_VECTOR(14 DOWNTO 2);
      Dbg_ARVALID_22 : OUT STD_LOGIC;
      Dbg_ARREADY_22 : IN STD_LOGIC;
      Dbg_RDATA_22 : IN STD_LOGIC_VECTOR(31 DOWNTO 0);
      Dbg_RRESP_22 : IN STD_LOGIC_VECTOR(1 DOWNTO 0);
      Dbg_RVALID_22 : IN STD_LOGIC;
      Dbg_RREADY_22 : OUT STD_LOGIC;
      Dbg_Clk_23 : OUT STD_LOGIC;
      Dbg_TDI_23 : OUT STD_LOGIC;
      Dbg_TDO_23 : IN STD_LOGIC;
      Dbg_Reg_En_23 : OUT STD_LOGIC_VECTOR(0 TO 7);
      Dbg_Capture_23 : OUT STD_LOGIC;
      Dbg_Shift_23 : OUT STD_LOGIC;
      Dbg_Update_23 : OUT STD_LOGIC;
      Dbg_Rst_23 : OUT STD_LOGIC;
      Dbg_Trig_In_23 : IN STD_LOGIC_VECTOR(0 TO 7);
      Dbg_Trig_Ack_In_23 : OUT STD_LOGIC_VECTOR(0 TO 7);
      Dbg_Trig_Out_23 : OUT STD_LOGIC_VECTOR(0 TO 7);
      Dbg_Trig_Ack_Out_23 : IN STD_LOGIC_VECTOR(0 TO 7);
      Dbg_TrClk_23 : OUT STD_LOGIC;
      Dbg_TrData_23 : IN STD_LOGIC_VECTOR(0 TO 35);
      Dbg_TrReady_23 : OUT STD_LOGIC;
      Dbg_TrValid_23 : IN STD_LOGIC;
      Dbg_Disable_23 : OUT STD_LOGIC;
      Dbg_AWADDR_23 : OUT STD_LOGIC_VECTOR(14 DOWNTO 2);
      Dbg_AWVALID_23 : OUT STD_LOGIC;
      Dbg_AWREADY_23 : IN STD_LOGIC;
      Dbg_WDATA_23 : OUT STD_LOGIC_VECTOR(31 DOWNTO 0);
      Dbg_WVALID_23 : OUT STD_LOGIC;
      Dbg_WREADY_23 : IN STD_LOGIC;
      Dbg_BRESP_23 : IN STD_LOGIC_VECTOR(1 DOWNTO 0);
      Dbg_BVALID_23 : IN STD_LOGIC;
      Dbg_BREADY_23 : OUT STD_LOGIC;
      Dbg_ARADDR_23 : OUT STD_LOGIC_VECTOR(14 DOWNTO 2);
      Dbg_ARVALID_23 : OUT STD_LOGIC;
      Dbg_ARREADY_23 : IN STD_LOGIC;
      Dbg_RDATA_23 : IN STD_LOGIC_VECTOR(31 DOWNTO 0);
      Dbg_RRESP_23 : IN STD_LOGIC_VECTOR(1 DOWNTO 0);
      Dbg_RVALID_23 : IN STD_LOGIC;
      Dbg_RREADY_23 : OUT STD_LOGIC;
      Dbg_Clk_24 : OUT STD_LOGIC;
      Dbg_TDI_24 : OUT STD_LOGIC;
      Dbg_TDO_24 : IN STD_LOGIC;
      Dbg_Reg_En_24 : OUT STD_LOGIC_VECTOR(0 TO 7);
      Dbg_Capture_24 : OUT STD_LOGIC;
      Dbg_Shift_24 : OUT STD_LOGIC;
      Dbg_Update_24 : OUT STD_LOGIC;
      Dbg_Rst_24 : OUT STD_LOGIC;
      Dbg_Trig_In_24 : IN STD_LOGIC_VECTOR(0 TO 7);
      Dbg_Trig_Ack_In_24 : OUT STD_LOGIC_VECTOR(0 TO 7);
      Dbg_Trig_Out_24 : OUT STD_LOGIC_VECTOR(0 TO 7);
      Dbg_Trig_Ack_Out_24 : IN STD_LOGIC_VECTOR(0 TO 7);
      Dbg_TrClk_24 : OUT STD_LOGIC;
      Dbg_TrData_24 : IN STD_LOGIC_VECTOR(0 TO 35);
      Dbg_TrReady_24 : OUT STD_LOGIC;
      Dbg_TrValid_24 : IN STD_LOGIC;
      Dbg_Disable_24 : OUT STD_LOGIC;
      Dbg_AWADDR_24 : OUT STD_LOGIC_VECTOR(14 DOWNTO 2);
      Dbg_AWVALID_24 : OUT STD_LOGIC;
      Dbg_AWREADY_24 : IN STD_LOGIC;
      Dbg_WDATA_24 : OUT STD_LOGIC_VECTOR(31 DOWNTO 0);
      Dbg_WVALID_24 : OUT STD_LOGIC;
      Dbg_WREADY_24 : IN STD_LOGIC;
      Dbg_BRESP_24 : IN STD_LOGIC_VECTOR(1 DOWNTO 0);
      Dbg_BVALID_24 : IN STD_LOGIC;
      Dbg_BREADY_24 : OUT STD_LOGIC;
      Dbg_ARADDR_24 : OUT STD_LOGIC_VECTOR(14 DOWNTO 2);
      Dbg_ARVALID_24 : OUT STD_LOGIC;
      Dbg_ARREADY_24 : IN STD_LOGIC;
      Dbg_RDATA_24 : IN STD_LOGIC_VECTOR(31 DOWNTO 0);
      Dbg_RRESP_24 : IN STD_LOGIC_VECTOR(1 DOWNTO 0);
      Dbg_RVALID_24 : IN STD_LOGIC;
      Dbg_RREADY_24 : OUT STD_LOGIC;
      Dbg_Clk_25 : OUT STD_LOGIC;
      Dbg_TDI_25 : OUT STD_LOGIC;
      Dbg_TDO_25 : IN STD_LOGIC;
      Dbg_Reg_En_25 : OUT STD_LOGIC_VECTOR(0 TO 7);
      Dbg_Capture_25 : OUT STD_LOGIC;
      Dbg_Shift_25 : OUT STD_LOGIC;
      Dbg_Update_25 : OUT STD_LOGIC;
      Dbg_Rst_25 : OUT STD_LOGIC;
      Dbg_Trig_In_25 : IN STD_LOGIC_VECTOR(0 TO 7);
      Dbg_Trig_Ack_In_25 : OUT STD_LOGIC_VECTOR(0 TO 7);
      Dbg_Trig_Out_25 : OUT STD_LOGIC_VECTOR(0 TO 7);
      Dbg_Trig_Ack_Out_25 : IN STD_LOGIC_VECTOR(0 TO 7);
      Dbg_TrClk_25 : OUT STD_LOGIC;
      Dbg_TrData_25 : IN STD_LOGIC_VECTOR(0 TO 35);
      Dbg_TrReady_25 : OUT STD_LOGIC;
      Dbg_TrValid_25 : IN STD_LOGIC;
      Dbg_Disable_25 : OUT STD_LOGIC;
      Dbg_AWADDR_25 : OUT STD_LOGIC_VECTOR(14 DOWNTO 2);
      Dbg_AWVALID_25 : OUT STD_LOGIC;
      Dbg_AWREADY_25 : IN STD_LOGIC;
      Dbg_WDATA_25 : OUT STD_LOGIC_VECTOR(31 DOWNTO 0);
      Dbg_WVALID_25 : OUT STD_LOGIC;
      Dbg_WREADY_25 : IN STD_LOGIC;
      Dbg_BRESP_25 : IN STD_LOGIC_VECTOR(1 DOWNTO 0);
      Dbg_BVALID_25 : IN STD_LOGIC;
      Dbg_BREADY_25 : OUT STD_LOGIC;
      Dbg_ARADDR_25 : OUT STD_LOGIC_VECTOR(14 DOWNTO 2);
      Dbg_ARVALID_25 : OUT STD_LOGIC;
      Dbg_ARREADY_25 : IN STD_LOGIC;
      Dbg_RDATA_25 : IN STD_LOGIC_VECTOR(31 DOWNTO 0);
      Dbg_RRESP_25 : IN STD_LOGIC_VECTOR(1 DOWNTO 0);
      Dbg_RVALID_25 : IN STD_LOGIC;
      Dbg_RREADY_25 : OUT STD_LOGIC;
      Dbg_Clk_26 : OUT STD_LOGIC;
      Dbg_TDI_26 : OUT STD_LOGIC;
      Dbg_TDO_26 : IN STD_LOGIC;
      Dbg_Reg_En_26 : OUT STD_LOGIC_VECTOR(0 TO 7);
      Dbg_Capture_26 : OUT STD_LOGIC;
      Dbg_Shift_26 : OUT STD_LOGIC;
      Dbg_Update_26 : OUT STD_LOGIC;
      Dbg_Rst_26 : OUT STD_LOGIC;
      Dbg_Trig_In_26 : IN STD_LOGIC_VECTOR(0 TO 7);
      Dbg_Trig_Ack_In_26 : OUT STD_LOGIC_VECTOR(0 TO 7);
      Dbg_Trig_Out_26 : OUT STD_LOGIC_VECTOR(0 TO 7);
      Dbg_Trig_Ack_Out_26 : IN STD_LOGIC_VECTOR(0 TO 7);
      Dbg_TrClk_26 : OUT STD_LOGIC;
      Dbg_TrData_26 : IN STD_LOGIC_VECTOR(0 TO 35);
      Dbg_TrReady_26 : OUT STD_LOGIC;
      Dbg_TrValid_26 : IN STD_LOGIC;
      Dbg_Disable_26 : OUT STD_LOGIC;
      Dbg_AWADDR_26 : OUT STD_LOGIC_VECTOR(14 DOWNTO 2);
      Dbg_AWVALID_26 : OUT STD_LOGIC;
      Dbg_AWREADY_26 : IN STD_LOGIC;
      Dbg_WDATA_26 : OUT STD_LOGIC_VECTOR(31 DOWNTO 0);
      Dbg_WVALID_26 : OUT STD_LOGIC;
      Dbg_WREADY_26 : IN STD_LOGIC;
      Dbg_BRESP_26 : IN STD_LOGIC_VECTOR(1 DOWNTO 0);
      Dbg_BVALID_26 : IN STD_LOGIC;
      Dbg_BREADY_26 : OUT STD_LOGIC;
      Dbg_ARADDR_26 : OUT STD_LOGIC_VECTOR(14 DOWNTO 2);
      Dbg_ARVALID_26 : OUT STD_LOGIC;
      Dbg_ARREADY_26 : IN STD_LOGIC;
      Dbg_RDATA_26 : IN STD_LOGIC_VECTOR(31 DOWNTO 0);
      Dbg_RRESP_26 : IN STD_LOGIC_VECTOR(1 DOWNTO 0);
      Dbg_RVALID_26 : IN STD_LOGIC;
      Dbg_RREADY_26 : OUT STD_LOGIC;
      Dbg_Clk_27 : OUT STD_LOGIC;
      Dbg_TDI_27 : OUT STD_LOGIC;
      Dbg_TDO_27 : IN STD_LOGIC;
      Dbg_Reg_En_27 : OUT STD_LOGIC_VECTOR(0 TO 7);
      Dbg_Capture_27 : OUT STD_LOGIC;
      Dbg_Shift_27 : OUT STD_LOGIC;
      Dbg_Update_27 : OUT STD_LOGIC;
      Dbg_Rst_27 : OUT STD_LOGIC;
      Dbg_Trig_In_27 : IN STD_LOGIC_VECTOR(0 TO 7);
      Dbg_Trig_Ack_In_27 : OUT STD_LOGIC_VECTOR(0 TO 7);
      Dbg_Trig_Out_27 : OUT STD_LOGIC_VECTOR(0 TO 7);
      Dbg_Trig_Ack_Out_27 : IN STD_LOGIC_VECTOR(0 TO 7);
      Dbg_TrClk_27 : OUT STD_LOGIC;
      Dbg_TrData_27 : IN STD_LOGIC_VECTOR(0 TO 35);
      Dbg_TrReady_27 : OUT STD_LOGIC;
      Dbg_TrValid_27 : IN STD_LOGIC;
      Dbg_Disable_27 : OUT STD_LOGIC;
      Dbg_AWADDR_27 : OUT STD_LOGIC_VECTOR(14 DOWNTO 2);
      Dbg_AWVALID_27 : OUT STD_LOGIC;
      Dbg_AWREADY_27 : IN STD_LOGIC;
      Dbg_WDATA_27 : OUT STD_LOGIC_VECTOR(31 DOWNTO 0);
      Dbg_WVALID_27 : OUT STD_LOGIC;
      Dbg_WREADY_27 : IN STD_LOGIC;
      Dbg_BRESP_27 : IN STD_LOGIC_VECTOR(1 DOWNTO 0);
      Dbg_BVALID_27 : IN STD_LOGIC;
      Dbg_BREADY_27 : OUT STD_LOGIC;
      Dbg_ARADDR_27 : OUT STD_LOGIC_VECTOR(14 DOWNTO 2);
      Dbg_ARVALID_27 : OUT STD_LOGIC;
      Dbg_ARREADY_27 : IN STD_LOGIC;
      Dbg_RDATA_27 : IN STD_LOGIC_VECTOR(31 DOWNTO 0);
      Dbg_RRESP_27 : IN STD_LOGIC_VECTOR(1 DOWNTO 0);
      Dbg_RVALID_27 : IN STD_LOGIC;
      Dbg_RREADY_27 : OUT STD_LOGIC;
      Dbg_Clk_28 : OUT STD_LOGIC;
      Dbg_TDI_28 : OUT STD_LOGIC;
      Dbg_TDO_28 : IN STD_LOGIC;
      Dbg_Reg_En_28 : OUT STD_LOGIC_VECTOR(0 TO 7);
      Dbg_Capture_28 : OUT STD_LOGIC;
      Dbg_Shift_28 : OUT STD_LOGIC;
      Dbg_Update_28 : OUT STD_LOGIC;
      Dbg_Rst_28 : OUT STD_LOGIC;
      Dbg_Trig_In_28 : IN STD_LOGIC_VECTOR(0 TO 7);
      Dbg_Trig_Ack_In_28 : OUT STD_LOGIC_VECTOR(0 TO 7);
      Dbg_Trig_Out_28 : OUT STD_LOGIC_VECTOR(0 TO 7);
      Dbg_Trig_Ack_Out_28 : IN STD_LOGIC_VECTOR(0 TO 7);
      Dbg_TrClk_28 : OUT STD_LOGIC;
      Dbg_TrData_28 : IN STD_LOGIC_VECTOR(0 TO 35);
      Dbg_TrReady_28 : OUT STD_LOGIC;
      Dbg_TrValid_28 : IN STD_LOGIC;
      Dbg_Disable_28 : OUT STD_LOGIC;
      Dbg_AWADDR_28 : OUT STD_LOGIC_VECTOR(14 DOWNTO 2);
      Dbg_AWVALID_28 : OUT STD_LOGIC;
      Dbg_AWREADY_28 : IN STD_LOGIC;
      Dbg_WDATA_28 : OUT STD_LOGIC_VECTOR(31 DOWNTO 0);
      Dbg_WVALID_28 : OUT STD_LOGIC;
      Dbg_WREADY_28 : IN STD_LOGIC;
      Dbg_BRESP_28 : IN STD_LOGIC_VECTOR(1 DOWNTO 0);
      Dbg_BVALID_28 : IN STD_LOGIC;
      Dbg_BREADY_28 : OUT STD_LOGIC;
      Dbg_ARADDR_28 : OUT STD_LOGIC_VECTOR(14 DOWNTO 2);
      Dbg_ARVALID_28 : OUT STD_LOGIC;
      Dbg_ARREADY_28 : IN STD_LOGIC;
      Dbg_RDATA_28 : IN STD_LOGIC_VECTOR(31 DOWNTO 0);
      Dbg_RRESP_28 : IN STD_LOGIC_VECTOR(1 DOWNTO 0);
      Dbg_RVALID_28 : IN STD_LOGIC;
      Dbg_RREADY_28 : OUT STD_LOGIC;
      Dbg_Clk_29 : OUT STD_LOGIC;
      Dbg_TDI_29 : OUT STD_LOGIC;
      Dbg_TDO_29 : IN STD_LOGIC;
      Dbg_Reg_En_29 : OUT STD_LOGIC_VECTOR(0 TO 7);
      Dbg_Capture_29 : OUT STD_LOGIC;
      Dbg_Shift_29 : OUT STD_LOGIC;
      Dbg_Update_29 : OUT STD_LOGIC;
      Dbg_Rst_29 : OUT STD_LOGIC;
      Dbg_Trig_In_29 : IN STD_LOGIC_VECTOR(0 TO 7);
      Dbg_Trig_Ack_In_29 : OUT STD_LOGIC_VECTOR(0 TO 7);
      Dbg_Trig_Out_29 : OUT STD_LOGIC_VECTOR(0 TO 7);
      Dbg_Trig_Ack_Out_29 : IN STD_LOGIC_VECTOR(0 TO 7);
      Dbg_TrClk_29 : OUT STD_LOGIC;
      Dbg_TrData_29 : IN STD_LOGIC_VECTOR(0 TO 35);
      Dbg_TrReady_29 : OUT STD_LOGIC;
      Dbg_TrValid_29 : IN STD_LOGIC;
      Dbg_Disable_29 : OUT STD_LOGIC;
      Dbg_AWADDR_29 : OUT STD_LOGIC_VECTOR(14 DOWNTO 2);
      Dbg_AWVALID_29 : OUT STD_LOGIC;
      Dbg_AWREADY_29 : IN STD_LOGIC;
      Dbg_WDATA_29 : OUT STD_LOGIC_VECTOR(31 DOWNTO 0);
      Dbg_WVALID_29 : OUT STD_LOGIC;
      Dbg_WREADY_29 : IN STD_LOGIC;
      Dbg_BRESP_29 : IN STD_LOGIC_VECTOR(1 DOWNTO 0);
      Dbg_BVALID_29 : IN STD_LOGIC;
      Dbg_BREADY_29 : OUT STD_LOGIC;
      Dbg_ARADDR_29 : OUT STD_LOGIC_VECTOR(14 DOWNTO 2);
      Dbg_ARVALID_29 : OUT STD_LOGIC;
      Dbg_ARREADY_29 : IN STD_LOGIC;
      Dbg_RDATA_29 : IN STD_LOGIC_VECTOR(31 DOWNTO 0);
      Dbg_RRESP_29 : IN STD_LOGIC_VECTOR(1 DOWNTO 0);
      Dbg_RVALID_29 : IN STD_LOGIC;
      Dbg_RREADY_29 : OUT STD_LOGIC;
      Dbg_Clk_30 : OUT STD_LOGIC;
      Dbg_TDI_30 : OUT STD_LOGIC;
      Dbg_TDO_30 : IN STD_LOGIC;
      Dbg_Reg_En_30 : OUT STD_LOGIC_VECTOR(0 TO 7);
      Dbg_Capture_30 : OUT STD_LOGIC;
      Dbg_Shift_30 : OUT STD_LOGIC;
      Dbg_Update_30 : OUT STD_LOGIC;
      Dbg_Rst_30 : OUT STD_LOGIC;
      Dbg_Trig_In_30 : IN STD_LOGIC_VECTOR(0 TO 7);
      Dbg_Trig_Ack_In_30 : OUT STD_LOGIC_VECTOR(0 TO 7);
      Dbg_Trig_Out_30 : OUT STD_LOGIC_VECTOR(0 TO 7);
      Dbg_Trig_Ack_Out_30 : IN STD_LOGIC_VECTOR(0 TO 7);
      Dbg_TrClk_30 : OUT STD_LOGIC;
      Dbg_TrData_30 : IN STD_LOGIC_VECTOR(0 TO 35);
      Dbg_TrReady_30 : OUT STD_LOGIC;
      Dbg_TrValid_30 : IN STD_LOGIC;
      Dbg_Disable_30 : OUT STD_LOGIC;
      Dbg_AWADDR_30 : OUT STD_LOGIC_VECTOR(14 DOWNTO 2);
      Dbg_AWVALID_30 : OUT STD_LOGIC;
      Dbg_AWREADY_30 : IN STD_LOGIC;
      Dbg_WDATA_30 : OUT STD_LOGIC_VECTOR(31 DOWNTO 0);
      Dbg_WVALID_30 : OUT STD_LOGIC;
      Dbg_WREADY_30 : IN STD_LOGIC;
      Dbg_BRESP_30 : IN STD_LOGIC_VECTOR(1 DOWNTO 0);
      Dbg_BVALID_30 : IN STD_LOGIC;
      Dbg_BREADY_30 : OUT STD_LOGIC;
      Dbg_ARADDR_30 : OUT STD_LOGIC_VECTOR(14 DOWNTO 2);
      Dbg_ARVALID_30 : OUT STD_LOGIC;
      Dbg_ARREADY_30 : IN STD_LOGIC;
      Dbg_RDATA_30 : IN STD_LOGIC_VECTOR(31 DOWNTO 0);
      Dbg_RRESP_30 : IN STD_LOGIC_VECTOR(1 DOWNTO 0);
      Dbg_RVALID_30 : IN STD_LOGIC;
      Dbg_RREADY_30 : OUT STD_LOGIC;
      Dbg_Clk_31 : OUT STD_LOGIC;
      Dbg_TDI_31 : OUT STD_LOGIC;
      Dbg_TDO_31 : IN STD_LOGIC;
      Dbg_Reg_En_31 : OUT STD_LOGIC_VECTOR(0 TO 7);
      Dbg_Capture_31 : OUT STD_LOGIC;
      Dbg_Shift_31 : OUT STD_LOGIC;
      Dbg_Update_31 : OUT STD_LOGIC;
      Dbg_Rst_31 : OUT STD_LOGIC;
      Dbg_Trig_In_31 : IN STD_LOGIC_VECTOR(0 TO 7);
      Dbg_Trig_Ack_In_31 : OUT STD_LOGIC_VECTOR(0 TO 7);
      Dbg_Trig_Out_31 : OUT STD_LOGIC_VECTOR(0 TO 7);
      Dbg_Trig_Ack_Out_31 : IN STD_LOGIC_VECTOR(0 TO 7);
      Dbg_TrClk_31 : OUT STD_LOGIC;
      Dbg_TrData_31 : IN STD_LOGIC_VECTOR(0 TO 35);
      Dbg_TrReady_31 : OUT STD_LOGIC;
      Dbg_TrValid_31 : IN STD_LOGIC;
      Dbg_Disable_31 : OUT STD_LOGIC;
      Dbg_AWADDR_31 : OUT STD_LOGIC_VECTOR(14 DOWNTO 2);
      Dbg_AWVALID_31 : OUT STD_LOGIC;
      Dbg_AWREADY_31 : IN STD_LOGIC;
      Dbg_WDATA_31 : OUT STD_LOGIC_VECTOR(31 DOWNTO 0);
      Dbg_WVALID_31 : OUT STD_LOGIC;
      Dbg_WREADY_31 : IN STD_LOGIC;
      Dbg_BRESP_31 : IN STD_LOGIC_VECTOR(1 DOWNTO 0);
      Dbg_BVALID_31 : IN STD_LOGIC;
      Dbg_BREADY_31 : OUT STD_LOGIC;
      Dbg_ARADDR_31 : OUT STD_LOGIC_VECTOR(14 DOWNTO 2);
      Dbg_ARVALID_31 : OUT STD_LOGIC;
      Dbg_ARREADY_31 : IN STD_LOGIC;
      Dbg_RDATA_31 : IN STD_LOGIC_VECTOR(31 DOWNTO 0);
      Dbg_RRESP_31 : IN STD_LOGIC_VECTOR(1 DOWNTO 0);
      Dbg_RVALID_31 : IN STD_LOGIC;
      Dbg_RREADY_31 : OUT STD_LOGIC;
      bscan_ext_tdi : IN STD_LOGIC;
      bscan_ext_reset : IN STD_LOGIC;
      bscan_ext_shift : IN STD_LOGIC;
      bscan_ext_update : IN STD_LOGIC;
      bscan_ext_capture : IN STD_LOGIC;
      bscan_ext_sel : IN STD_LOGIC;
      bscan_ext_drck : IN STD_LOGIC;
      bscan_ext_tdo : OUT STD_LOGIC;
      bscan_ext_tck : IN STD_LOGIC;
      bscan_ext_tms : IN STD_LOGIC;
      bscan_ext_bscanid_en : IN STD_LOGIC;
      Ext_JTAG_DRCK : OUT STD_LOGIC;
      Ext_JTAG_RESET : OUT STD_LOGIC;
      Ext_JTAG_SEL : OUT STD_LOGIC;
      Ext_JTAG_CAPTURE : OUT STD_LOGIC;
      Ext_JTAG_SHIFT : OUT STD_LOGIC;
      Ext_JTAG_UPDATE : OUT STD_LOGIC;
      Ext_JTAG_TDI : OUT STD_LOGIC;
      Ext_JTAG_TDO : IN STD_LOGIC
    );
  END COMPONENT MDM;
  ATTRIBUTE X_CORE_INFO : STRING;
  ATTRIBUTE X_CORE_INFO OF MicroBlazeV2_mdm_1_0_arch: ARCHITECTURE IS "MDM,Vivado 2023.1";
  ATTRIBUTE CHECK_LICENSE_TYPE : STRING;
  ATTRIBUTE CHECK_LICENSE_TYPE OF MicroBlazeV2_mdm_1_0_arch : ARCHITECTURE IS "MicroBlazeV2_mdm_1_0,MDM,{}";
  ATTRIBUTE CORE_GENERATION_INFO : STRING;
  ATTRIBUTE CORE_GENERATION_INFO OF MicroBlazeV2_mdm_1_0_arch: ARCHITECTURE IS "MicroBlazeV2_mdm_1_0,MDM,{x_ipProduct=Vivado 2023.1,x_ipVendor=xilinx.com,x_ipLibrary=ip,x_ipName=mdm,x_ipVersion=3.2,x_ipCoreRevision=24,x_ipLanguage=VERILOG,x_ipSimLanguage=MIXED,C_FAMILY=spartan7,C_DEVICE=xc7s6,C_REVISION=,C_JTAG_CHAIN=2,C_USE_BSCAN=0,C_BSCANID=76547328,C_DEBUG_INTERFACE=0,C_USE_CONFIG_RESET=0,C_AVOID_PRIMITIVES=0,C_INTERCONNECT=2,C_MB_DBG_PORTS=1,C_USE_UART=0,C_DBG_REG_ACCESS=0,C_DBG_MEM_ACCESS=0,C_USE_CROSS_TRIGGER=0,C_EXT_TRIG_RESET_VALUE=0xF1234,C_TRACE_OUTPUT=0,C_TRACE_D" & 
"ATA_WIDTH=32,C_TRACE_CLK_FREQ_HZ=200000000,C_TRACE_CLK_OUT_PHASE=90,C_TRACE_ASYNC_RESET=0,C_TRACE_PROTOCOL=1,C_TRACE_ID=110,C_S_AXI_ADDR_WIDTH=4,C_S_AXI_DATA_WIDTH=32,C_S_AXI_ACLK_FREQ_HZ=100000000,C_M_AXI_ADDR_WIDTH=32,C_M_AXI_DATA_WIDTH=32,C_M_AXI_THREAD_ID_WIDTH=1,C_ADDR_SIZE=32,C_DATA_SIZE=32,C_LMB_PROTOCOL=0,C_M_AXIS_DATA_WIDTH=32,C_M_AXIS_ID_WIDTH=7}";
  ATTRIBUTE X_INTERFACE_INFO : STRING;
  ATTRIBUTE X_INTERFACE_PARAMETER : STRING;
  ATTRIBUTE X_INTERFACE_INFO OF Dbg_Capture_0: SIGNAL IS "xilinx.com:interface:mbdebug:3.0 MBDEBUG_0 CAPTURE";
  ATTRIBUTE X_INTERFACE_INFO OF Dbg_Clk_0: SIGNAL IS "xilinx.com:interface:mbdebug:3.0 MBDEBUG_0 CLK";
  ATTRIBUTE X_INTERFACE_INFO OF Dbg_Disable_0: SIGNAL IS "xilinx.com:interface:mbdebug:3.0 MBDEBUG_0 DISABLE";
  ATTRIBUTE X_INTERFACE_INFO OF Dbg_Reg_En_0: SIGNAL IS "xilinx.com:interface:mbdebug:3.0 MBDEBUG_0 REG_EN";
  ATTRIBUTE X_INTERFACE_INFO OF Dbg_Rst_0: SIGNAL IS "xilinx.com:interface:mbdebug:3.0 MBDEBUG_0 RST";
  ATTRIBUTE X_INTERFACE_INFO OF Dbg_Shift_0: SIGNAL IS "xilinx.com:interface:mbdebug:3.0 MBDEBUG_0 SHIFT";
  ATTRIBUTE X_INTERFACE_INFO OF Dbg_TDI_0: SIGNAL IS "xilinx.com:interface:mbdebug:3.0 MBDEBUG_0 TDI";
  ATTRIBUTE X_INTERFACE_INFO OF Dbg_TDO_0: SIGNAL IS "xilinx.com:interface:mbdebug:3.0 MBDEBUG_0 TDO";
  ATTRIBUTE X_INTERFACE_INFO OF Dbg_Update_0: SIGNAL IS "xilinx.com:interface:mbdebug:3.0 MBDEBUG_0 UPDATE";
  ATTRIBUTE X_INTERFACE_PARAMETER OF Debug_SYS_Rst: SIGNAL IS "XIL_INTERFACENAME RST.Debug_SYS_Rst, POLARITY ACTIVE_HIGH, INSERT_VIP 0";
  ATTRIBUTE X_INTERFACE_INFO OF Debug_SYS_Rst: SIGNAL IS "xilinx.com:signal:reset:1.0 RST.Debug_SYS_Rst RST";
BEGIN
  U0 : MDM
    GENERIC MAP (
      C_FAMILY => "spartan7",
      C_DEVICE => "xc7s6",
      C_REVISION => "",
      C_JTAG_CHAIN => 2,
      C_USE_BSCAN => 0,
      C_BSCANID => 76547328,
      C_DEBUG_INTERFACE => 0,
      C_USE_CONFIG_RESET => 0,
      C_AVOID_PRIMITIVES => 0,
      C_INTERCONNECT => 2,
      C_MB_DBG_PORTS => 1,
      C_USE_UART => 0,
      C_DBG_REG_ACCESS => 0,
      C_DBG_MEM_ACCESS => 0,
      C_USE_CROSS_TRIGGER => 0,
      C_EXT_TRIG_RESET_VALUE => X"F1234",
      C_TRACE_OUTPUT => 0,
      C_TRACE_DATA_WIDTH => 32,
      C_TRACE_CLK_FREQ_HZ => 200000000,
      C_TRACE_CLK_OUT_PHASE => 90,
      C_TRACE_ASYNC_RESET => 0,
      C_TRACE_PROTOCOL => 1,
      C_TRACE_ID => 110,
      C_S_AXI_ADDR_WIDTH => 4,
      C_S_AXI_DATA_WIDTH => 32,
      C_S_AXI_ACLK_FREQ_HZ => 100000000,
      C_M_AXI_ADDR_WIDTH => 32,
      C_M_AXI_DATA_WIDTH => 32,
      C_M_AXI_THREAD_ID_WIDTH => 1,
      C_ADDR_SIZE => 32,
      C_DATA_SIZE => 32,
      C_LMB_PROTOCOL => 0,
      C_M_AXIS_DATA_WIDTH => 32,
      C_M_AXIS_ID_WIDTH => 7
    )
    PORT MAP (
      Config_Reset => '0',
      Scan_Reset => '0',
      Scan_Reset_Sel => '0',
      Scan_En => '0',
      S_AXI_ACLK => '0',
      S_AXI_ARESETN => '0',
      M_AXI_ACLK => '0',
      M_AXI_ARESETN => '0',
      M_AXIS_ACLK => '0',
      M_AXIS_ARESETN => '0',
      Debug_SYS_Rst => Debug_SYS_Rst,
      Trig_In_0 => '0',
      Trig_Ack_Out_0 => '0',
      Trig_In_1 => '0',
      Trig_Ack_Out_1 => '0',
      Trig_In_2 => '0',
      Trig_Ack_Out_2 => '0',
      Trig_In_3 => '0',
      Trig_Ack_Out_3 => '0',
      S_AXI_AWADDR => STD_LOGIC_VECTOR(TO_UNSIGNED(0, 4)),
      S_AXI_AWVALID => '0',
      S_AXI_WDATA => STD_LOGIC_VECTOR(TO_UNSIGNED(0, 32)),
      S_AXI_WSTRB => STD_LOGIC_VECTOR(TO_UNSIGNED(0, 4)),
      S_AXI_WVALID => '0',
      S_AXI_BREADY => '0',
      S_AXI_ARADDR => STD_LOGIC_VECTOR(TO_UNSIGNED(0, 4)),
      S_AXI_ARVALID => '0',
      S_AXI_RREADY => '0',
      M_AXI_AWREADY => '0',
      M_AXI_WREADY => '0',
      M_AXI_BRESP => STD_LOGIC_VECTOR(TO_UNSIGNED(0, 2)),
      M_AXI_BID => STD_LOGIC_VECTOR(TO_UNSIGNED(0, 1)),
      M_AXI_BVALID => '0',
      M_AXI_ARREADY => '0',
      M_AXI_RID => STD_LOGIC_VECTOR(TO_UNSIGNED(0, 1)),
      M_AXI_RDATA => STD_LOGIC_VECTOR(TO_UNSIGNED(0, 32)),
      M_AXI_RRESP => STD_LOGIC_VECTOR(TO_UNSIGNED(0, 2)),
      M_AXI_RLAST => '0',
      M_AXI_RVALID => '0',
      LMB_Ready_0 => '0',
      LMB_Data_Read_0 => STD_LOGIC_VECTOR(TO_UNSIGNED(0, 32)),
      LMB_CE_0 => '0',
      LMB_UE_0 => '0',
      LMB_Wait_0 => '0',
      LMB_Ready_1 => '0',
      LMB_Data_Read_1 => STD_LOGIC_VECTOR(TO_UNSIGNED(0, 32)),
      LMB_CE_1 => '0',
      LMB_UE_1 => '0',
      LMB_Wait_1 => '0',
      LMB_Ready_2 => '0',
      LMB_Data_Read_2 => STD_LOGIC_VECTOR(TO_UNSIGNED(0, 32)),
      LMB_CE_2 => '0',
      LMB_UE_2 => '0',
      LMB_Wait_2 => '0',
      LMB_Ready_3 => '0',
      LMB_Data_Read_3 => STD_LOGIC_VECTOR(TO_UNSIGNED(0, 32)),
      LMB_CE_3 => '0',
      LMB_UE_3 => '0',
      LMB_Wait_3 => '0',
      LMB_Ready_4 => '0',
      LMB_Data_Read_4 => STD_LOGIC_VECTOR(TO_UNSIGNED(0, 32)),
      LMB_CE_4 => '0',
      LMB_UE_4 => '0',
      LMB_Wait_4 => '0',
      LMB_Ready_5 => '0',
      LMB_Data_Read_5 => STD_LOGIC_VECTOR(TO_UNSIGNED(0, 32)),
      LMB_CE_5 => '0',
      LMB_UE_5 => '0',
      LMB_Wait_5 => '0',
      LMB_Ready_6 => '0',
      LMB_Data_Read_6 => STD_LOGIC_VECTOR(TO_UNSIGNED(0, 32)),
      LMB_CE_6 => '0',
      LMB_UE_6 => '0',
      LMB_Wait_6 => '0',
      LMB_Ready_7 => '0',
      LMB_Data_Read_7 => STD_LOGIC_VECTOR(TO_UNSIGNED(0, 32)),
      LMB_CE_7 => '0',
      LMB_UE_7 => '0',
      LMB_Wait_7 => '0',
      LMB_Ready_8 => '0',
      LMB_Data_Read_8 => STD_LOGIC_VECTOR(TO_UNSIGNED(0, 32)),
      LMB_CE_8 => '0',
      LMB_UE_8 => '0',
      LMB_Wait_8 => '0',
      LMB_Ready_9 => '0',
      LMB_Data_Read_9 => STD_LOGIC_VECTOR(TO_UNSIGNED(0, 32)),
      LMB_CE_9 => '0',
      LMB_UE_9 => '0',
      LMB_Wait_9 => '0',
      LMB_Ready_10 => '0',
      LMB_Data_Read_10 => STD_LOGIC_VECTOR(TO_UNSIGNED(0, 32)),
      LMB_CE_10 => '0',
      LMB_UE_10 => '0',
      LMB_Wait_10 => '0',
      LMB_Ready_11 => '0',
      LMB_Data_Read_11 => STD_LOGIC_VECTOR(TO_UNSIGNED(0, 32)),
      LMB_CE_11 => '0',
      LMB_UE_11 => '0',
      LMB_Wait_11 => '0',
      LMB_Ready_12 => '0',
      LMB_Data_Read_12 => STD_LOGIC_VECTOR(TO_UNSIGNED(0, 32)),
      LMB_CE_12 => '0',
      LMB_UE_12 => '0',
      LMB_Wait_12 => '0',
      LMB_Ready_13 => '0',
      LMB_Data_Read_13 => STD_LOGIC_VECTOR(TO_UNSIGNED(0, 32)),
      LMB_CE_13 => '0',
      LMB_UE_13 => '0',
      LMB_Wait_13 => '0',
      LMB_Ready_14 => '0',
      LMB_Data_Read_14 => STD_LOGIC_VECTOR(TO_UNSIGNED(0, 32)),
      LMB_CE_14 => '0',
      LMB_UE_14 => '0',
      LMB_Wait_14 => '0',
      LMB_Ready_15 => '0',
      LMB_Data_Read_15 => STD_LOGIC_VECTOR(TO_UNSIGNED(0, 32)),
      LMB_CE_15 => '0',
      LMB_UE_15 => '0',
      LMB_Wait_15 => '0',
      LMB_Ready_16 => '0',
      LMB_Data_Read_16 => STD_LOGIC_VECTOR(TO_UNSIGNED(0, 32)),
      LMB_CE_16 => '0',
      LMB_UE_16 => '0',
      LMB_Wait_16 => '0',
      LMB_Ready_17 => '0',
      LMB_Data_Read_17 => STD_LOGIC_VECTOR(TO_UNSIGNED(0, 32)),
      LMB_CE_17 => '0',
      LMB_UE_17 => '0',
      LMB_Wait_17 => '0',
      LMB_Ready_18 => '0',
      LMB_Data_Read_18 => STD_LOGIC_VECTOR(TO_UNSIGNED(0, 32)),
      LMB_CE_18 => '0',
      LMB_UE_18 => '0',
      LMB_Wait_18 => '0',
      LMB_Ready_19 => '0',
      LMB_Data_Read_19 => STD_LOGIC_VECTOR(TO_UNSIGNED(0, 32)),
      LMB_CE_19 => '0',
      LMB_UE_19 => '0',
      LMB_Wait_19 => '0',
      LMB_Ready_20 => '0',
      LMB_Data_Read_20 => STD_LOGIC_VECTOR(TO_UNSIGNED(0, 32)),
      LMB_CE_20 => '0',
      LMB_UE_20 => '0',
      LMB_Wait_20 => '0',
      LMB_Ready_21 => '0',
      LMB_Data_Read_21 => STD_LOGIC_VECTOR(TO_UNSIGNED(0, 32)),
      LMB_CE_21 => '0',
      LMB_UE_21 => '0',
      LMB_Wait_21 => '0',
      LMB_Ready_22 => '0',
      LMB_Data_Read_22 => STD_LOGIC_VECTOR(TO_UNSIGNED(0, 32)),
      LMB_CE_22 => '0',
      LMB_UE_22 => '0',
      LMB_Wait_22 => '0',
      LMB_Ready_23 => '0',
      LMB_Data_Read_23 => STD_LOGIC_VECTOR(TO_UNSIGNED(0, 32)),
      LMB_CE_23 => '0',
      LMB_UE_23 => '0',
      LMB_Wait_23 => '0',
      LMB_Ready_24 => '0',
      LMB_Data_Read_24 => STD_LOGIC_VECTOR(TO_UNSIGNED(0, 32)),
      LMB_CE_24 => '0',
      LMB_UE_24 => '0',
      LMB_Wait_24 => '0',
      LMB_Ready_25 => '0',
      LMB_Data_Read_25 => STD_LOGIC_VECTOR(TO_UNSIGNED(0, 32)),
      LMB_CE_25 => '0',
      LMB_UE_25 => '0',
      LMB_Wait_25 => '0',
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
      Dbg_RRESP_31 => STD_LOGIC_VECTOR(TO_UNSIGNED(0, 2)),
      Dbg_RVALID_31 => '0',
      bscan_ext_tdi => '0',
      bscan_ext_reset => '0',
      bscan_ext_shift => '0',
      bscan_ext_update => '0',
      bscan_ext_capture => '0',
      bscan_ext_sel => '0',
      bscan_ext_drck => '0',
      bscan_ext_tck => '0',
      bscan_ext_tms => '0',
      bscan_ext_bscanid_en => '0',
      Ext_JTAG_TDO => '0'
    );
END MicroBlazeV2_mdm_1_0_arch;
