Louis-VL/PCB-ADVANCED/VIVADO/SpartanMicroBlaze/SpartanMicroBlaze.cache/ip/2023.1/4/3/4344ebac38ea80b1/MicroBlazeV2_xbar_0_stub.v

// Copyright 1986-2022 Xilinx, Inc. All Rights Reserved.
// Copyright 2022-2023 Advanced Micro Devices, Inc. All Rights Reserved.
// --------------------------------------------------------------------------------
// Tool Version: Vivado v.2023.1 (win64) Build 3865809 Sun May  7 15:05:29 MDT 2023
// Date        : Sat Dec 16 23:13:22 2023
// Host        : LAPTOP-K67JHBA7 running 64-bit major release  (build 9200)
// Command     : write_verilog -force -mode synth_stub -rename_top decalper_eb_ot_sdeen_pot_pi_dehcac_xnilix -prefix
//               decalper_eb_ot_sdeen_pot_pi_dehcac_xnilix_ MicroBlazeV2_xbar_0_stub.v
// Design      : MicroBlazeV2_xbar_0
// Purpose     : Stub declaration of top-level module interface
// Device      : xc7s6ftgb196-1
// --------------------------------------------------------------------------------

// This empty module with port declaration file causes synthesis tools to infer a black box for IP.
// The synthesis directives are for Synopsys Synplify support to prevent IO buffer insertion.
// Please paste the declaration into a Verilog source file or add the file as an additional source.
(* X_CORE_INFO = "axi_crossbar_v2_1_29_axi_crossbar,Vivado 2023.1" *)
module decalper_eb_ot_sdeen_pot_pi_dehcac_xnilix(aclk, aresetn, s_axi_awaddr, s_axi_awprot, 
  s_axi_awvalid, s_axi_awready, s_axi_wdata, s_axi_wstrb, s_axi_wvalid, s_axi_wready, 
  s_axi_bresp, s_axi_bvalid, s_axi_bready, s_axi_araddr, s_axi_arprot, s_axi_arvalid, 
  s_axi_arready, s_axi_rdata, s_axi_rresp, s_axi_rvalid, s_axi_rready, m_axi_awaddr, 
  m_axi_awprot, m_axi_awvalid, m_axi_awready, m_axi_wdata, m_axi_wstrb, m_axi_wvalid, 
  m_axi_wready, m_axi_bresp, m_axi_bvalid, m_axi_bready, m_axi_araddr, m_axi_arprot, 
  m_axi_arvalid, m_axi_arready, m_axi_rdata, m_axi_rresp, m_axi_rvalid, m_axi_rready)
/* synthesis syn_black_box black_box_pad_pin="aresetn,s_axi_awaddr[31:0],s_axi_awprot[2:0],s_axi_awvalid[0:0],s_axi_awready[0:0],s_axi_wdata[31:0],s_axi_wstrb[3:0],s_axi_wvalid[0:0],s_axi_wready[0:0],s_axi_bresp[1:0],s_axi_bvalid[0:0],s_axi_bready[0:0],s_axi_araddr[31:0],s_axi_arprot[2:0],s_axi_arvalid[0:0],s_axi_arready[0:0],s_axi_rdata[31:0],s_axi_rresp[1:0],s_axi_rvalid[0:0],s_axi_rready[0:0],m_axi_awaddr[191:0],m_axi_awprot[17:0],m_axi_awvalid[5:0],m_axi_awready[5:0],m_axi_wdata[191:0],m_axi_wstrb[23:0],m_axi_wvalid[5:0],m_axi_wready[5:0],m_axi_bresp[11:0],m_axi_bvalid[5:0],m_axi_bready[5:0],m_axi_araddr[191:0],m_axi_arprot[17:0],m_axi_arvalid[5:0],m_axi_arready[5:0],m_axi_rdata[191:0],m_axi_rresp[11:0],m_axi_rvalid[5:0],m_axi_rready[5:0]" */
/* synthesis syn_force_seq_prim="aclk" */;
  input aclk /* synthesis syn_isclock = 1 */;
  input aresetn;
  input [31:0]s_axi_awaddr;
  input [2:0]s_axi_awprot;
  input [0:0]s_axi_awvalid;
  output [0:0]s_axi_awready;
  input [31:0]s_axi_wdata;
  input [3:0]s_axi_wstrb;
  input [0:0]s_axi_wvalid;
  output [0:0]s_axi_wready;
  output [1:0]s_axi_bresp;
  output [0:0]s_axi_bvalid;
  input [0:0]s_axi_bready;
  input [31:0]s_axi_araddr;
  input [2:0]s_axi_arprot;
  input [0:0]s_axi_arvalid;
  output [0:0]s_axi_arready;
  output [31:0]s_axi_rdata;
  output [1:0]s_axi_rresp;
  output [0:0]s_axi_rvalid;
  input [0:0]s_axi_rready;
  output [191:0]m_axi_awaddr;
  output [17:0]m_axi_awprot;
  output [5:0]m_axi_awvalid;
  input [5:0]m_axi_awready;
  output [191:0]m_axi_wdata;
  output [23:0]m_axi_wstrb;
  output [5:0]m_axi_wvalid;
  input [5:0]m_axi_wready;
  input [11:0]m_axi_bresp;
  input [5:0]m_axi_bvalid;
  output [5:0]m_axi_bready;
  output [191:0]m_axi_araddr;
  output [17:0]m_axi_arprot;
  output [5:0]m_axi_arvalid;
  input [5:0]m_axi_arready;
  input [191:0]m_axi_rdata;
  input [11:0]m_axi_rresp;
  input [5:0]m_axi_rvalid;
  output [5:0]m_axi_rready;
endmodule
