Louis-VL/PCB-ADVANCED/VIVADO/SpartanMicroBlaze/SpartanMicroBlaze.cache/ip/2023.1/4/3/4344ebac38ea80b1/MicroBlazeV2_xbar_0_stub.vhdl

-- Copyright 1986-2022 Xilinx, Inc. All Rights Reserved.
-- Copyright 2022-2023 Advanced Micro Devices, Inc. All Rights Reserved.
-- --------------------------------------------------------------------------------
-- Tool Version: Vivado v.2023.1 (win64) Build 3865809 Sun May  7 15:05:29 MDT 2023
-- Date        : Sat Dec 16 23:13:22 2023
-- Host        : LAPTOP-K67JHBA7 running 64-bit major release  (build 9200)
-- Command     : write_vhdl -force -mode synth_stub -rename_top decalper_eb_ot_sdeen_pot_pi_dehcac_xnilix -prefix
--               decalper_eb_ot_sdeen_pot_pi_dehcac_xnilix_ MicroBlazeV2_xbar_0_stub.vhdl
-- Design      : MicroBlazeV2_xbar_0
-- Purpose     : Stub declaration of top-level module interface
-- Device      : xc7s6ftgb196-1
-- --------------------------------------------------------------------------------
library IEEE;
use IEEE.STD_LOGIC_1164.ALL;

entity decalper_eb_ot_sdeen_pot_pi_dehcac_xnilix is
  Port ( 
    aclk : in STD_LOGIC;
    aresetn : in STD_LOGIC;
    s_axi_awaddr : in STD_LOGIC_VECTOR ( 31 downto 0 );
    s_axi_awprot : in STD_LOGIC_VECTOR ( 2 downto 0 );
    s_axi_awvalid : in STD_LOGIC_VECTOR ( 0 to 0 );
    s_axi_awready : out STD_LOGIC_VECTOR ( 0 to 0 );
    s_axi_wdata : in STD_LOGIC_VECTOR ( 31 downto 0 );
    s_axi_wstrb : in STD_LOGIC_VECTOR ( 3 downto 0 );
    s_axi_wvalid : in STD_LOGIC_VECTOR ( 0 to 0 );
    s_axi_wready : out STD_LOGIC_VECTOR ( 0 to 0 );
    s_axi_bresp : out STD_LOGIC_VECTOR ( 1 downto 0 );
    s_axi_bvalid : out STD_LOGIC_VECTOR ( 0 to 0 );
    s_axi_bready : in STD_LOGIC_VECTOR ( 0 to 0 );
    s_axi_araddr : in STD_LOGIC_VECTOR ( 31 downto 0 );
    s_axi_arprot : in STD_LOGIC_VECTOR ( 2 downto 0 );
    s_axi_arvalid : in STD_LOGIC_VECTOR ( 0 to 0 );
    s_axi_arready : out STD_LOGIC_VECTOR ( 0 to 0 );
    s_axi_rdata : out STD_LOGIC_VECTOR ( 31 downto 0 );
    s_axi_rresp : out STD_LOGIC_VECTOR ( 1 downto 0 );
    s_axi_rvalid : out STD_LOGIC_VECTOR ( 0 to 0 );
    s_axi_rready : in STD_LOGIC_VECTOR ( 0 to 0 );
    m_axi_awaddr : out STD_LOGIC_VECTOR ( 191 downto 0 );
    m_axi_awprot : out STD_LOGIC_VECTOR ( 17 downto 0 );
    m_axi_awvalid : out STD_LOGIC_VECTOR ( 5 downto 0 );
    m_axi_awready : in STD_LOGIC_VECTOR ( 5 downto 0 );
    m_axi_wdata : out STD_LOGIC_VECTOR ( 191 downto 0 );
    m_axi_wstrb : out STD_LOGIC_VECTOR ( 23 downto 0 );
    m_axi_wvalid : out STD_LOGIC_VECTOR ( 5 downto 0 );
    m_axi_wready : in STD_LOGIC_VECTOR ( 5 downto 0 );
    m_axi_bresp : in STD_LOGIC_VECTOR ( 11 downto 0 );
    m_axi_bvalid : in STD_LOGIC_VECTOR ( 5 downto 0 );
    m_axi_bready : out STD_LOGIC_VECTOR ( 5 downto 0 );
    m_axi_araddr : out STD_LOGIC_VECTOR ( 191 downto 0 );
    m_axi_arprot : out STD_LOGIC_VECTOR ( 17 downto 0 );
    m_axi_arvalid : out STD_LOGIC_VECTOR ( 5 downto 0 );
    m_axi_arready : in STD_LOGIC_VECTOR ( 5 downto 0 );
    m_axi_rdata : in STD_LOGIC_VECTOR ( 191 downto 0 );
    m_axi_rresp : in STD_LOGIC_VECTOR ( 11 downto 0 );
    m_axi_rvalid : in STD_LOGIC_VECTOR ( 5 downto 0 );
    m_axi_rready : out STD_LOGIC_VECTOR ( 5 downto 0 )
  );

end decalper_eb_ot_sdeen_pot_pi_dehcac_xnilix;

architecture stub of decalper_eb_ot_sdeen_pot_pi_dehcac_xnilix is
attribute syn_black_box : boolean;
attribute black_box_pad_pin : string;
attribute syn_black_box of stub : architecture is true;
attribute black_box_pad_pin of stub : architecture is "aclk,aresetn,s_axi_awaddr[31:0],s_axi_awprot[2:0],s_axi_awvalid[0:0],s_axi_awready[0:0],s_axi_wdata[31:0],s_axi_wstrb[3:0],s_axi_wvalid[0:0],s_axi_wready[0:0],s_axi_bresp[1:0],s_axi_bvalid[0:0],s_axi_bready[0:0],s_axi_araddr[31:0],s_axi_arprot[2:0],s_axi_arvalid[0:0],s_axi_arready[0:0],s_axi_rdata[31:0],s_axi_rresp[1:0],s_axi_rvalid[0:0],s_axi_rready[0:0],m_axi_awaddr[191:0],m_axi_awprot[17:0],m_axi_awvalid[5:0],m_axi_awready[5:0],m_axi_wdata[191:0],m_axi_wstrb[23:0],m_axi_wvalid[5:0],m_axi_wready[5:0],m_axi_bresp[11:0],m_axi_bvalid[5:0],m_axi_bready[5:0],m_axi_araddr[191:0],m_axi_arprot[17:0],m_axi_arvalid[5:0],m_axi_arready[5:0],m_axi_rdata[191:0],m_axi_rresp[11:0],m_axi_rvalid[5:0],m_axi_rready[5:0]";
attribute X_CORE_INFO : string;
attribute X_CORE_INFO of stub : architecture is "axi_crossbar_v2_1_29_axi_crossbar,Vivado 2023.1";
begin
end;
