Louis-VL/PCB-ADVANCED/VIVADO/SpartanMicroBlaze/SpartanMicroBlaze.gen/sources_1/bd/MicroBlazeV2/ip/MicroBlazeV2_axi_gpio_0_1/MicroBlazeV2_axi_gpio_0_1_stub.v

// Copyright 1986-2022 Xilinx, Inc. All Rights Reserved.
// Copyright 2022-2023 Advanced Micro Devices, Inc. All Rights Reserved.
// --------------------------------------------------------------------------------
// Tool Version: Vivado v.2023.1 (win64) Build 3865809 Sun May  7 15:05:29 MDT 2023
// Date        : Sat Dec 16 22:54:38 2023
// Host        : LAPTOP-K67JHBA7 running 64-bit major release  (build 9200)
// Command     : write_verilog -force -mode synth_stub -rename_top MicroBlazeV2_axi_gpio_0_1 -prefix
//               MicroBlazeV2_axi_gpio_0_1_ MicroBlazeV2_axi_gpio_0_0_stub.v
// Design      : MicroBlazeV2_axi_gpio_0_0
// Purpose     : Stub declaration of top-level module interface
// Device      : xc7s6ftgb196-1
// --------------------------------------------------------------------------------

// This empty module with port declaration file causes synthesis tools to infer a black box for IP.
// The synthesis directives are for Synopsys Synplify support to prevent IO buffer insertion.
// Please paste the declaration into a Verilog source file or add the file as an additional source.
(* x_core_info = "axi_gpio,Vivado 2023.1" *)
module MicroBlazeV2_axi_gpio_0_1(s_axi_aclk, s_axi_aresetn, s_axi_awaddr, 
  s_axi_awvalid, s_axi_awready, s_axi_wdata, s_axi_wstrb, s_axi_wvalid, s_axi_wready, 
  s_axi_bresp, s_axi_bvalid, s_axi_bready, s_axi_araddr, s_axi_arvalid, s_axi_arready, 
  s_axi_rdata, s_axi_rresp, s_axi_rvalid, s_axi_rready, gpio_io_i, gpio_io_o, gpio_io_t)
/* synthesis syn_black_box black_box_pad_pin="s_axi_aresetn,s_axi_awaddr[8:0],s_axi_awvalid,s_axi_awready,s_axi_wdata[31:0],s_axi_wstrb[3:0],s_axi_wvalid,s_axi_wready,s_axi_bresp[1:0],s_axi_bvalid,s_axi_bready,s_axi_araddr[8:0],s_axi_arvalid,s_axi_arready,s_axi_rdata[31:0],s_axi_rresp[1:0],s_axi_rvalid,s_axi_rready,gpio_io_i[7:0],gpio_io_o[7:0],gpio_io_t[7:0]" */
/* synthesis syn_force_seq_prim="s_axi_aclk" */;
  input s_axi_aclk /* synthesis syn_isclock = 1 */;
  input s_axi_aresetn;
  input [8:0]s_axi_awaddr;
  input s_axi_awvalid;
  output s_axi_awready;
  input [31:0]s_axi_wdata;
  input [3:0]s_axi_wstrb;
  input s_axi_wvalid;
  output s_axi_wready;
  output [1:0]s_axi_bresp;
  output s_axi_bvalid;
  input s_axi_bready;
  input [8:0]s_axi_araddr;
  input s_axi_arvalid;
  output s_axi_arready;
  output [31:0]s_axi_rdata;
  output [1:0]s_axi_rresp;
  output s_axi_rvalid;
  input s_axi_rready;
  input [7:0]gpio_io_i;
  output [7:0]gpio_io_o;
  output [7:0]gpio_io_t;
endmodule
