Louis-VL/PCB-ADVANCED/VIVADO/SpartanMicroBlaze/SpartanMicroBlaze.cache/ip/2023.1/7/f/7faf3355ddcae86c/MicroBlazeV2_dlmb_v10_0_stub.v

// Copyright 1986-2022 Xilinx, Inc. All Rights Reserved.
// Copyright 2022-2023 Advanced Micro Devices, Inc. All Rights Reserved.
// --------------------------------------------------------------------------------
// Tool Version: Vivado v.2023.1 (win64) Build 3865809 Sun May  7 15:05:29 MDT 2023
// Date        : Wed Dec 13 14:44:38 2023
// Host        : LAPTOP-K67JHBA7 running 64-bit major release  (build 9200)
// Command     : write_verilog -force -mode synth_stub -rename_top decalper_eb_ot_sdeen_pot_pi_dehcac_xnilix -prefix
//               decalper_eb_ot_sdeen_pot_pi_dehcac_xnilix_ MicroBlazeV2_dlmb_v10_0_stub.v
// Design      : MicroBlazeV2_dlmb_v10_0
// Purpose     : Stub declaration of top-level module interface
// Device      : xc7s6ftgb196-1
// --------------------------------------------------------------------------------

// This empty module with port declaration file causes synthesis tools to infer a black box for IP.
// The synthesis directives are for Synopsys Synplify support to prevent IO buffer insertion.
// Please paste the declaration into a Verilog source file or add the file as an additional source.
(* x_core_info = "lmb_v10,Vivado 2023.1" *)
module decalper_eb_ot_sdeen_pot_pi_dehcac_xnilix(LMB_Clk, SYS_Rst, LMB_Rst, M_ABus, M_ReadStrobe, 
  M_WriteStrobe, M_AddrStrobe, M_DBus, M_BE, Sl_DBus, Sl_Ready, Sl_Wait, Sl_UE, Sl_CE, LMB_ABus, 
  LMB_ReadStrobe, LMB_WriteStrobe, LMB_AddrStrobe, LMB_ReadDBus, LMB_WriteDBus, LMB_Ready, 
  LMB_Wait, LMB_UE, LMB_CE, LMB_BE)
/* synthesis syn_black_box black_box_pad_pin="SYS_Rst,LMB_Rst,M_ABus[0:31],M_ReadStrobe,M_WriteStrobe,M_AddrStrobe,M_DBus[0:31],M_BE[0:3],Sl_DBus[0:31],Sl_Ready[0:0],Sl_Wait[0:0],Sl_UE[0:0],Sl_CE[0:0],LMB_ABus[0:31],LMB_ReadStrobe,LMB_WriteStrobe,LMB_AddrStrobe,LMB_ReadDBus[0:31],LMB_WriteDBus[0:31],LMB_Ready,LMB_Wait,LMB_UE,LMB_CE,LMB_BE[0:3]" */
/* synthesis syn_force_seq_prim="LMB_Clk" */;
  input LMB_Clk /* synthesis syn_isclock = 1 */;
  input SYS_Rst;
  output LMB_Rst;
  input [0:31]M_ABus;
  input M_ReadStrobe;
  input M_WriteStrobe;
  input M_AddrStrobe;
  input [0:31]M_DBus;
  input [0:3]M_BE;
  input [0:31]Sl_DBus;
  input [0:0]Sl_Ready;
  input [0:0]Sl_Wait;
  input [0:0]Sl_UE;
  input [0:0]Sl_CE;
  output [0:31]LMB_ABus;
  output LMB_ReadStrobe;
  output LMB_WriteStrobe;
  output LMB_AddrStrobe;
  output [0:31]LMB_ReadDBus;
  output [0:31]LMB_WriteDBus;
  output LMB_Ready;
  output LMB_Wait;
  output LMB_UE;
  output LMB_CE;
  output [0:3]LMB_BE;
endmodule
