Louis-VL/PCB-ADVANCED/VIVADO/SpartanMicroBlaze/SpartanMicroBlaze.cache/ip/2023.1/4/3/4344ebac38ea80b1/MicroBlazeV2_xbar_0_sim_netlist.v

// Copyright 1986-2022 Xilinx, Inc. All Rights Reserved.
// Copyright 2022-2023 Advanced Micro Devices, Inc. All Rights Reserved.
// --------------------------------------------------------------------------------
// Tool Version: Vivado v.2023.1 (win64) Build 3865809 Sun May  7 15:05:29 MDT 2023
// Date        : Sat Dec 16 23:13:22 2023
// Host        : LAPTOP-K67JHBA7 running 64-bit major release  (build 9200)
// Command     : write_verilog -force -mode funcsim -rename_top decalper_eb_ot_sdeen_pot_pi_dehcac_xnilix -prefix
//               decalper_eb_ot_sdeen_pot_pi_dehcac_xnilix_ MicroBlazeV2_xbar_0_sim_netlist.v
// Design      : MicroBlazeV2_xbar_0
// Purpose     : This verilog netlist is a functional simulation representation of the design and should not be modified
//               or synthesized. This netlist cannot be used for SDF annotated simulation.
// Device      : xc7s6ftgb196-1
// --------------------------------------------------------------------------------
`timescale 1 ps / 1 ps

(* CHECK_LICENSE_TYPE = "MicroBlazeV2_xbar_0,axi_crossbar_v2_1_29_axi_crossbar,{}" *) (* DowngradeIPIdentifiedWarnings = "yes" *) (* X_CORE_INFO = "axi_crossbar_v2_1_29_axi_crossbar,Vivado 2023.1" *) 
(* NotValidForBitStream *)
module decalper_eb_ot_sdeen_pot_pi_dehcac_xnilix
   (aclk,
    aresetn,
    s_axi_awaddr,
    s_axi_awprot,
    s_axi_awvalid,
    s_axi_awready,
    s_axi_wdata,
    s_axi_wstrb,
    s_axi_wvalid,
    s_axi_wready,
    s_axi_bresp,
    s_axi_bvalid,
    s_axi_bready,
    s_axi_araddr,
    s_axi_arprot,
    s_axi_arvalid,
    s_axi_arready,
    s_axi_rdata,
    s_axi_rresp,
    s_axi_rvalid,
    s_axi_rready,
    m_axi_awaddr,
    m_axi_awprot,
    m_axi_awvalid,
    m_axi_awready,
    m_axi_wdata,
    m_axi_wstrb,
    m_axi_wvalid,
    m_axi_wready,
    m_axi_bresp,
    m_axi_bvalid,
    m_axi_bready,
    m_axi_araddr,
    m_axi_arprot,
    m_axi_arvalid,
    m_axi_arready,
    m_axi_rdata,
    m_axi_rresp,
    m_axi_rvalid,
    m_axi_rready);
  (* X_INTERFACE_INFO = "xilinx.com:signal:clock:1.0 CLKIF CLK" *) (* X_INTERFACE_PARAMETER = "XIL_INTERFACENAME CLKIF, FREQ_HZ 100000000, FREQ_TOLERANCE_HZ 0, PHASE 0.0, CLK_DOMAIN MicroBlazeV2_clk_in1_n_0, ASSOCIATED_BUSIF M00_AXI:M01_AXI:M02_AXI:M03_AXI:M04_AXI:M05_AXI:M06_AXI:M07_AXI:M08_AXI:M09_AXI:M10_AXI:M11_AXI:M12_AXI:M13_AXI:M14_AXI:M15_AXI:S00_AXI:S01_AXI:S02_AXI:S03_AXI:S04_AXI:S05_AXI:S06_AXI:S07_AXI:S08_AXI:S09_AXI:S10_AXI:S11_AXI:S12_AXI:S13_AXI:S14_AXI:S15_AXI, ASSOCIATED_RESET ARESETN, INSERT_VIP 0" *) input aclk;
  (* X_INTERFACE_INFO = "xilinx.com:signal:reset:1.0 RSTIF RST" *) (* X_INTERFACE_PARAMETER = "XIL_INTERFACENAME RSTIF, POLARITY ACTIVE_LOW, INSERT_VIP 0, TYPE INTERCONNECT" *) input aresetn;
  (* X_INTERFACE_INFO = "xilinx.com:interface:aximm:1.0 S00_AXI AWADDR" *) input [31:0]s_axi_awaddr;
  (* X_INTERFACE_INFO = "xilinx.com:interface:aximm:1.0 S00_AXI AWPROT" *) input [2:0]s_axi_awprot;
  (* X_INTERFACE_INFO = "xilinx.com:interface:aximm:1.0 S00_AXI AWVALID" *) input [0:0]s_axi_awvalid;
  (* X_INTERFACE_INFO = "xilinx.com:interface:aximm:1.0 S00_AXI AWREADY" *) output [0:0]s_axi_awready;
  (* X_INTERFACE_INFO = "xilinx.com:interface:aximm:1.0 S00_AXI WDATA" *) input [31:0]s_axi_wdata;
  (* X_INTERFACE_INFO = "xilinx.com:interface:aximm:1.0 S00_AXI WSTRB" *) input [3:0]s_axi_wstrb;
  (* X_INTERFACE_INFO = "xilinx.com:interface:aximm:1.0 S00_AXI WVALID" *) input [0:0]s_axi_wvalid;
  (* X_INTERFACE_INFO = "xilinx.com:interface:aximm:1.0 S00_AXI WREADY" *) output [0:0]s_axi_wready;
  (* X_INTERFACE_INFO = "xilinx.com:interface:aximm:1.0 S00_AXI BRESP" *) output [1:0]s_axi_bresp;
  (* X_INTERFACE_INFO = "xilinx.com:interface:aximm:1.0 S00_AXI BVALID" *) output [0:0]s_axi_bvalid;
  (* X_INTERFACE_INFO = "xilinx.com:interface:aximm:1.0 S00_AXI BREADY" *) input [0:0]s_axi_bready;
  (* X_INTERFACE_INFO = "xilinx.com:interface:aximm:1.0 S00_AXI ARADDR" *) input [31:0]s_axi_araddr;
  (* X_INTERFACE_INFO = "xilinx.com:interface:aximm:1.0 S00_AXI ARPROT" *) input [2:0]s_axi_arprot;
  (* X_INTERFACE_INFO = "xilinx.com:interface:aximm:1.0 S00_AXI ARVALID" *) input [0:0]s_axi_arvalid;
  (* X_INTERFACE_INFO = "xilinx.com:interface:aximm:1.0 S00_AXI ARREADY" *) output [0:0]s_axi_arready;
  (* X_INTERFACE_INFO = "xilinx.com:interface:aximm:1.0 S00_AXI RDATA" *) output [31:0]s_axi_rdata;
  (* X_INTERFACE_INFO = "xilinx.com:interface:aximm:1.0 S00_AXI RRESP" *) output [1:0]s_axi_rresp;
  (* X_INTERFACE_INFO = "xilinx.com:interface:aximm:1.0 S00_AXI RVALID" *) output [0:0]s_axi_rvalid;
  (* X_INTERFACE_INFO = "xilinx.com:interface:aximm:1.0 S00_AXI RREADY" *) (* X_INTERFACE_PARAMETER = "XIL_INTERFACENAME S00_AXI, DATA_WIDTH 32, PROTOCOL AXI4LITE, FREQ_HZ 100000000, ID_WIDTH 0, ADDR_WIDTH 32, AWUSER_WIDTH 0, ARUSER_WIDTH 0, WUSER_WIDTH 0, RUSER_WIDTH 0, BUSER_WIDTH 0, READ_WRITE_MODE READ_WRITE, HAS_BURST 0, HAS_LOCK 0, HAS_PROT 1, HAS_CACHE 0, HAS_QOS 0, HAS_REGION 0, HAS_WSTRB 1, HAS_BRESP 1, HAS_RRESP 1, SUPPORTS_NARROW_BURST 0, NUM_READ_OUTSTANDING 1, NUM_WRITE_OUTSTANDING 1, MAX_BURST_LENGTH 1, PHASE 0.0, CLK_DOMAIN MicroBlazeV2_clk_in1_n_0, NUM_READ_THREADS 1, NUM_WRITE_THREADS 1, RUSER_BITS_PER_BYTE 0, WUSER_BITS_PER_BYTE 0, INSERT_VIP 0" *) input [0:0]s_axi_rready;
  (* X_INTERFACE_INFO = "xilinx.com:interface:aximm:1.0 M00_AXI AWADDR [31:0] [31:0], xilinx.com:interface:aximm:1.0 M01_AXI AWADDR [31:0] [63:32], xilinx.com:interface:aximm:1.0 M02_AXI AWADDR [31:0] [95:64], xilinx.com:interface:aximm:1.0 M03_AXI AWADDR [31:0] [127:96], xilinx.com:interface:aximm:1.0 M04_AXI AWADDR [31:0] [159:128], xilinx.com:interface:aximm:1.0 M05_AXI AWADDR [31:0] [191:160]" *) output [191:0]m_axi_awaddr;
  (* X_INTERFACE_INFO = "xilinx.com:interface:aximm:1.0 M00_AXI AWPROT [2:0] [2:0], xilinx.com:interface:aximm:1.0 M01_AXI AWPROT [2:0] [5:3], xilinx.com:interface:aximm:1.0 M02_AXI AWPROT [2:0] [8:6], xilinx.com:interface:aximm:1.0 M03_AXI AWPROT [2:0] [11:9], xilinx.com:interface:aximm:1.0 M04_AXI AWPROT [2:0] [14:12], xilinx.com:interface:aximm:1.0 M05_AXI AWPROT [2:0] [17:15]" *) output [17:0]m_axi_awprot;
  (* X_INTERFACE_INFO = "xilinx.com:interface:aximm:1.0 M00_AXI AWVALID [0:0] [0:0], xilinx.com:interface:aximm:1.0 M01_AXI AWVALID [0:0] [1:1], xilinx.com:interface:aximm:1.0 M02_AXI AWVALID [0:0] [2:2], xilinx.com:interface:aximm:1.0 M03_AXI AWVALID [0:0] [3:3], xilinx.com:interface:aximm:1.0 M04_AXI AWVALID [0:0] [4:4], xilinx.com:interface:aximm:1.0 M05_AXI AWVALID [0:0] [5:5]" *) output [5:0]m_axi_awvalid;
  (* X_INTERFACE_INFO = "xilinx.com:interface:aximm:1.0 M00_AXI AWREADY [0:0] [0:0], xilinx.com:interface:aximm:1.0 M01_AXI AWREADY [0:0] [1:1], xilinx.com:interface:aximm:1.0 M02_AXI AWREADY [0:0] [2:2], xilinx.com:interface:aximm:1.0 M03_AXI AWREADY [0:0] [3:3], xilinx.com:interface:aximm:1.0 M04_AXI AWREADY [0:0] [4:4], xilinx.com:interface:aximm:1.0 M05_AXI AWREADY [0:0] [5:5]" *) input [5:0]m_axi_awready;
  (* X_INTERFACE_INFO = "xilinx.com:interface:aximm:1.0 M00_AXI WDATA [31:0] [31:0], xilinx.com:interface:aximm:1.0 M01_AXI WDATA [31:0] [63:32], xilinx.com:interface:aximm:1.0 M02_AXI WDATA [31:0] [95:64], xilinx.com:interface:aximm:1.0 M03_AXI WDATA [31:0] [127:96], xilinx.com:interface:aximm:1.0 M04_AXI WDATA [31:0] [159:128], xilinx.com:interface:aximm:1.0 M05_AXI WDATA [31:0] [191:160]" *) output [191:0]m_axi_wdata;
  (* X_INTERFACE_INFO = "xilinx.com:interface:aximm:1.0 M00_AXI WSTRB [3:0] [3:0], xilinx.com:interface:aximm:1.0 M01_AXI WSTRB [3:0] [7:4], xilinx.com:interface:aximm:1.0 M02_AXI WSTRB [3:0] [11:8], xilinx.com:interface:aximm:1.0 M03_AXI WSTRB [3:0] [15:12], xilinx.com:interface:aximm:1.0 M04_AXI WSTRB [3:0] [19:16], xilinx.com:interface:aximm:1.0 M05_AXI WSTRB [3:0] [23:20]" *) output [23:0]m_axi_wstrb;
  (* X_INTERFACE_INFO = "xilinx.com:interface:aximm:1.0 M00_AXI WVALID [0:0] [0:0], xilinx.com:interface:aximm:1.0 M01_AXI WVALID [0:0] [1:1], xilinx.com:interface:aximm:1.0 M02_AXI WVALID [0:0] [2:2], xilinx.com:interface:aximm:1.0 M03_AXI WVALID [0:0] [3:3], xilinx.com:interface:aximm:1.0 M04_AXI WVALID [0:0] [4:4], xilinx.com:interface:aximm:1.0 M05_AXI WVALID [0:0] [5:5]" *) output [5:0]m_axi_wvalid;
  (* X_INTERFACE_INFO = "xilinx.com:interface:aximm:1.0 M00_AXI WREADY [0:0] [0:0], xilinx.com:interface:aximm:1.0 M01_AXI WREADY [0:0] [1:1], xilinx.com:interface:aximm:1.0 M02_AXI WREADY [0:0] [2:2], xilinx.com:interface:aximm:1.0 M03_AXI WREADY [0:0] [3:3], xilinx.com:interface:aximm:1.0 M04_AXI WREADY [0:0] [4:4], xilinx.com:interface:aximm:1.0 M05_AXI WREADY [0:0] [5:5]" *) input [5:0]m_axi_wready;
  (* X_INTERFACE_INFO = "xilinx.com:interface:aximm:1.0 M00_AXI BRESP [1:0] [1:0], xilinx.com:interface:aximm:1.0 M01_AXI BRESP [1:0] [3:2], xilinx.com:interface:aximm:1.0 M02_AXI BRESP [1:0] [5:4], xilinx.com:interface:aximm:1.0 M03_AXI BRESP [1:0] [7:6], xilinx.com:interface:aximm:1.0 M04_AXI BRESP [1:0] [9:8], xilinx.com:interface:aximm:1.0 M05_AXI BRESP [1:0] [11:10]" *) input [11:0]m_axi_bresp;
  (* X_INTERFACE_INFO = "xilinx.com:interface:aximm:1.0 M00_AXI BVALID [0:0] [0:0], xilinx.com:interface:aximm:1.0 M01_AXI BVALID [0:0] [1:1], xilinx.com:interface:aximm:1.0 M02_AXI BVALID [0:0] [2:2], xilinx.com:interface:aximm:1.0 M03_AXI BVALID [0:0] [3:3], xilinx.com:interface:aximm:1.0 M04_AXI BVALID [0:0] [4:4], xilinx.com:interface:aximm:1.0 M05_AXI BVALID [0:0] [5:5]" *) input [5:0]m_axi_bvalid;
  (* X_INTERFACE_INFO = "xilinx.com:interface:aximm:1.0 M00_AXI BREADY [0:0] [0:0], xilinx.com:interface:aximm:1.0 M01_AXI BREADY [0:0] [1:1], xilinx.com:interface:aximm:1.0 M02_AXI BREADY [0:0] [2:2], xilinx.com:interface:aximm:1.0 M03_AXI BREADY [0:0] [3:3], xilinx.com:interface:aximm:1.0 M04_AXI BREADY [0:0] [4:4], xilinx.com:interface:aximm:1.0 M05_AXI BREADY [0:0] [5:5]" *) output [5:0]m_axi_bready;
  (* X_INTERFACE_INFO = "xilinx.com:interface:aximm:1.0 M00_AXI ARADDR [31:0] [31:0], xilinx.com:interface:aximm:1.0 M01_AXI ARADDR [31:0] [63:32], xilinx.com:interface:aximm:1.0 M02_AXI ARADDR [31:0] [95:64], xilinx.com:interface:aximm:1.0 M03_AXI ARADDR [31:0] [127:96], xilinx.com:interface:aximm:1.0 M04_AXI ARADDR [31:0] [159:128], xilinx.com:interface:aximm:1.0 M05_AXI ARADDR [31:0] [191:160]" *) output [191:0]m_axi_araddr;
  (* X_INTERFACE_INFO = "xilinx.com:interface:aximm:1.0 M00_AXI ARPROT [2:0] [2:0], xilinx.com:interface:aximm:1.0 M01_AXI ARPROT [2:0] [5:3], xilinx.com:interface:aximm:1.0 M02_AXI ARPROT [2:0] [8:6], xilinx.com:interface:aximm:1.0 M03_AXI ARPROT [2:0] [11:9], xilinx.com:interface:aximm:1.0 M04_AXI ARPROT [2:0] [14:12], xilinx.com:interface:aximm:1.0 M05_AXI ARPROT [2:0] [17:15]" *) output [17:0]m_axi_arprot;
  (* X_INTERFACE_INFO = "xilinx.com:interface:aximm:1.0 M00_AXI ARVALID [0:0] [0:0], xilinx.com:interface:aximm:1.0 M01_AXI ARVALID [0:0] [1:1], xilinx.com:interface:aximm:1.0 M02_AXI ARVALID [0:0] [2:2], xilinx.com:interface:aximm:1.0 M03_AXI ARVALID [0:0] [3:3], xilinx.com:interface:aximm:1.0 M04_AXI ARVALID [0:0] [4:4], xilinx.com:interface:aximm:1.0 M05_AXI ARVALID [0:0] [5:5]" *) output [5:0]m_axi_arvalid;
  (* X_INTERFACE_INFO = "xilinx.com:interface:aximm:1.0 M00_AXI ARREADY [0:0] [0:0], xilinx.com:interface:aximm:1.0 M01_AXI ARREADY [0:0] [1:1], xilinx.com:interface:aximm:1.0 M02_AXI ARREADY [0:0] [2:2], xilinx.com:interface:aximm:1.0 M03_AXI ARREADY [0:0] [3:3], xilinx.com:interface:aximm:1.0 M04_AXI ARREADY [0:0] [4:4], xilinx.com:interface:aximm:1.0 M05_AXI ARREADY [0:0] [5:5]" *) input [5:0]m_axi_arready;
  (* X_INTERFACE_INFO = "xilinx.com:interface:aximm:1.0 M00_AXI RDATA [31:0] [31:0], xilinx.com:interface:aximm:1.0 M01_AXI RDATA [31:0] [63:32], xilinx.com:interface:aximm:1.0 M02_AXI RDATA [31:0] [95:64], xilinx.com:interface:aximm:1.0 M03_AXI RDATA [31:0] [127:96], xilinx.com:interface:aximm:1.0 M04_AXI RDATA [31:0] [159:128], xilinx.com:interface:aximm:1.0 M05_AXI RDATA [31:0] [191:160]" *) input [191:0]m_axi_rdata;
  (* X_INTERFACE_INFO = "xilinx.com:interface:aximm:1.0 M00_AXI RRESP [1:0] [1:0], xilinx.com:interface:aximm:1.0 M01_AXI RRESP [1:0] [3:2], xilinx.com:interface:aximm:1.0 M02_AXI RRESP [1:0] [5:4], xilinx.com:interface:aximm:1.0 M03_AXI RRESP [1:0] [7:6], xilinx.com:interface:aximm:1.0 M04_AXI RRESP [1:0] [9:8], xilinx.com:interface:aximm:1.0 M05_AXI RRESP [1:0] [11:10]" *) input [11:0]m_axi_rresp;
  (* X_INTERFACE_INFO = "xilinx.com:interface:aximm:1.0 M00_AXI RVALID [0:0] [0:0], xilinx.com:interface:aximm:1.0 M01_AXI RVALID [0:0] [1:1], xilinx.com:interface:aximm:1.0 M02_AXI RVALID [0:0] [2:2], xilinx.com:interface:aximm:1.0 M03_AXI RVALID [0:0] [3:3], xilinx.com:interface:aximm:1.0 M04_AXI RVALID [0:0] [4:4], xilinx.com:interface:aximm:1.0 M05_AXI RVALID [0:0] [5:5]" *) input [5:0]m_axi_rvalid;
  (* X_INTERFACE_INFO = "xilinx.com:interface:aximm:1.0 M00_AXI RREADY [0:0] [0:0], xilinx.com:interface:aximm:1.0 M01_AXI RREADY [0:0] [1:1], xilinx.com:interface:aximm:1.0 M02_AXI RREADY [0:0] [2:2], xilinx.com:interface:aximm:1.0 M03_AXI RREADY [0:0] [3:3], xilinx.com:interface:aximm:1.0 M04_AXI 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

  wire \<const0> ;
  wire aclk;
  wire aresetn;
  wire [191:0]m_axi_araddr;
  wire [17:0]m_axi_arprot;
  wire [5:0]m_axi_arready;
  wire [4:0]\^m_axi_arvalid ;
  wire [191:0]m_axi_awaddr;
  wire [17:0]m_axi_awprot;
  wire [5:0]m_axi_awready;
  wire [4:0]\^m_axi_awvalid ;
  wire [4:0]\^m_axi_bready ;
  wire [11:0]m_axi_bresp;
  wire [5:0]m_axi_bvalid;
  wire [191:0]m_axi_rdata;
  wire [4:0]\^m_axi_rready ;
  wire [11:0]m_axi_rresp;
  wire [5:0]m_axi_rvalid;
  wire [191:0]m_axi_wdata;
  wire [5:0]m_axi_wready;
  wire [23:0]m_axi_wstrb;
  wire [4:0]\^m_axi_wvalid ;
  wire [31:0]s_axi_araddr;
  wire [2:0]s_axi_arprot;
  wire [0:0]s_axi_arready;
  wire [0:0]s_axi_arvalid;
  wire [31:0]s_axi_awaddr;
  wire [2:0]s_axi_awprot;
  wire [0:0]s_axi_awready;
  wire [0:0]s_axi_awvalid;
  wire [0:0]s_axi_bready;
  wire [1:0]s_axi_bresp;
  wire [0:0]s_axi_bvalid;
  wire [31:0]s_axi_rdata;
  wire [0:0]s_axi_rready;
  wire [1:0]s_axi_rresp;
  wire [0:0]s_axi_rvalid;
  wire [31:0]s_axi_wdata;
  wire [0:0]s_axi_wready;
  wire [3:0]s_axi_wstrb;
  wire [0:0]s_axi_wvalid;
  wire [11:0]NLW_inst_m_axi_arburst_UNCONNECTED;
  wire [23:0]NLW_inst_m_axi_arcache_UNCONNECTED;
  wire [5:0]NLW_inst_m_axi_arid_UNCONNECTED;
  wire [47:0]NLW_inst_m_axi_arlen_UNCONNECTED;
  wire [5:0]NLW_inst_m_axi_arlock_UNCONNECTED;
  wire [23:0]NLW_inst_m_axi_arqos_UNCONNECTED;
  wire [23:0]NLW_inst_m_axi_arregion_UNCONNECTED;
  wire [17:0]NLW_inst_m_axi_arsize_UNCONNECTED;
  wire [5:0]NLW_inst_m_axi_aruser_UNCONNECTED;
  wire [5:5]NLW_inst_m_axi_arvalid_UNCONNECTED;
  wire [11:0]NLW_inst_m_axi_awburst_UNCONNECTED;
  wire [23:0]NLW_inst_m_axi_awcache_UNCONNECTED;
  wire [5:0]NLW_inst_m_axi_awid_UNCONNECTED;
  wire [47:0]NLW_inst_m_axi_awlen_UNCONNECTED;
  wire [5:0]NLW_inst_m_axi_awlock_UNCONNECTED;
  wire [23:0]NLW_inst_m_axi_awqos_UNCONNECTED;
  wire [23:0]NLW_inst_m_axi_awregion_UNCONNECTED;
  wire [17:0]NLW_inst_m_axi_awsize_UNCONNECTED;
  wire [5:0]NLW_inst_m_axi_awuser_UNCONNECTED;
  wire [5:5]NLW_inst_m_axi_awvalid_UNCONNECTED;
  wire [5:5]NLW_inst_m_axi_bready_UNCONNECTED;
  wire [5:5]NLW_inst_m_axi_rready_UNCONNECTED;
  wire [5:0]NLW_inst_m_axi_wid_UNCONNECTED;
  wire [5:0]NLW_inst_m_axi_wlast_UNCONNECTED;
  wire [5:0]NLW_inst_m_axi_wuser_UNCONNECTED;
  wire [5:5]NLW_inst_m_axi_wvalid_UNCONNECTED;
  wire [0:0]NLW_inst_s_axi_bid_UNCONNECTED;
  wire [0:0]NLW_inst_s_axi_buser_UNCONNECTED;
  wire [0:0]NLW_inst_s_axi_rid_UNCONNECTED;
  wire [0:0]NLW_inst_s_axi_rlast_UNCONNECTED;
  wire [0:0]NLW_inst_s_axi_ruser_UNCONNECTED;

  assign m_axi_arvalid[5] = \<const0> ;
  assign m_axi_arvalid[4:0] = \^m_axi_arvalid [4:0];
  assign m_axi_awvalid[5] = \<const0> ;
  assign m_axi_awvalid[4:0] = \^m_axi_awvalid [4:0];
  assign m_axi_bready[5] = \<const0> ;
  assign m_axi_bready[4:0] = \^m_axi_bready [4:0];
  assign m_axi_rready[5] = \<const0> ;
  assign m_axi_rready[4:0] = \^m_axi_rready [4:0];
  assign m_axi_wvalid[5] = \<const0> ;
  assign m_axi_wvalid[4:0] = \^m_axi_wvalid [4:0];
  GND GND
       (.G(\<const0> ));
  (* C_AXI_ADDR_WIDTH = "32" *) 
  (* C_AXI_ARUSER_WIDTH = "1" *) 
  (* C_AXI_AWUSER_WIDTH = "1" *) 
  (* C_AXI_BUSER_WIDTH = "1" *) 
  (* C_AXI_DATA_WIDTH = "32" *) 
  (* C_AXI_ID_WIDTH = "1" *) 
  (* C_AXI_PROTOCOL = "2" *) 
  (* C_AXI_RUSER_WIDTH = "1" *) 
  (* C_AXI_SUPPORTS_USER_SIGNALS = "0" *) 
  (* C_AXI_WUSER_WIDTH = "1" *) 
  (* C_CONNECTIVITY_MODE = "0" *) 
  (* C_DEBUG = "1" *) 
  (* C_FAMILY = "spartan7" *) 
  (* C_M_AXI_ADDR_WIDTH = "192'b000000000000000000000000000000000000000000000000000000000001000000000000000000000000000000010000000000000000000000000000000100000000000000000000000000000001000000000000000000000000000000010000" *) 
  (* C_M_AXI_BASE_ADDR = "384'b111111111111111111111111111111111111111111111111111111111111111100000000000000000000000000000000010000000000001100000000000000000000000000000000000000000000000001000000000000100000000000000000000000000000000000000000000000000100000000000001000000000000000000000000000000000000000000000000010000000110000000000000000000000000000000000000000000000000000001000000000000000000000000000000" *) 
  (* C_M_AXI_READ_CONNECTIVITY = "192'b000000000000000000000000000000010000000000000000000000000000000100000000000000000000000000000001000000000000000000000000000000010000000000000000000000000000000100000000000000000000000000000001" *) 
  (* C_M_AXI_READ_ISSUING = "192'b000000000000000000000000000000010000000000000000000000000000000100000000000000000000000000000001000000000000000000000000000000010000000000000000000000000000000100000000000000000000000000000001" *) 
  (* C_M_AXI_SECURE = "192'b000000000000000000000000000000000000000000000000000000000000000000000000000000000000000000000000000000000000000000000000000000000000000000000000000000000000000000000000000000000000000000000000" *) 
  (* C_M_AXI_WRITE_CONNECTIVITY = "192'b000000000000000000000000000000010000000000000000000000000000000100000000000000000000000000000001000000000000000000000000000000010000000000000000000000000000000100000000000000000000000000000001" *) 
  (* C_M_AXI_WRITE_ISSUING = "192'b000000000000000000000000000000010000000000000000000000000000000100000000000000000000000000000001000000000000000000000000000000010000000000000000000000000000000100000000000000000000000000000001" *) 
  (* C_NUM_ADDR_RANGES = "1" *) 
  (* C_NUM_MASTER_SLOTS = "6" *) 
  (* C_NUM_SLAVE_SLOTS = "1" *) 
  (* C_R_REGISTER = "1" *) 
  (* C_S_AXI_ARB_PRIORITY = "0" *) 
  (* C_S_AXI_BASE_ID = "0" *) 
  (* C_S_AXI_READ_ACCEPTANCE = "1" *) 
  (* C_S_AXI_SINGLE_THREAD = "1" *) 
  (* C_S_AXI_THREAD_ID_WIDTH = "0" *) 
  (* C_S_AXI_WRITE_ACCEPTANCE = "1" *) 
  (* DowngradeIPIdentifiedWarnings = "yes" *) 
  (* P_ADDR_DECODE = "1" *) 
  (* P_AXI3 = "1" *) 
  (* P_AXI4 = "0" *) 
  (* P_AXILITE = "2" *) 
  (* P_AXILITE_SIZE = "3'b010" *) 
  (* P_FAMILY = "rtl" *) 
  (* P_INCR = "2'b01" *) 
  (* P_LEN = "8" *) 
  (* P_LOCK = "1" *) 
  (* P_M_AXI_ERR_MODE = "192'b000000000000000000000000000000000000000000000000000000000000000000000000000000000000000000000000000000000000000000000000000000000000000000000000000000000000000000000000000000000000000000000000" *) 
  (* P_M_AXI_SUPPORTS_READ = "6'b111111" *) 
  (* P_M_AXI_SUPPORTS_WRITE = "6'b111111" *) 
  (* P_ONES = "65'b11111111111111111111111111111111111111111111111111111111111111111" *) 
  (* P_RANGE_CHECK = "1" *) 
  (* P_S_AXI_BASE_ID = "64'b0000000000000000000000000000000000000000000000000000000000000000" *) 
  (* P_S_AXI_HIGH_ID = "64'b0000000000000000000000000000000000000000000000000000000000000000" *) 
  (* P_S_AXI_SUPPORTS_READ = "1'b1" *) 
  (* P_S_AXI_SUPPORTS_WRITE = "1'b1" *) 
  decalper_eb_ot_sdeen_pot_pi_dehcac_xnilix_axi_crossbar_v2_1_29_axi_crossbar inst
       (.aclk(aclk),
        .aresetn(aresetn),
        .m_axi_araddr(m_axi_araddr),
        .m_axi_arburst(NLW_inst_m_axi_arburst_UNCONNECTED[11:0]),
        .m_axi_arcache(NLW_inst_m_axi_arcache_UNCONNECTED[23:0]),
        .m_axi_arid(NLW_inst_m_axi_arid_UNCONNECTED[5:0]),
        .m_axi_arlen(NLW_inst_m_axi_arlen_UNCONNECTED[47:0]),
        .m_axi_arlock(NLW_inst_m_axi_arlock_UNCONNECTED[5:0]),
        .m_axi_arprot(m_axi_arprot),
        .m_axi_arqos(NLW_inst_m_axi_arqos_UNCONNECTED[23:0]),
        .m_axi_arready(m_axi_arready),
        .m_axi_arregion(NLW_inst_m_axi_arregion_UNCONNECTED[23:0]),
        .m_axi_arsize(NLW_inst_m_axi_arsize_UNCONNECTED[17:0]),
        .m_axi_aruser(NLW_inst_m_axi_aruser_UNCONNECTED[5:0]),
        .m_axi_arvalid({NLW_inst_m_axi_arvalid_UNCONNECTED[5],\^m_axi_arvalid }),
        .m_axi_awaddr(m_axi_awaddr),
        .m_axi_awburst(NLW_inst_m_axi_awburst_UNCONNECTED[11:0]),
        .m_axi_awcache(NLW_inst_m_axi_awcache_UNCONNECTED[23:0]),
        .m_axi_awid(NLW_inst_m_axi_awid_UNCONNECTED[5:0]),
        .m_axi_awlen(NLW_inst_m_axi_awlen_UNCONNECTED[47:0]),
        .m_axi_awlock(NLW_inst_m_axi_awlock_UNCONNECTED[5:0]),
        .m_axi_awprot(m_axi_awprot),
        .m_axi_awqos(NLW_inst_m_axi_awqos_UNCONNECTED[23:0]),
        .m_axi_awready(m_axi_awready),
        .m_axi_awregion(NLW_inst_m_axi_awregion_UNCONNECTED[23:0]),
        .m_axi_awsize(NLW_inst_m_axi_awsize_UNCONNECTED[17:0]),
        .m_axi_awuser(NLW_inst_m_axi_awuser_UNCONNECTED[5:0]),
        .m_axi_awvalid({NLW_inst_m_axi_awvalid_UNCONNECTED[5],\^m_axi_awvalid }),
        .m_axi_bid({1'b0,1'b0,1'b0,1'b0,1'b0,1'b0}),
        .m_axi_bready({NLW_inst_m_axi_bready_UNCONNECTED[5],\^m_axi_bready }),
        .m_axi_bresp(m_axi_bresp),
        .m_axi_buser({1'b0,1'b0,1'b0,1'b0,1'b0,1'b0}),
        .m_axi_bvalid(m_axi_bvalid),
        .m_axi_rdata(m_axi_rdata),
        .m_axi_rid({1'b0,1'b0,1'b0,1'b0,1'b0,1'b0}),
        .m_axi_rlast({1'b1,1'b1,1'b1,1'b1,1'b1,1'b1}),
        .m_axi_rready({NLW_inst_m_axi_rready_UNCONNECTED[5],\^m_axi_rready }),
        .m_axi_rresp(m_axi_rresp),
        .m_axi_ruser({1'b0,1'b0,1'b0,1'b0,1'b0,1'b0}),
        .m_axi_rvalid(m_axi_rvalid),
        .m_axi_wdata(m_axi_wdata),
        .m_axi_wid(NLW_inst_m_axi_wid_UNCONNECTED[5:0]),
        .m_axi_wlast(NLW_inst_m_axi_wlast_UNCONNECTED[5:0]),
        .m_axi_wready(m_axi_wready),
        .m_axi_wstrb(m_axi_wstrb),
        .m_axi_wuser(NLW_inst_m_axi_wuser_UNCONNECTED[5:0]),
        .m_axi_wvalid({NLW_inst_m_axi_wvalid_UNCONNECTED[5],\^m_axi_wvalid }),
        .s_axi_araddr(s_axi_araddr),
        .s_axi_arburst({1'b0,1'b0}),
        .s_axi_arcache({1'b0,1'b0,1'b0,1'b0}),
        .s_axi_arid(1'b0),
        .s_axi_arlen({1'b0,1'b0,1'b0,1'b0,1'b0,1'b0,1'b0,1'b0}),
        .s_axi_arlock(1'b0),
        .s_axi_arprot(s_axi_arprot),
        .s_axi_arqos({1'b0,1'b0,1'b0,1'b0}),
        .s_axi_arready(s_axi_arready),
        .s_axi_arsize({1'b0,1'b0,1'b0}),
        .s_axi_aruser(1'b0),
        .s_axi_arvalid(s_axi_arvalid),
        .s_axi_awaddr(s_axi_awaddr),
        .s_axi_awburst({1'b0,1'b0}),
        .s_axi_awcache({1'b0,1'b0,1'b0,1'b0}),
        .s_axi_awid(1'b0),
        .s_axi_awlen({1'b0,1'b0,1'b0,1'b0,1'b0,1'b0,1'b0,1'b0}),
        .s_axi_awlock(1'b0),
        .s_axi_awprot(s_axi_awprot),
        .s_axi_awqos({1'b0,1'b0,1'b0,1'b0}),
        .s_axi_awready(s_axi_awready),
        .s_axi_awsize({1'b0,1'b0,1'b0}),
        .s_axi_awuser(1'b0),
        .s_axi_awvalid(s_axi_awvalid),
        .s_axi_bid(NLW_inst_s_axi_bid_UNCONNECTED[0]),
        .s_axi_bready(s_axi_bready),
        .s_axi_bresp(s_axi_bresp),
        .s_axi_buser(NLW_inst_s_axi_buser_UNCONNECTED[0]),
        .s_axi_bvalid(s_axi_bvalid),
        .s_axi_rdata(s_axi_rdata),
        .s_axi_rid(NLW_inst_s_axi_rid_UNCONNECTED[0]),
        .s_axi_rlast(NLW_inst_s_axi_rlast_UNCONNECTED[0]),
        .s_axi_rready(s_axi_rready),
        .s_axi_rresp(s_axi_rresp),
        .s_axi_ruser(NLW_inst_s_axi_ruser_UNCONNECTED[0]),
        .s_axi_rvalid(s_axi_rvalid),
        .s_axi_wdata(s_axi_wdata),
        .s_axi_wid(1'b0),
        .s_axi_wlast(1'b1),
        .s_axi_wready(s_axi_wready),
        .s_axi_wstrb(s_axi_wstrb),
        .s_axi_wuser(1'b0),
        .s_axi_wvalid(s_axi_wvalid));
endmodule

module decalper_eb_ot_sdeen_pot_pi_dehcac_xnilix_axi_crossbar_v2_1_29_addr_arbiter_sasd
   (p_0_in1_in,
    m_valid_i,
    SR,
    aa_grant_rnw,
    aresetn_d_reg,
    D,
    \m_ready_d_reg[2] ,
    s_axi_bvalid,
    m_axi_bready,
    s_axi_bready_0_sp_1,
    s_axi_wready,
    m_axi_wvalid,
    s_axi_wvalid_0_sp_1,
    m_axi_awvalid,
    \aresetn_d_reg[0] ,
    \aresetn_d_reg[1] ,
    E,
    \m_ready_d_reg[1] ,
    m_axi_arvalid,
    m_ready_d0,
    \gen_no_arbiter.grant_rnw_reg_0 ,
    s_axi_awready,
    s_axi_arready,
    aresetn_d_reg_0,
    \gen_no_arbiter.m_amesg_i_reg[48]_0 ,
    \gen_axilite.s_axi_awready_i_reg ,
    \m_atarget_hot_reg[6] ,
    aclk,
    aresetn_d,
    s_axi_awvalid,
    s_axi_arvalid,
    \gen_no_arbiter.m_valid_i_reg_0 ,
    m_ready_d0_0,
    m_ready_d,
    \m_ready_d_reg[2]_0 ,
    \m_ready_d_reg[2]_1 ,
    \m_ready_d_reg[2]_2 ,
    s_axi_bvalid_0_sp_1,
    Q,
    s_axi_bready,
    s_axi_wready_0_sp_1,
    s_axi_wvalid,
    m_valid_i_reg,
    aa_rready,
    m_ready_d_1,
    m_valid_i_reg_0,
    m_valid_i_reg_1,
    s_axi_rready,
    sr_rvalid,
    \m_ready_d_reg[1]_0 ,
    \m_ready_d_reg[1]_1 ,
    \m_ready_d_reg[1]_2 ,
    \gen_no_arbiter.m_grant_hot_i[0]_inv_i_2_0 ,
    s_axi_arprot,
    s_axi_awprot,
    s_axi_araddr,
    s_axi_awaddr,
    mi_wready,
    mi_bvalid);
  output p_0_in1_in;
  output m_valid_i;
  output [0:0]SR;
  output aa_grant_rnw;
  output aresetn_d_reg;
  output [5:0]D;
  output \m_ready_d_reg[2] ;
  output [0:0]s_axi_bvalid;
  output [4:0]m_axi_bready;
  output s_axi_bready_0_sp_1;
  output [0:0]s_axi_wready;
  output [4:0]m_axi_wvalid;
  output s_axi_wvalid_0_sp_1;
  output [4:0]m_axi_awvalid;
  output \aresetn_d_reg[0] ;
  output \aresetn_d_reg[1] ;
  output [0:0]E;
  output \m_ready_d_reg[1] ;
  output [4:0]m_axi_arvalid;
  output [0:0]m_ready_d0;
  output \gen_no_arbiter.grant_rnw_reg_0 ;
  output [0:0]s_axi_awready;
  output [0:0]s_axi_arready;
  output [2:0]aresetn_d_reg_0;
  output [34:0]\gen_no_arbiter.m_amesg_i_reg[48]_0 ;
  output \gen_axilite.s_axi_awready_i_reg ;
  output \m_atarget_hot_reg[6] ;
  input aclk;
  input aresetn_d;
  input [0:0]s_axi_awvalid;
  input [0:0]s_axi_arvalid;
  input \gen_no_arbiter.m_valid_i_reg_0 ;
  input [0:0]m_ready_d0_0;
  input [2:0]m_ready_d;
  input \m_ready_d_reg[2]_0 ;
  input \m_ready_d_reg[2]_1 ;
  input \m_ready_d_reg[2]_2 ;
  input s_axi_bvalid_0_sp_1;
  input [5:0]Q;
  input [0:0]s_axi_bready;
  input s_axi_wready_0_sp_1;
  input [0:0]s_axi_wvalid;
  input [1:0]m_valid_i_reg;
  input aa_rready;
  input [1:0]m_ready_d_1;
  input m_valid_i_reg_0;
  input m_valid_i_reg_1;
  input [0:0]s_axi_rready;
  input sr_rvalid;
  input \m_ready_d_reg[1]_0 ;
  input \m_ready_d_reg[1]_1 ;
  input \m_ready_d_reg[1]_2 ;
  input \gen_no_arbiter.m_grant_hot_i[0]_inv_i_2_0 ;
  input [2:0]s_axi_arprot;
  input [2:0]s_axi_awprot;
  input [31:0]s_axi_araddr;
  input [31:0]s_axi_awaddr;
  input [0:0]mi_wready;
  input [0:0]mi_bvalid;

  wire [5:0]D;
  wire [0:0]E;
  wire [5:0]Q;
  wire [0:0]SR;
  wire aa_grant_rnw;
  wire aa_rready;
  wire aclk;
  wire aresetn_d;
  wire aresetn_d_reg;
  wire \aresetn_d_reg[0] ;
  wire \aresetn_d_reg[1] ;
  wire [2:0]aresetn_d_reg_0;
  wire \gen_axilite.s_axi_awready_i_reg ;
  wire \gen_axilite.s_axi_bvalid_i_i_2_n_0 ;
  wire \gen_no_arbiter.grant_rnw_i_1_n_0 ;
  wire \gen_no_arbiter.grant_rnw_reg_0 ;
  wire [34:0]\gen_no_arbiter.m_amesg_i_reg[48]_0 ;
  wire \gen_no_arbiter.m_grant_hot_i[0]_inv_i_1_n_0 ;
  wire \gen_no_arbiter.m_grant_hot_i[0]_inv_i_2_0 ;
  wire \gen_no_arbiter.m_grant_hot_i[0]_inv_i_2_n_0 ;
  wire \gen_no_arbiter.m_valid_i_i_1_n_0 ;
  wire \gen_no_arbiter.m_valid_i_reg_0 ;
  wire \gen_no_arbiter.s_ready_i[0]_i_1_n_0 ;
  wire \m_atarget_hot[6]_i_2_n_0 ;
  wire \m_atarget_hot[6]_i_3_n_0 ;
  wire \m_atarget_hot[6]_i_4_n_0 ;
  wire \m_atarget_hot[6]_i_5_n_0 ;
  wire \m_atarget_hot[6]_i_6_n_0 ;
  wire \m_atarget_hot[6]_i_7_n_0 ;
  wire \m_atarget_hot_reg[6] ;
  wire [4:0]m_axi_arvalid;
  wire [4:0]m_axi_awvalid;
  wire [4:0]m_axi_bready;
  wire [4:0]m_axi_wvalid;
  wire [2:0]m_ready_d;
  wire [0:0]m_ready_d0;
  wire [0:0]m_ready_d0_0;
  wire \m_ready_d[0]_i_4_n_0 ;
  wire [1:0]m_ready_d_1;
  wire \m_ready_d_reg[1] ;
  wire \m_ready_d_reg[1]_0 ;
  wire \m_ready_d_reg[1]_1 ;
  wire \m_ready_d_reg[1]_2 ;
  wire \m_ready_d_reg[2] ;
  wire \m_ready_d_reg[2]_0 ;
  wire \m_ready_d_reg[2]_1 ;
  wire \m_ready_d_reg[2]_2 ;
  wire m_valid_i;
  wire m_valid_i_i_2_n_0;
  wire m_valid_i_i_3_n_0;
  wire [1:0]m_valid_i_reg;
  wire m_valid_i_reg_0;
  wire m_valid_i_reg_1;
  wire [0:0]mi_bvalid;
  wire [0:0]mi_wready;
  wire p_0_in1_in;
  wire [48:1]s_amesg;
  wire \s_arvalid_reg[0]_i_1_n_0 ;
  wire \s_arvalid_reg_reg_n_0_[0] ;
  wire s_awvalid_reg;
  wire \s_awvalid_reg[0]_i_1_n_0 ;
  wire [31:0]s_axi_araddr;
  wire [2:0]s_axi_arprot;
  wire [0:0]s_axi_arready;
  wire [0:0]s_axi_arvalid;
  wire [31:0]s_axi_awaddr;
  wire [2:0]s_axi_awprot;
  wire [0:0]s_axi_awready;
  wire [0:0]s_axi_awvalid;
  wire [0:0]s_axi_bready;
  wire s_axi_bready_0_sn_1;
  wire [0:0]s_axi_bvalid;
  wire s_axi_bvalid_0_sn_1;
  wire [0:0]s_axi_rready;
  wire [0:0]s_axi_wready;
  wire s_axi_wready_0_sn_1;
  wire [0:0]s_axi_wvalid;
  wire s_axi_wvalid_0_sn_1;
  wire s_ready_i;
  wire sr_rvalid;
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
