Louis-VL/PCB-ADVANCED/VIVADO/SpartanMicroBlaze/SpartanMicroBlaze.cache/ip/2023.1/4/3/4344ebac38ea80b1/MicroBlazeV2_xbar_0_sim_netlist.vhdl

-- Copyright 1986-2022 Xilinx, Inc. All Rights Reserved.
-- Copyright 2022-2023 Advanced Micro Devices, Inc. All Rights Reserved.
-- --------------------------------------------------------------------------------
-- Tool Version: Vivado v.2023.1 (win64) Build 3865809 Sun May  7 15:05:29 MDT 2023
-- Date        : Sat Dec 16 23:13:22 2023
-- Host        : LAPTOP-K67JHBA7 running 64-bit major release  (build 9200)
-- Command     : write_vhdl -force -mode funcsim -rename_top decalper_eb_ot_sdeen_pot_pi_dehcac_xnilix -prefix
--               decalper_eb_ot_sdeen_pot_pi_dehcac_xnilix_ MicroBlazeV2_xbar_0_sim_netlist.vhdl
-- Design      : MicroBlazeV2_xbar_0
-- Purpose     : This VHDL netlist is a functional simulation representation of the design and should not be modified or
--               synthesized. This netlist cannot be used for SDF annotated simulation.
-- Device      : xc7s6ftgb196-1
-- --------------------------------------------------------------------------------
library IEEE;
use IEEE.STD_LOGIC_1164.ALL;
library UNISIM;
use UNISIM.VCOMPONENTS.ALL;
entity decalper_eb_ot_sdeen_pot_pi_dehcac_xnilix_axi_crossbar_v2_1_29_addr_arbiter_sasd is
  port (
    p_0_in1_in : out STD_LOGIC;
    m_valid_i : out STD_LOGIC;
    SR : out STD_LOGIC_VECTOR ( 0 to 0 );
    aa_grant_rnw : out STD_LOGIC;
    aresetn_d_reg : out STD_LOGIC;
    D : out STD_LOGIC_VECTOR ( 5 downto 0 );
    \m_ready_d_reg[2]\ : out STD_LOGIC;
    s_axi_bvalid : out STD_LOGIC_VECTOR ( 0 to 0 );
    m_axi_bready : out STD_LOGIC_VECTOR ( 4 downto 0 );
    s_axi_bready_0_sp_1 : out STD_LOGIC;
    s_axi_wready : out STD_LOGIC_VECTOR ( 0 to 0 );
    m_axi_wvalid : out STD_LOGIC_VECTOR ( 4 downto 0 );
    s_axi_wvalid_0_sp_1 : out STD_LOGIC;
    m_axi_awvalid : out STD_LOGIC_VECTOR ( 4 downto 0 );
    \aresetn_d_reg[0]\ : out STD_LOGIC;
    \aresetn_d_reg[1]\ : out STD_LOGIC;
    E : out STD_LOGIC_VECTOR ( 0 to 0 );
    \m_ready_d_reg[1]\ : out STD_LOGIC;
    m_axi_arvalid : out STD_LOGIC_VECTOR ( 4 downto 0 );
    m_ready_d0 : out STD_LOGIC_VECTOR ( 0 to 0 );
    \gen_no_arbiter.grant_rnw_reg_0\ : out STD_LOGIC;
    s_axi_awready : out STD_LOGIC_VECTOR ( 0 to 0 );
    s_axi_arready : out STD_LOGIC_VECTOR ( 0 to 0 );
    aresetn_d_reg_0 : out STD_LOGIC_VECTOR ( 2 downto 0 );
    \gen_no_arbiter.m_amesg_i_reg[48]_0\ : out STD_LOGIC_VECTOR ( 34 downto 0 );
    \gen_axilite.s_axi_awready_i_reg\ : out STD_LOGIC;
    \m_atarget_hot_reg[6]\ : out STD_LOGIC;
    aclk : in STD_LOGIC;
    aresetn_d : in STD_LOGIC;
    s_axi_awvalid : in STD_LOGIC_VECTOR ( 0 to 0 );
    s_axi_arvalid : in STD_LOGIC_VECTOR ( 0 to 0 );
    \gen_no_arbiter.m_valid_i_reg_0\ : in STD_LOGIC;
    m_ready_d0_0 : in STD_LOGIC_VECTOR ( 0 to 0 );
    m_ready_d : in STD_LOGIC_VECTOR ( 2 downto 0 );
    \m_ready_d_reg[2]_0\ : in STD_LOGIC;
    \m_ready_d_reg[2]_1\ : in STD_LOGIC;
    \m_ready_d_reg[2]_2\ : in STD_LOGIC;
    s_axi_bvalid_0_sp_1 : in STD_LOGIC;
    Q : in STD_LOGIC_VECTOR ( 5 downto 0 );
    s_axi_bready : in STD_LOGIC_VECTOR ( 0 to 0 );
    s_axi_wready_0_sp_1 : in STD_LOGIC;
    s_axi_wvalid : in STD_LOGIC_VECTOR ( 0 to 0 );
    m_valid_i_reg : in STD_LOGIC_VECTOR ( 1 downto 0 );
    aa_rready : in STD_LOGIC;
    m_ready_d_1 : in STD_LOGIC_VECTOR ( 1 downto 0 );
    m_valid_i_reg_0 : in STD_LOGIC;
    m_valid_i_reg_1 : in STD_LOGIC;
    s_axi_rready : in STD_LOGIC_VECTOR ( 0 to 0 );
    sr_rvalid : in STD_LOGIC;
    \m_ready_d_reg[1]_0\ : in STD_LOGIC;
    \m_ready_d_reg[1]_1\ : in STD_LOGIC;
    \m_ready_d_reg[1]_2\ : in STD_LOGIC;
    \gen_no_arbiter.m_grant_hot_i[0]_inv_i_2_0\ : in STD_LOGIC;
    s_axi_arprot : in STD_LOGIC_VECTOR ( 2 downto 0 );
    s_axi_awprot : in STD_LOGIC_VECTOR ( 2 downto 0 );
    s_axi_araddr : in STD_LOGIC_VECTOR ( 31 downto 0 );
    s_axi_awaddr : in STD_LOGIC_VECTOR ( 31 downto 0 );
    mi_wready : in STD_LOGIC_VECTOR ( 0 to 0 );
    mi_bvalid : in STD_LOGIC_VECTOR ( 0 to 0 )
  );
end decalper_eb_ot_sdeen_pot_pi_dehcac_xnilix_axi_crossbar_v2_1_29_addr_arbiter_sasd;

architecture STRUCTURE of decalper_eb_ot_sdeen_pot_pi_dehcac_xnilix_axi_crossbar_v2_1_29_addr_arbiter_sasd is
  signal \^sr\ : STD_LOGIC_VECTOR ( 0 to 0 );
  signal \^aa_grant_rnw\ : STD_LOGIC;
  signal \gen_axilite.s_axi_bvalid_i_i_2_n_0\ : STD_LOGIC;
  signal \gen_no_arbiter.grant_rnw_i_1_n_0\ : STD_LOGIC;
  signal \^gen_no_arbiter.m_amesg_i_reg[48]_0\ : STD_LOGIC_VECTOR ( 34 downto 0 );
  signal \gen_no_arbiter.m_grant_hot_i[0]_inv_i_1_n_0\ : STD_LOGIC;
  signal \gen_no_arbiter.m_grant_hot_i[0]_inv_i_2_n_0\ : STD_LOGIC;
  signal \gen_no_arbiter.m_valid_i_i_1_n_0\ : STD_LOGIC;
  signal \gen_no_arbiter.s_ready_i[0]_i_1_n_0\ : STD_LOGIC;
  signal \m_atarget_hot[6]_i_2_n_0\ : STD_LOGIC;
  signal \m_atarget_hot[6]_i_3_n_0\ : STD_LOGIC;
  signal \m_atarget_hot[6]_i_4_n_0\ : STD_LOGIC;
  signal \m_atarget_hot[6]_i_5_n_0\ : STD_LOGIC;
  signal \m_atarget_hot[6]_i_6_n_0\ : STD_LOGIC;
  signal \m_atarget_hot[6]_i_7_n_0\ : STD_LOGIC;
  signal \m_ready_d[0]_i_4_n_0\ : STD_LOGIC;
  signal \^m_ready_d_reg[1]\ : STD_LOGIC;
  signal \^m_ready_d_reg[2]\ : STD_LOGIC;
  signal \^m_valid_i\ : STD_LOGIC;
  signal m_valid_i_i_2_n_0 : STD_LOGIC;
  signal m_valid_i_i_3_n_0 : STD_LOGIC;
  signal \^p_0_in1_in\ : STD_LOGIC;
  signal s_amesg : STD_LOGIC_VECTOR ( 48 downto 1 );
  signal \s_arvalid_reg[0]_i_1_n_0\ : STD_LOGIC;
  signal \s_arvalid_reg_reg_n_0_[0]\ : STD_LOGIC;
  signal s_awvalid_reg : STD_LOGIC;
  signal \s_awvalid_reg[0]_i_1_n_0\ : STD_LOGIC;
  signal s_axi_bready_0_sn_1 : STD_LOGIC;
  signal s_axi_bvalid_0_sn_1 : STD_LOGIC;
  signal s_axi_wready_0_sn_1 : STD_LOGIC;
  signal s_axi_wvalid_0_sn_1 : STD_LOGIC;
  signal s_ready_i : STD_LOGIC;
  attribute SOFT_HLUTNM : string;
  attribute SOFT_HLUTNM of \gen_axilite.s_axi_bvalid_i_i_2\ : label is "soft_lutpair15";
  attribute SOFT_HLUTNM of \gen_axilite.s_axi_rvalid_i_i_2\ : label is "soft_lutpair15";
  attribute inverted : string;
  attribute inverted of \gen_no_arbiter.m_grant_hot_i_reg[0]_inv\ : label is "yes";
  attribute SOFT_HLUTNM of \m_atarget_enc[0]_i_1\ : label is "soft_lutpair0";
  attribute SOFT_HLUTNM of \m_atarget_enc[1]_i_1\ : label is "soft_lutpair0";
  attribute SOFT_HLUTNM of \m_atarget_hot[0]_i_1\ : label is "soft_lutpair5";
  attribute SOFT_HLUTNM of \m_atarget_hot[1]_i_1\ : label is "soft_lutpair13";
  attribute SOFT_HLUTNM of \m_atarget_hot[2]_i_1\ : label is "soft_lutpair5";
  attribute SOFT_HLUTNM of \m_atarget_hot[3]_i_1\ : label is "soft_lutpair6";
  attribute SOFT_HLUTNM of \m_atarget_hot[4]_i_1\ : label is "soft_lutpair6";
  attribute SOFT_HLUTNM of \m_atarget_hot[6]_i_1\ : label is "soft_lutpair13";
  attribute SOFT_HLUTNM of \m_axi_arvalid[0]_INST_0\ : label is "soft_lutpair8";
  attribute SOFT_HLUTNM of \m_axi_arvalid[1]_INST_0\ : label is "soft_lutpair9";
  attribute SOFT_HLUTNM of \m_axi_arvalid[2]_INST_0\ : label is "soft_lutpair10";
  attribute SOFT_HLUTNM of \m_axi_arvalid[3]_INST_0\ : label is "soft_lutpair11";
  attribute SOFT_HLUTNM of \m_axi_arvalid[4]_INST_0\ : label is "soft_lutpair12";
  attribute SOFT_HLUTNM of \m_axi_awvalid[0]_INST_0\ : label is "soft_lutpair8";
  attribute SOFT_HLUTNM of \m_axi_awvalid[1]_INST_0\ : label is "soft_lutpair9";
  attribute SOFT_HLUTNM of \m_axi_awvalid[2]_INST_0\ : label is "soft_lutpair10";
  attribute SOFT_HLUTNM of \m_axi_awvalid[3]_INST_0\ : label is "soft_lutpair11";
  attribute SOFT_HLUTNM of \m_axi_awvalid[4]_INST_0\ : label is "soft_lutpair12";
  attribute SOFT_HLUTNM of \m_axi_bready[0]_INST_0\ : label is "soft_lutpair3";
  attribute SOFT_HLUTNM of \m_axi_wvalid[0]_INST_0\ : label is "soft_lutpair4";
  attribute SOFT_HLUTNM of \m_payload_i[34]_i_1\ : label is "soft_lutpair1";
  attribute SOFT_HLUTNM of \m_ready_d[0]_i_2\ : label is "soft_lutpair3";
  attribute SOFT_HLUTNM of \m_ready_d[0]_i_2__0\ : label is "soft_lutpair2";
  attribute SOFT_HLUTNM of \m_ready_d[0]_i_3\ : label is "soft_lutpair7";
  attribute SOFT_HLUTNM of \m_ready_d[1]_i_2\ : label is "soft_lutpair4";
  attribute SOFT_HLUTNM of m_valid_i_i_1 : label is "soft_lutpair14";
  attribute SOFT_HLUTNM of m_valid_i_i_2 : label is "soft_lutpair1";
  attribute SOFT_HLUTNM of \s_arvalid_reg[0]_i_1\ : label is "soft_lutpair7";
  attribute SOFT_HLUTNM of \s_axi_arready[0]_INST_0\ : label is "soft_lutpair16";
  attribute SOFT_HLUTNM of \s_axi_awready[0]_INST_0\ : label is "soft_lutpair16";
  attribute SOFT_HLUTNM of \s_axi_bvalid[0]_INST_0\ : label is "soft_lutpair2";
  attribute SOFT_HLUTNM of s_ready_i_i_1 : label is "soft_lutpair14";
begin
  SR(0) <= \^sr\(0);
  aa_grant_rnw <= \^aa_grant_rnw\;
  \gen_no_arbiter.m_amesg_i_reg[48]_0\(34 downto 0) <= \^gen_no_arbiter.m_amesg_i_reg[48]_0\(34 downto 0);
  \m_ready_d_reg[1]\ <= \^m_ready_d_reg[1]\;
  \m_ready_d_reg[2]\ <= \^m_ready_d_reg[2]\;
  m_valid_i <= \^m_valid_i\;
  p_0_in1_in <= \^p_0_in1_in\;
  s_axi_bready_0_sp_1 <= s_axi_bready_0_sn_1;
  s_axi_bvalid_0_sn_1 <= s_axi_bvalid_0_sp_1;
  s_axi_wready_0_sn_1 <= s_axi_wready_0_sp_1;
  s_axi_wvalid_0_sp_1 <= s_axi_wvalid_0_sn_1;
\gen_axilite.s_axi_awready_i_i_1\: unisim.vcomponents.LUT5
    generic map(
      INIT => X"FBFF0400"
    )
        port map (
      I0 => \gen_axilite.s_axi_bvalid_i_i_2_n_0\,
      I1 => Q(5),
      I2 => mi_bvalid(0),
      I3 => s_axi_wvalid_0_sn_1,
      I4 => mi_wready(0),
      O => \m_atarget_hot_reg[6]\
    );
\gen_axilite.s_axi_bvalid_i_i_1\: unisim.vcomponents.LUT6
    generic map(
      INIT => X"5500FF0055C0FF00"
    )
        port map (
      I0 => s_axi_bready_0_sn_1,
      I1 => mi_wready(0),
      I2 => s_axi_wvalid_0_sn_1,
      I3 => mi_bvalid(0),
      I4 => Q(5),
      I5 => \gen_axilite.s_axi_bvalid_i_i_2_n_0\,
      O => \gen_axilite.s_axi_awready_i_reg\
    );
\gen_axilite.s_axi_bvalid_i_i_2\: unisim.vcomponents.LUT3
    generic map(
      INIT => X"FB"
    )
        port map (
      I0 => m_ready_d(2),
      I1 => \^m_valid_i\,
      I2 => \^aa_grant_rnw\,
      O => \gen_axilite.s_axi_bvalid_i_i_2_n_0\
    );
\gen_axilite.s_axi_rvalid_i_i_2\: unisim.vcomponents.LUT3
    generic map(
      INIT => X"40"
    )
        port map (
      I0 => m_ready_d_1(1),
      I1 => \^m_valid_i\,
      I2 => \^aa_grant_rnw\,
      O => \^m_ready_d_reg[1]\
    );
\gen_no_arbiter.grant_rnw_i_1\: unisim.vcomponents.LUT6
    generic map(
      INIT => X"FFFF53FF00005000"
    )
        port map (
      I0 => s_awvalid_reg,
      I1 => s_axi_awvalid(0),
      I2 => s_axi_arvalid(0),
      I3 => \^p_0_in1_in\,
      I4 => \^m_valid_i\,
      I5 => \^aa_grant_rnw\,
      O => \gen_no_arbiter.grant_rnw_i_1_n_0\
    );
\gen_no_arbiter.grant_rnw_reg\: unisim.vcomponents.FDRE
     port map (
      C => aclk,
      CE => '1',
      D => \gen_no_arbiter.grant_rnw_i_1_n_0\,
      Q => \^aa_grant_rnw\,
      R => \^sr\(0)
    );
\gen_no_arbiter.m_amesg_i[10]_i_1\: unisim.vcomponents.LUT4
    generic map(
      INIT => X"FB08"
    )
        port map (
      I0 => s_axi_araddr(9),
      I1 => s_axi_arvalid(0),
      I2 => s_awvalid_reg,
      I3 => s_axi_awaddr(9),
      O => s_amesg(10)
    );
\gen_no_arbiter.m_amesg_i[11]_i_1\: unisim.vcomponents.LUT4
    generic map(
      INIT => X"FB08"
    )
        port map (
      I0 => s_axi_araddr(10),
      I1 => s_axi_arvalid(0),
      I2 => s_awvalid_reg,
      I3 => s_axi_awaddr(10),
      O => s_amesg(11)
    );
\gen_no_arbiter.m_amesg_i[12]_i_1\: unisim.vcomponents.LUT4
    generic map(
      INIT => X"FB08"
    )
        port map (
      I0 => s_axi_araddr(11),
      I1 => s_axi_arvalid(0),
      I2 => s_awvalid_reg,
      I3 => s_axi_awaddr(11),
      O => s_amesg(12)
    );
\gen_no_arbiter.m_amesg_i[13]_i_1\: unisim.vcomponents.LUT4
    generic map(
      INIT => X"FB08"
    )
        port map (
      I0 => s_axi_araddr(12),
      I1 => s_axi_arvalid(0),
      I2 => s_awvalid_reg,
      I3 => s_axi_awaddr(12),
      O => s_amesg(13)
    );
\gen_no_arbiter.m_amesg_i[14]_i_1\: unisim.vcomponents.LUT4
    generic map(
      INIT => X"FB08"
    )
        port map (
      I0 => s_axi_araddr(13),
      I1 => s_axi_arvalid(0),
      I2 => s_awvalid_reg,
      I3 => s_axi_awaddr(13),
      O => s_amesg(14)
    );
\gen_no_arbiter.m_amesg_i[15]_i_1\: unisim.vcomponents.LUT4
    generic map(
      INIT => X"FB08"
    )
        port map (
      I0 => s_axi_araddr(14),
      I1 => s_axi_arvalid(0),
      I2 => s_awvalid_reg,
      I3 => s_axi_awaddr(14),
      O => s_amesg(15)
    );
\gen_no_arbiter.m_amesg_i[16]_i_1\: unisim.vcomponents.LUT4
    generic map(
      INIT => X"FB08"
    )
        port map (
      I0 => s_axi_araddr(15),
      I1 => s_axi_arvalid(0),
      I2 => s_awvalid_reg,
      I3 => s_axi_awaddr(15),
      O => s_amesg(16)
    );
\gen_no_arbiter.m_amesg_i[17]_i_1\: unisim.vcomponents.LUT4
    generic map(
      INIT => X"FB08"
    )
        port map (
      I0 => s_axi_araddr(16),
      I1 => s_axi_arvalid(0),
      I2 => s_awvalid_reg,
      I3 => s_axi_awaddr(16),
      O => s_amesg(17)
    );
\gen_no_arbiter.m_amesg_i[18]_i_1\: unisim.vcomponents.LUT4
    generic map(
      INIT => X"FB08"
    )
        port map (
      I0 => s_axi_araddr(17),
      I1 => s_axi_arvalid(0),
      I2 => s_awvalid_reg,
      I3 => s_axi_awaddr(17),
      O => s_amesg(18)
    );
\gen_no_arbiter.m_amesg_i[19]_i_1\: unisim.vcomponents.LUT4
    generic map(
      INIT => X"FB08"
    )
        port map (
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
      C => aclk,
      CE => \^p_0_in1_in\,
      D => s_amesg(46),
      Q => \^gen_no_arbiter.m_amesg_i_reg[48]_0\(32),
      R => \^sr\(0)
    );
\gen_no_arbiter.m_amesg_i_reg[47]\: unisim.vcomponents.FDRE
     port map (
      C => aclk,
      CE => \^p_0_in1_in\,
      D => s_amesg(47),
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
