Louis-VL/PCB-ADVANCED/(commit log)

2023-10-07 FPGA configuration
    schematic for fpga configuration almost finished
    [Active.PcbLib, FPGA_BANKS.SchDoc, FPGA_CONFIG.SchDoc, FPGA_POWER.SchDoc, PCB1.PcbDoc, POWER_SUPPLY.SchDoc, Schematic_Symbols.SchLib, Schlib1.SchLib]
2023-10-07 PCB updates
    [FPGA_BANKS.SchDoc, FPGA_CONFIG.SchDoc, PCB1.PcbDoc, PCB_ADVANCED.PrjPcb, POWER_SUPPLY.SchDoc, SDRAM.SchDoc, Schematic_Symbols.SchLib, Spartan.SchDoc]
2023-10-08 FTDI & SDRAM
    [FPGA_CONFIG.SchDoc, FPGA_POWER.SchDoc, SDRAM.SchDoc, USB.SchDoc]
2023-10-11 USB & PSU
    [Active.PcbLib, GPIO_Connectors.SchDoc, PCB_ADVANCED.PrjPcb, POWER_SUPPLY.SchDoc, Schematic_Symbols.SchLib, Spartan.SchDoc, USB.SchDoc, User Library-ECS-3951.STEP]
2023-10-17 17/10/23
    laatste update voor de les
    [FPGA_BANKS.SchDoc, FPGA_CONFIG.SchDoc, FPGA_POWER.SchDoc, GPIO.SchDoc, POWER_SUPPLY.SchDoc, SDRAM.SchDoc, Spartan.SchDoc, USB.SchDoc]
2023-10-24 24/10/23
    Laatste update voor nakijken
    [Active.PcbLib, GPIO.SchDoc, Passive.PcbLib, Schematic_Symbols.SchLib]
2023-10-29 29/10/23
    Finished all routing
    [FPGA_BANKS.SchDoc, GPIO.SchDoc, PCB_ADVANCED.PrjPcb]
2023-10-31 31/10/23
    nakijk mailtje verstuurt
    [POWER_SUPPLY.SchDoc]
2023-11-08 11/8/23
    comments aanpassen caps, res
    [FPGA_BANKS.SchDoc, FPGA_CONFIG.SchDoc, FPGA_POWER.SchDoc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]
2023-11-09 9/11/23
    zou klaar moeten zijn voor te bestellen
    [FPGA_BANKS.SchDoc, FPGA_CONFIG.SchDoc, GPIO.SchDoc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]
2023-11-14 14/11/23
    fabrication
    [PCB1.GBL, PCB1.GBO, PCB1.GBP, PCB1.GBS, PCB1.GKO, PCB1.GM1, PCB1.GTL, PCB1.GTO]
2023-11-14 3D case
    first Rev of 3DCASE
    [PCB1_CASE.f3d]
2023-12-03 3/12/23
    Software: Vivado
    [POWER_SUPPLY.SchDoc]
2023-12-16 16/12/23
    Vitis Read switch write leds
2023-12-28 28/12/23
    PCBPANEL ADDED
    [PCB_ADVANCED.PrjPcb, PCB_PANEL.PcbDoc]
2023-12-29 29/12/23
    presentatie
    [GPIO.SchDoc, PCB_ADVANCED.PrjPcb]
